kiujkiu/macha/models/zynq_board/20260708-174606.jpg

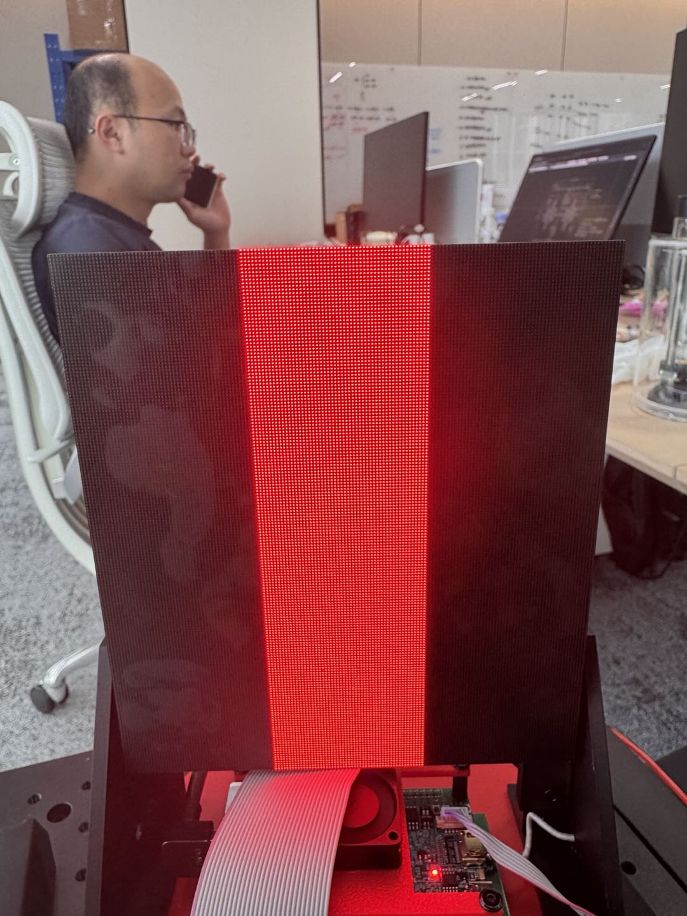
models/zynq_board/20260708-174606.jpg
