kiujkiu/macha/models/xt60_clamp_16p6x9p2x23p9/xt60_clamp_16p6x9p2x23p9_drawing.pdf

XT60 电源接头压块 xt60_clamp_16p6x9p2x23p9 (v4.10 压块 11 + 底板垫片 = 38×26.9×13 长方体, 止口四边, 中央出线 Φ2.5)

锁 XT60H-M (插合本体 15.6×8.2×11.9 在开口端 + 出线护套 16.6×9.2×12 在堵头端) 到 M6 网格板 · 外形 38×26.9×11 · 阶梯槽 15.6×8.7 / 16.6×9.2 · 件2 底板垫片 38×26.9×2 + 凸台 0.5 + 止口四边高 2 (总高 4)

主视图 Front (2.5:1) | 沿 +Y 看 (从开口端) | 尺寸单位: mm

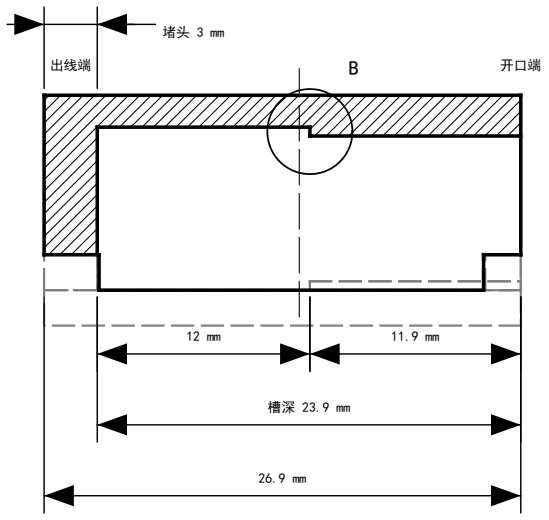
[picture p2: figure]
出线端; 开口端

11 mm

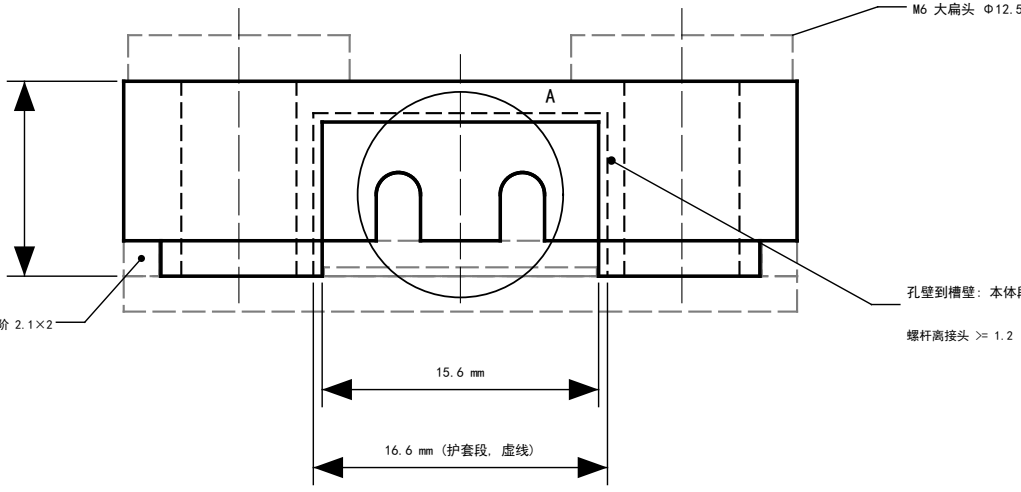
[picture p3: figure]
16.6 mm (护套段, 虚线); 螺杆离接头 >= 1.2

### M6 大扁头 Φ12.5×2.6 坐顶面 (灰线)

止口: 件 2 边框 2×2 (灰), 压块台阶 2.1×2

### 孔壁到槽壁: 本体段 1.45 / 护套段 0.95 (两侧)

# 左视图 (全剖) Section (2.5:1) 沿对称面 X=0 剖, 沿 +X 看

灰线: 件 2 底板垫片 (厚 2, 凸台 0.5, 止口高 2) + 插合本体 (开口侧) + 出线护套 (堵头侧)

槽顶 = 接头顶面 (过盈 0): 护套段 9.2 / 本体段 8.7 = 凸台 0.5 + 8.2, 均从底板顶面算 (见详图 B)

# 俯视图 Top (2.5:1) 沿 -Z 看

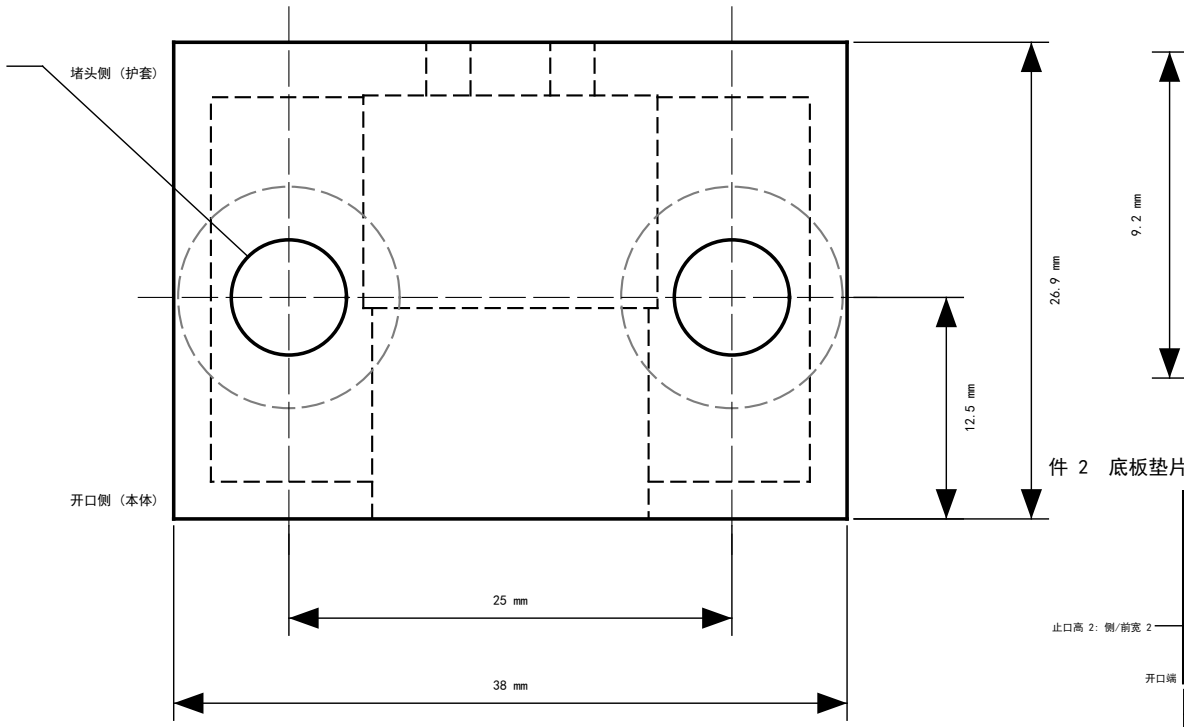
[picture p4: figure]
堵头侧 (护套); 开口侧 (本体); 止口高 2: 侧/前宽 2; 开口端

### 2×Φ6.5 通孔 (配 M6)

# 详图 A (5:1) 堵头 U 型出线口 (沿 +Y 看) 7 mm

5.85 mm

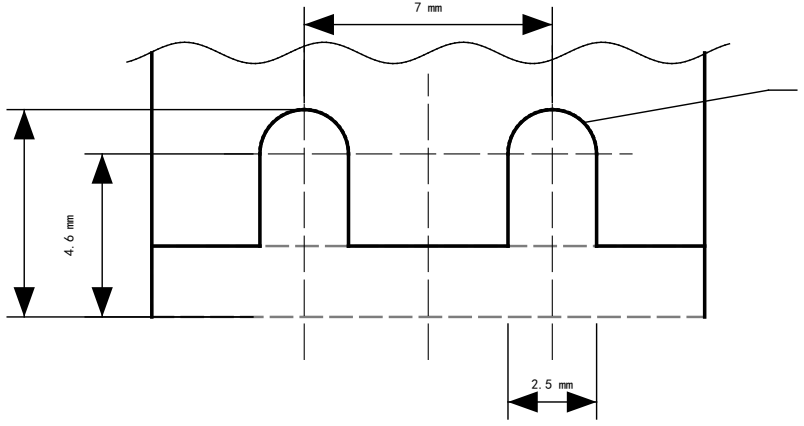
[picture p5: figure]

R1.25 (Φ2.5)

U 口 = 半圆顶 + 直边, 平底 = 件 2 后边框顶 z 2 (灰, 宽 3 高 2); 线底 3.35 高于边框, 不削

线 Φ2.5 零余量, 从护套尾孔沿针轴直出 (圆心 4.6 = 护套高/2)

# 详图 B (5:1) 槽台阶 Z 向堆叠

护套段

8.7 mm

槽顶=接头顶

过盈 0

本体段

凸台 0.5 (件 2)

# 件 2 底板垫片 (1:1) 底板 2 + 凸台 0.5 + 止口四边高 2

上方后边框 宽 3 高 2 (出线边)

38 mm

26.9 mm

凸台 15.4×11.9

2×Φ6.5 同压块孔

# 说明 / Notes

1) 尺寸: 宽 16.6 / 15.6 用户指定 (图纸 16.40), 高/长按 AMASS XT60H-M 图纸 + 卡尺。插合本体 15.6×8.2 长 11.9 在开口端; 出线护套 16.6×9.2 长 12 在堵头端 (本体上下各缩 0.5)。v4 纠正了 v3 前后装反。
2) 阶梯槽紧配不留余量 (用户要求): 本体段 15.6×8.7 / 护套段 16.6×9.2, 宽高都 = 接头 (间隙 0, 过盈 0), 槽台阶与接头台阶对齐。
3) 限位: 插入方向护套上部顶堵头、下部顶件 2 后边框; 拔出方向护套前端面顶窄槽台阶 (零窜动)。件 2 底板垫片 38×26.9×2 + 本体下凸台 0.5 + 止口四边高 2 (左右/开口端宽 2 开口端槽口断开, 后边宽 3; 压块台阶宽多 0.1); 两件嵌套面留 0.1; M6 定位。
4) 装配: 底板垫片放板上 -> 接头 (本体坐凸台, 护套坐底板顶住后边框) -> 压块扣下 (套进止口, 线落进 U 口) -> M6 穿压块+底板。叠层 13: M6×20 旋入 7 距板底 6; M6×25 旋入 12 距板底 1。
5) 孔壁到槽壁: 护套段 0.95 / 本体段 1.45 (两侧), 打印可能破口, 不影响夹紧; 螺杆离接头 >= 1.2。孔心距开口面 12.5。堵头 3 + 2 个 U 口 Φ2.5 @ 7, 圆心高 4.6。
6) 槽顶厚 护套段 1.8 / 本体段 2.3 (件高 11 用户指定)。打印: 压块顶面贴床零支撑; 实心 6.50 cm^3, PLA 约 8.1 g。底板垫片底面贴床零支撑。
7) 组合外形: 压块 + 底板垫片 = 38×26.9×13 长方体, 外表面只有 2×M6 孔、开口端接头口、堵头 2 个出线口 (压块 U 口, 平底 = 后边框顶 z 2); 止口、凸台都在内部, 边框顶贴台阶顶不留缝。
8) 层高 (零间隙对层高敏感): 两件都用 0.1 (全部整层) 或 0.25 (首层也 0.25, 本体段/护套段各松 0.05); 不要用 0.2 —— 本体段槽顶和凸台顶落在层中间, 本体段会过盈 0.2 扣不到底。
结构件 — XT60 电源接头压块 (XT60 Clamp v4.10, 组合 38×26.9×13 长方体, 零间隙, 中央出线, 止口四边) + 件 2 底板垫片 | 投影 1st-angle / 比例 2.5:1 (主, 左剖, 俯), 5:1 (详图 A, B), 1:1 (件 2)
38×26.9×11 / 阶梯槽 15.6×8.7 (开口) + 16.6×9.2 (堵头) / 堵头 3 + 2×U 口 / 2×Φ6.5 @ 25 / 底板垫片 38×26.9×2+凸台 0.5+止口四边 高 2 (后边宽 3) / M6×20 / PLA/PETG / mm | 2026-09-16 / pov3d / models / xt60_clamp_16p6x9p2x23p9 / *.stl (压块 + xt60_shim_38x26p9x2p5)
