kiujkiu/macha/models/photo_sensor/photo_sensor_bracket_drawing.pdf

# POV 3D photo_sensor — sensor_bracket (圆盘上平板, 外伸挂光电开关, PLA)

贴圆盘上表面, 锁(-92.5,±20)圆盘孔(2×M3通孔, 从上往下, 无沉孔) / 外伸段下面挂模块: 2×Φ3.2 直通 (顶沉取消 2026-07-14) + 3让位槽贯通 / 厚6 (5→6)

## 俯视 (3:1) (沿 -Z 看顶面) 尺寸单位: mm

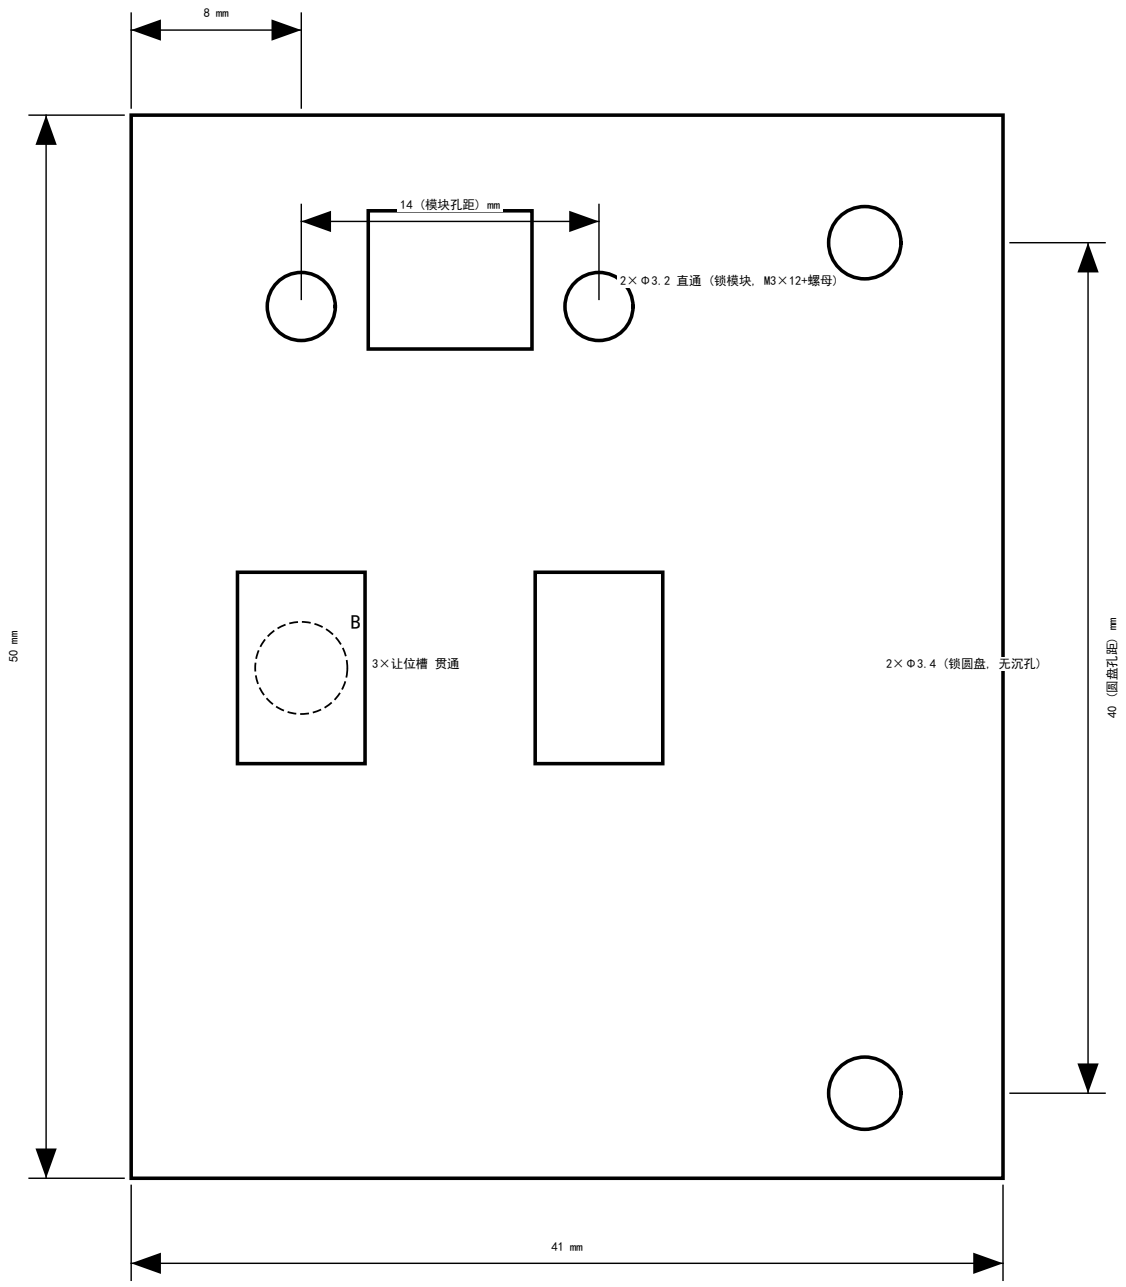
[picture p8: figure]
14 (模块孔距) mm; 40 (圆盘孔距) mm; 2×Φ3.2 直通 (锁模块, M3×12+螺母)

3×让位槽 贯通 | 2×Φ3.4 (锁圆盘, 无沉孔) | 侧视 (3:1) (沿 -Y 看, 厚6)

6 mm

全部孔为普通直通 (无沉孔); 3 让位槽贯通

## 详图 B (6:1) 让位槽 (贯通)

槽宽 mm

6 (贯通) mm

(贯通, 让焊脚)

POV 3D — photo_sensor / sensor_bracket (×1, 转子) | 投影 1st-angle / PLA / 单位 mm
平板 41×50×6 (5→6, 2026-07-14) 贴圆盘顶 / 2×Φ3.4锁圆盘 + 2×Φ3.2锁模块 (全部直通无沉孔) + 3让位槽贯通(详图B) / 外伸悬挑 | 2026-06-15 / POV3D / models / photo_sensor
