kiujkiu/macha/models/photo_sensor/photo_sensor_vane_v2_drawing.pdf

# POV 3D v2 — index_vane_v2 静止挡光片 (θ=180/-X, 洞洞板 中心锚定 25mm 网格)

脚 5厚 X-108..-92×Y±32, 2×Φ6.5 M6 @ 网格(-100,±25) 切向对 / 挡片 径向4 (X-100..-96=R98居中): 槽下宽10 到Z28, 槽内宽8 到Z39 / 梁(-98,0,37.7) / R_SLOT 112→98 (2026-07-07 缩半径) / 基准=旋转轴+洞洞板面 / 全平面孔无详图 (GB 1st-angle, 3:1, mm)

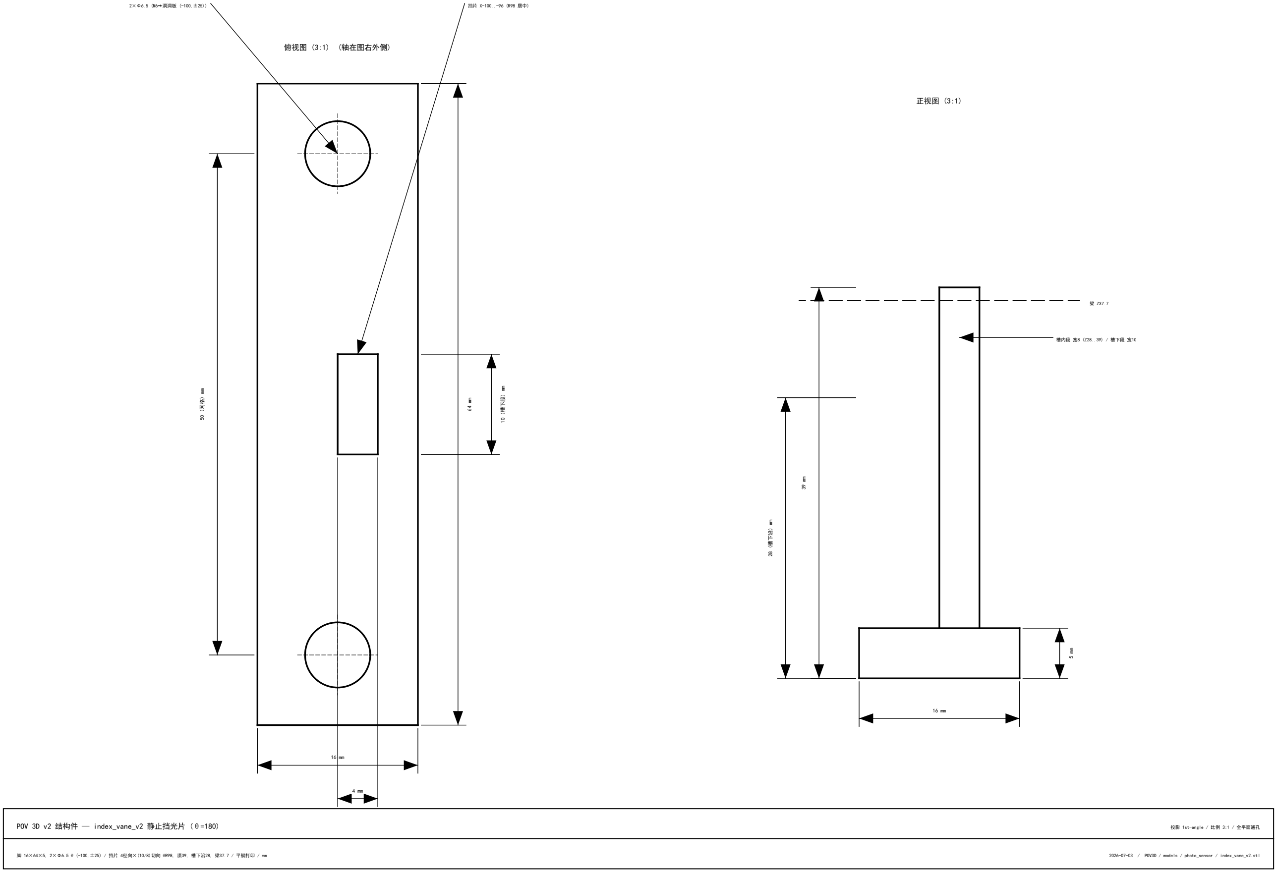
[picture p9: figure]
俯视图 (3:1) (轴在图右外侧); 10 (槽下段) mm; 2×Φ6.5 (M6→洞洞板 (-100,±25)); 正视图 (3:1); 28 (槽下沿) mm; 槽内段 宽8 (Z28..39) / 槽下段 宽10

POV 3D v2 结构件 — index_vane_v2 静止挡光片 (θ=180) | 投影 1st-angle / 比例 3:1 / 全平面通孔
脚 16×64×5, 2×Φ6.5 @ (-100,±25) / 挡片 4径向×(10/8)切向 @R98, 顶39, 槽下沿28, 梁37.7 / 平躺打印 / mm | 2026-07-03 / POV3D / models / photo_sensor / index_vane_v2.stl
