kiujkiu/macha/models/mlkpai_h_bracket/mlkpai_h_bracket_drawing.pdf

# POV 3D — 米联派 MLKPAI-FS03 ZYNQ 板 H 形支架 (左右开槽, t=3)

对位板 85×56: 4×M3 角孔(矩形 79×50) / 中心 Φ24+24方阵 4×M3 居中(0,0) / 两侧凹槽 25×44 缺口开左右 / 板厚 3 (GB 1st-angle, 2:1, mm)

## 俯视图 Top (2:1) (沿 -Z 看)

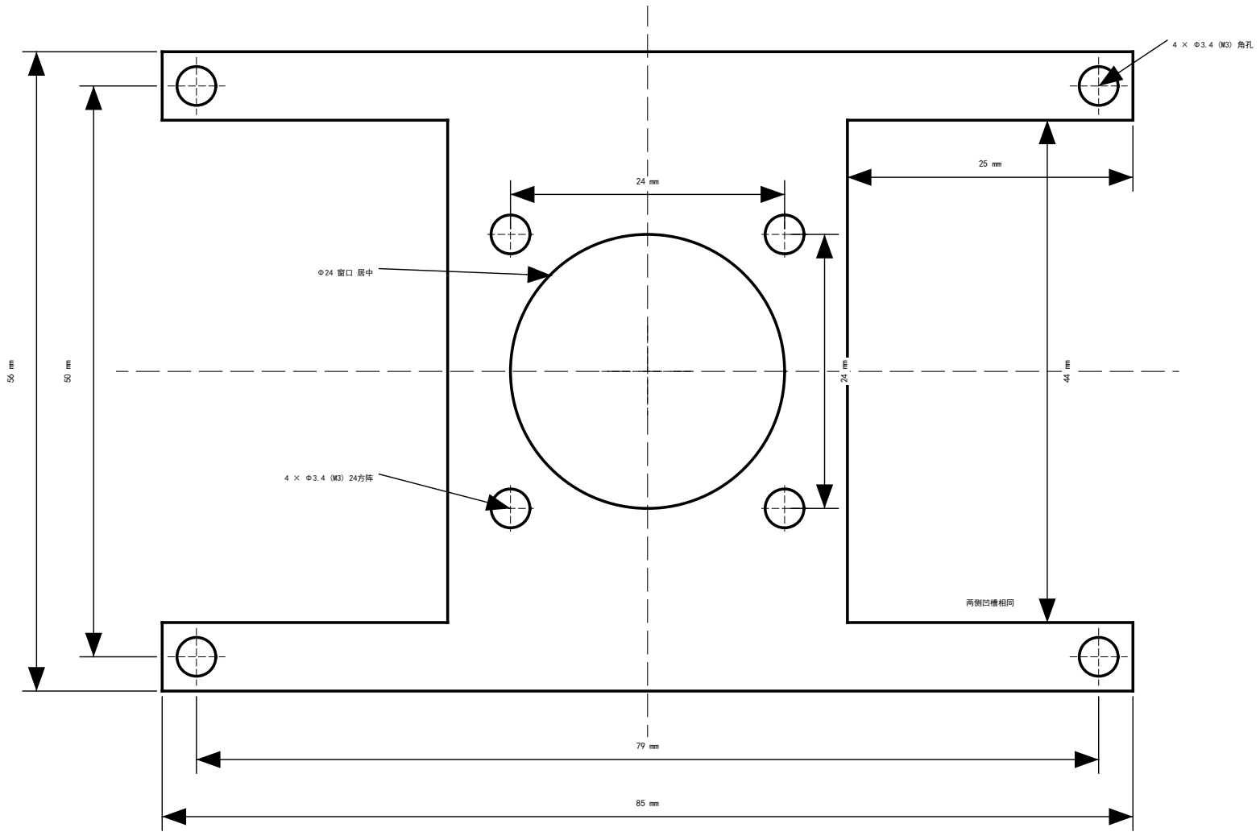
[picture p10: figure]
两侧凹槽相同

缺口开左右 / 上下横梁各 6mm,角孔壁较薄(~1.3mm) / 中心 5 孔居中(芯片实际+3.7)

## 右视图 Side (2:1) (板厚)

3 mm

56 mm

板厚 3 (虚线=各通孔)

POV 3D 结构件 — MLKPAI-FS03 ZYNQ H 形支架 (左右开槽, t3) | 投影 1st-angle / 比例 2:1 (俯, 右)
外形 85×56×3 / 4×M3 角孔(79×50 估算) / Φ24+24方阵 4×M3 居中 / mm | 2026-06-23 / POV3D / models / mlkpai_h_bracket
