kiujkiu/macha/models/saddle_clamp_sq6/saddle_clamp_sq6_drawing.pdf

# POV 3D 马鞍压条 / 抱箍 Saddle Clamp (方形过桥, 夹持 6×6)

内腔 6×6 方 / 料厚 3 / 压条宽 14 / 外形 37×14×9 / 2×Φ6.5 M6 通孔 (孔距 25) / 物体贴板,顶部方形压住,两脚 M6 固定 (GB 1st-angle, 4:1, mm)

主视图 Front (4:1) | (沿 +Y 看, 物体轴线方向)
左视图 Side (4:1) | (沿 +X 看)

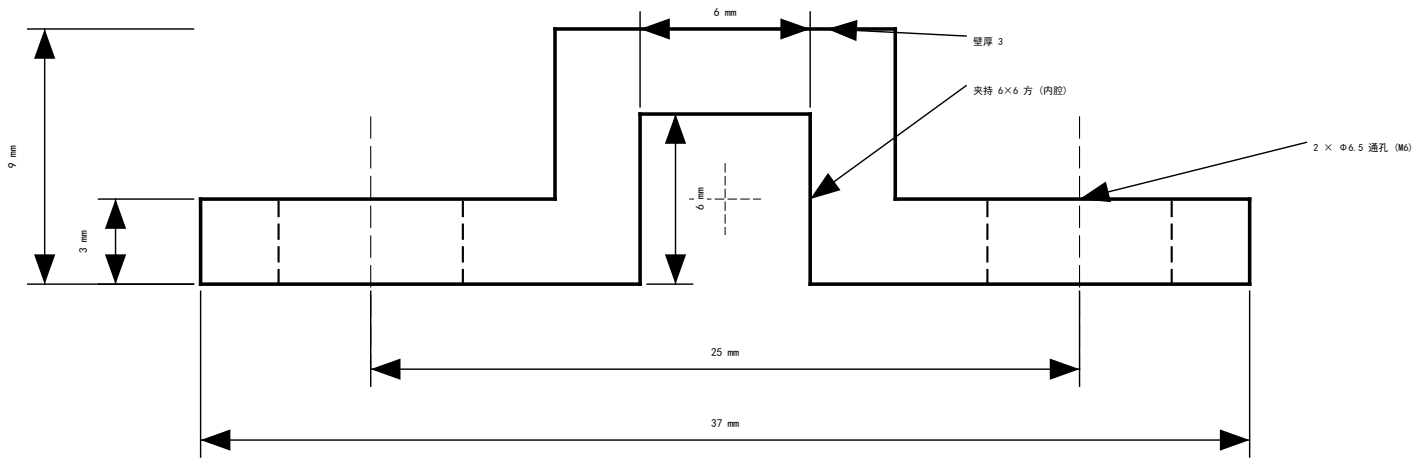
[picture p11: figure]

14 | mm

9 mm

6 mm

物体 6×6 沿 Y 穿过 (虚线)

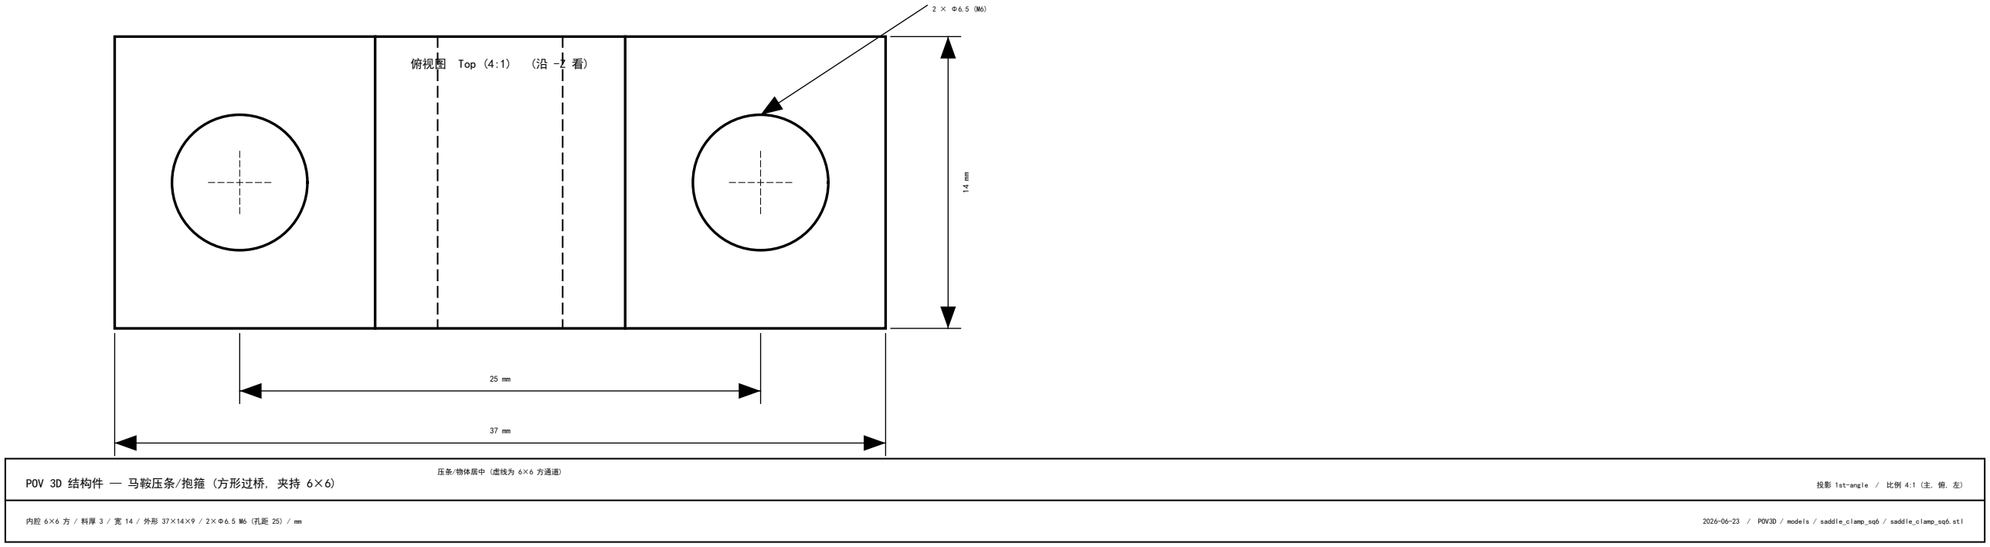
[picture p12: figure]
俯视图 Top (4:1); 压条/物体居中 (虚线为 6×6 方通道)

POV 3D 结构件 — 马鞍压条/抱箍 (方形过桥, 夹持 6×6) | 投影 1st-angle / 比例 4:1 (主, 俯, 左)
内腔 6×6 方 / 料厚 3 / 宽 14 / 外形 37×14×9 / 2×Φ6.5 M6 (孔距 25) / mm | 2026-06-23 / POV3D / models / saddle_clamp_sq6 / saddle_clamp_sq6.stl
