kiujkiu/macha/models/box_22x24x64/box_22x24x64_drawing.pdf

# POV 3D 盒子 Box 22×24×64 (单侧开口 +X, 前面板开窗)

外形 22×24×64 / +X 侧(64×24) 敞开 / 前(-Y)1·后(+Y)2·侧(-X)2·顶底2 / 前面板中央开穿窗口 14(宽X)×35(高Z) / 前后各 2×Φ4.5 M4 (中心距 44) (GB 1st-angle, 2:1, mm)

## 主视图 Front (2:1) (沿 +Y 看 -Y 1mm 前面板)

## 左视图 — 全剖 A—A (2:1) (沿 +X 看, 即开口方向)

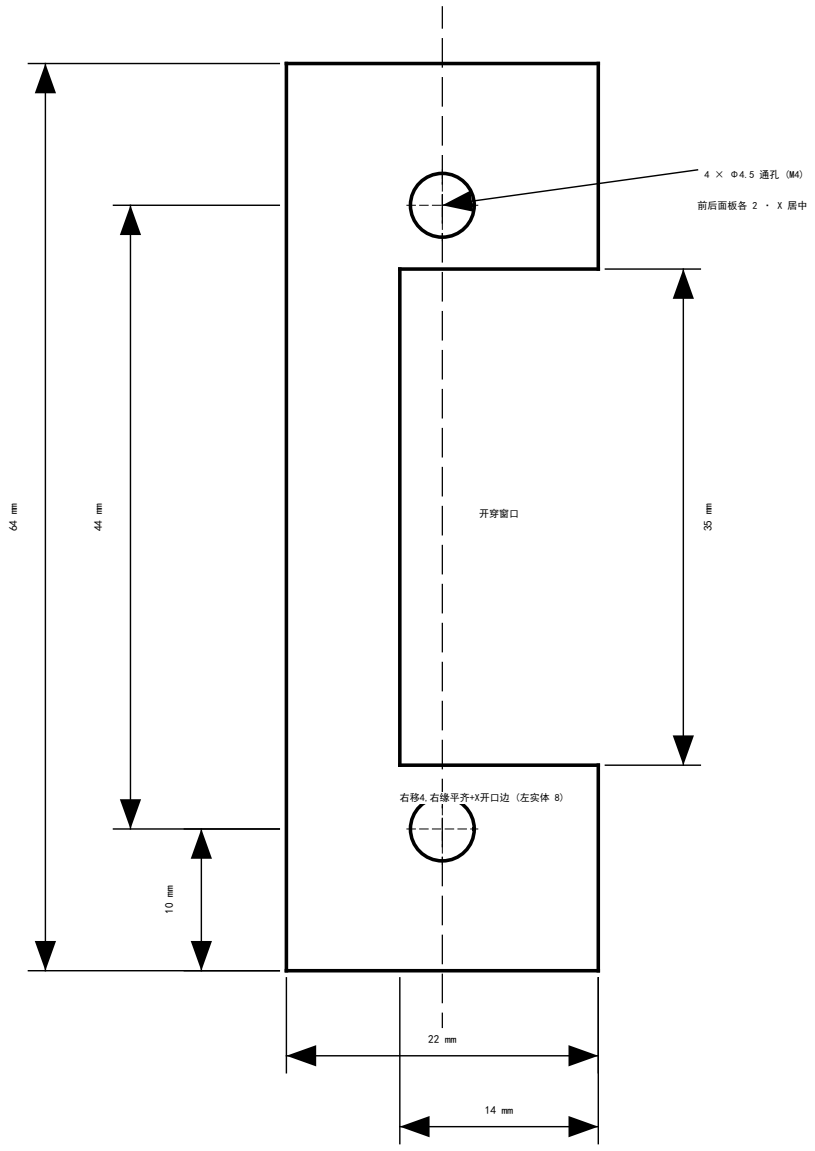
[picture p13: figure]
前后面板各 2 · X 居中; 开穿窗口; 右移4,右缘平齐+X开口边 (左实体 8)
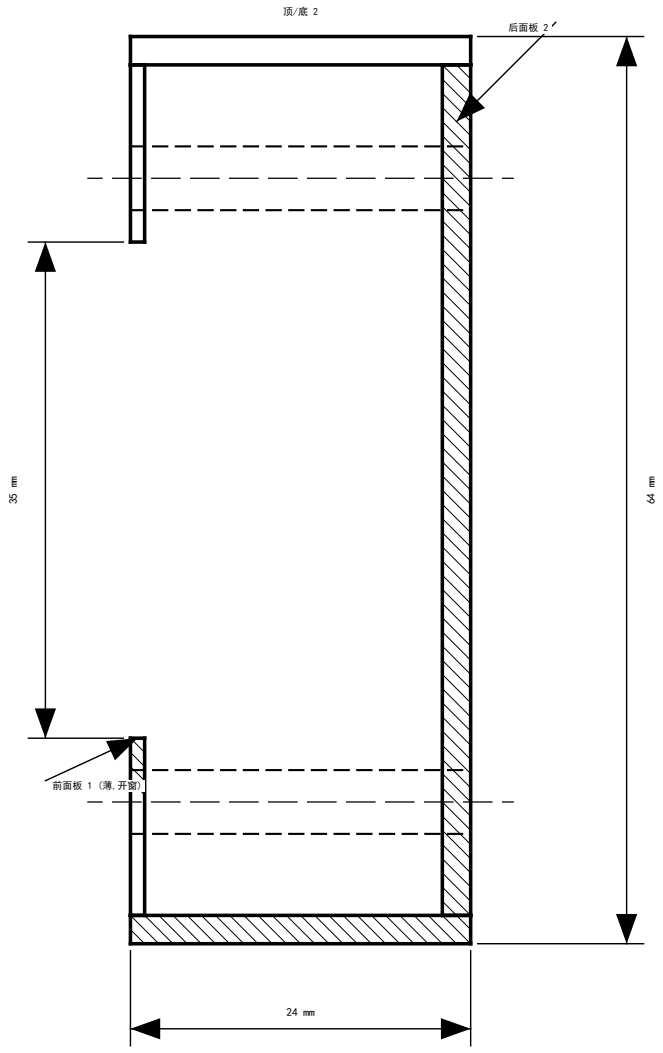
[picture p14: figure]
前面板 1 (薄,开窗); 后面板 2

窗口 35 高 · 2×M4 @ Z=10/54 (孔在窗上下)

## 横剖 B—B (2:1) (沿 -Z 看 @ Z=32)

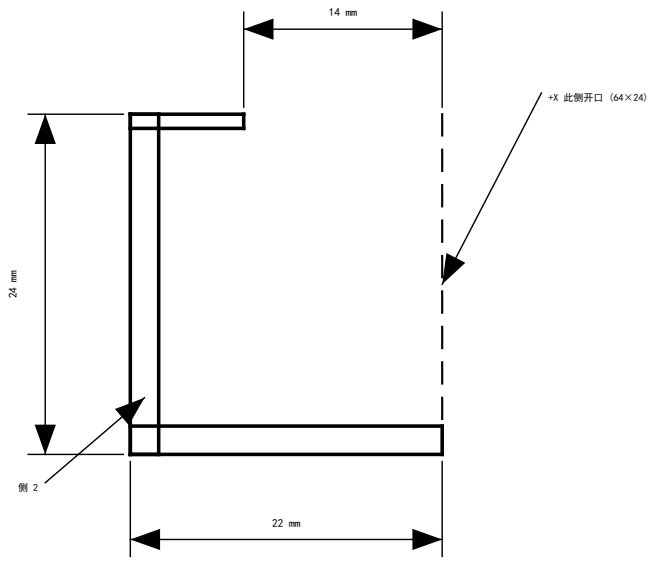
[picture p15: figure]
+X 此侧开口 (64×24)

前(上)1·后(下)2·侧2 / 窗宽 14

POV 3D 结构件 — 单侧开口盒 (Box 22×24×64, 开窗前板) | 投影 1st-angle / 比例 2:1 (主, 左-全剖, 横剖)
外形 22×24×64 / +X侧开 / 前1·后2·侧2·顶底2 / 窗 14×35 / 4×Φ4.5 M4 (中心距44) / mm | 2026-06-22 / POV3D / models / box_22x24x64 / box_22x24x64.stl
