kiujkiu/macha/models/l_bracket_170x60/l_bracket_170x60_drawing.pdf

# POV 3D L 形托架 L-Bracket (200×70, W90, T4)

长边 200 / 短边 70 / 宽 90 / 板厚 4 / 6 × Φ3.2 M3 (下排 X+1 Y+1) / 4 × Φ3.2 M3 立板 (对 rim 内圈R35+外圈R77.5 @ 157.5°/202.5°,距圆心14.3) / 2 × 13×30 开口 (距左边10,中距45) / 3 × 三角加强筋 (两边+中间,各厚5) (GB 第一角投影)

## 俯视图 Top View (1:1) 尺寸单位: mm (沿 -Z 看)

注: M3 下排 X+1, Y+1 偏移

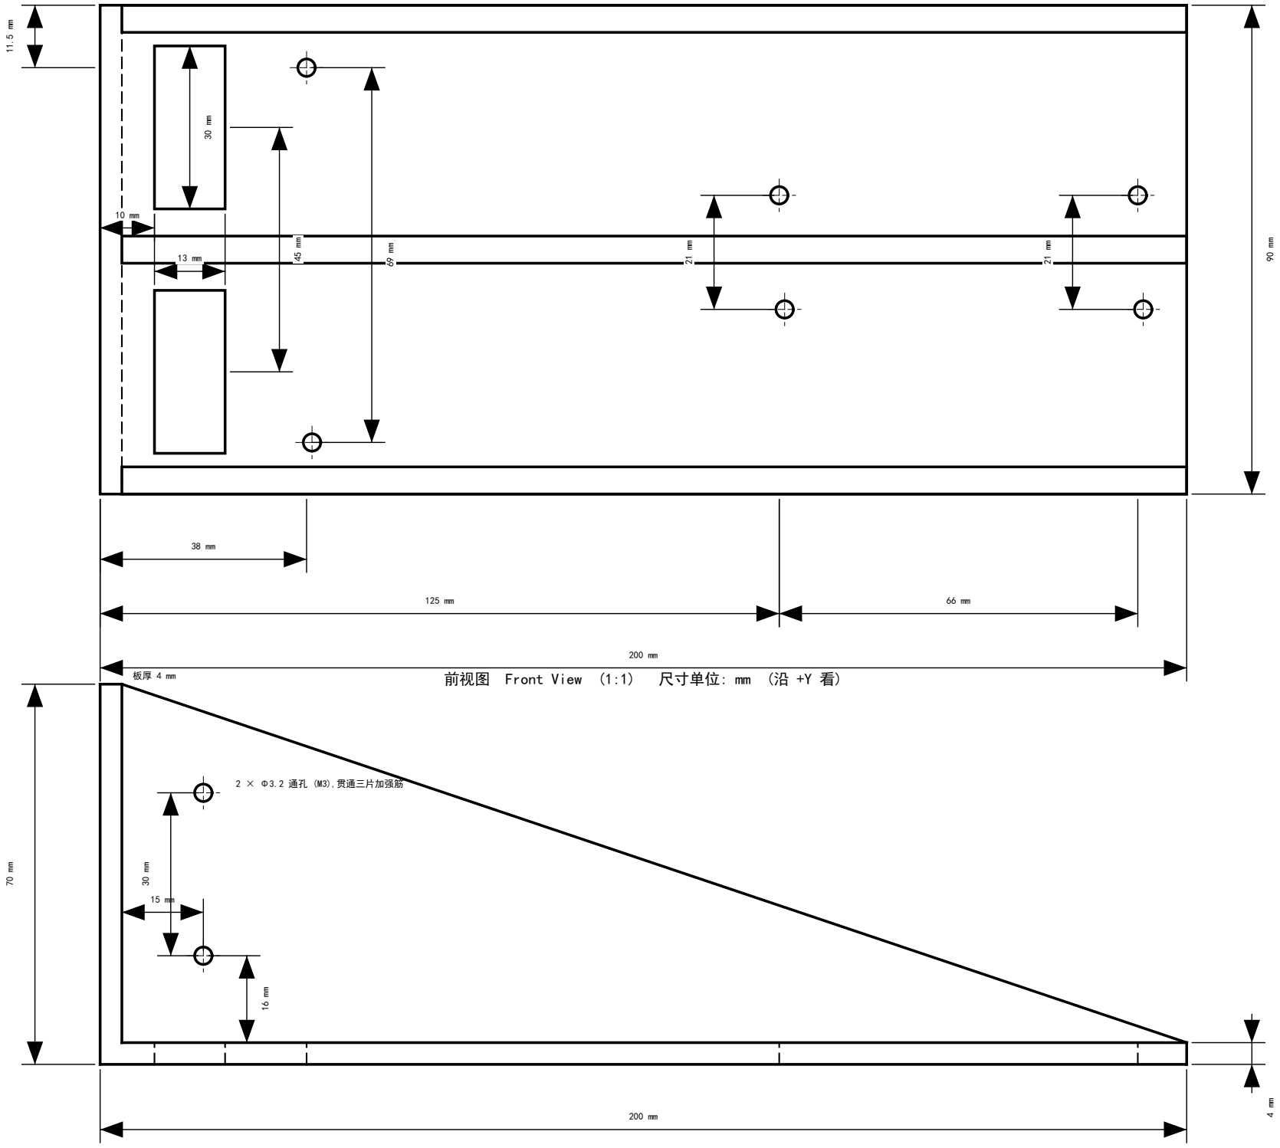
[picture p16: figure]
前视图 Front View (1:1); 尺寸单位: mm (沿 +Y 看); 2 × Φ3.2 通孔 (M3),贯通三片加强筋
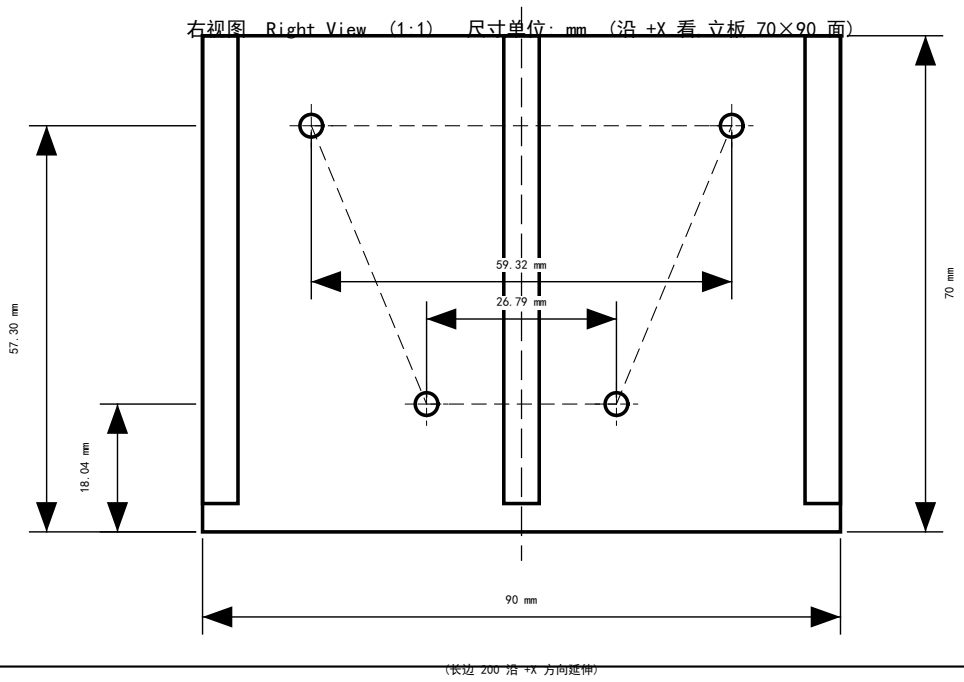
[picture p17: figure]
(长边 200 沿 +X 方向延伸)

## 右视图 Right View (1:1) 尺寸单位: mm (沿 +X 看,立板 70×90 面)

4 × Φ3.2 通孔 (M3),对位 rim 内外圈 ±22.5° (R=35 & 77.5) / Z_v=0 朝圆心,距圆心 14.3 mm

POV 3D 结构件 — L 形托架 (L-Bracket 170×60) | 投影 1st-angle / 比例 1:1 (前, 俯, 右)
长边 200 / 短边 70 / 宽 90 / 板厚 4 / 6 × Φ3.2 M3 通孔 (3 组,中线对称) / 单位 mm | 2026-06-09 / POV3D / models / l_bracket_170x60 / l_bracket_170x60.stl
