kiujkiu/macha/models/top_bearing/top_bearing_frame_drawing.pdf

# POV 3D top_bearing v3 — frame_A / frame_B (顶架, 锁 4 立柱顶, PLA)

臂 18×8 (宽=柱垫Φ18) + 筋 4×6 / 轴毂 Φ44 双层, 各嵌 1 × 688 (腔 Φ15.8×5 压入, 挡肩 Φ13), 4×Φ3.2@R14 / 柱垫 Φ18 @R194.5: 仅 Φ6.5 通孔, A 用 M6×16 / B 柱垫高16 用 M6×30

## frame_A 俯视 (1:1) 尺寸单位: mm

194.5 mm

158 (筋) mm

194.5 mm

双臂 90°, 柱垫对角放置 → 打印床 224×224 (X2D 256 内)

中心: 688 腔 Φ15.8(虚线,压入) + 挡肩 Φ13 / 4 × Φ3.2 @ R14

臂 18 宽 × 8 厚, 筋 4×6 (A 上 / B 下)

## 轴毂叠层剖面 (2:1) — 688 ×2 + Φ8 螺柱

8 mm

8 mm

5 mm

Φ15.8 mm

Φ13 mm

A 腔口朝上(688 #1, 403-408), B 腔口朝上(688 #2, 411-416)

Φ8×50 螺柱穿两轴承内圈 (368.4-418.4); 腔 Φ15.8 偏紧压入

## 柱垫剖面 (2:1, frame_A; B 柱高 16): 仅 Φ6.5 通孔

Φ18 mm

Φ6.5 mm

8 mm

M6 螺丝自上穿入拧进立柱顶 (A: M6×16, B: M6×30) — 锁死轴向

## 臂横截面 (2:1, frame_A; B 筋朝下)

18 mm

4 mm

8 mm

6 mm

POV 3D — top_bearing v3 / frame_A + frame_B (各 ×1) | 投影 1st-angle / PLA / 单位 mm
厚度: 臂/毂 8, 筋 6 (总高 A=14, B=16), 柱垫 A=8/B=16 仅Φ6.5通孔 / BOM: 688×2, M6×16 ×2 + M6×30 ×2, M3×20+螺母 ×4 / A 正打, B 反打 | 2026-06-12 / POV3D / models / top_bearing
