kiujkiu/macha/models/baseplate/baseplate_drawing.pdf

# POV 3D 底盘 Baseplate

100×100×5 / 4×M6 角孔 / 4×M3 中心孔 + Φ7 沉孔 / 中央 Φ12×1 沉孔(顶) / 凸台 Φ65/55 H23 / 槽口 75°–105° H8

## 俯视图 Top View (1:1) 尺寸单位: mm

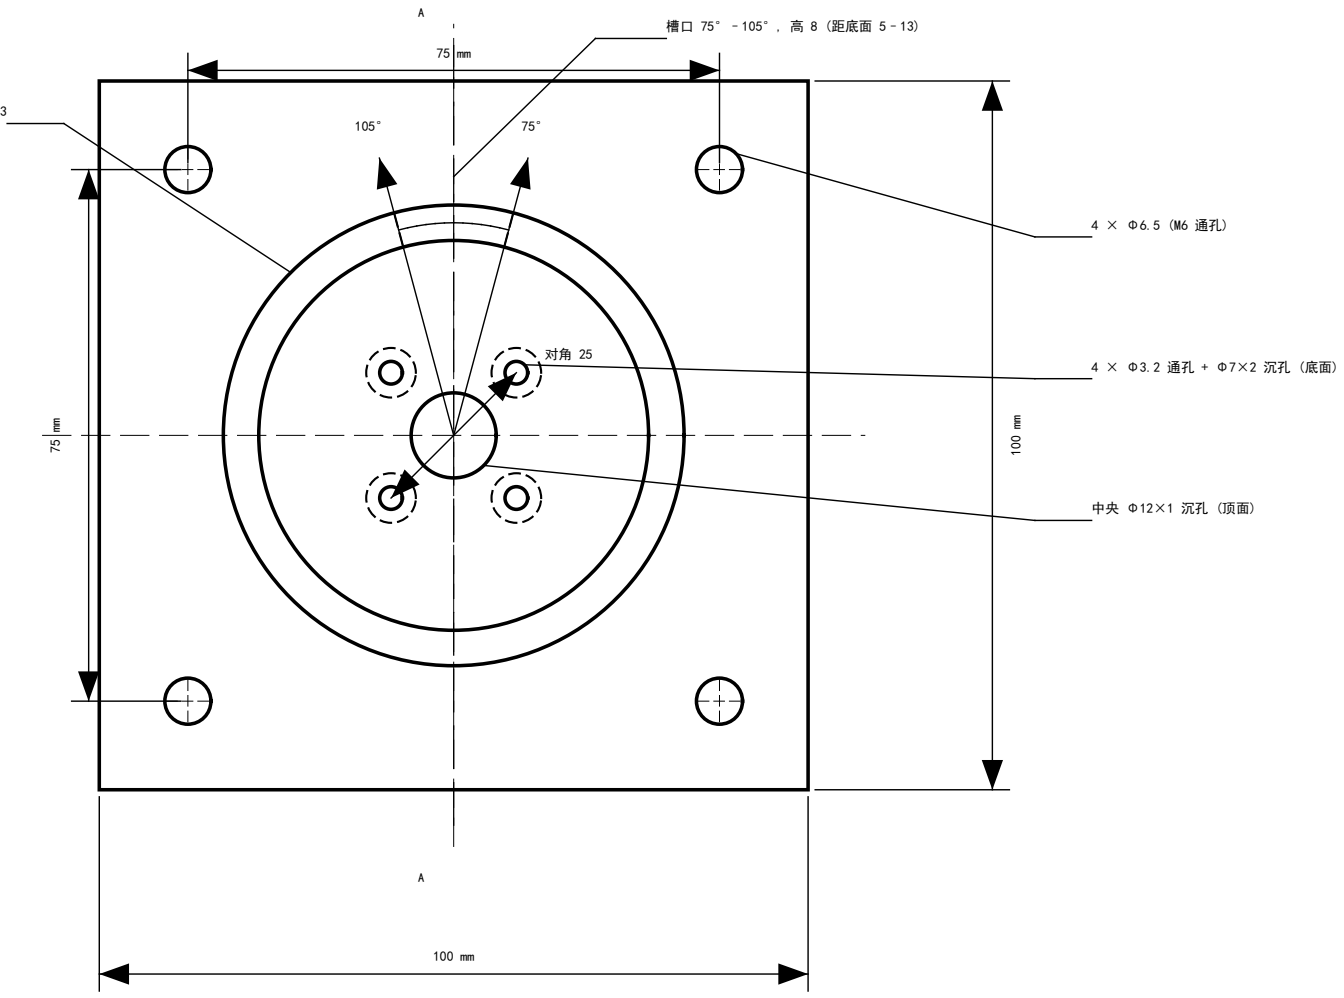
[picture p18: figure]
槽口 75°–105°, 高 8 (距底面 5–13)

凸台 Φ65 / Φ55, 高 23

## 剖视图 Section A-A (1:1) 尺寸单位: mm

(沿 +Y 方向剖切, 过槽口中分线 / cut along +Y axis through notch bisector)

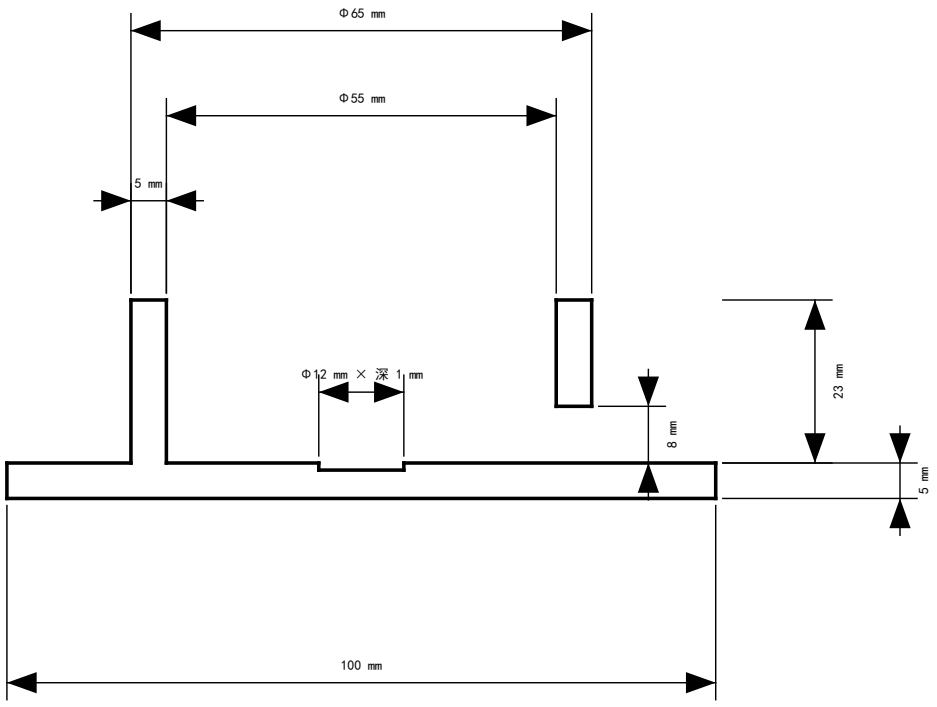
[picture p19: figure]

## 详图 B Detail B (3:1) 尺寸单位: mm

5 mm

2 mm

Φ7 mm

Φ3.2 mm

POV 3D 结构件 — 底盘 (Baseplate) | 投影 1st-angle / 比例 1:1 (俯, 剖)
100×100×5 / 4×M6 / 4×M3+Φ7×2 沉孔 / 中央 Φ12×1 沉孔(顶) / 凸台 Φ65/Φ55 H23 / 槽口 75°–105° H8 / 单位 mm | 2026-06-04 / POV3D / models / baseplate / baseplate.stl
