kiujkiu/macha/models/pcb_tray/pcb_tray_drawing.pdf

# POV 3D PCB 测试治具 PCB Test Jig (T200)

71.5×59.4×5 治具 / 底板 3 + 4 角块墙 18方 × 2高 / 上/下指坑沿 PCB 外形 内偏 2 深 2 (宽 34) / 4 × Φ3.2 M3 固定通孔 / 33 × Φ1 探针通孔 (PCB M0.8 位)

## 俯视图 Top View (1:1) 尺寸单位: mm

底板厚 3 mm / 角块墙高 2 mm / PCB 间隙 +0.3 mm

4 × 角块墙 18 × 18 mm (仅 4 角固定 PCB)

上/下指坑沿 PCB 外形, 向 PCB 内偏 2, 宽 34

挖深 2 (从底板顶面向下), 保留底部 1 mm 底

4 × Φ3.2 M3 固定通孔 (距治具外缘 4 mm)

33 × Φ1 探针通孔 (XY 取自 PCB M0.8 孔位)

打印方向: 底面贴床, 打印高度 5 mm

## 剖视图 Section A-A (1:1) 尺寸单位: mm

(沿 +Y 轴剖切, 过上/下指坑 / cut along +Y axis through top/bottom scallops)

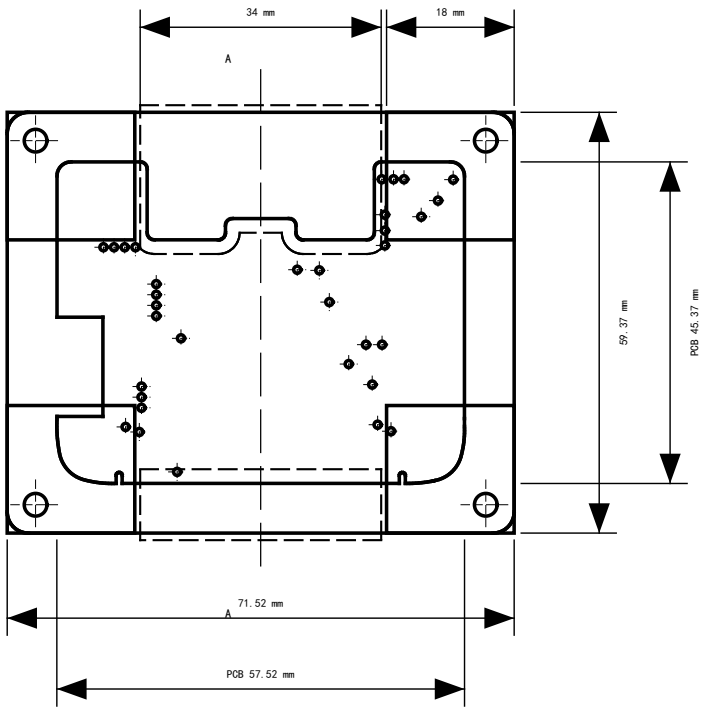
[picture p20: figure]
PCB 57.52 mm; PCB 45.37 mm

PCB (1.6)
5 mm

3 mm

2 mm

下指坑 -2 | 上指坑 | -2

59.37 mm

PCB 45.37 mm

POV 3D 结构件 — PCB 测试治具 (PCB Test Jig) | 投影 1st-angle / 比例 1:1 (俯, 剖)
治具 71.5×59.4×5 / 底板 3 + 4 角块墙 18×2 / 上下指坑 34 宽 × 2 深 / 4 × Φ3.2 M3 固定 / 33 × Φ1 探针孔 / 单位 mm | 2026-06-09 / POV3D / models / pcb_tray / pcb_tray.stl
