kiujkiu/macha/models/ring_collar/ring_collar_drawing.pdf

# POV 3D 环形件 Ring Collar

Φ80 / Φ65 / 高 13 / 槽口 0°–30° H6 (距底面 0–6)

## 俯视图 Top View (1:1) 尺寸单位: mm

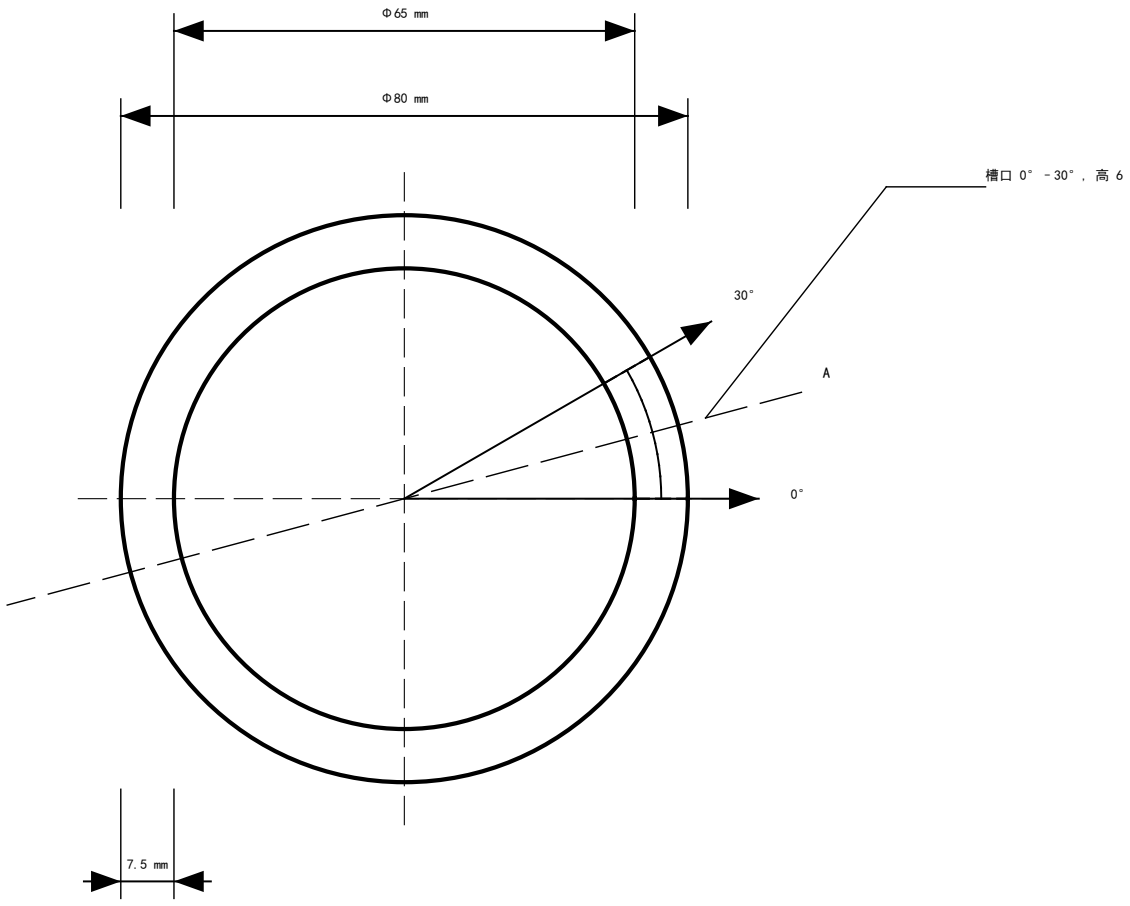
[picture p21: figure]
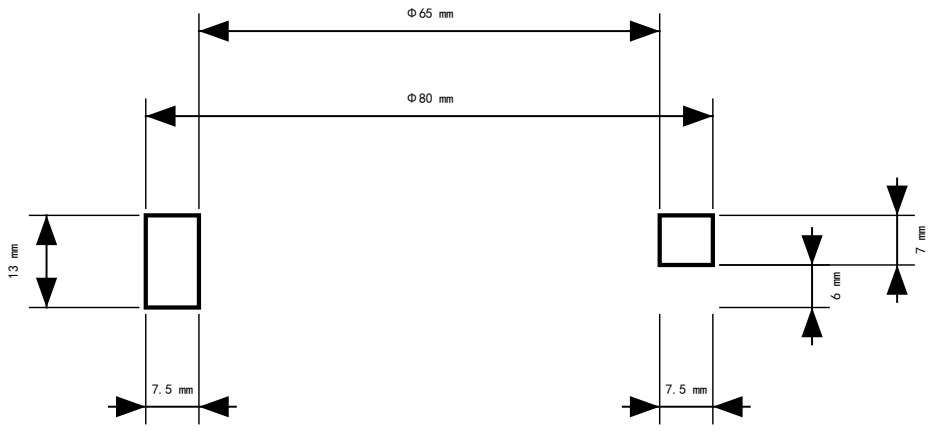
[picture p22: figure]

A

## 剖视图 Section A-A (1:1) 尺寸单位: mm

(沿 15° 方向剖切, 过槽口中分线 / cut along 15° through notch bisector)

POV 3D 结构件 — 环形件 (Ring Collar) | 投影 1st-angle / 比例 1:1 (俯, 剖)
Φ80 (外) / Φ65 (内) / 高 13 / 壁厚 7.5 / 槽口 0°–30° H6 / 单位 mm | 2026-06-05 / POV3D / models / ring_collar / ring_collar.stl
