kiujkiu/macha/models/photo_sensor/photo_sensor_vane_drawing.pdf

# POV 3D photo_sensor — index_vane (固定遮挡片, 锁洞洞板 M6, PLA)

底板锁洞洞板 (2×Φ6.5 @25中心距) / 叶片: 窄径向4 × 长切向(槽内8/底10), 升到高40 横穿光束Z38.7(配合支架抬高)

## 俯视 (4:1) (沿 -Z 看) 尺寸单位: mm

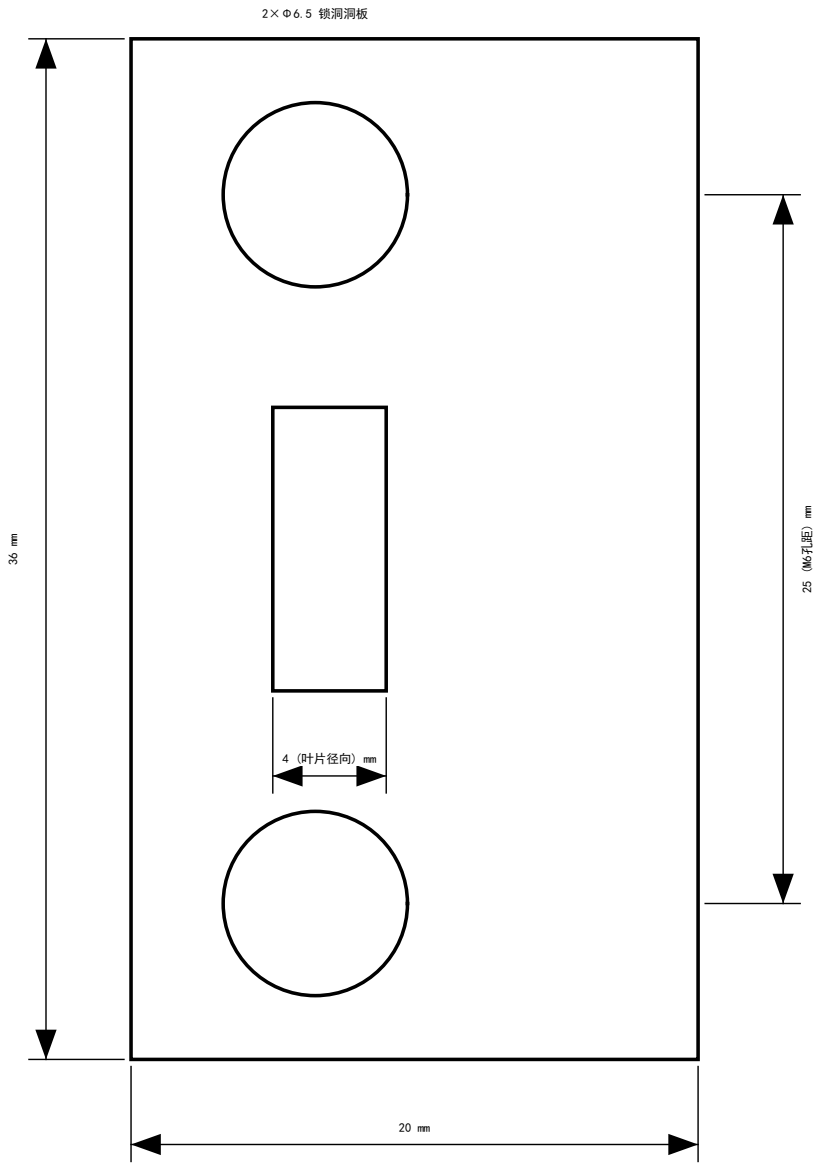
[picture p30: figure]
4 (叶片径向) mm; 2×Φ6.5 锁洞洞板
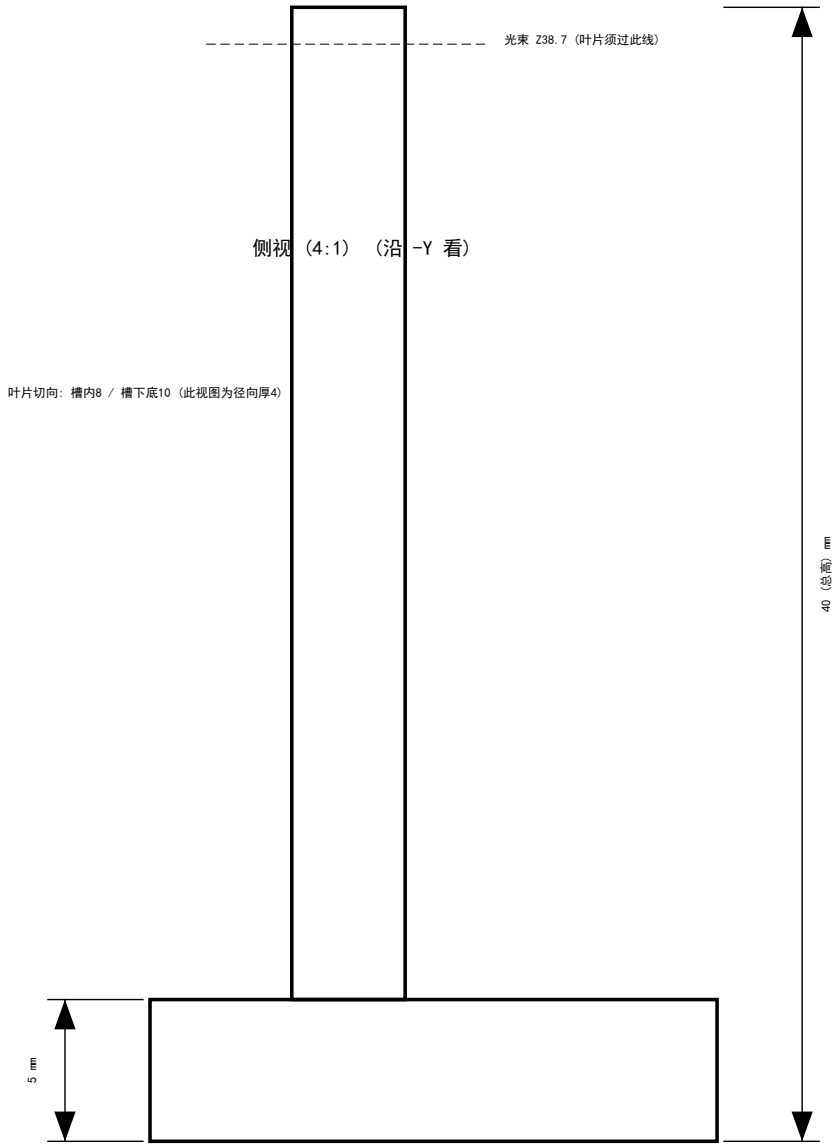
[picture p31: figure]
光束 Z38.7 (叶片须过此线); 叶片切向: 槽内8 / 槽下底10 (此视图为径向厚4)

注: 孔均为 Φ6.5 通孔, 无沉孔/特殊非通孔, 无需放大详图

POV 3D — photo_sensor / index_vane (×1, 固定) | 投影 1st-angle / PLA / 单位 mm
底板 20×36×5 (2×Φ6.5@25锁洞洞板) + 叶片 径向4×切向8~10, 高40 过光束Z38.7 / R112 @θ180 | 2026-06-15 / POV3D / models / photo_sensor
