kiujkiu/macha/models/zynq_board/20260617190246196.pdf

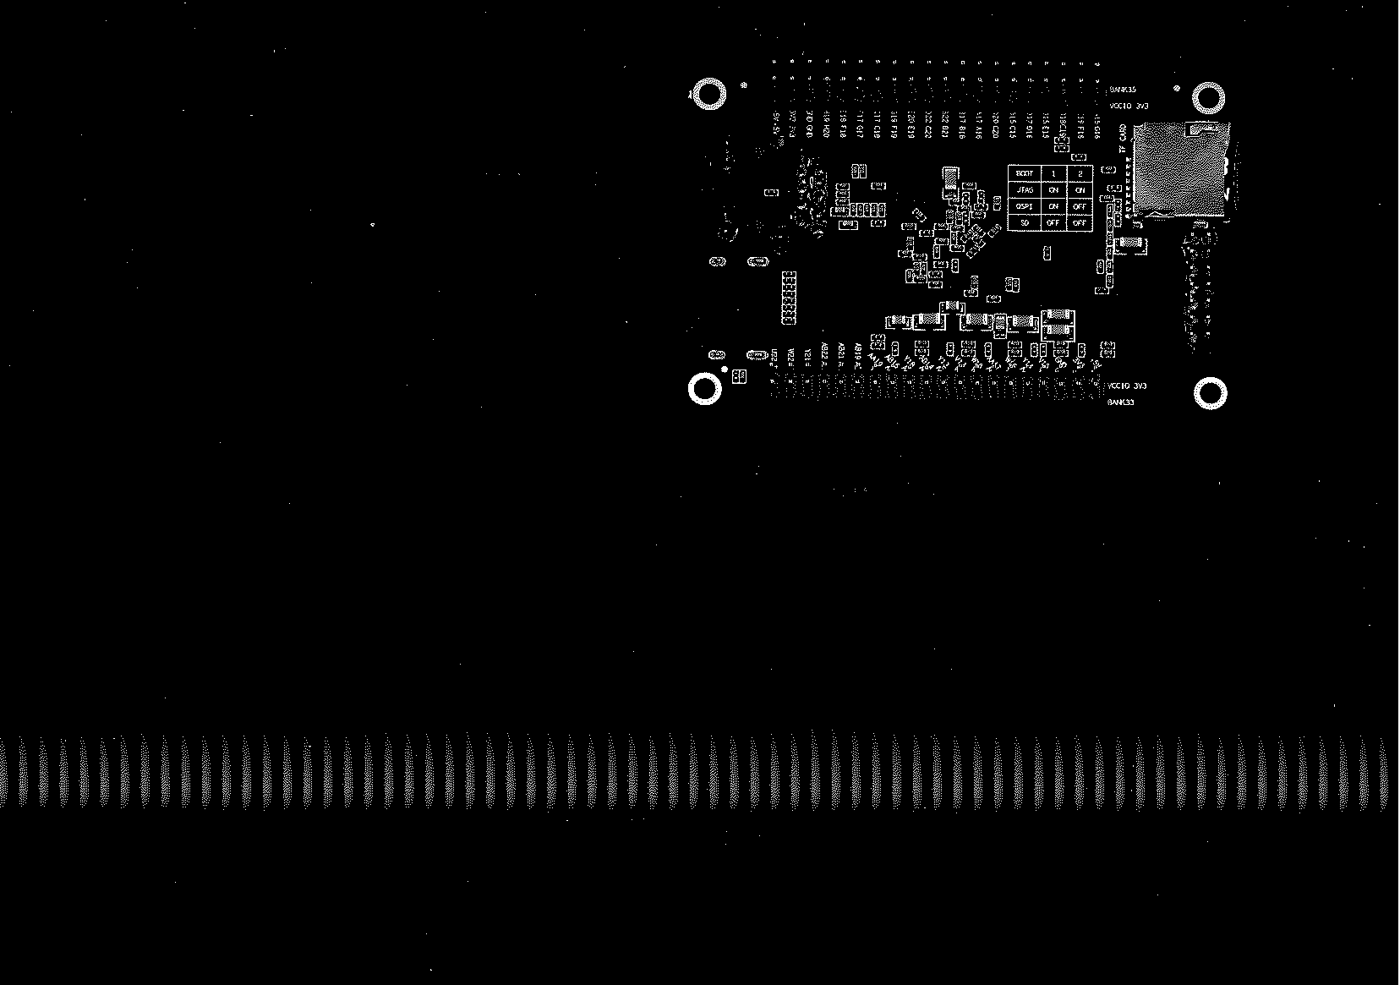
[picture p32: page 1]
