kiujkiu/macha/v0.4/balance/README.md

# V0.4 带屏动平衡 (2026-11-09 ~ 11-10)

偏心屏 (+X 6.7), 地面 + 胶垫 (胶垫拆不掉)。目标 900 rpm 稳定运行。

## 当前配重 (= v04_pc1 / v04_hs_900 状态, 最佳)

**上平面 `top_cap_v4`** (顶盖零件系, 翼在 −X):
| 孔 | 角度 | 配重 |
|---|---|---|
| 翼中孔 (−55, 0) | 180° | M6 叠 9.1 g (原 12.1 g, 拆了一片 3.0 g 垫片) |
| 翼 (−55, −14), 靠光电开关侧 | 194° | M3 + 2×m3_bush_v4 + 螺母, 4.0 g |
| 条端 (−11, +56), 远离光电开关、靠翼一排最外 | 101° | 同上, 4.0 g |

**下平面 `counterweight_fan_v4`** (扇形块被翻装 = 打印面朝上; 翼下贴了双面胶):
| 内圈 r64 孔 (从 A 端 / C 端数) | 角度 | 配重 |
|---|---|---|
| A 端第 1 | 104° | 1.3 g (M3+螺母) |
| A 端第 2/3/4 | 112/120/128° | 三组共 5.2 g |
| C 端第 3 | 240° | 1.3 g |

孔位俯视图: `fan_map_top.py` → `fan_map_top*.png` (屏幕角 = 零件角 + 90°, A 左 B 下 C 右, 同用户切片截图)。

## 结果 (900 rpm)

| 状态 | 底部 IMU ax/ay/az (mg) | 顶部手机 ax/ay (m/s²) |
|---|---|---|
| 扇形块 + 12.1 g, 未细配 | 11.5 / 11.1 / 8.1 | — |
| 只按底部配好 (n9L2) | 1.5 / 0.8 / 3.5 | 1.73 / 1.68 (手机上去后测) |
| **现状** (手机在顶) | 8.6 / 7.8 / 1.6 | **0.49 / 0.38** |

升速 (现状, 手机在顶, v04_hs_*): 1100 rpm 底 19.5/18.6/3.8 mg, 顶 0.97/1.00 m/s², 增长近 ω², 无尖峰。
顶部敲击模态 ~20~21 Hz (≈1200 rpm), 1200 未测。

## 工具

- `sweep_v04.py` — 调 mtr `hss_bal.py` 跑一档/扫速, 运行时替换限速 (不改原文件); 门限; `--step 600` 两段起转 (避开 ~714 rpm 偶发 HFI 发散)。
- `phone_v04.py` — phyphox 远程访问 (http://10.10.21.228) 顶部加速度; `run` / `tap` / `amp`。手机锁屏或退后台就连不上, 测前 curl 检查。
- `phone_sweep.py` — 底 + 顶同时升速扫, 顶 3 m/s² / 底 30 mg / 顶跳 2.5× 门限。
- `tap_v04.py` — 电机不转, 底部 IMU 录敲击。`soak_win.py` — 长跑按 30 s 窗算 1×。
- 解算借 `v1.0/balance/solve_four_run.py` 的 `fit` (只用振幅的四次法)。
- 数据: `mtr/APL+LDR_V1.1/tools/_cap/hss/bal/v04_*` (手机 `*_phone.csv`)。

## 未完 / 注意

- 下平面第三轮 (同时看底+顶) 只做了 ① 144° → 底 15.0/12.8, 顶 .56/.47, 已拆回。
- 5 min 长跑 ax/ay 有 ~+0.6 mg 热漂, 3 min 后趋平 (贴胶前后都有)。
- 固件 98f95bf (CRC 0x7063, 本次用 J-Link 烧): 升速一口气到 900 时在 ~714 rpm 偶发 HFI 发散 (故障 0x20 / 码 3), 3/14 次; 两段起转后未再出现。待电机窗口查。
- 手机还绑在顶上; 最终结果要拆手机后再测一次底部。
