kiujkiu/macha/models/baseplate/_dup_arrow_zoom.png

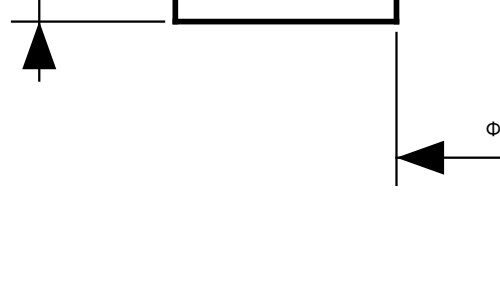
models/baseplate/_dup_arrow_zoom.png
