kiujkiu/macha/models/baseplate/baseplate_drawing_preview.png

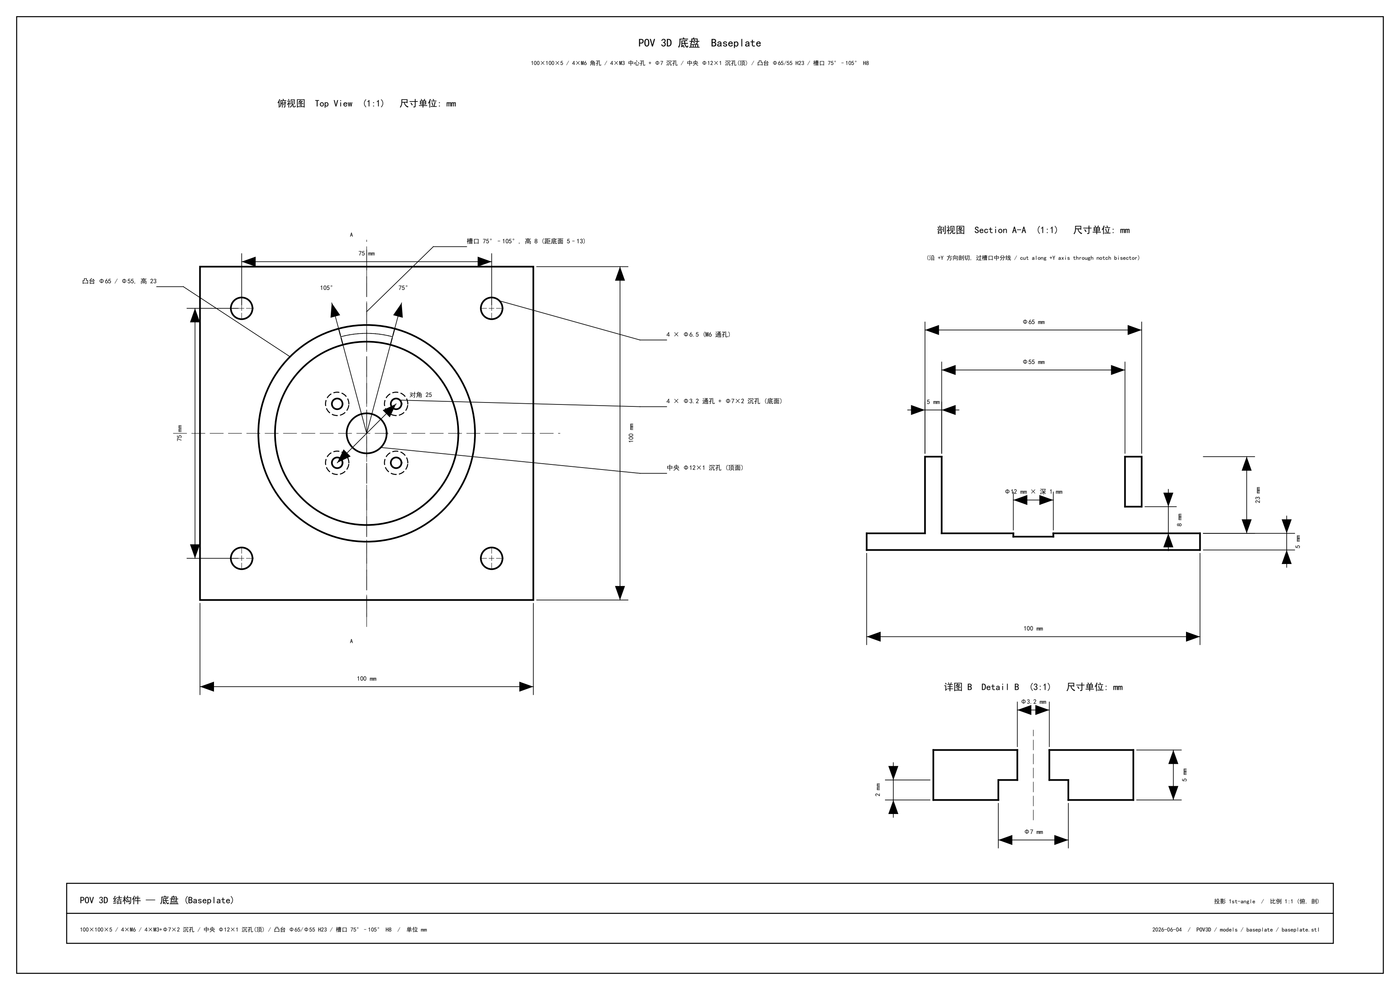
models/baseplate/baseplate_drawing_preview.png
