kiujkiu/macha/models/baseplate_collar_d100/baseplate_collar_d100_drawing_preview.png

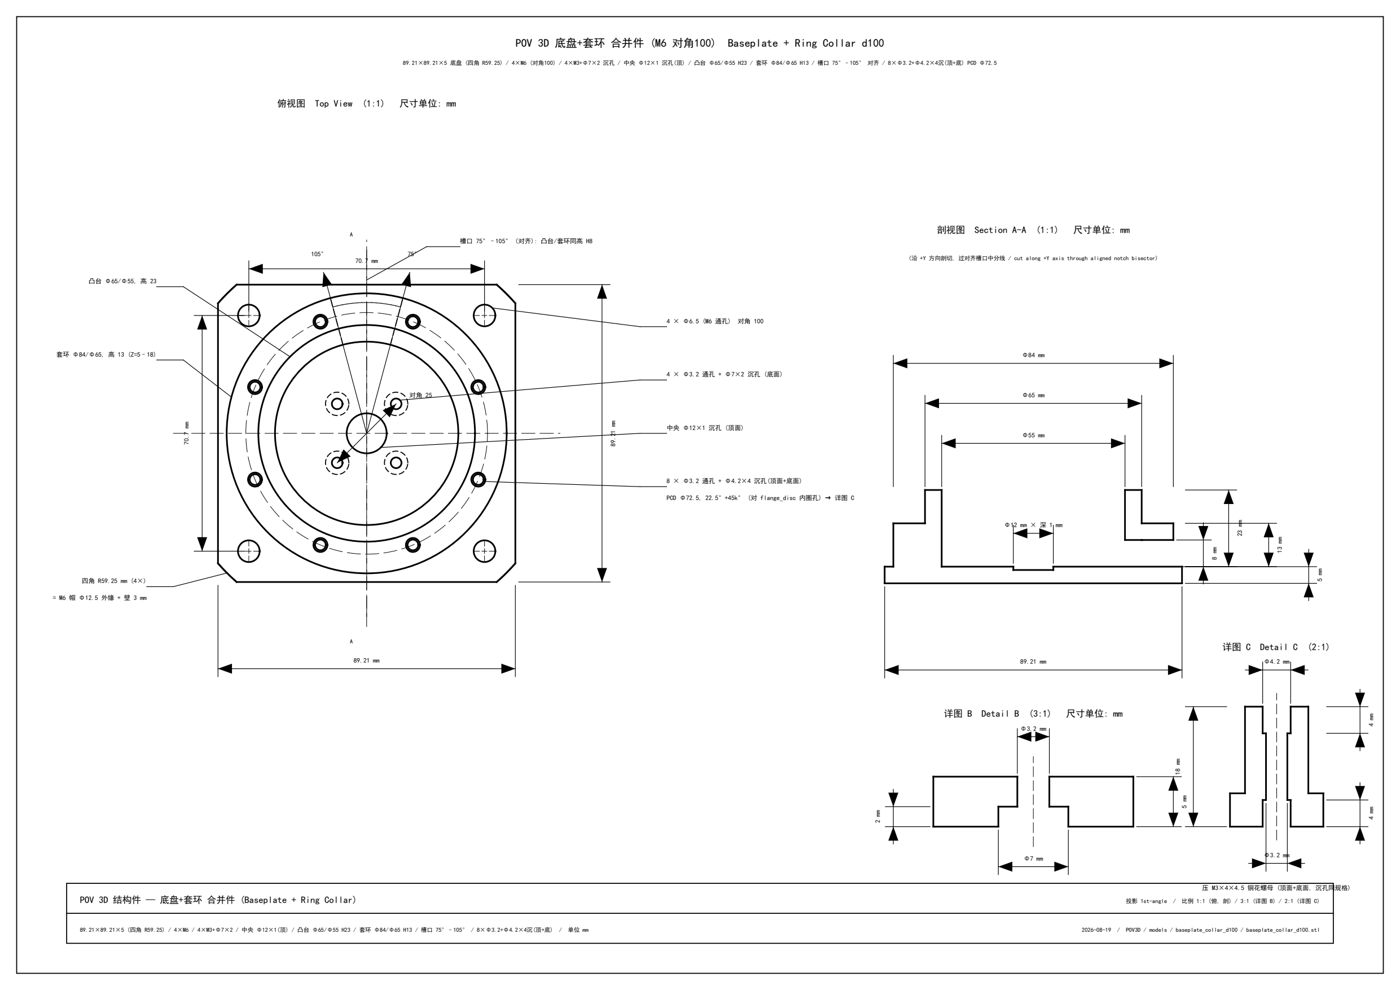
models/baseplate_collar_d100/baseplate_collar_d100_drawing_preview.png
