kiujkiu/macha/models/box_22x24x64/box_22x24x64_drawing_preview.png

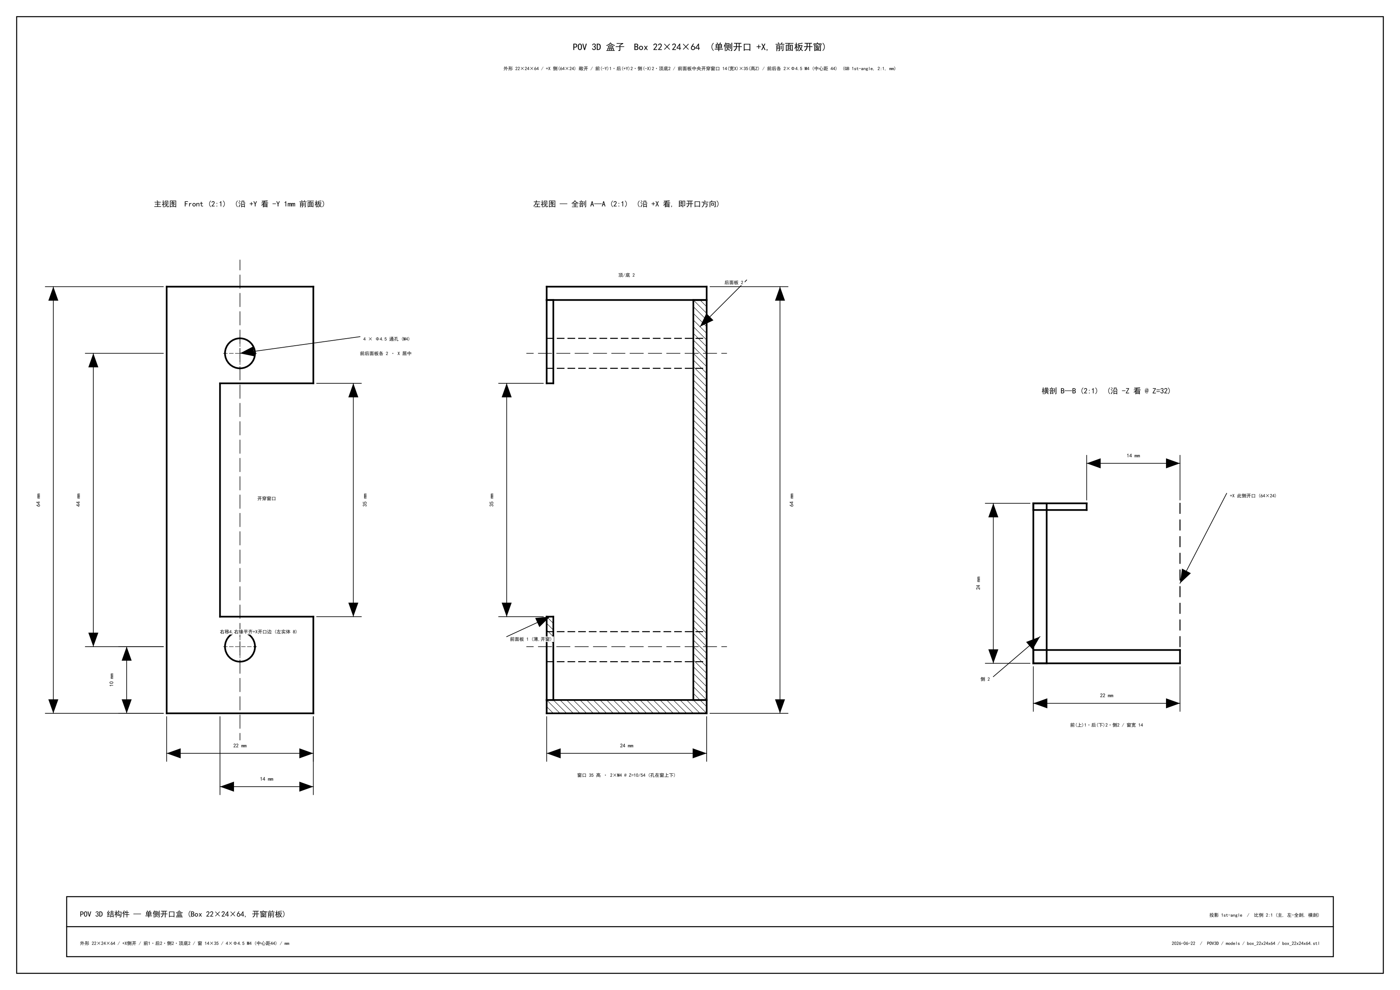
models/box_22x24x64/box_22x24x64_drawing_preview.png
