kiujkiu/macha/models/counterweight_arm/counterweight_arm_drawing_preview.png

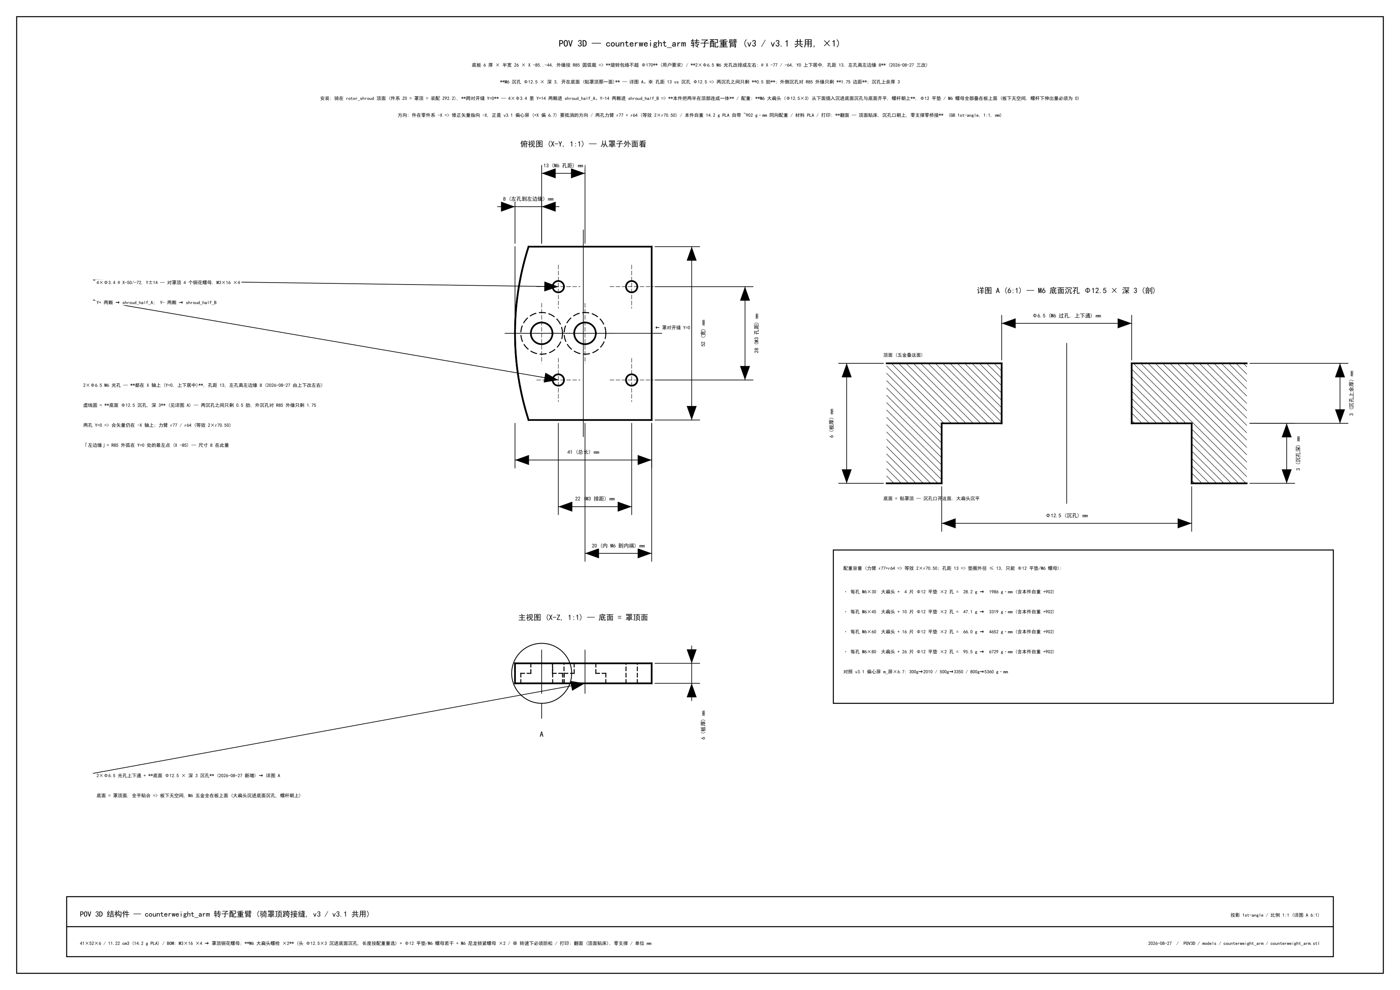
models/counterweight_arm/counterweight_arm_drawing_preview.png
