kiujkiu/macha/models/flange_disc/flange_disc_drawing_preview.png

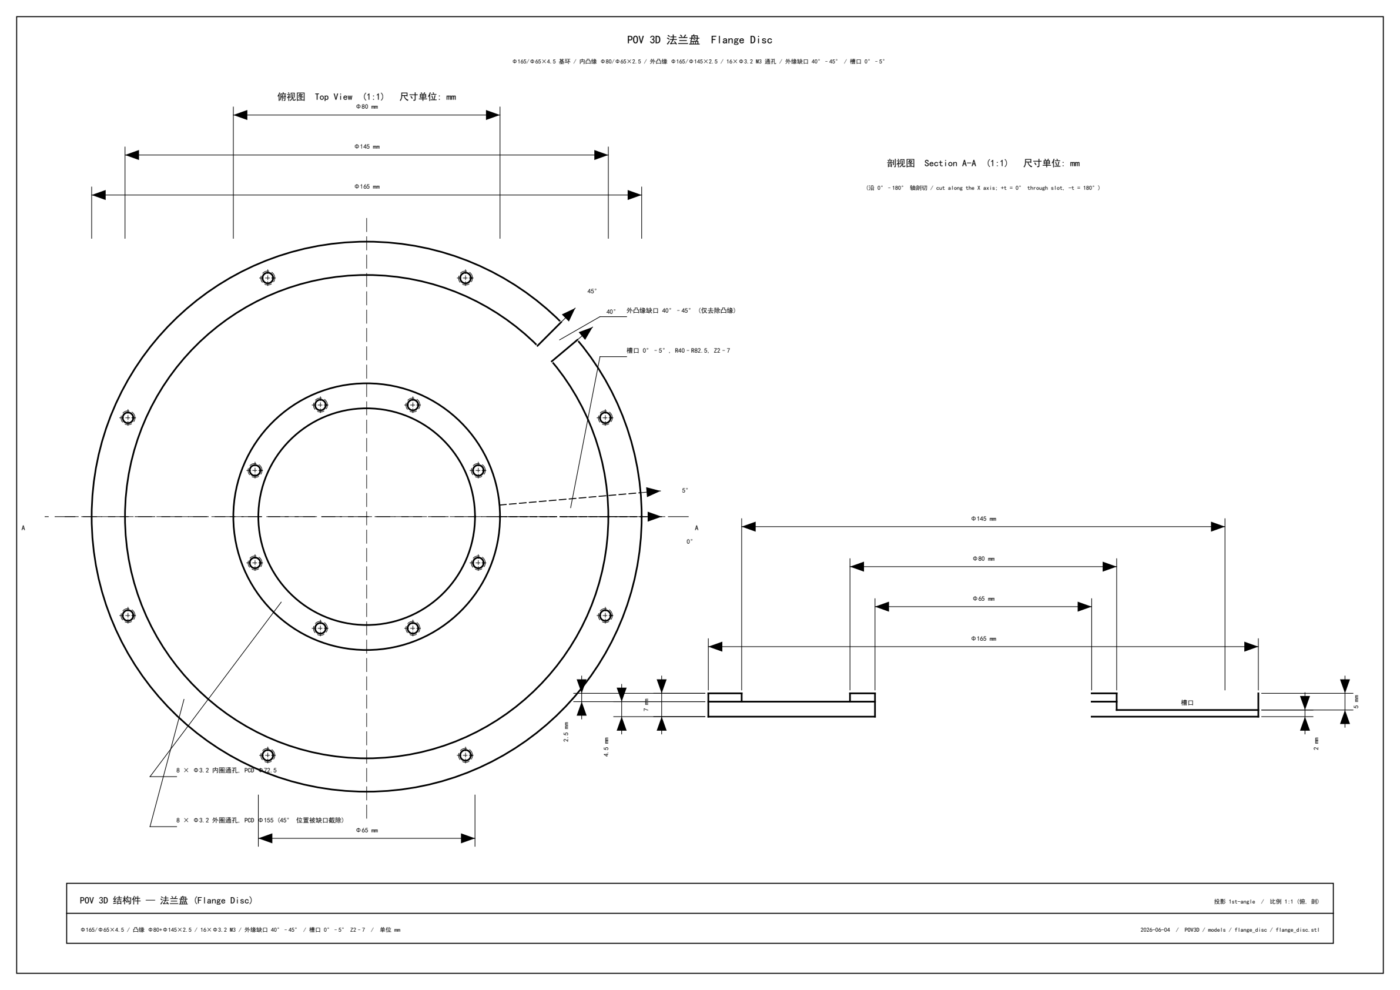
models/flange_disc/flange_disc_drawing_preview.png
