kiujkiu/macha/models/hub_disc/_topview_zoom.png

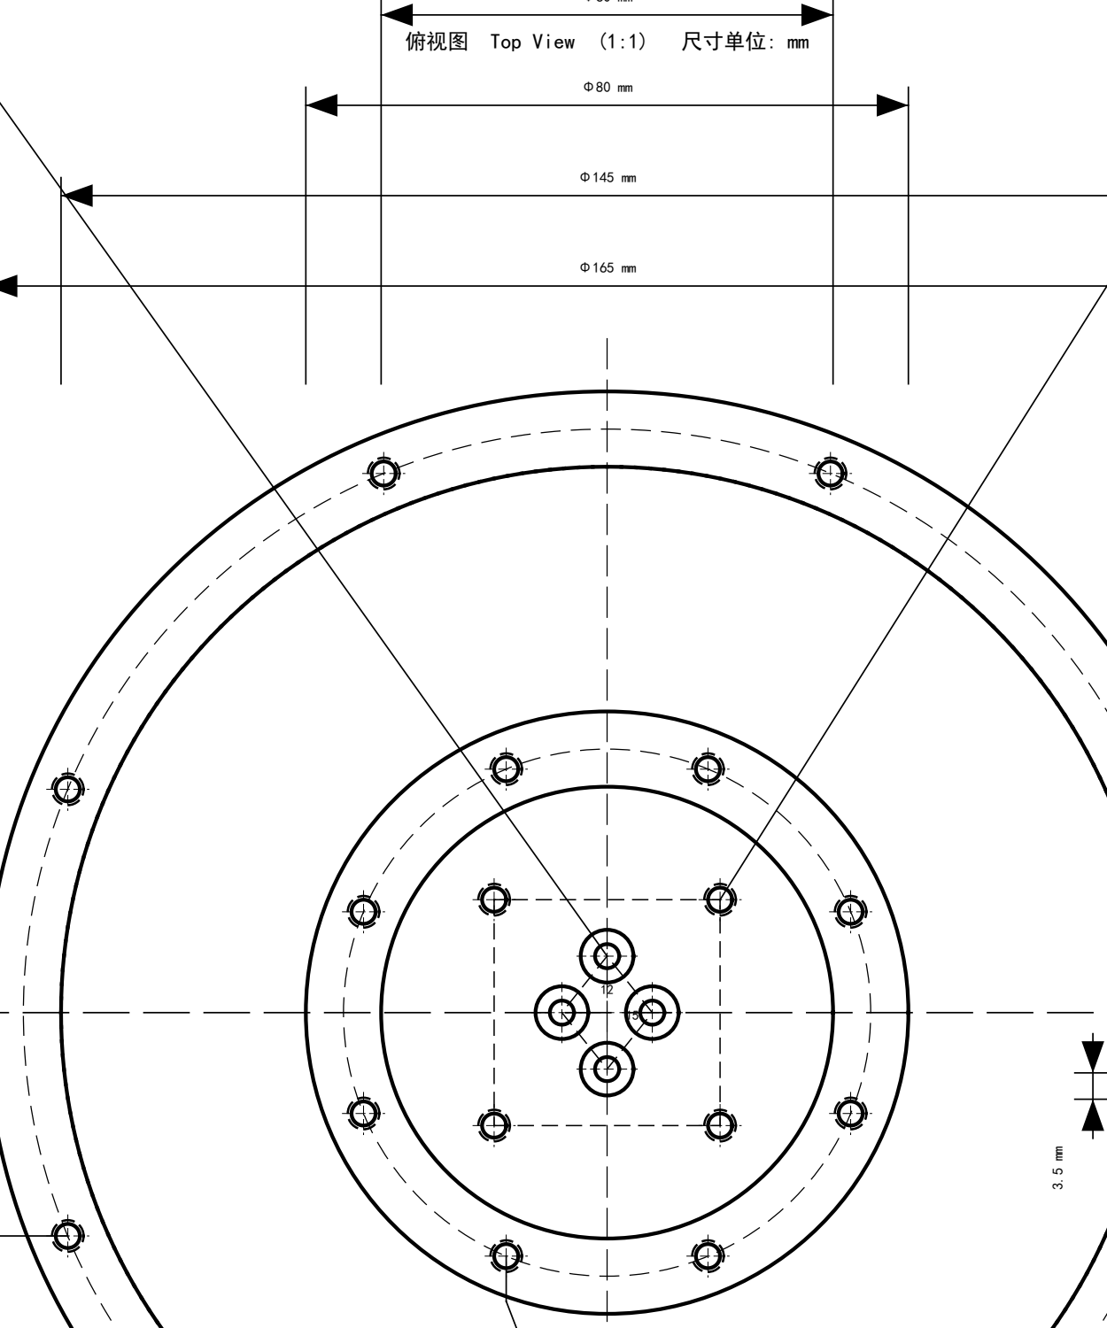
models/hub_disc/_topview_zoom.png
