kiujkiu/macha/models/hub_disc/_zoom_section.png

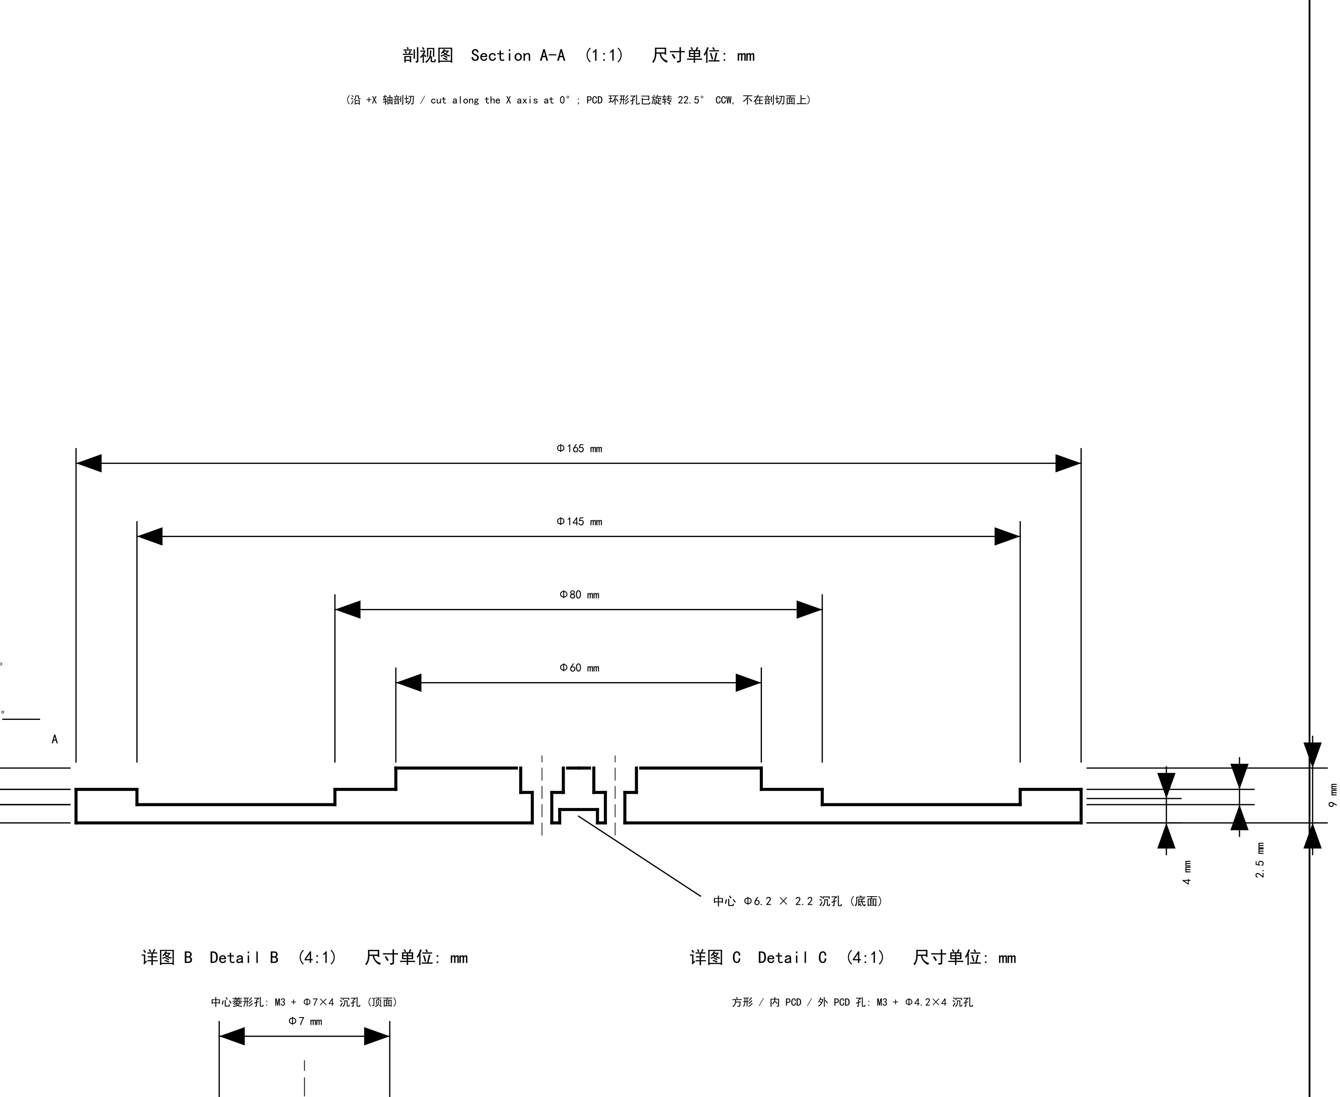
models/hub_disc/_zoom_section.png
