kiujkiu/macha/models/hub_disc/_zoom_topcenter.png

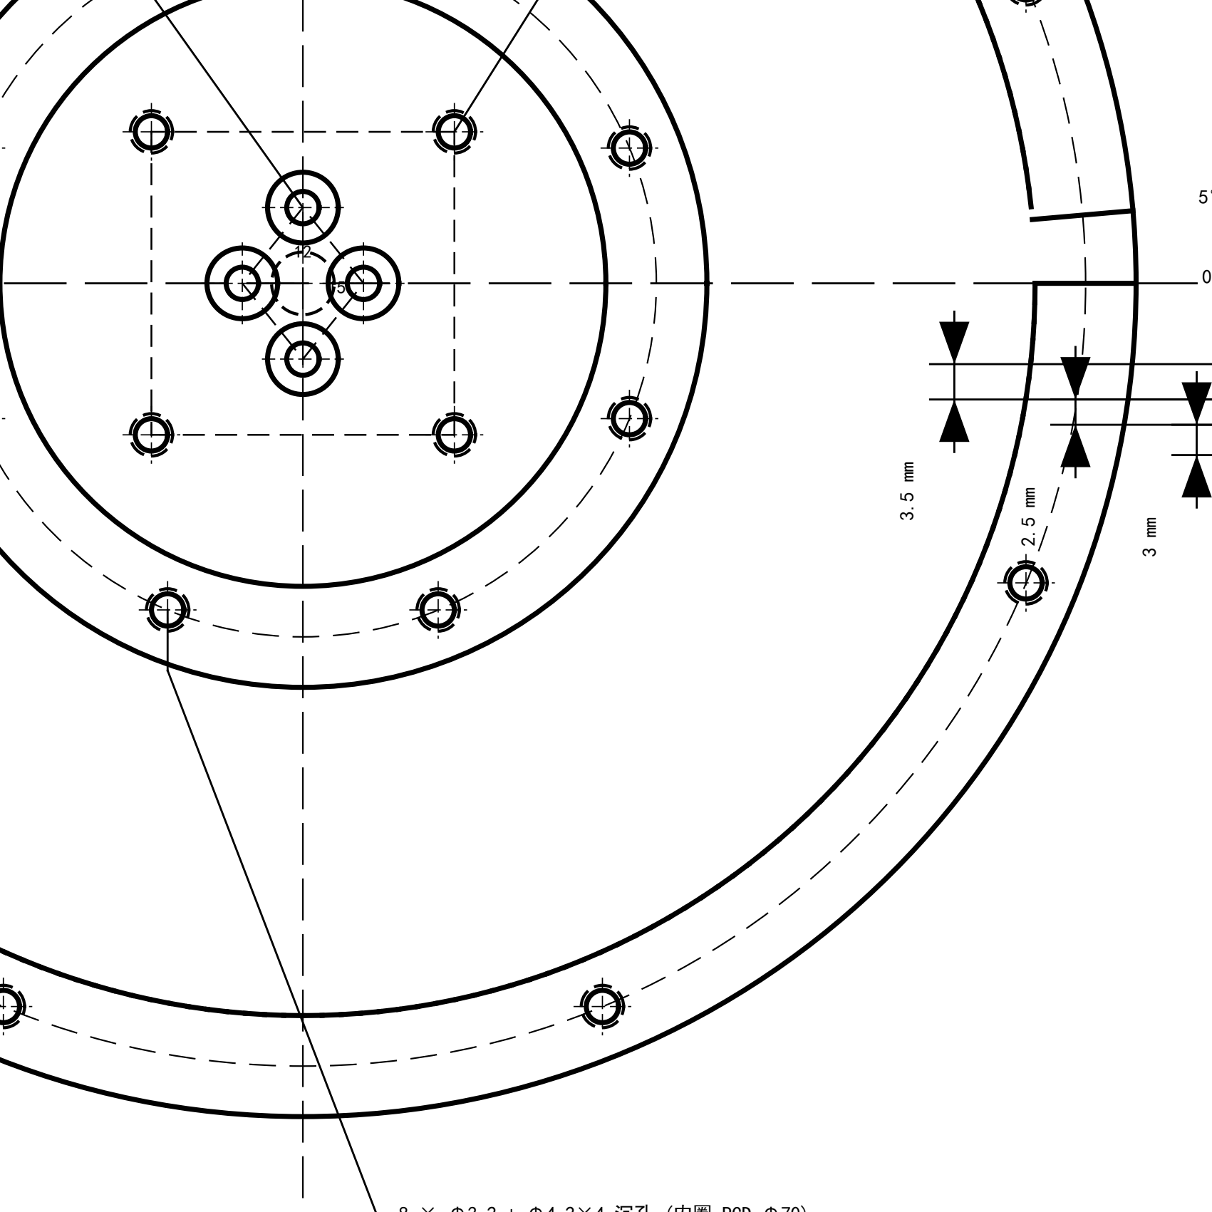
models/hub_disc/_zoom_topcenter.png
