kiujkiu/macha/models/hub_disc/hub_disc_drawing_preview.png

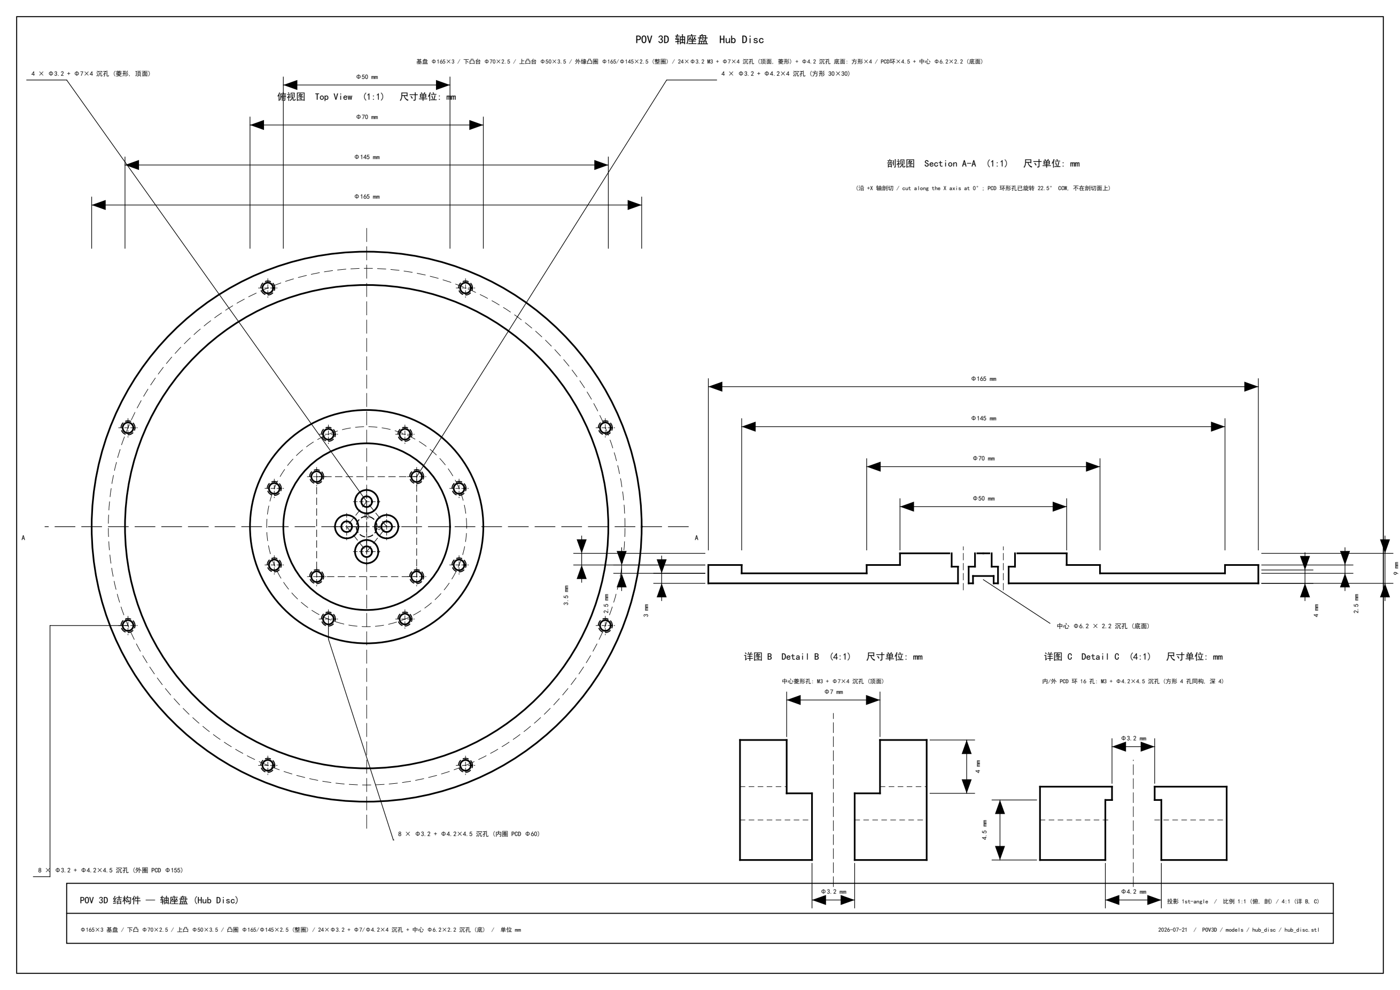
models/hub_disc/hub_disc_drawing_preview.png
