kiujkiu/macha/models/l_bracket_170x60/l_bracket_170x60_drawing_preview.png

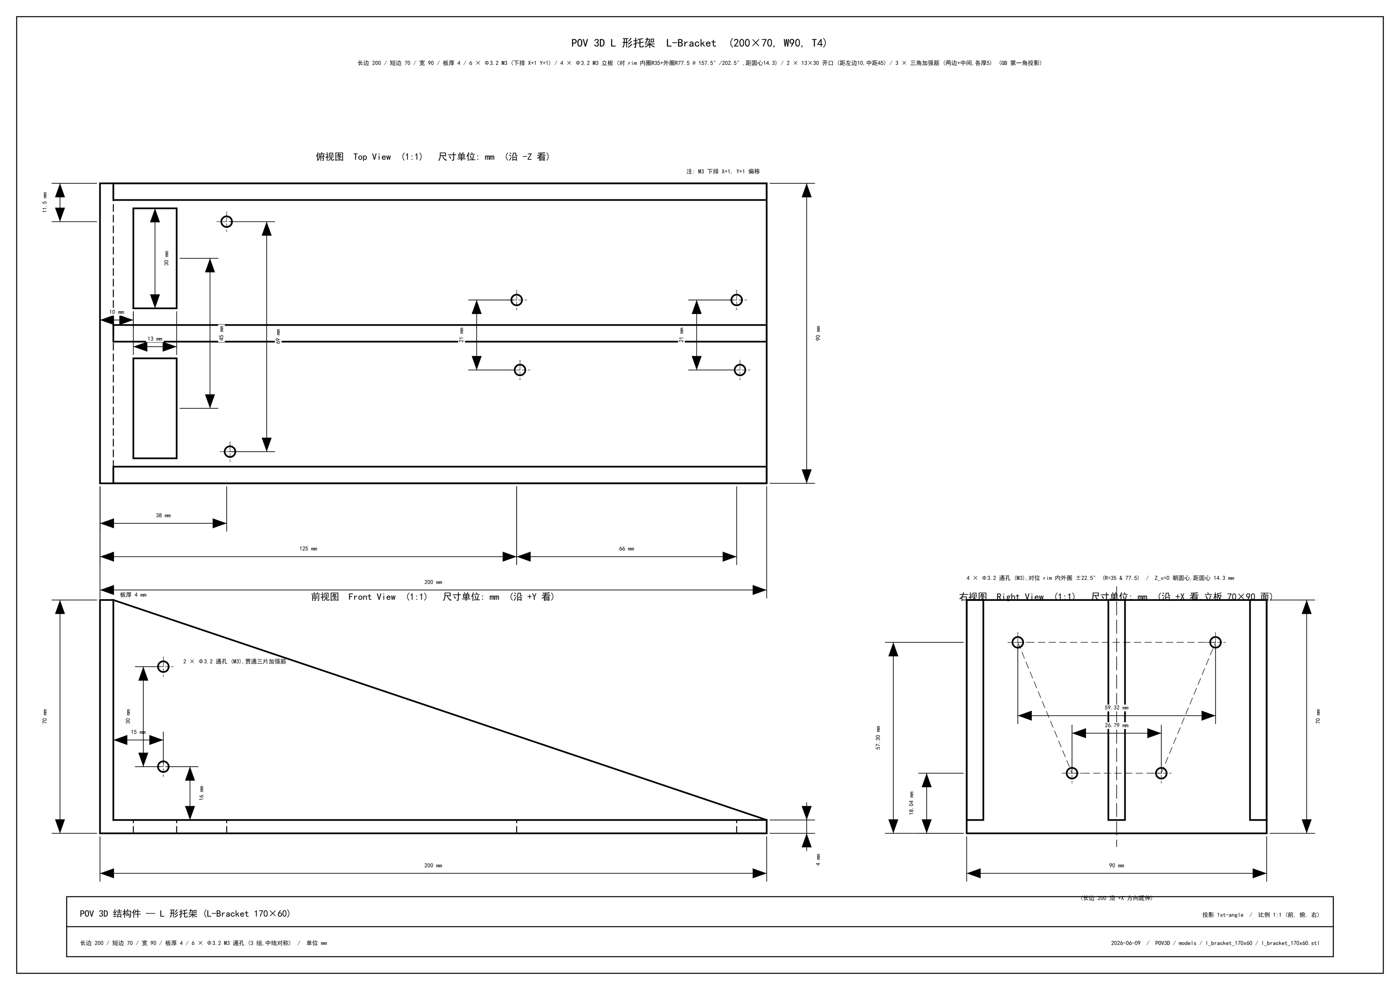
models/l_bracket_170x60/l_bracket_170x60_drawing_preview.png
