kiujkiu/macha/models/l_bracket_v2/gantry_base_A_preview.png

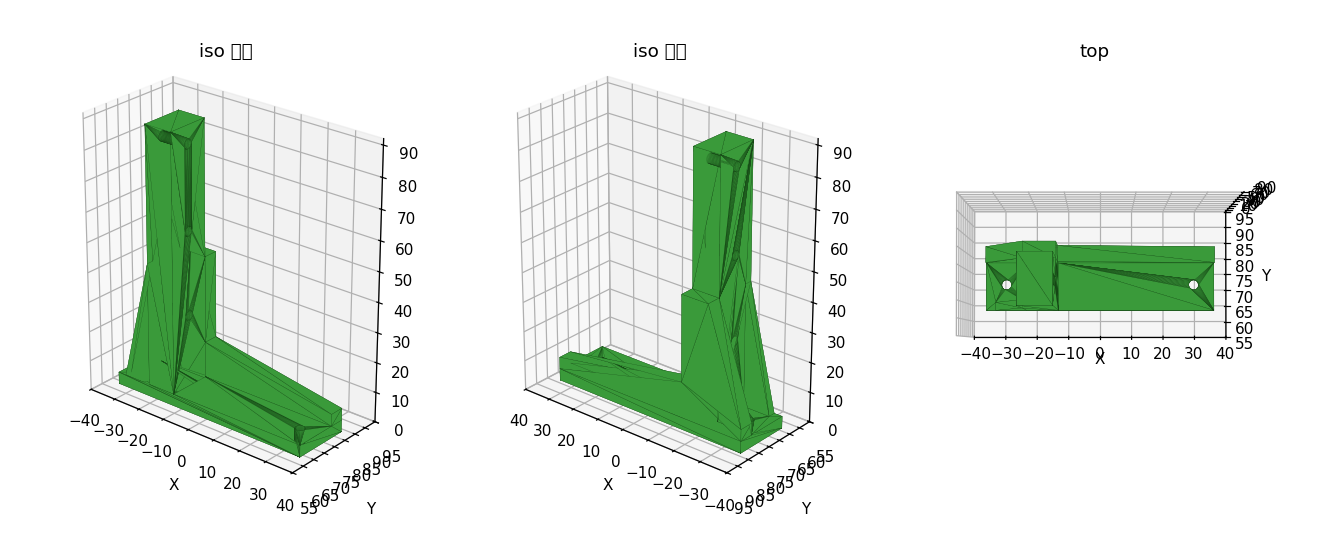
models/l_bracket_v2/gantry_base_A_preview.png
