kiujkiu/macha/models/l_bracket_v2/screen_plate_drawing_preview.png

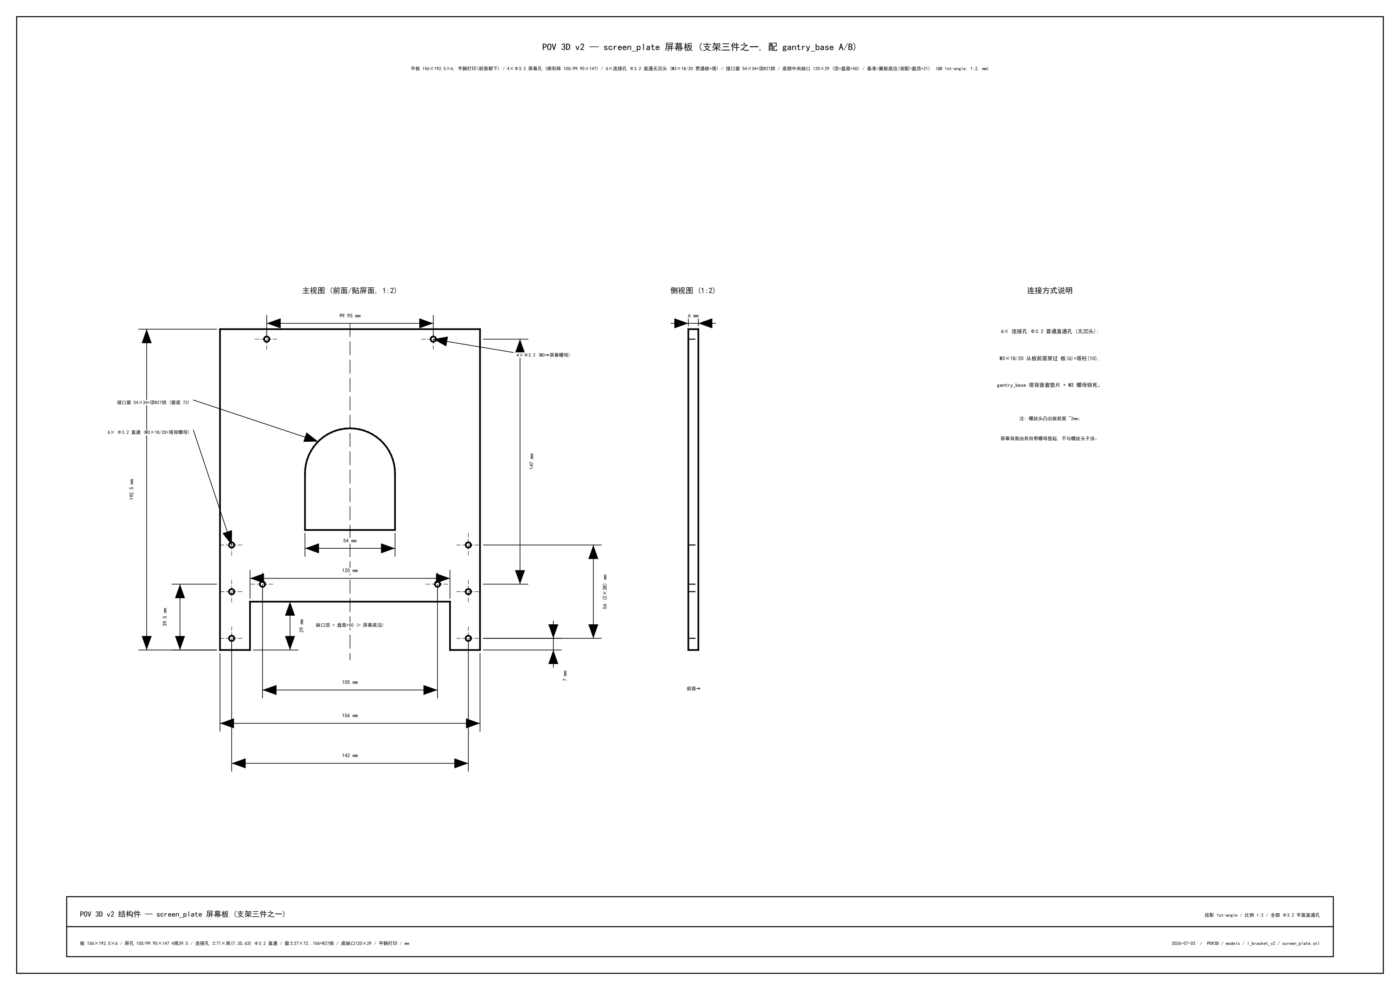
models/l_bracket_v2/screen_plate_drawing_preview.png
