kiujkiu/macha/models/l_bracket_v2/zoom_da.png

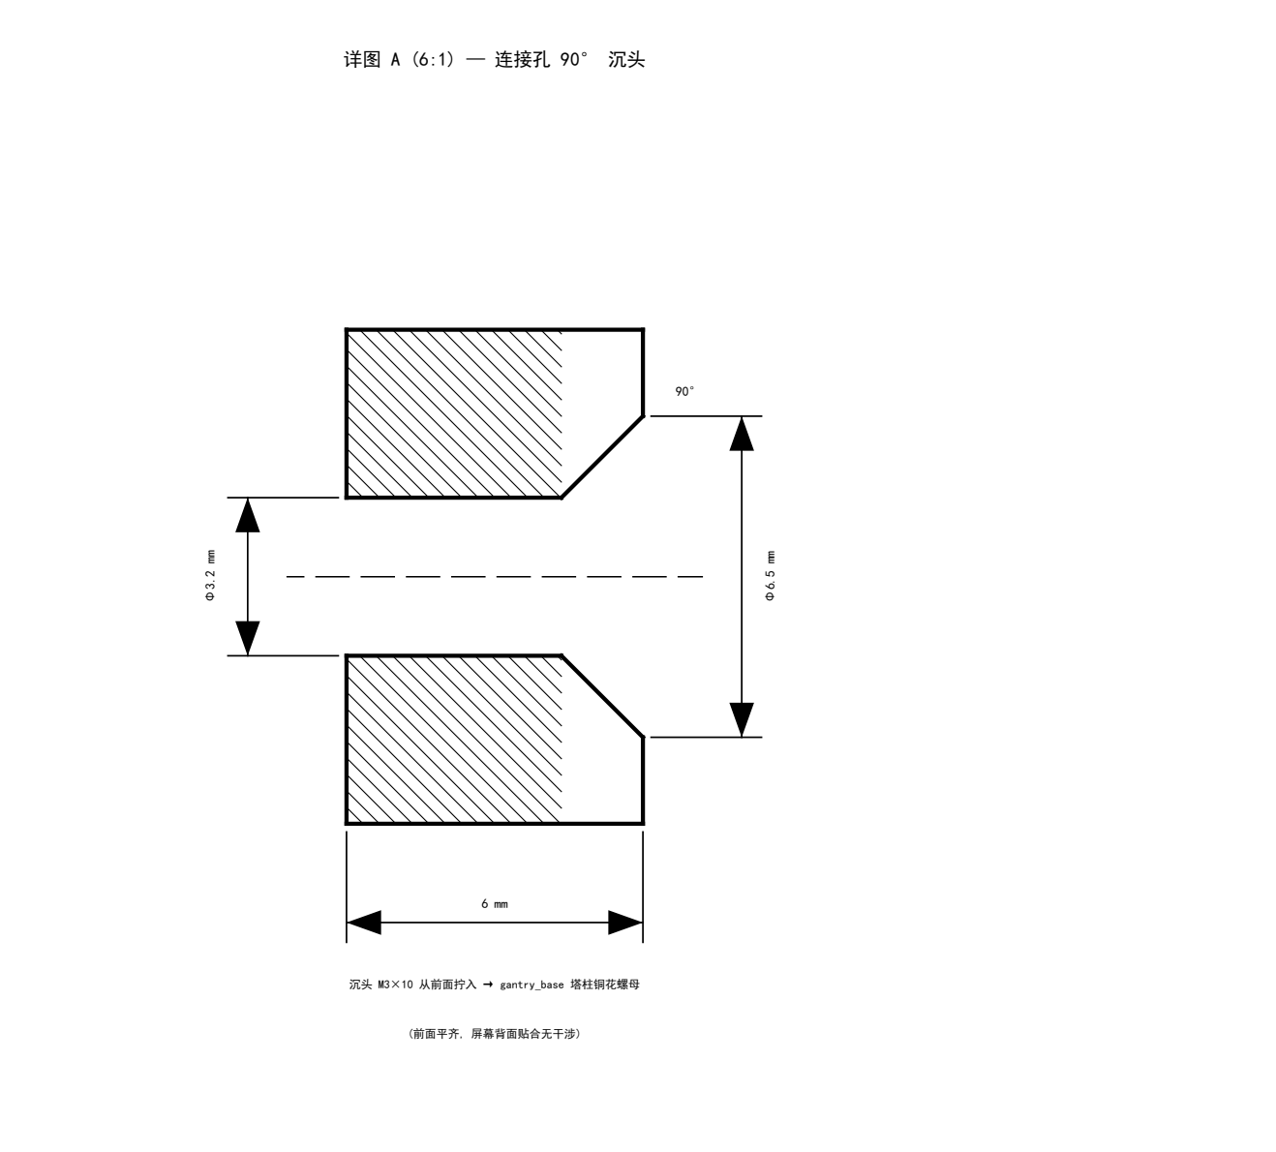
models/l_bracket_v2/zoom_da.png
