kiujkiu/macha/models/l_bracket_v2/zoom_da_base.png

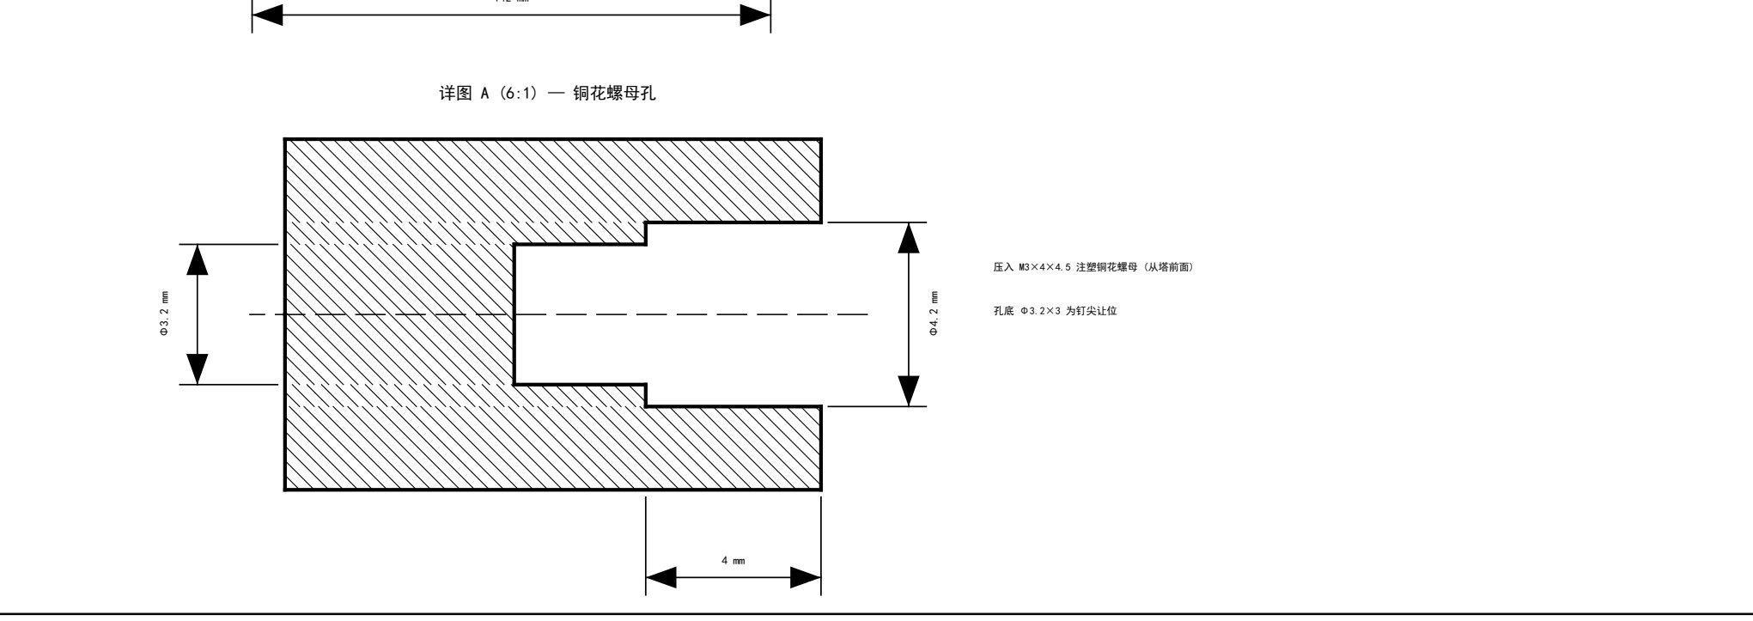
models/l_bracket_v2/zoom_da_base.png
