kiujkiu/macha/models/l_bracket_v2/zoom_plate_fv.png

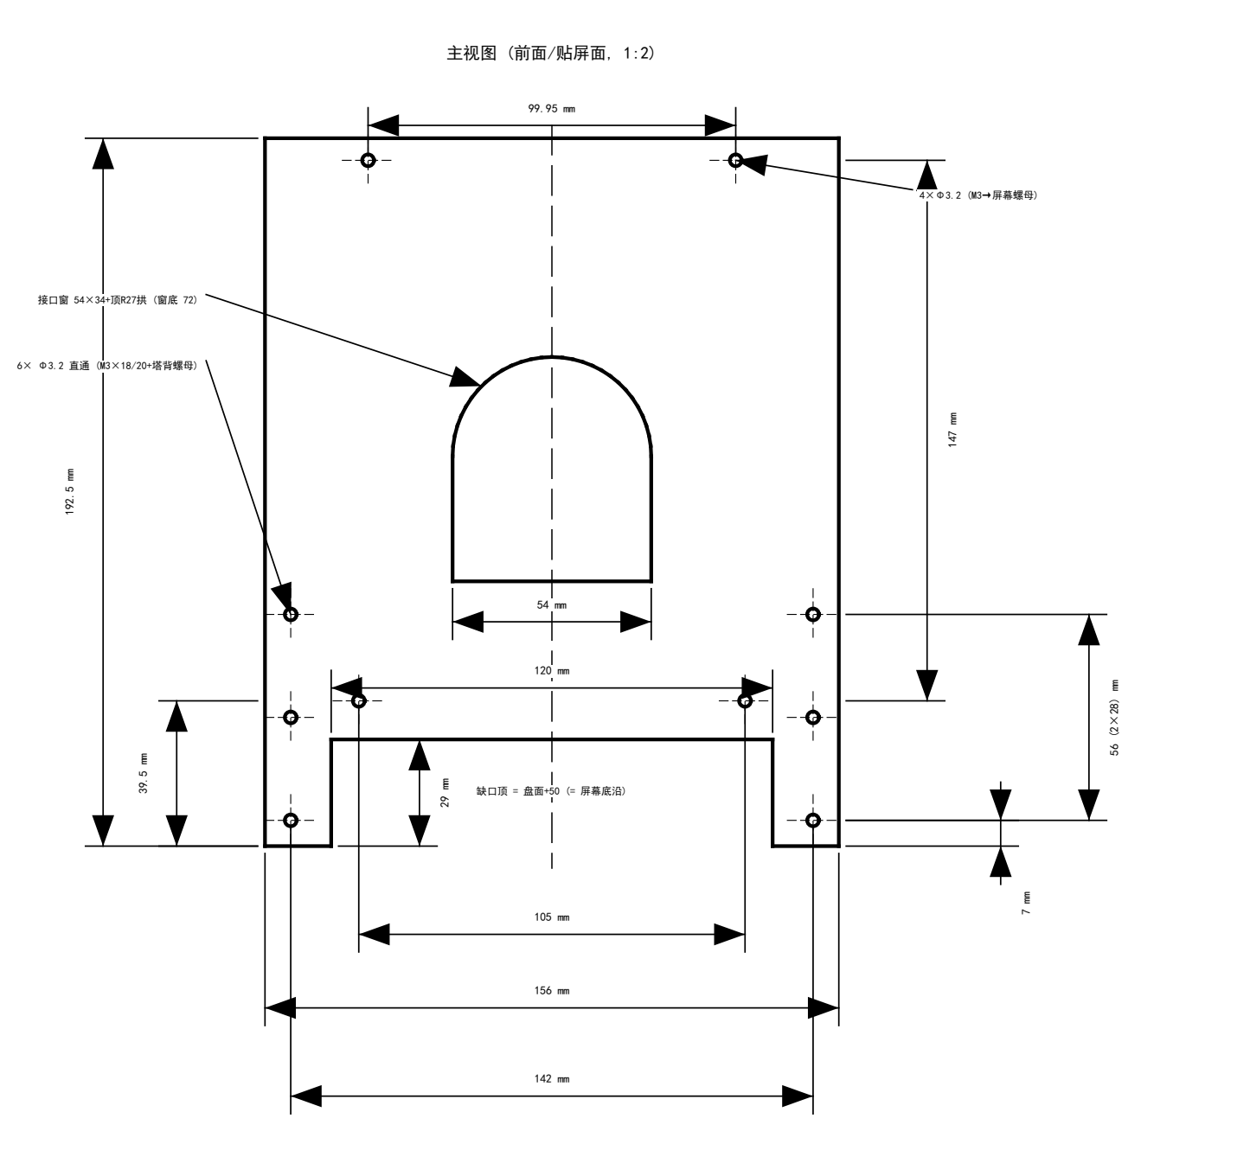
models/l_bracket_v2/zoom_plate_fv.png
