kiujkiu/macha/models/l_bracket_v2/zoom_sv2.png

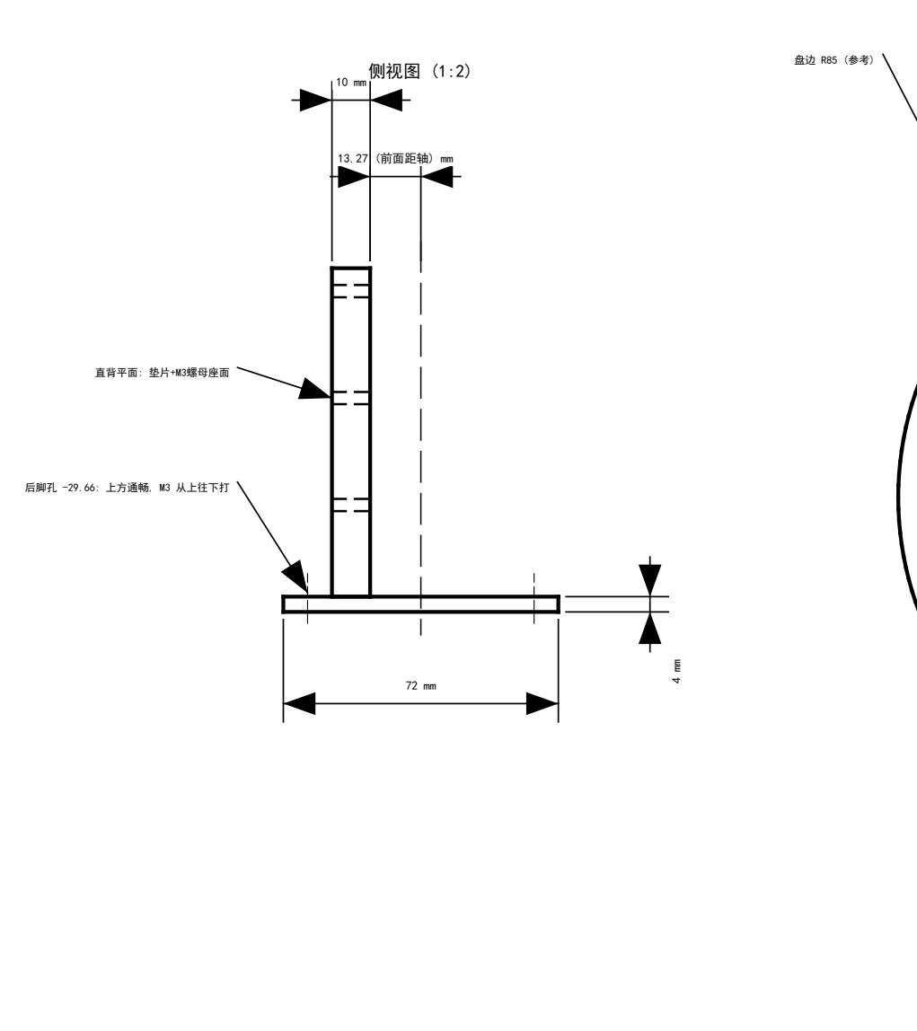
models/l_bracket_v2/zoom_sv2.png
