kiujkiu/macha/models/l_bracket_v2/zoom_sv3.png

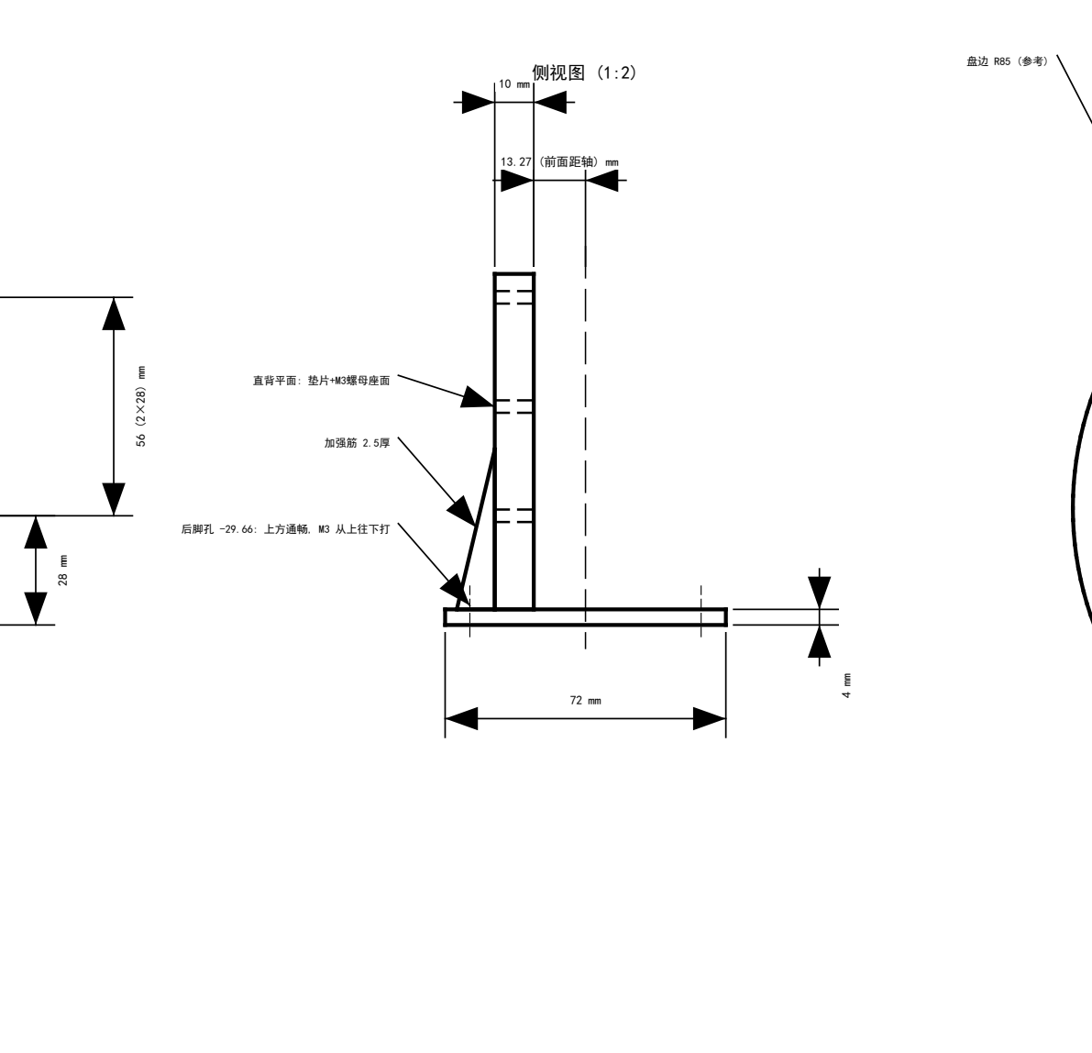
models/l_bracket_v2/zoom_sv3.png
