kiujkiu/macha/models/mlkpai_board/mlkpai_board_drawing_preview.png

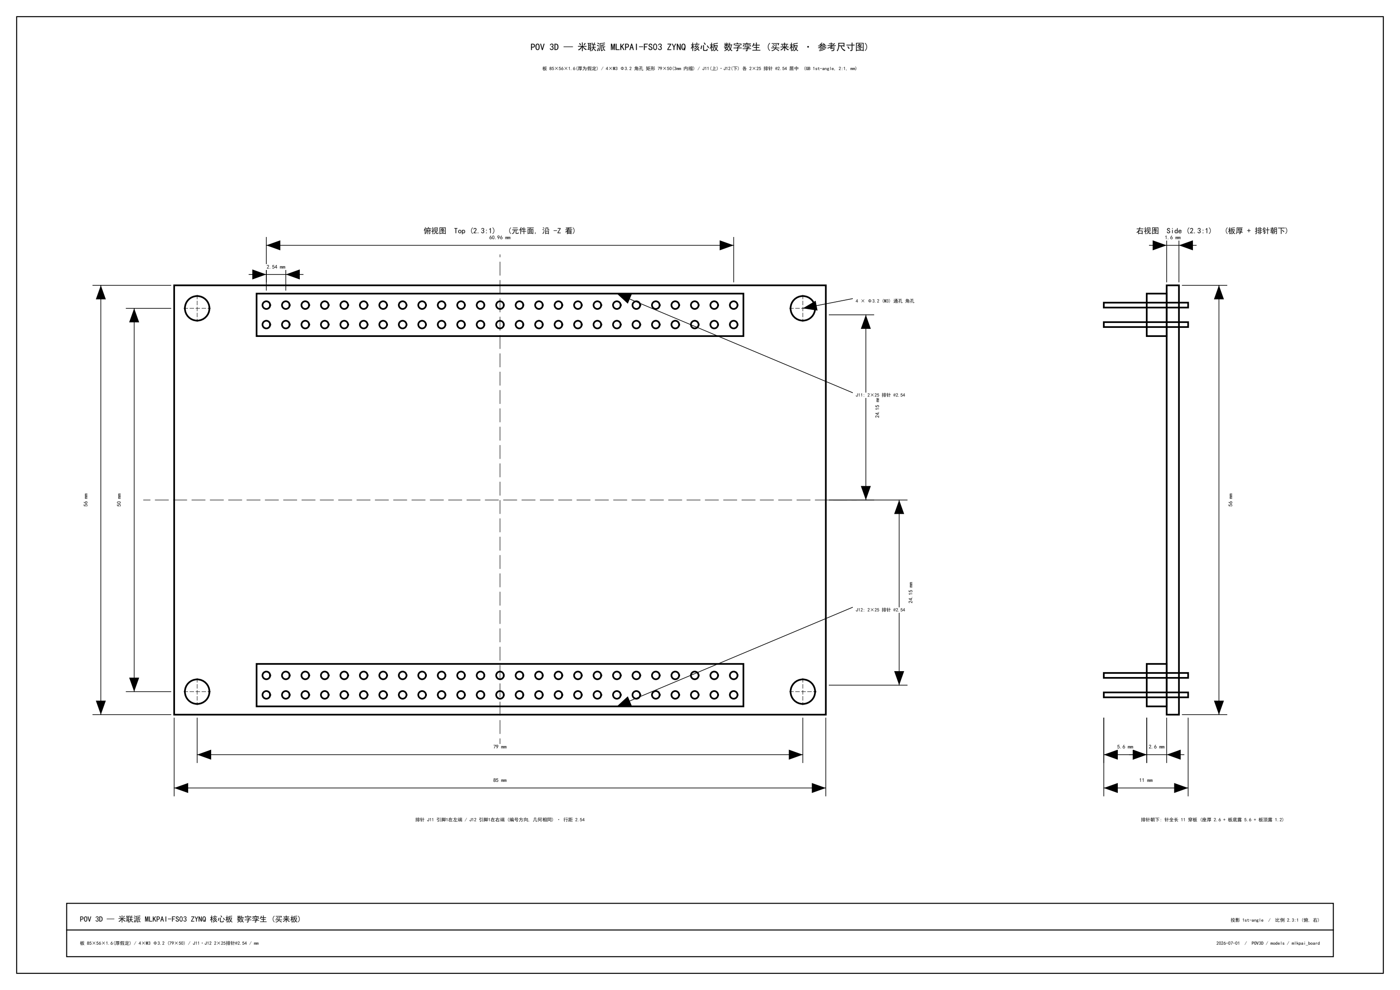
models/mlkpai_board/mlkpai_board_drawing_preview.png
