kiujkiu/macha/models/mlkpai_carrier_disc/mlkpai_carrier_disc_drawing_preview.png

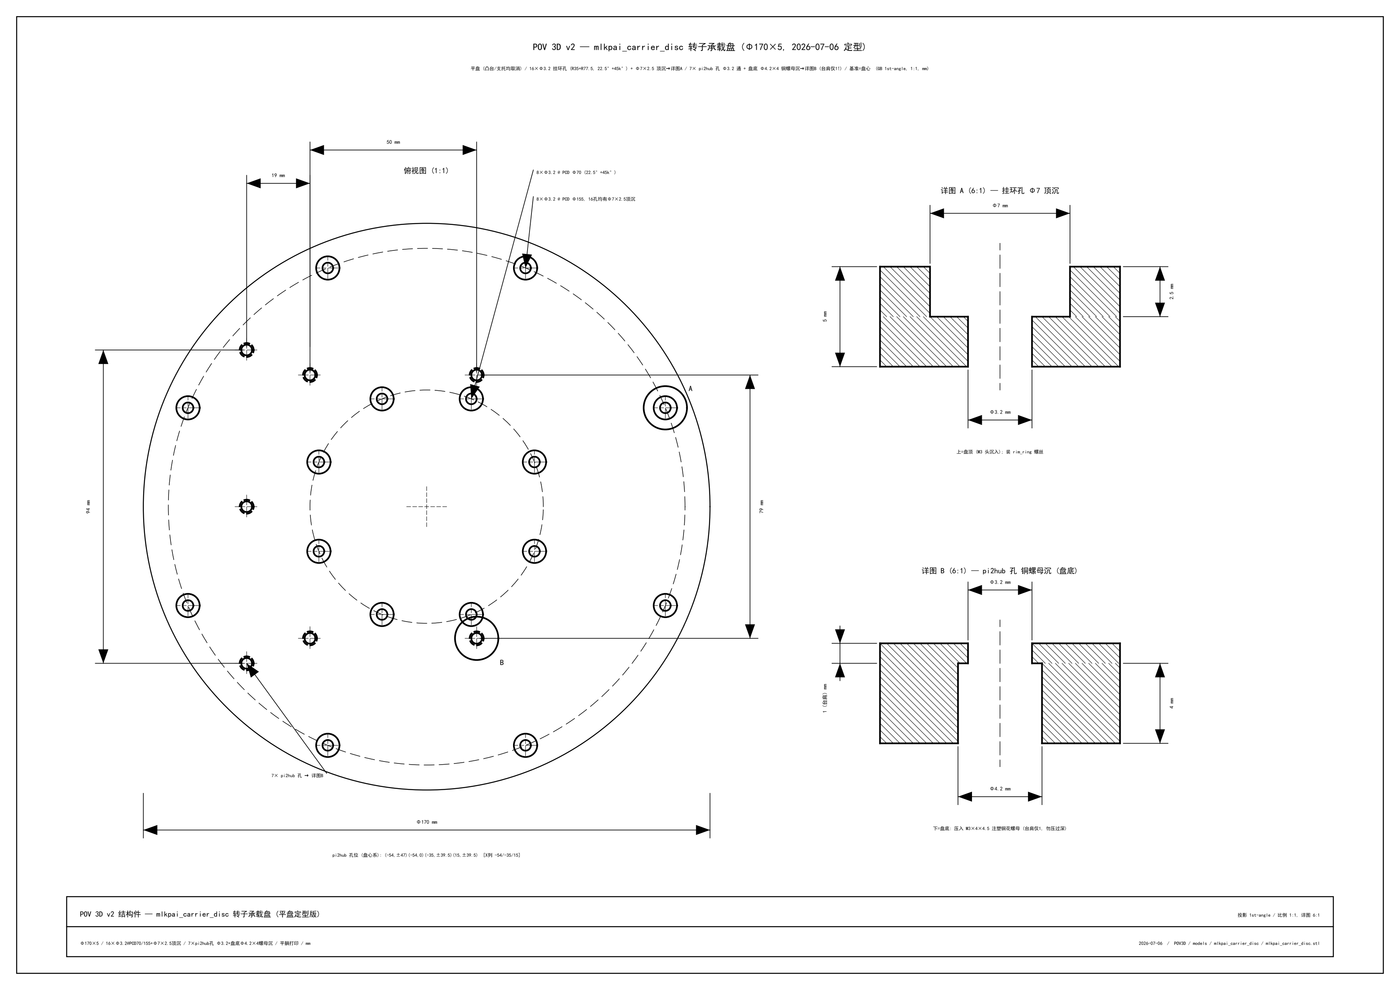
models/mlkpai_carrier_disc/mlkpai_carrier_disc_drawing_preview.png
