kiujkiu/macha/models/mlkpai_carrier_disc/refs/盘_6凸台3托_对比pcb.png

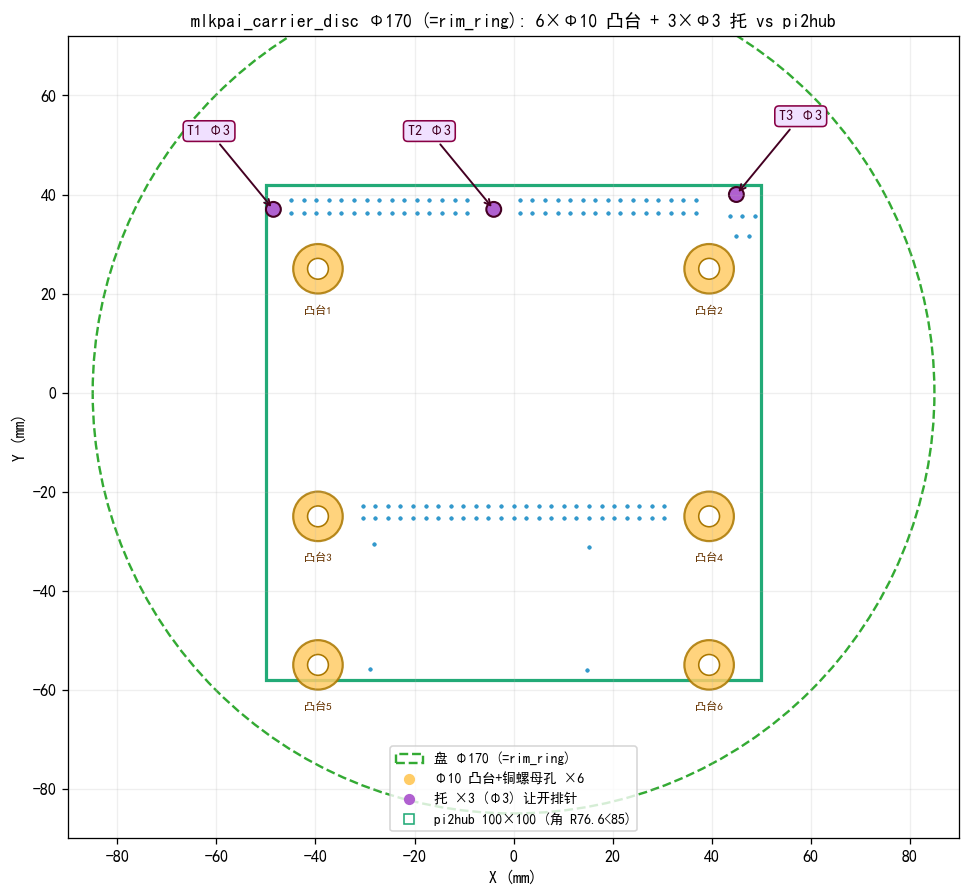
models/mlkpai_carrier_disc/refs/盘_6凸台3托_对比pcb.png
