kiujkiu/macha/models/mlkpai_h_bracket/mlkpai_h_bracket_drawing_preview.png

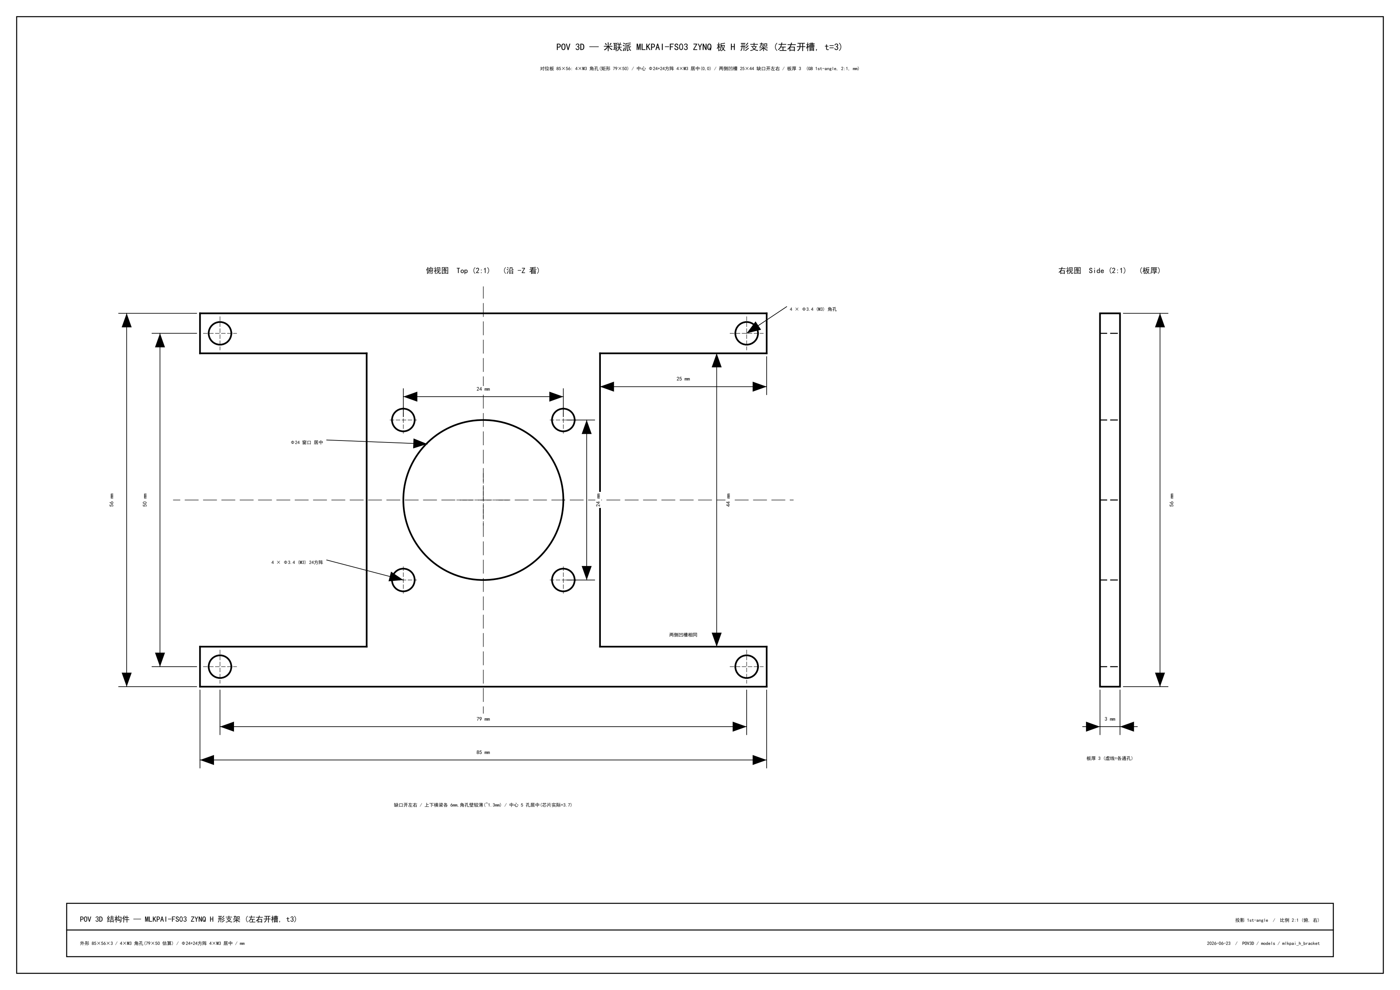
models/mlkpai_h_bracket/mlkpai_h_bracket_drawing_preview.png
