kiujkiu/macha/models/mounting_flange/mounting_flange_drawing_preview.png

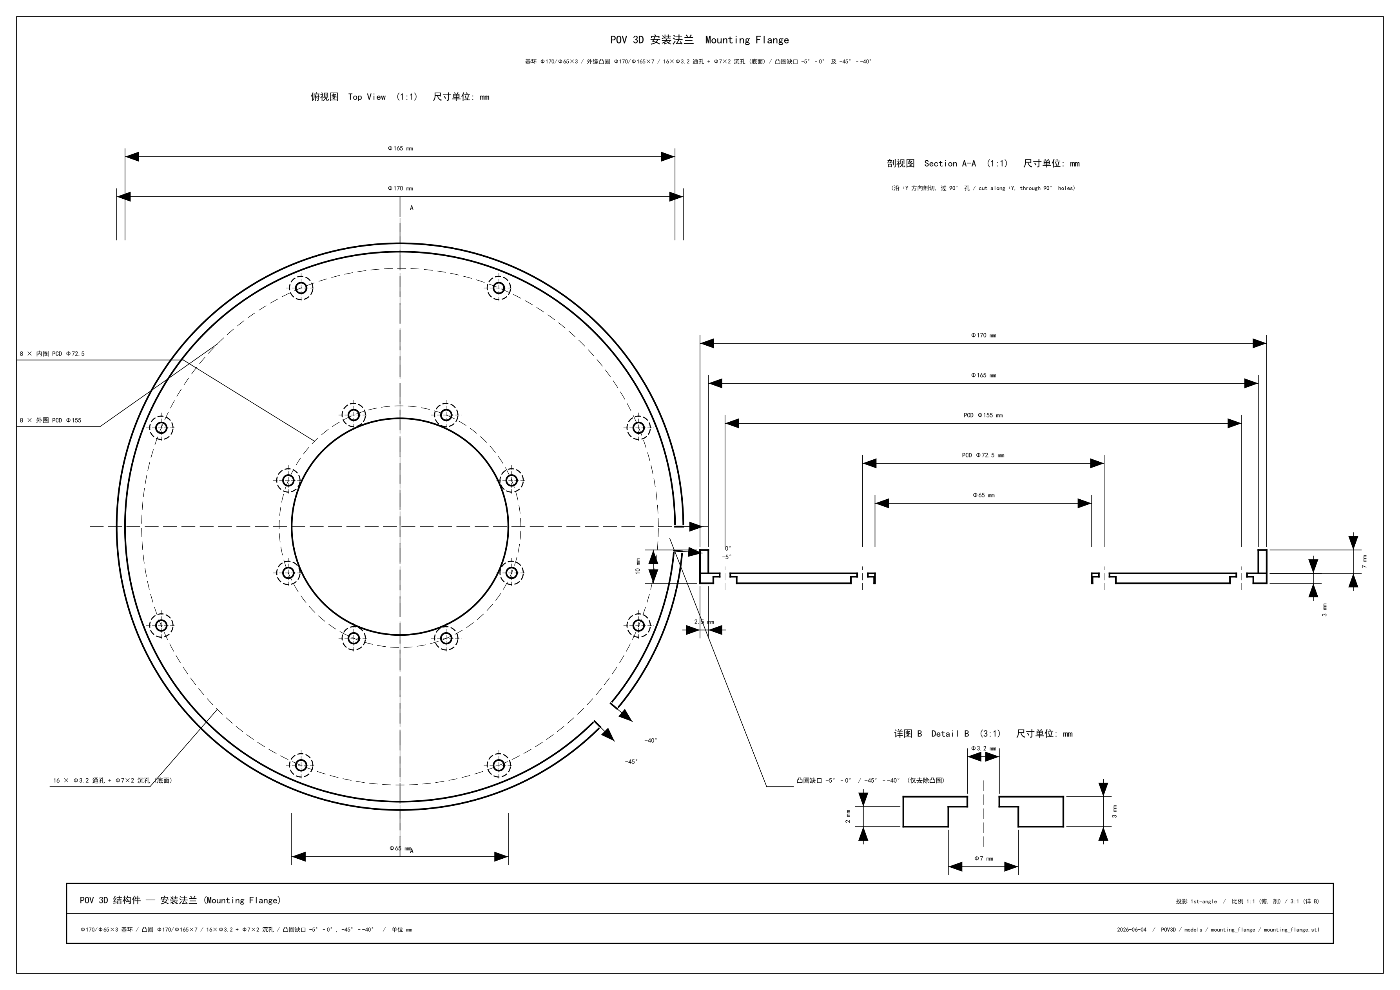
models/mounting_flange/mounting_flange_drawing_preview.png
