kiujkiu/macha/models/mr30_clamp_12p3x5p3x15p4/mr30_clamp_12p3x5p3x15p4_drawing_preview.png

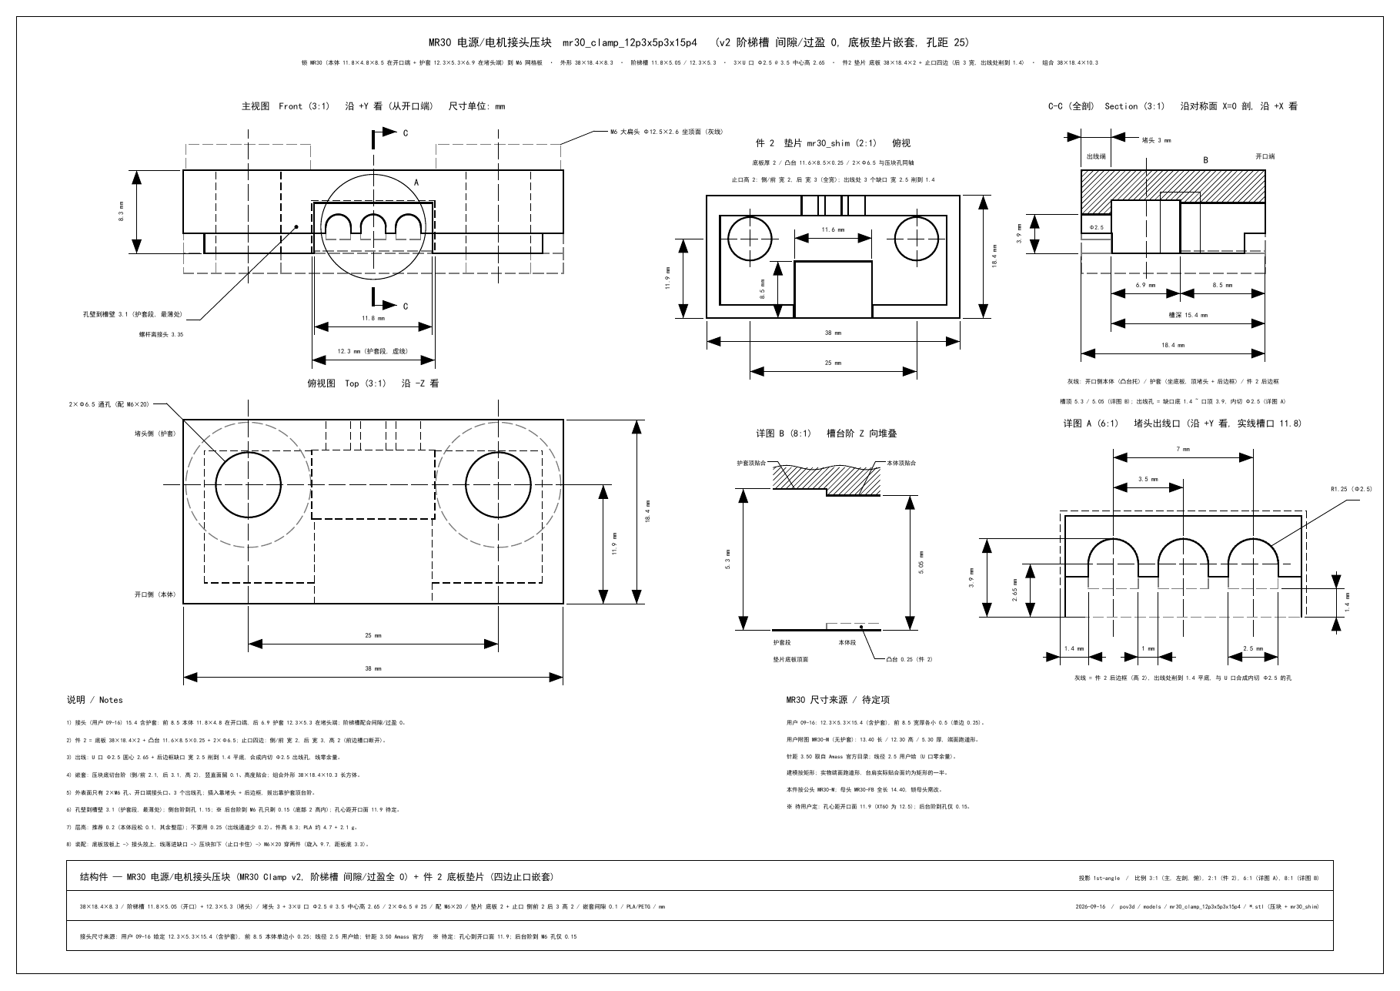
models/mr30_clamp_12p3x5p3x15p4/mr30_clamp_12p3x5p3x15p4_drawing_preview.png
