kiujkiu/macha/models/pcb_tray/pcb_tray_drawing_preview.png

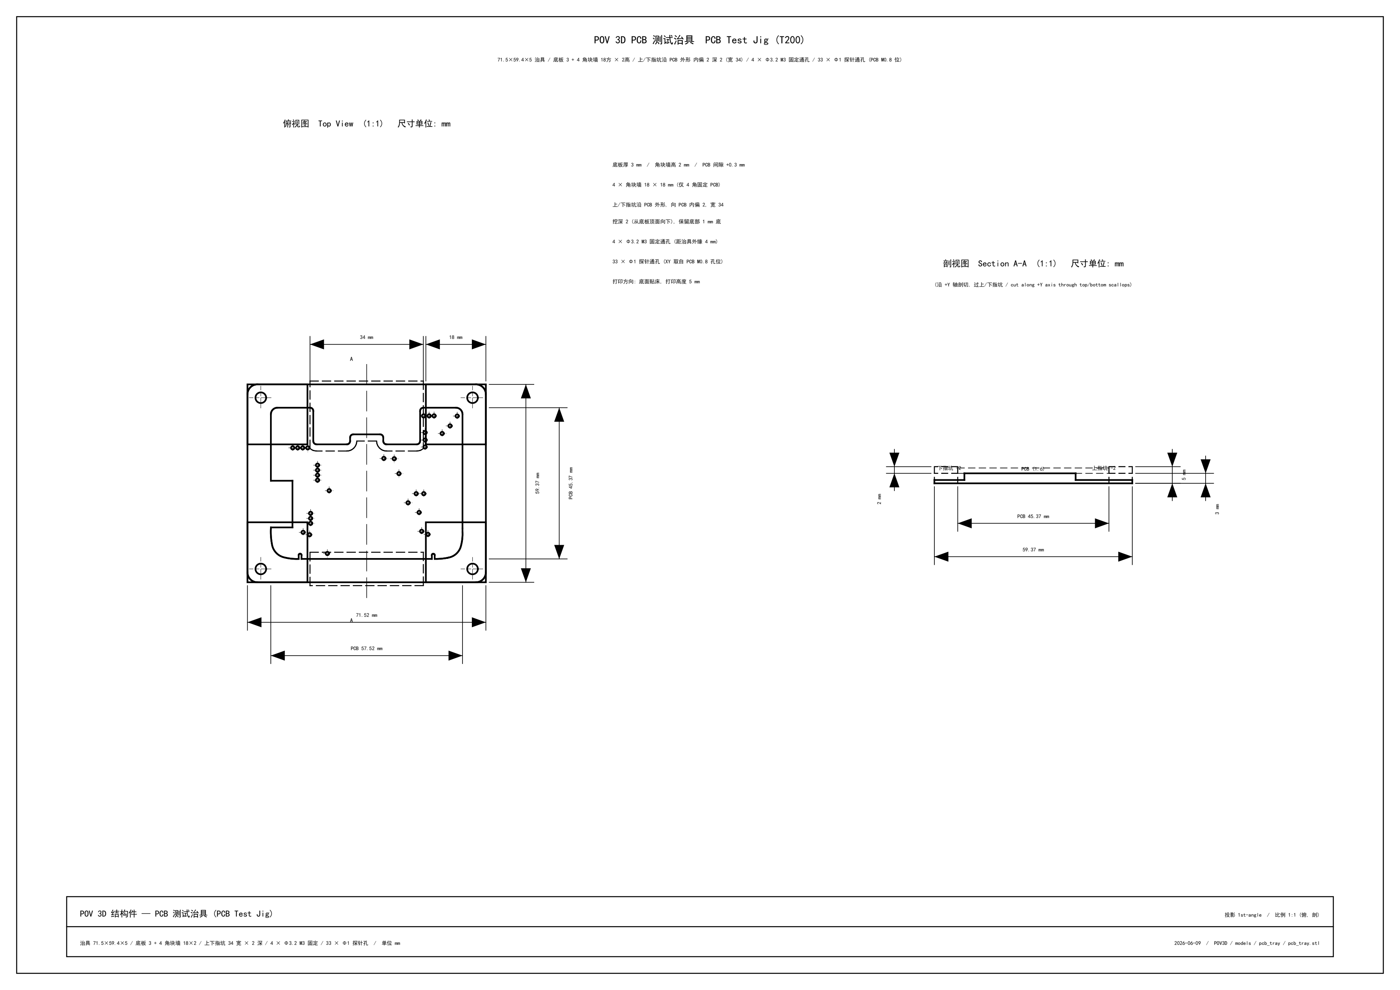
models/pcb_tray/pcb_tray_drawing_preview.png
