kiujkiu/macha/models/pcb_tray/pcb_tray_preview.png

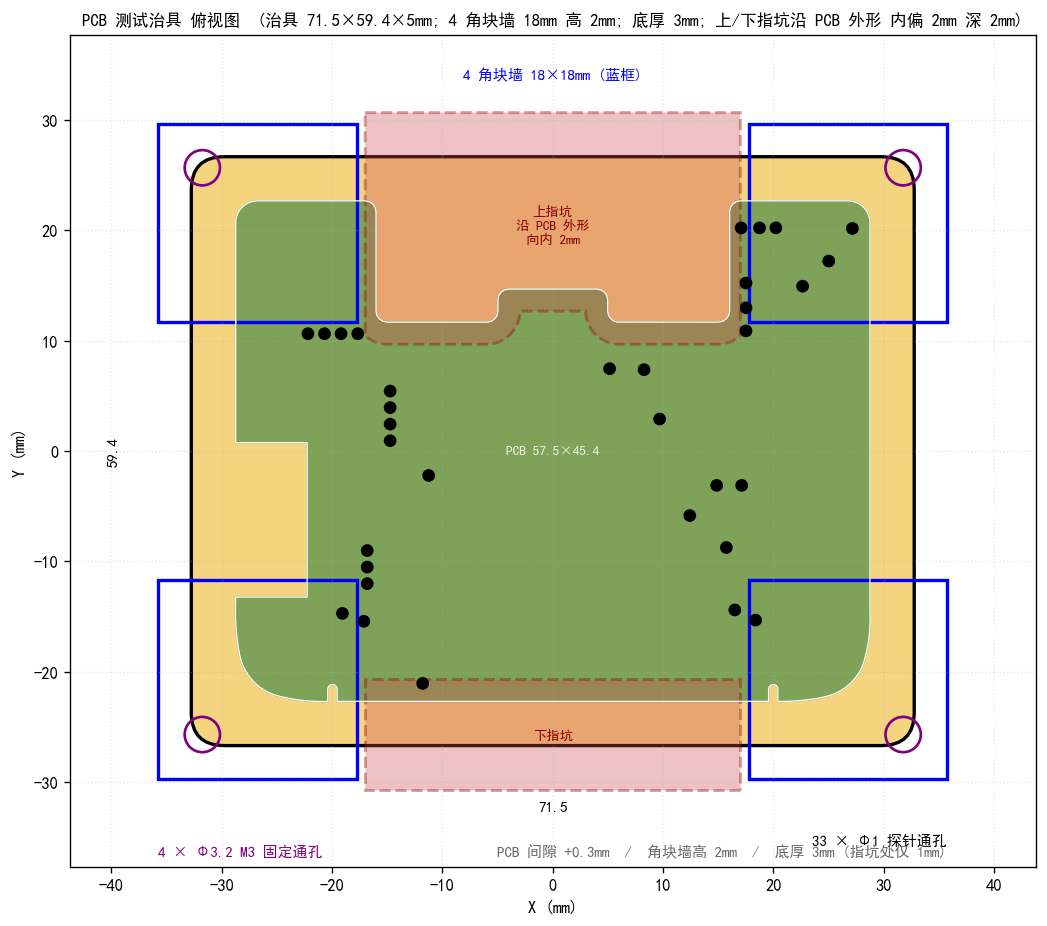
models/pcb_tray/pcb_tray_preview.png
