kiujkiu/macha/models/photo_sensor/both_sheets.png

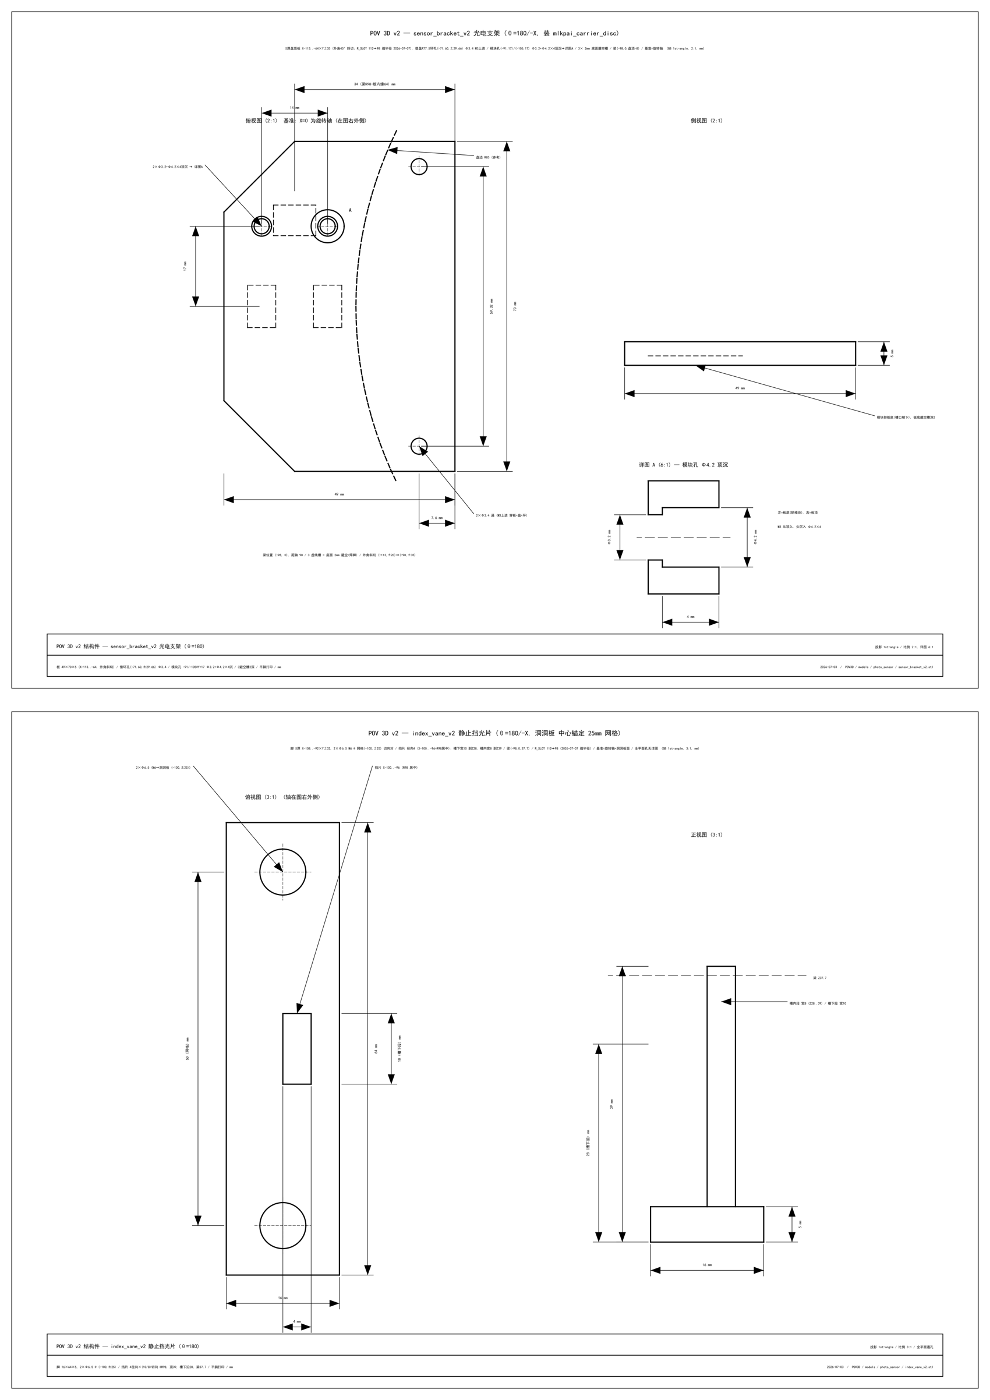
models/photo_sensor/both_sheets.png
