kiujkiu/macha/models/photo_sensor/engage_check2.png

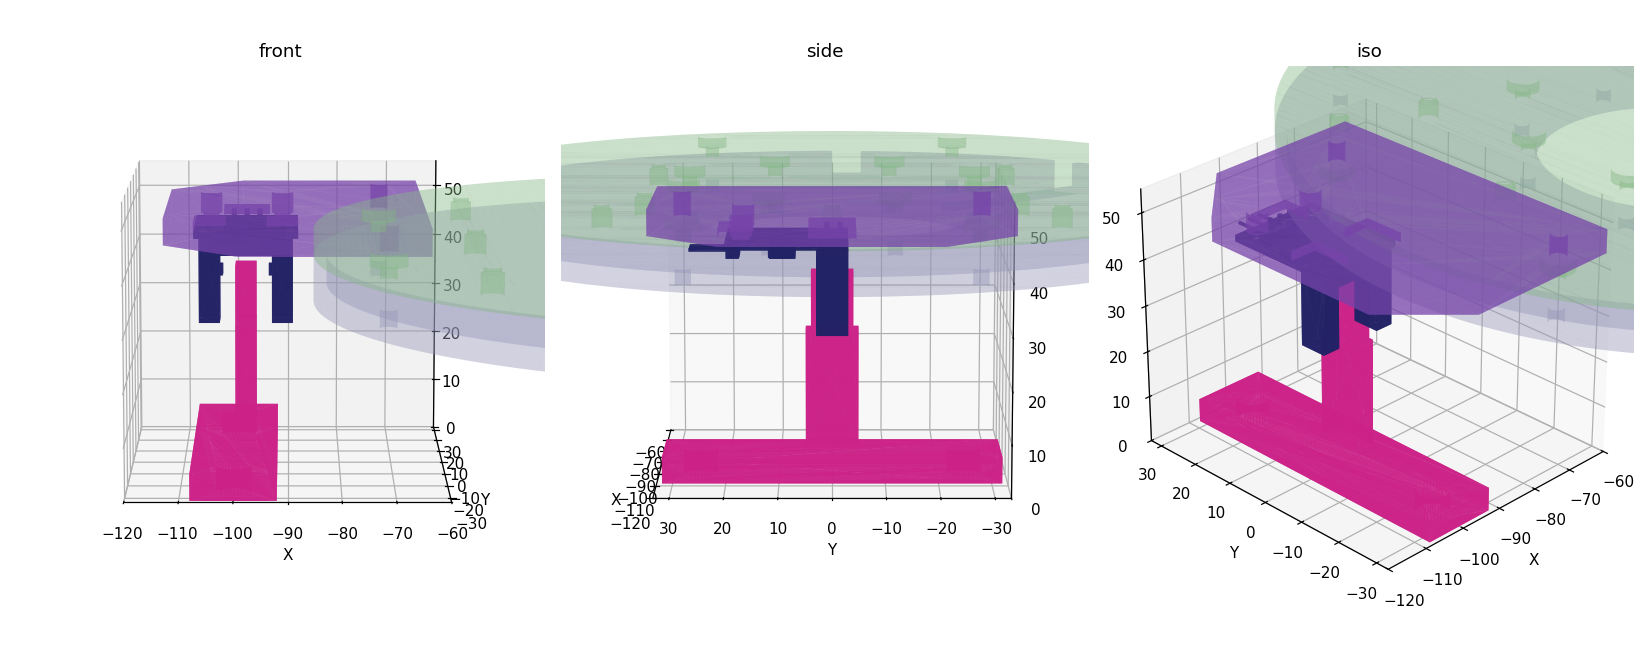
models/photo_sensor/engage_check2.png
