kiujkiu/macha/models/photo_sensor/engage_check.png

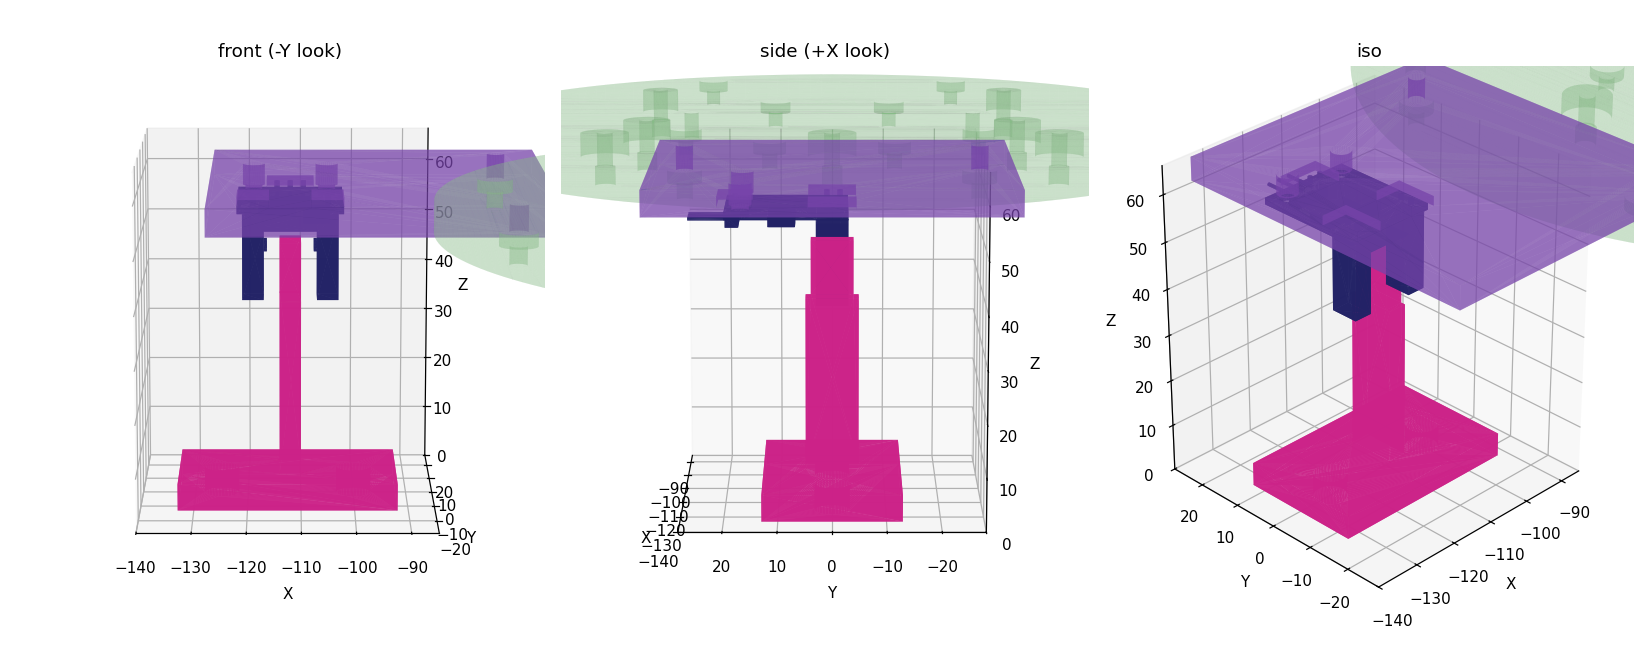
models/photo_sensor/engage_check.png
