kiujkiu/macha/models/photo_sensor/photo_sensor_bracket_v2_drawing_preview.png

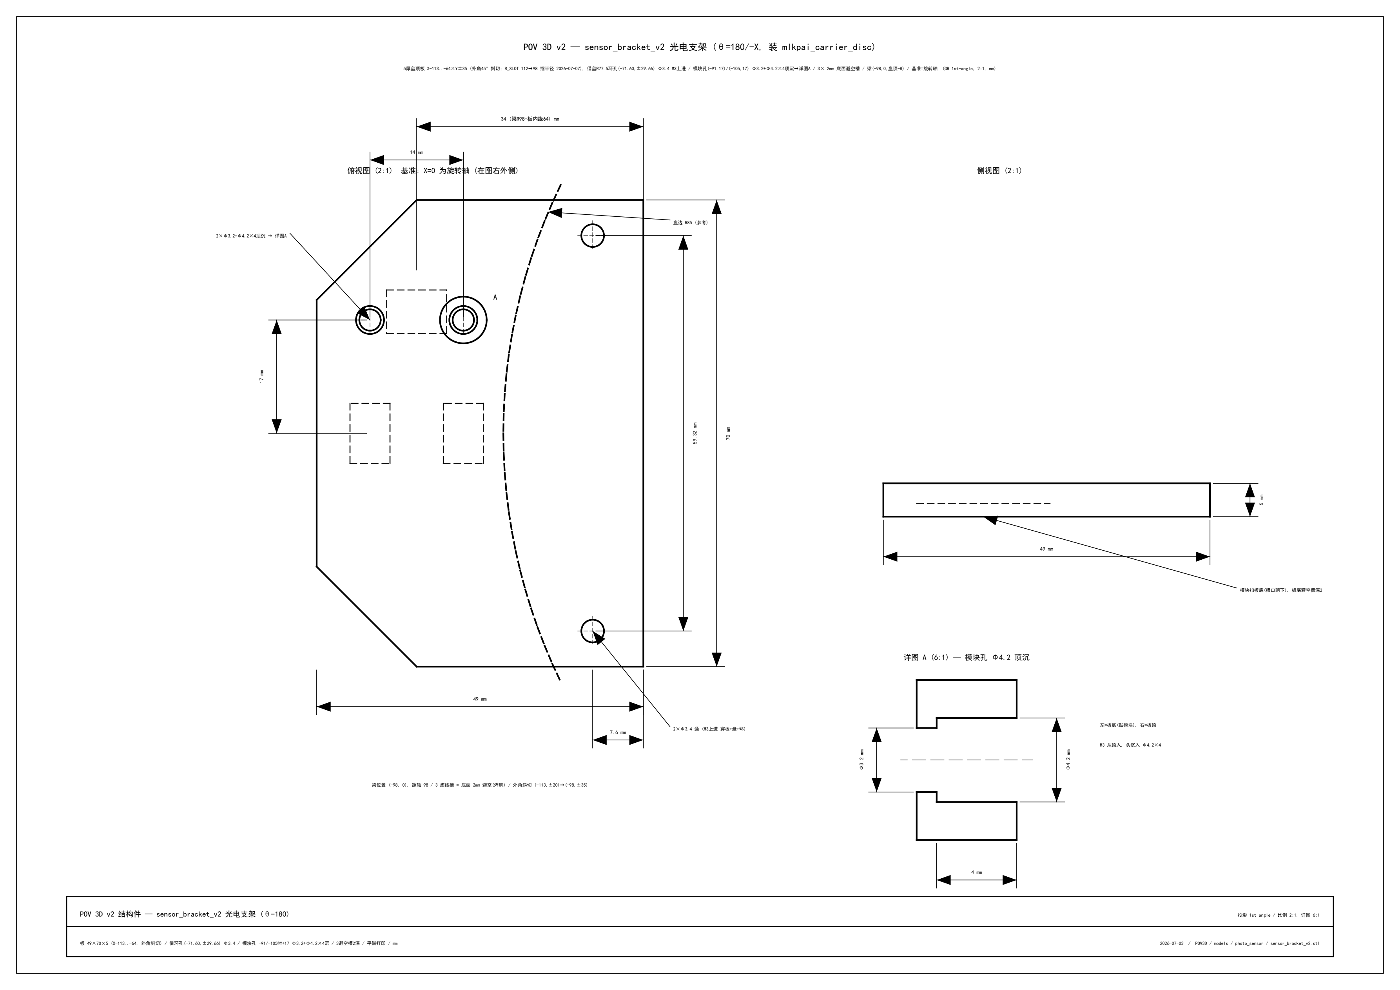
models/photo_sensor/photo_sensor_bracket_v2_drawing_preview.png
