kiujkiu/macha/models/rim_ring/rim_ring_drawing_preview.png

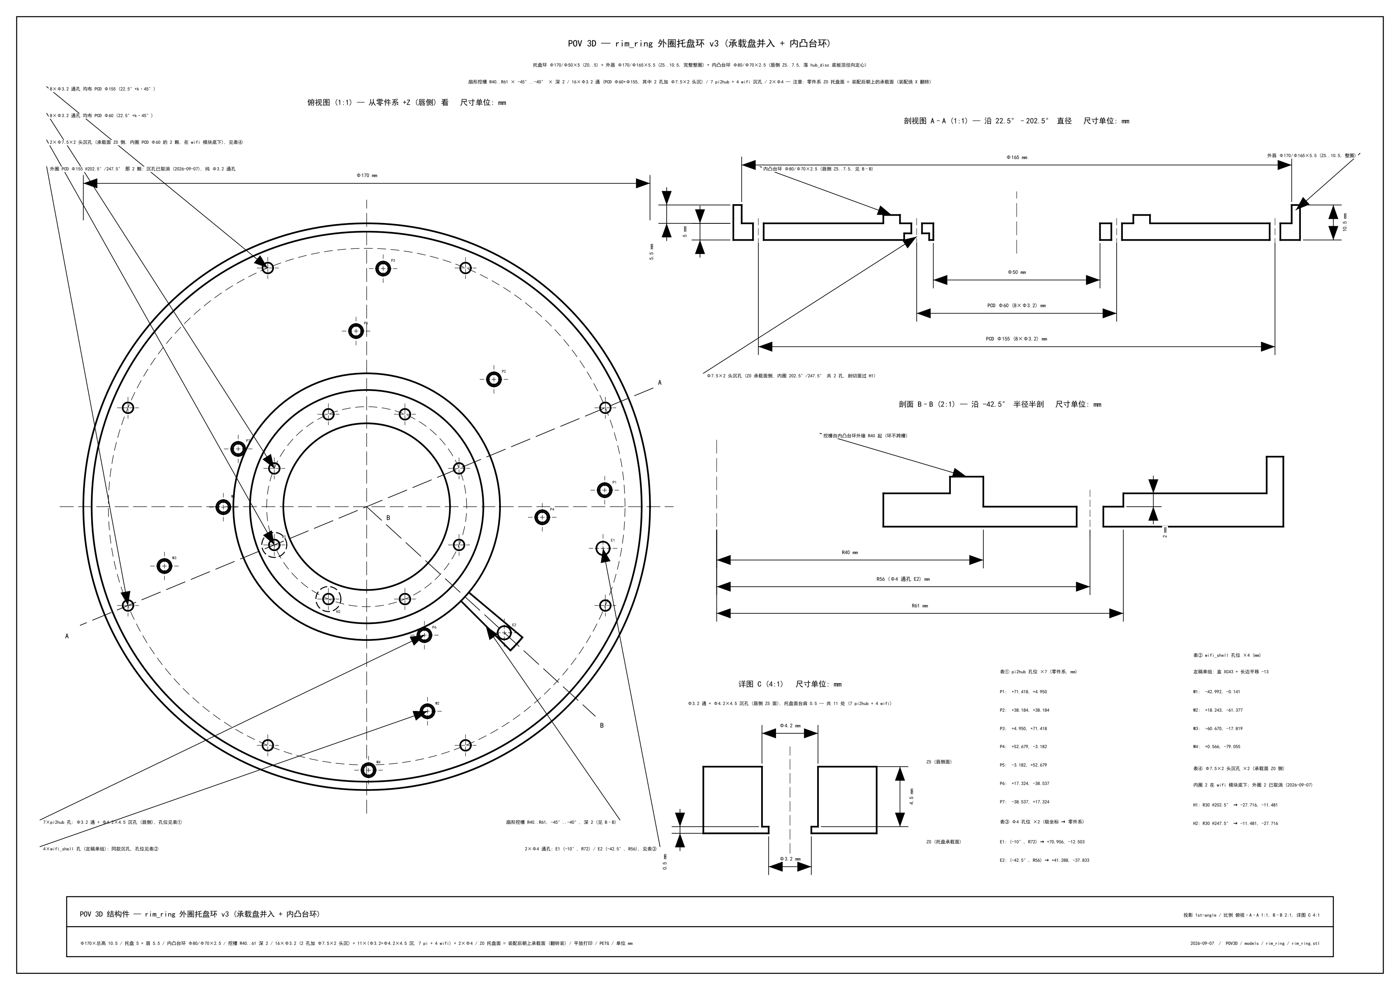
models/rim_ring/rim_ring_drawing_preview.png
