kiujkiu/macha/models/rim_top_disc/boss_change_compare.png

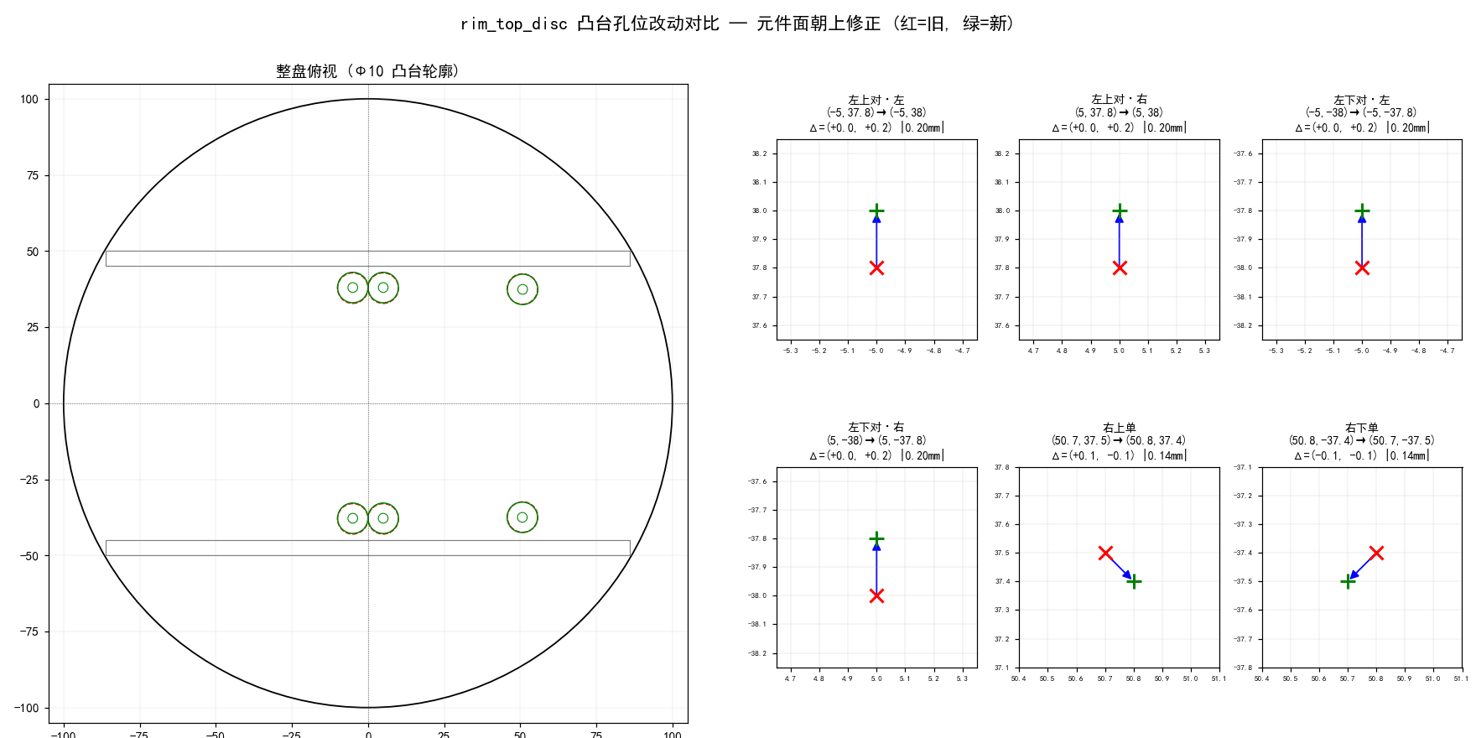
models/rim_top_disc/boss_change_compare.png
