kiujkiu/macha/models/rim_top_disc/rim_top_disc_drawing_preview.png

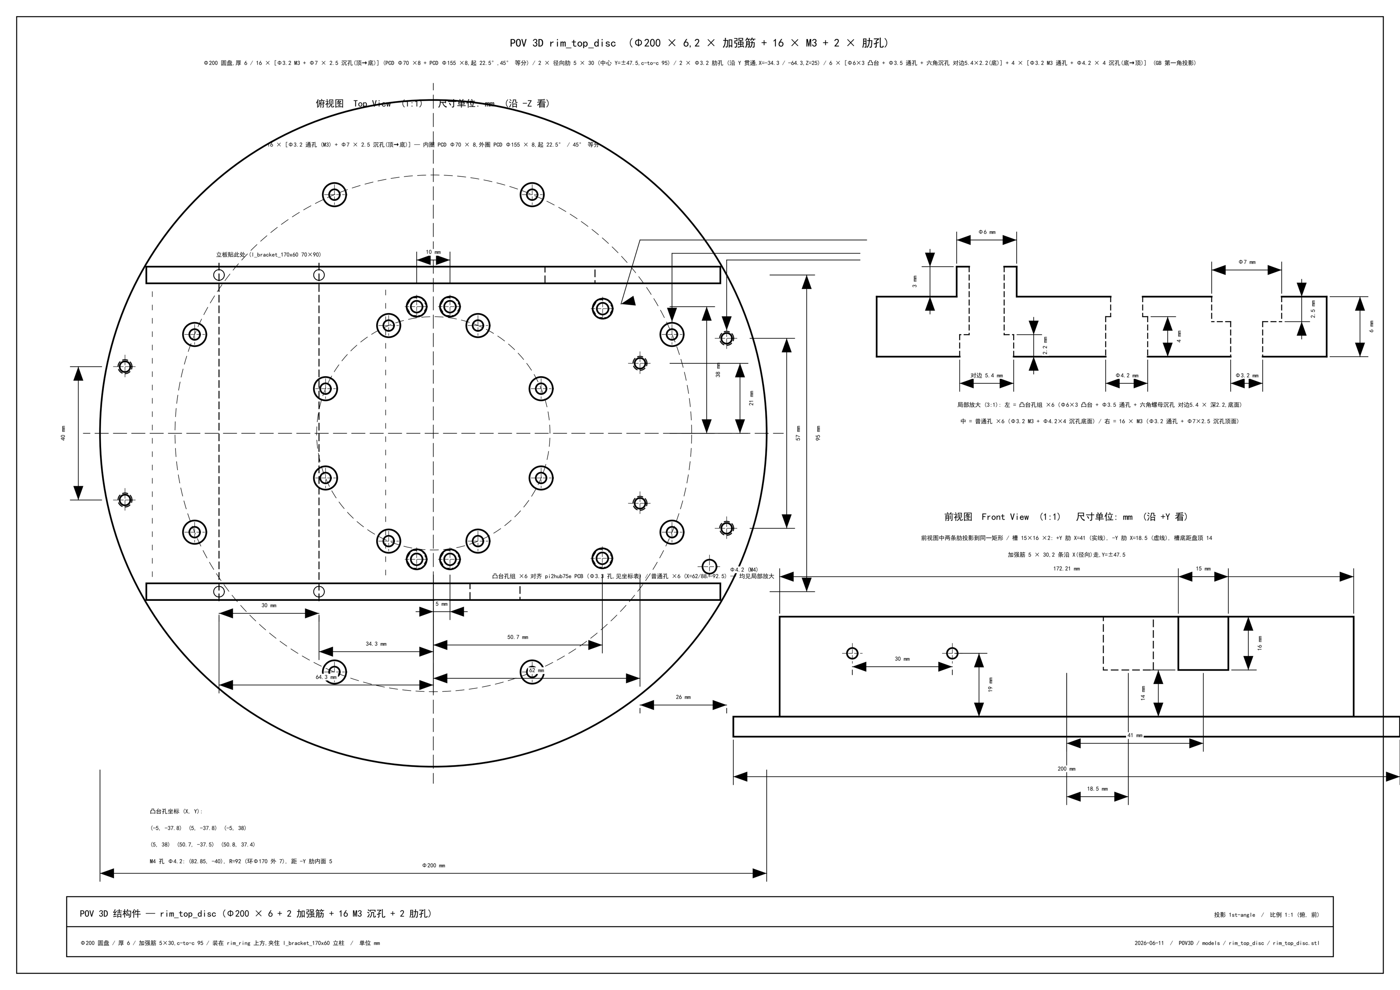
models/rim_top_disc/rim_top_disc_drawing_preview.png
