kiujkiu/macha/models/ring_collar/_v2_preview.png

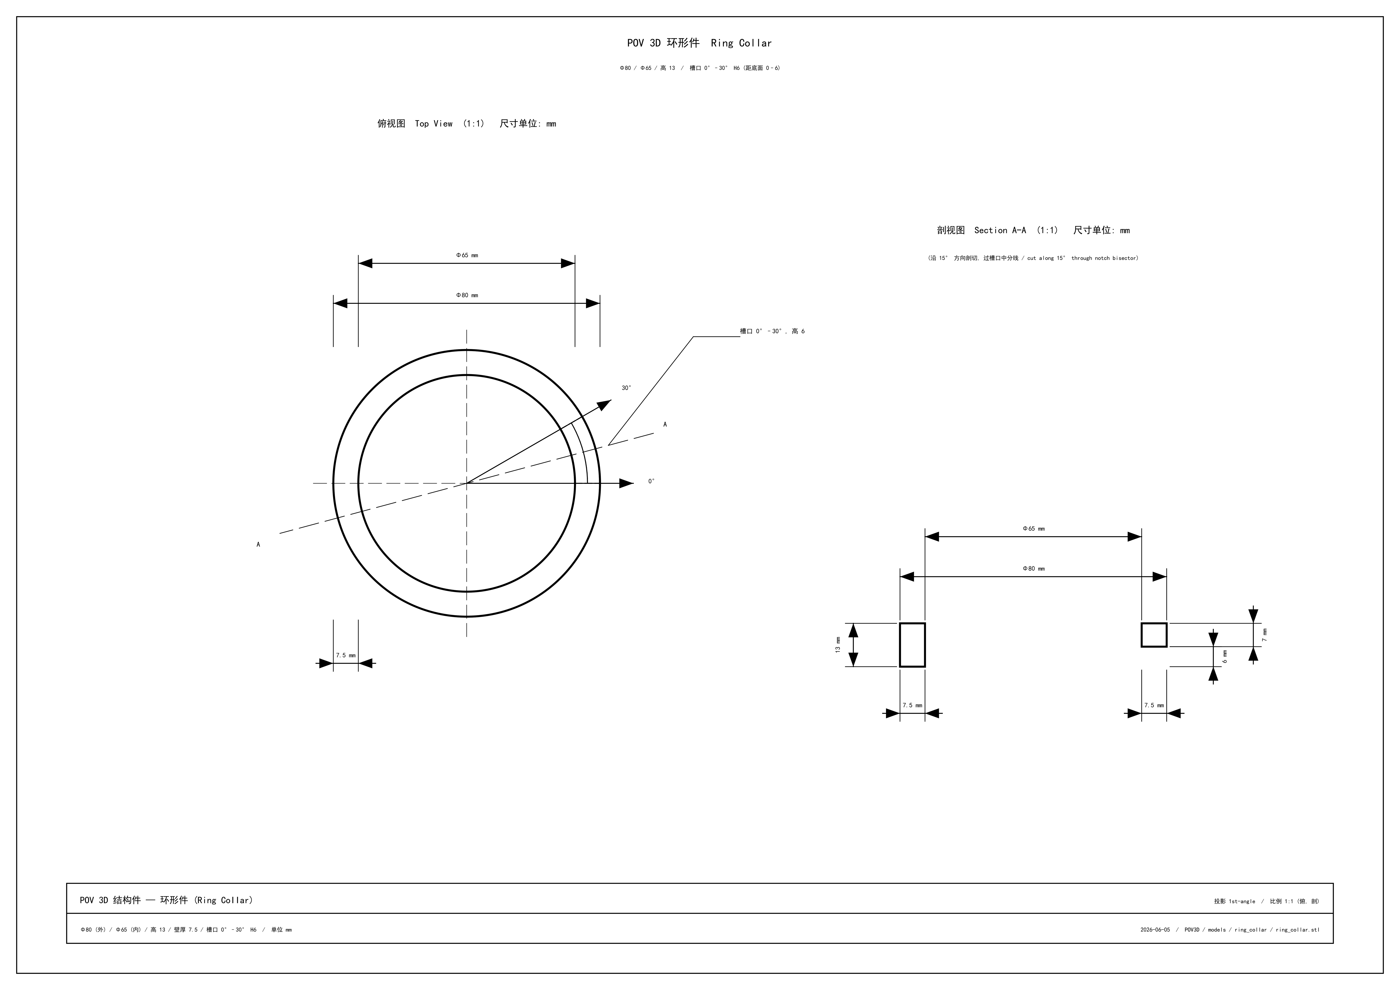
models/ring_collar/_v2_preview.png
