kiujkiu/macha/models/ring_collar/_v2_zoom.png

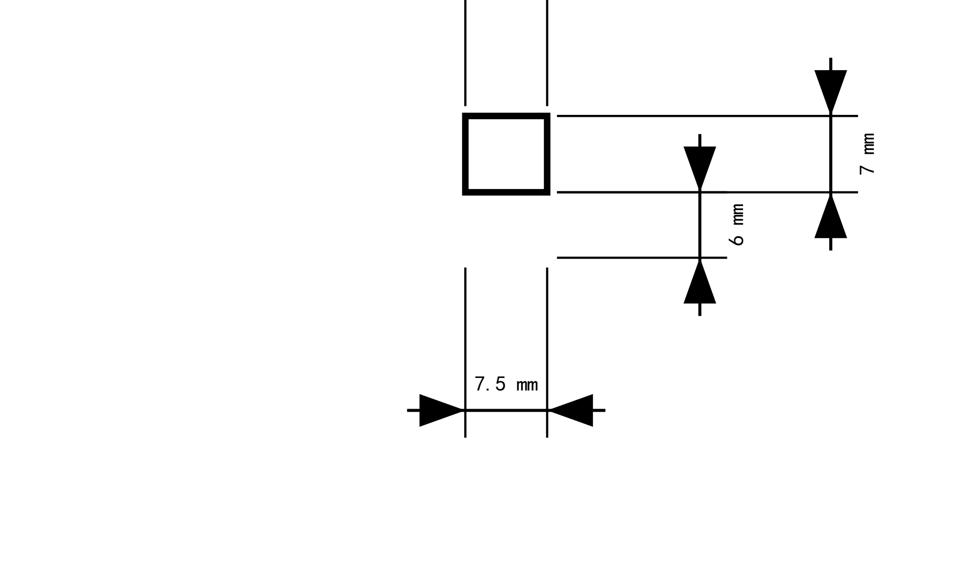
models/ring_collar/_v2_zoom.png
