kiujkiu/macha/models/ring_collar/_zoom_final.png

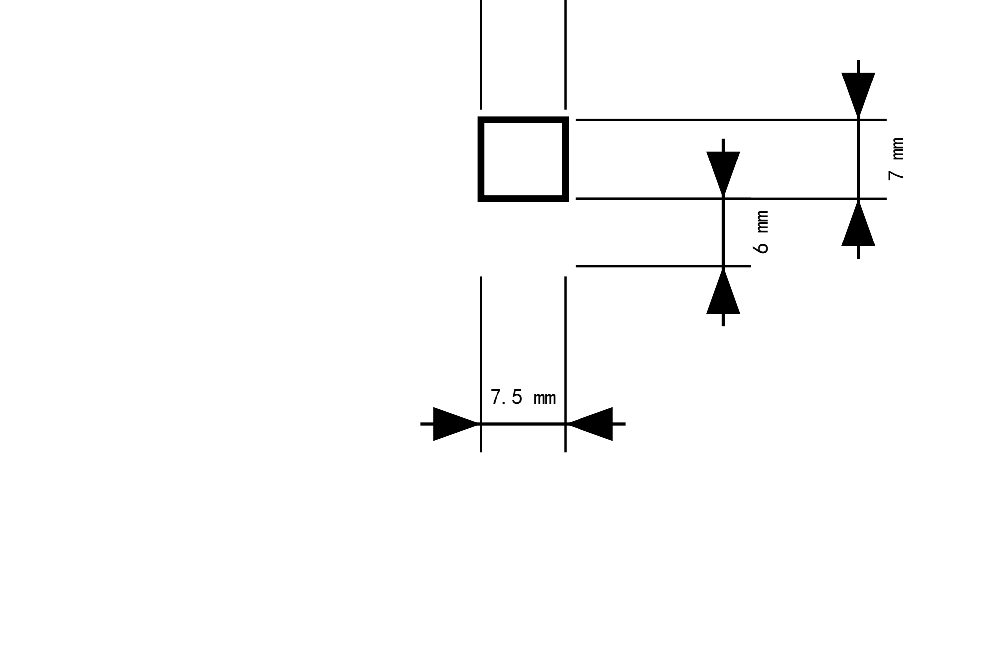
models/ring_collar/_zoom_final.png
