kiujkiu/macha/models/ring_collar/right_dims_zoom.png

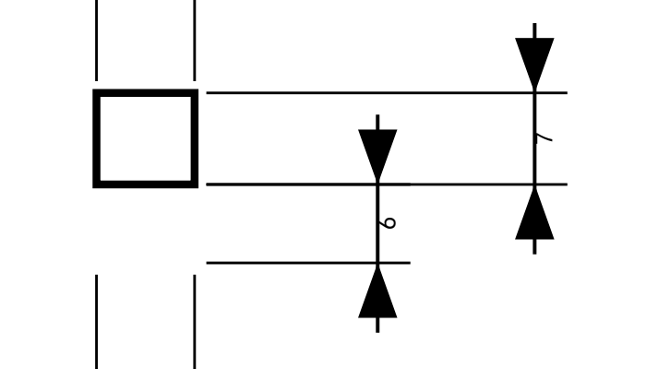
models/ring_collar/right_dims_zoom.png
