kiujkiu/macha/models/ring_collar/wall_75_zoom.png

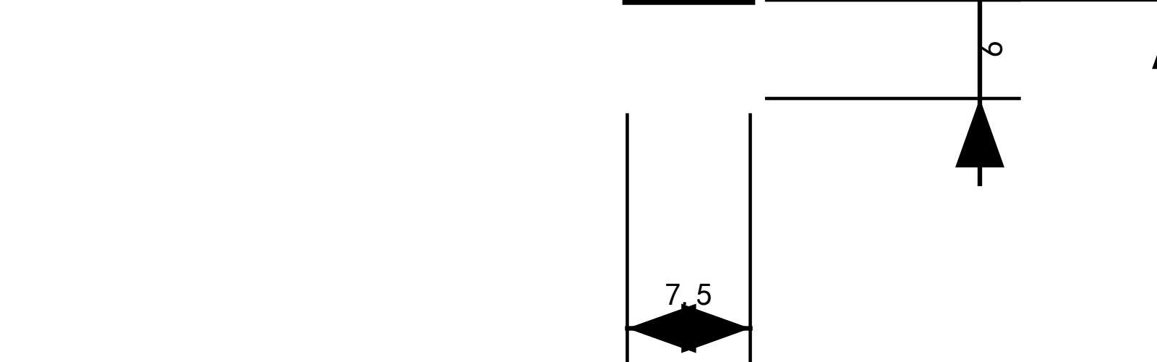
models/ring_collar/wall_75_zoom.png
