kiujkiu/macha/models/saddle_clamp_sq6/saddle_clamp_sq6_drawing_preview.png

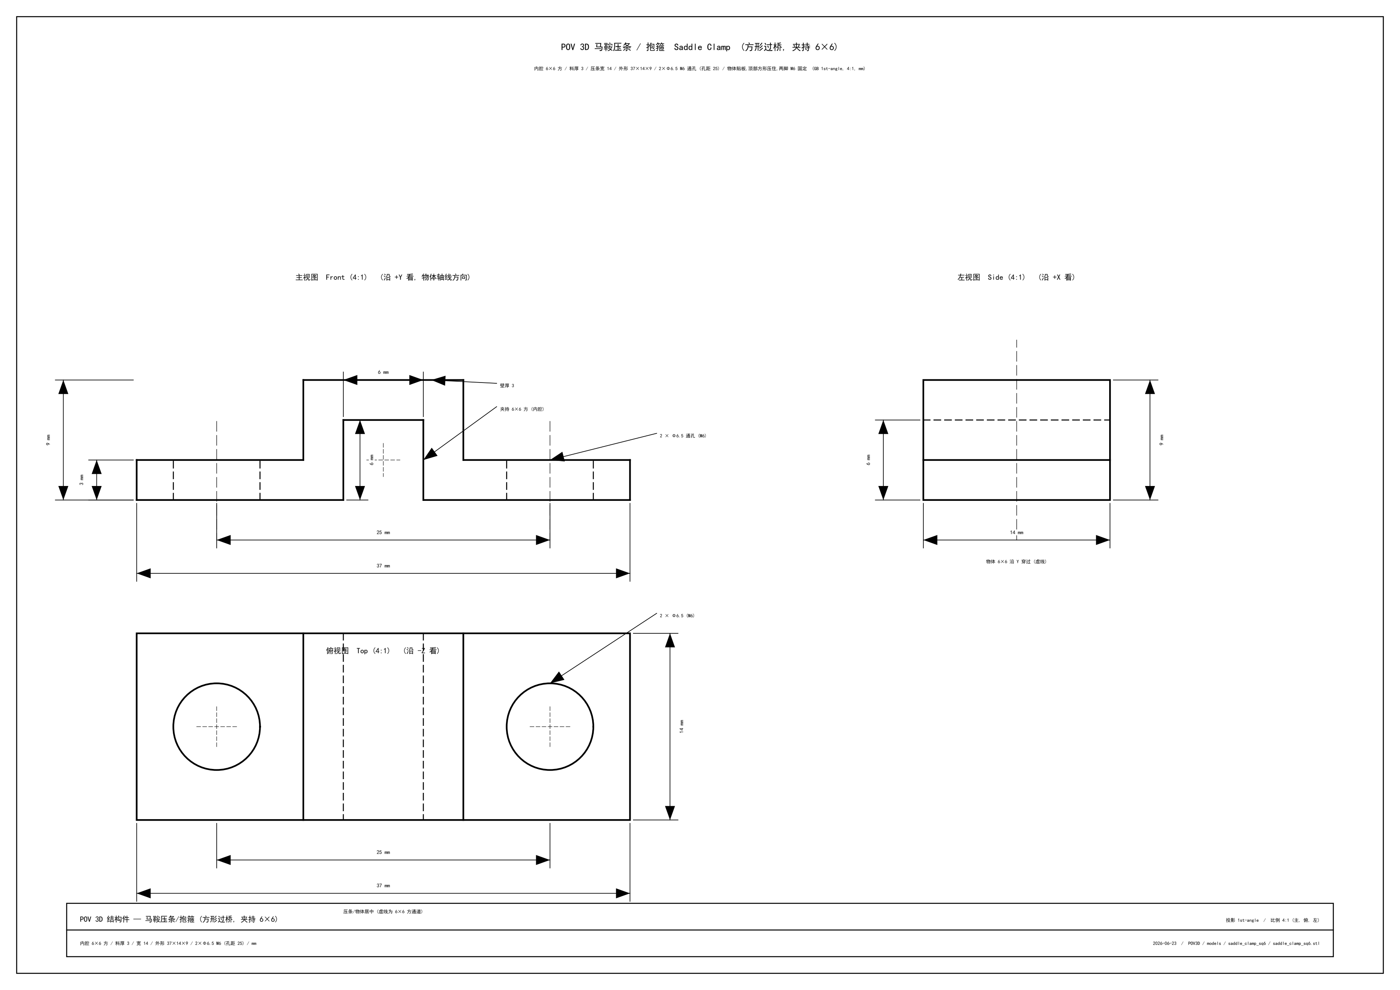
models/saddle_clamp_sq6/saddle_clamp_sq6_drawing_preview.png
