kiujkiu/macha/models/threaded_post_d50x70/threaded_post_d50x70_drawing_preview.png

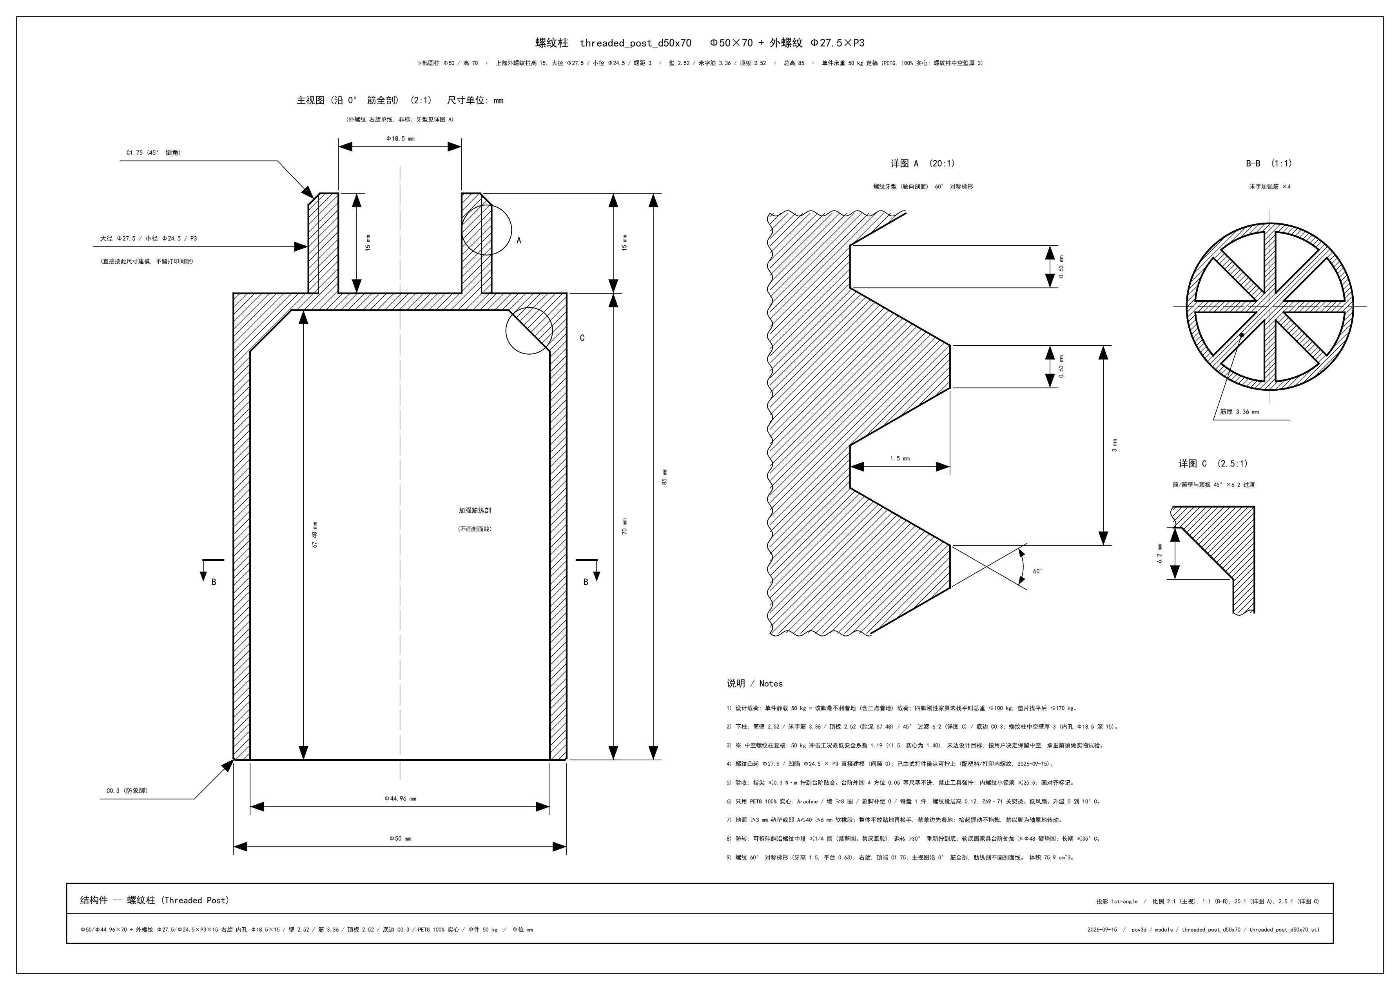
models/threaded_post_d50x70/threaded_post_d50x70_drawing_preview.png
