kiujkiu/macha/models/top_bearing/top_bearing_frame_drawing_preview.png

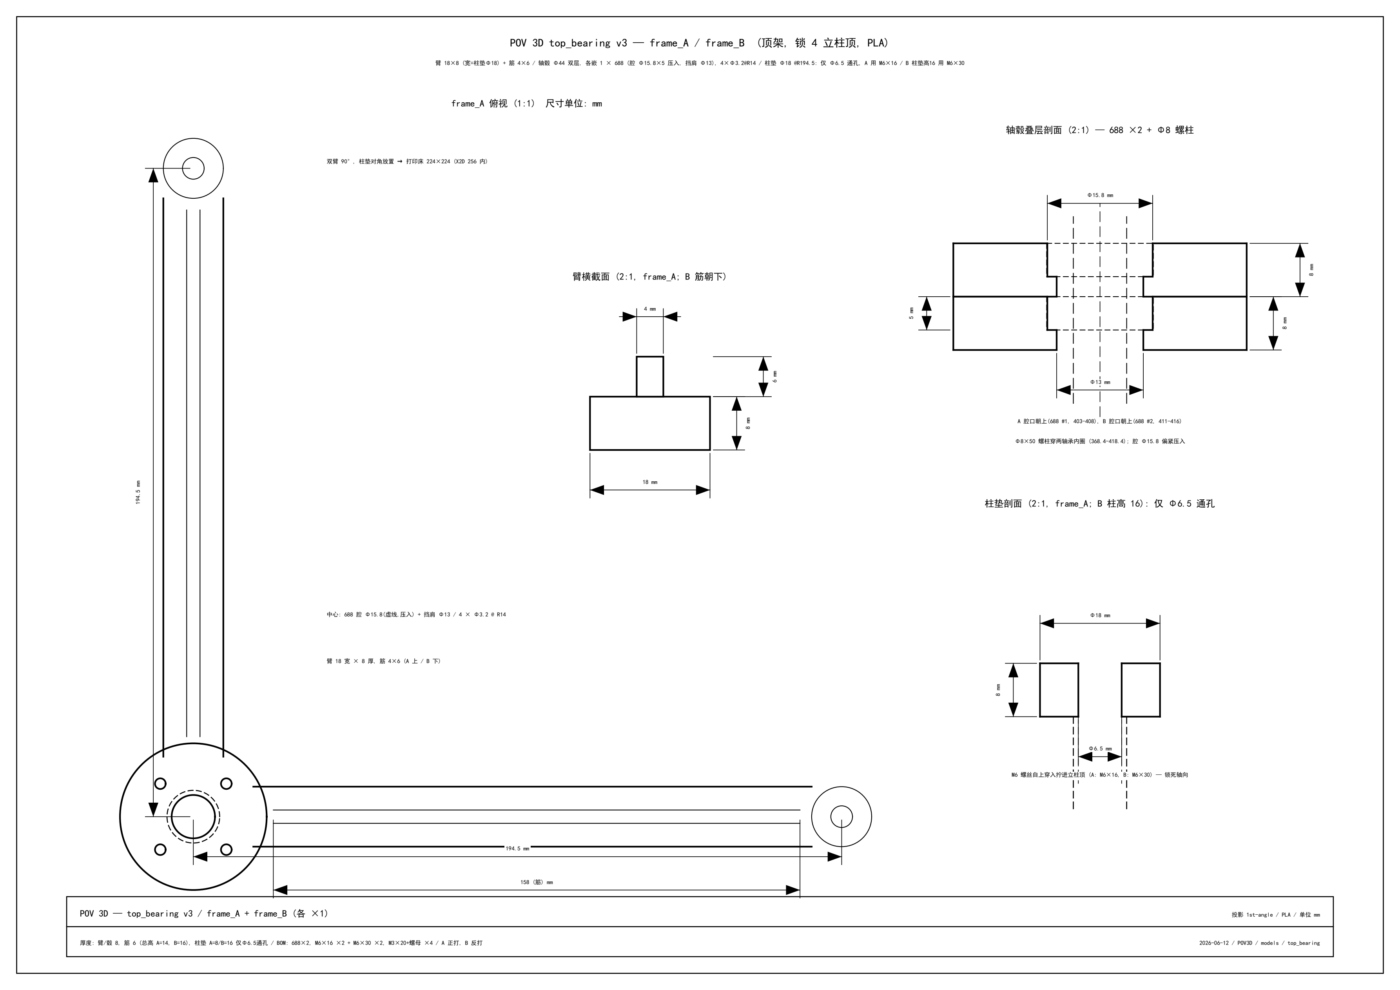
models/top_bearing/top_bearing_frame_drawing_preview.png
