kiujkiu/macha/models/usb_wifi/wifi_box_preview.png

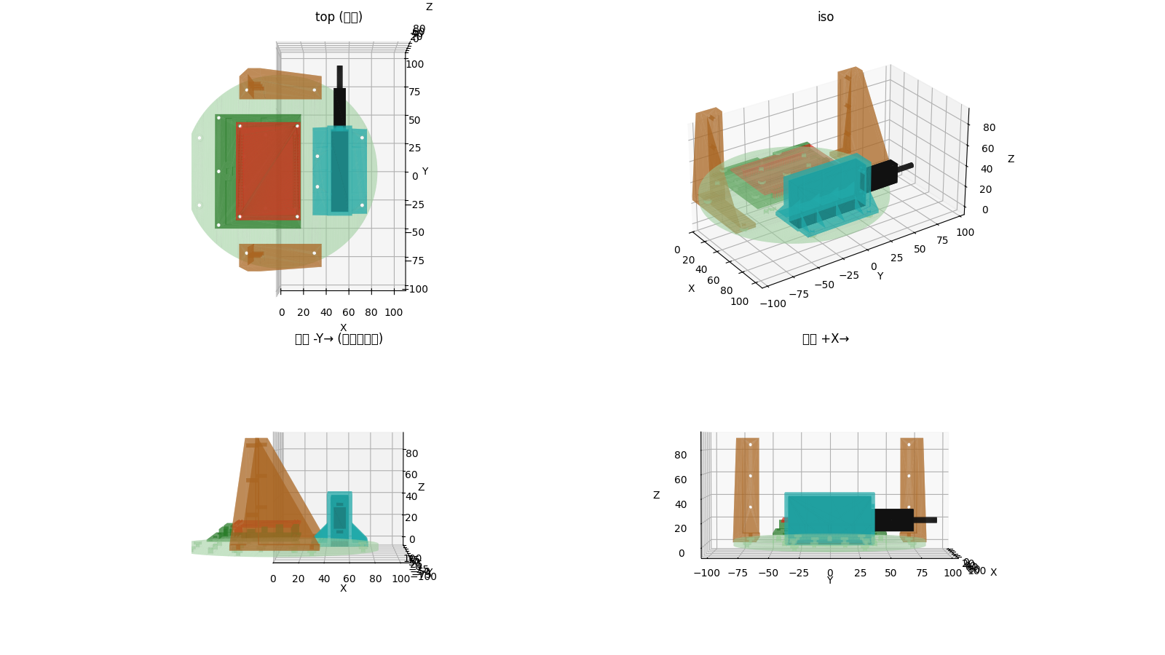
models/usb_wifi/wifi_box_preview.png
