kiujkiu/macha/models/usb_wifi/wifi_shell_drawing_preview.png

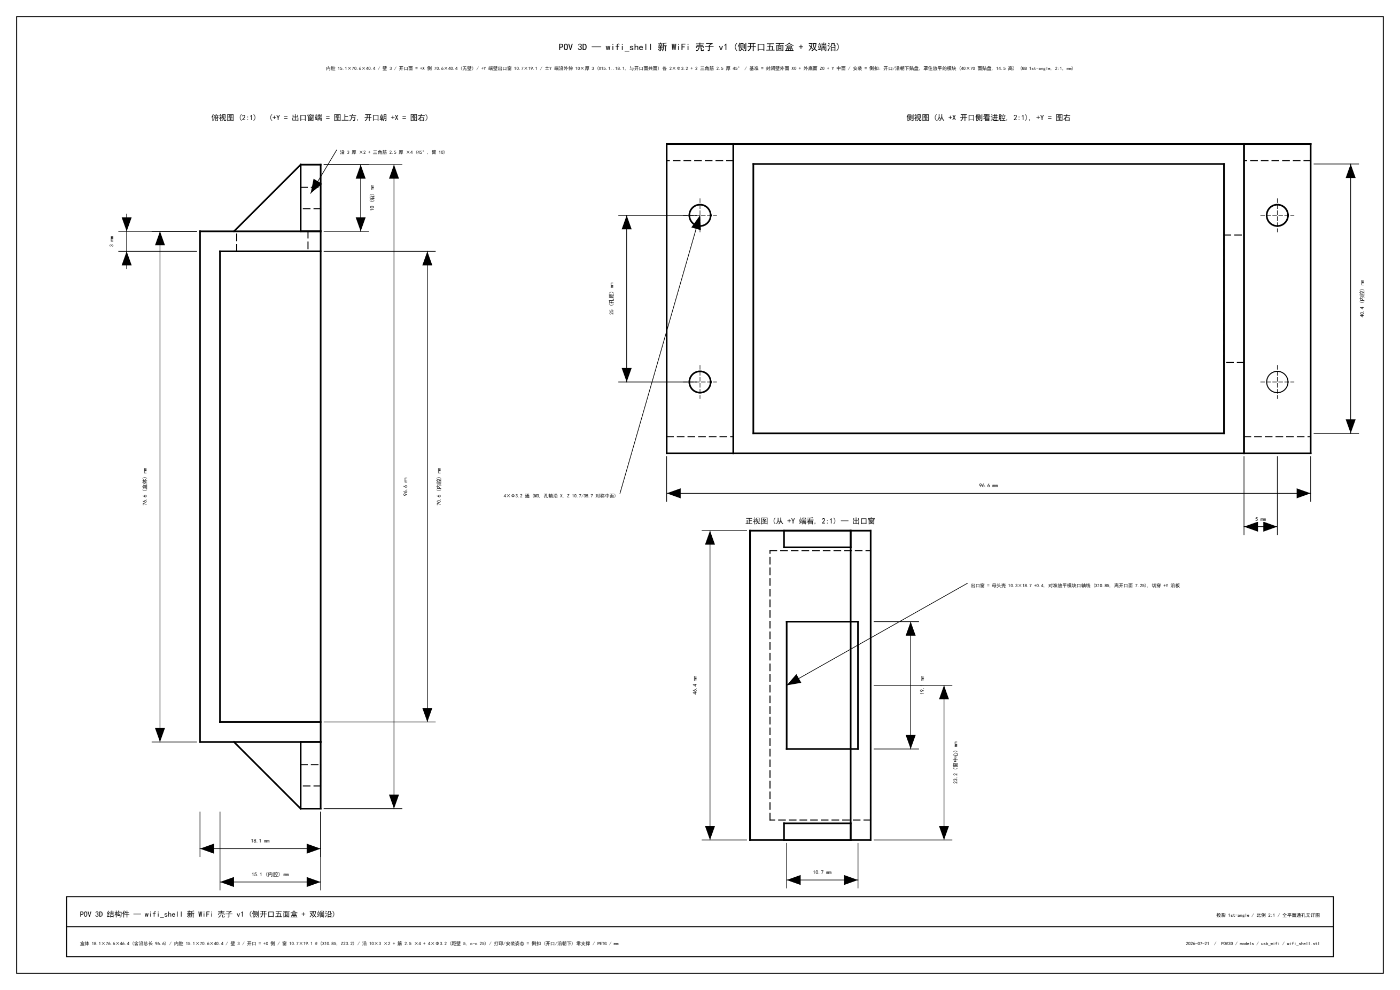
models/usb_wifi/wifi_shell_drawing_preview.png
