kiujkiu/macha/models/usb_wifi/wifi_shell_preview.png

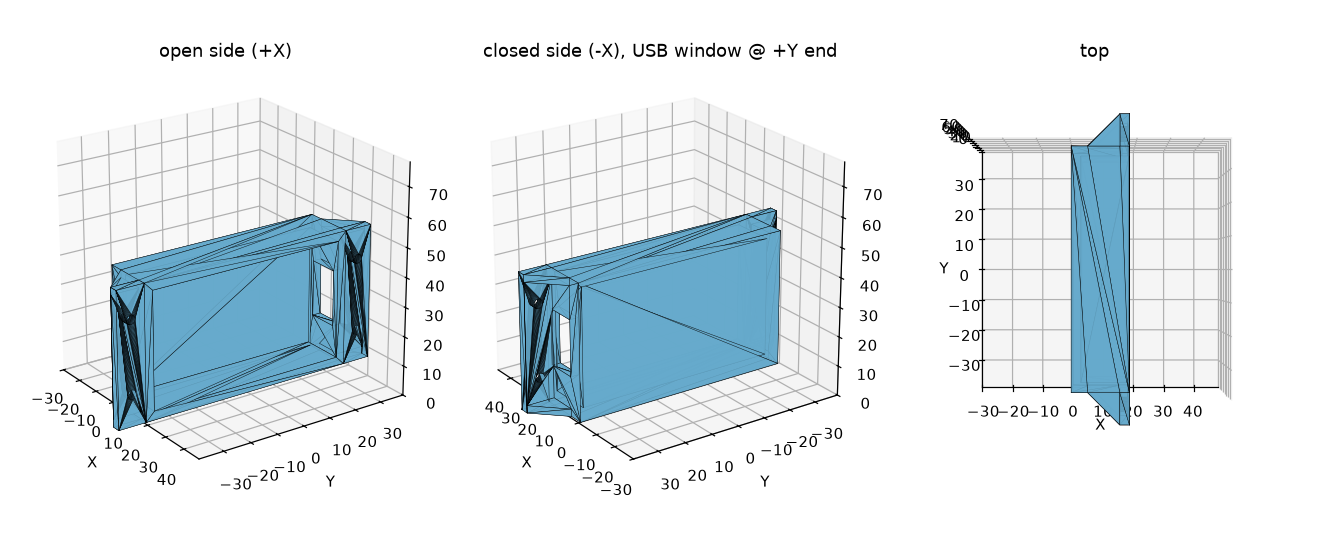
models/usb_wifi/wifi_shell_preview.png
