kiujkiu/macha/models/washer_m3_6p8x1p5/washer_m3_6p8x1p5_drawing_preview.png

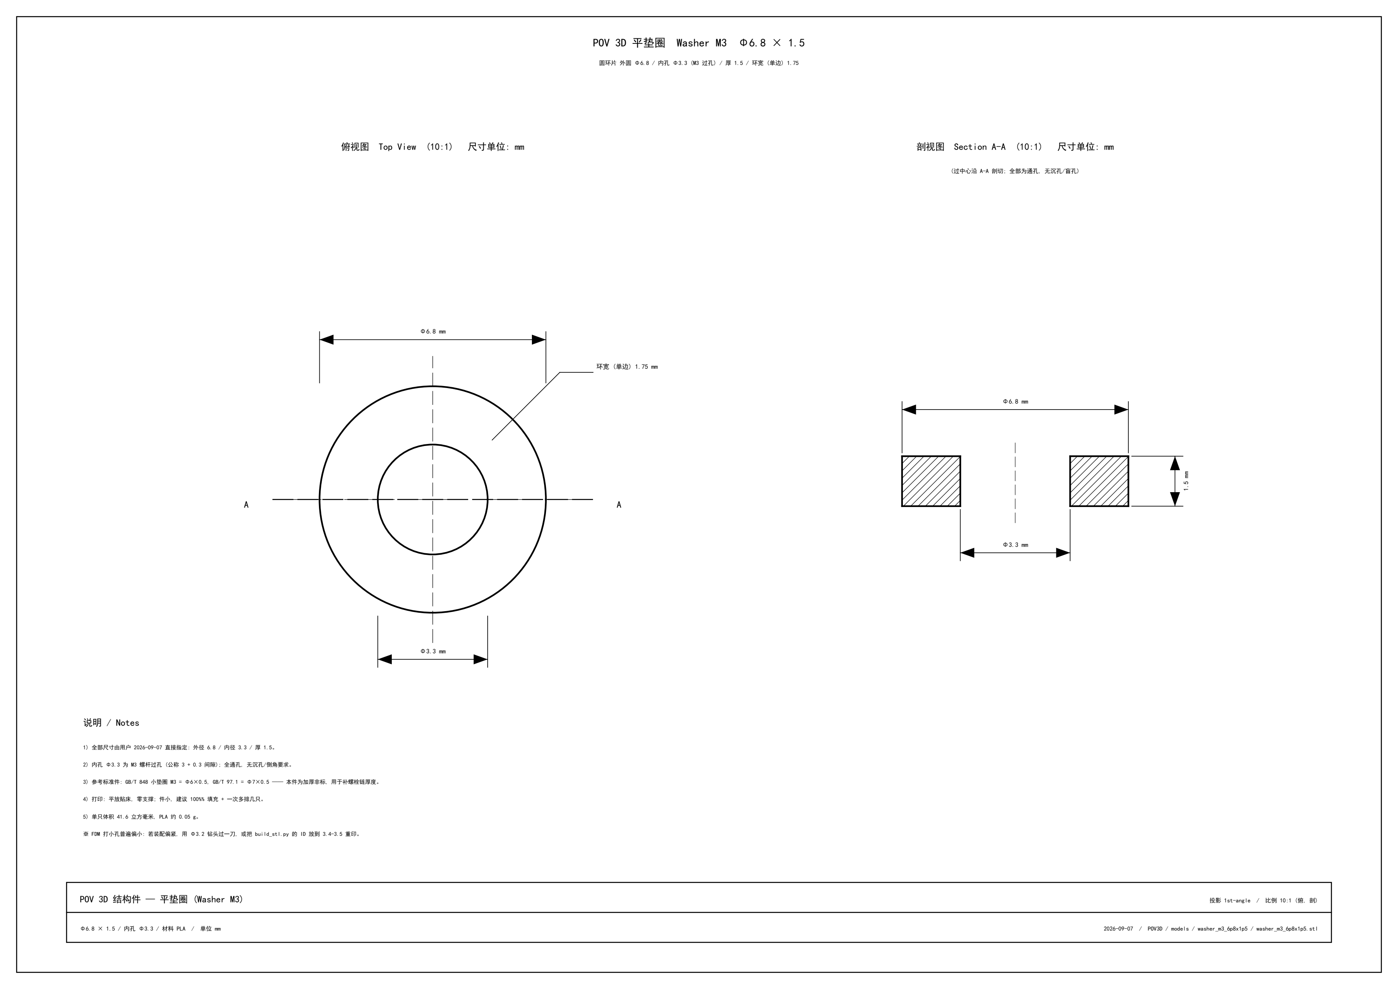
models/washer_m3_6p8x1p5/washer_m3_6p8x1p5_drawing_preview.png
