kiujkiu/macha/models/xt60_clamp_16p6x9p2x23p9/xt60_clamp_16p6x9p2x23p9_drawing_preview.png

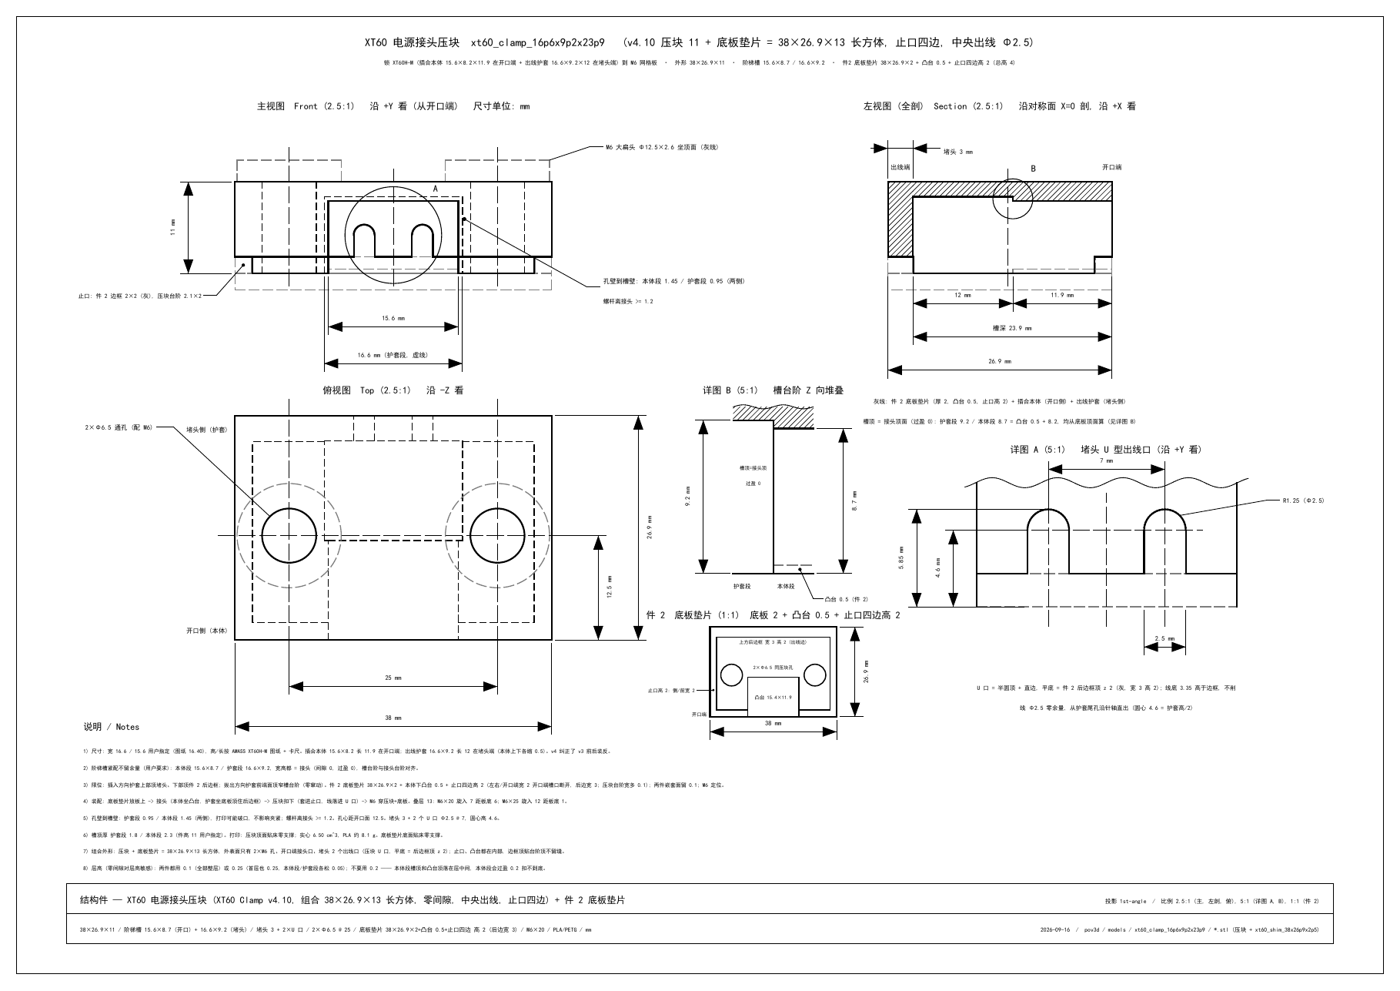
models/xt60_clamp_16p6x9p2x23p9/xt60_clamp_16p6x9p2x23p9_drawing_preview.png
