kiujkiu/macha/models/zynq_board/zynq_board_preview.png

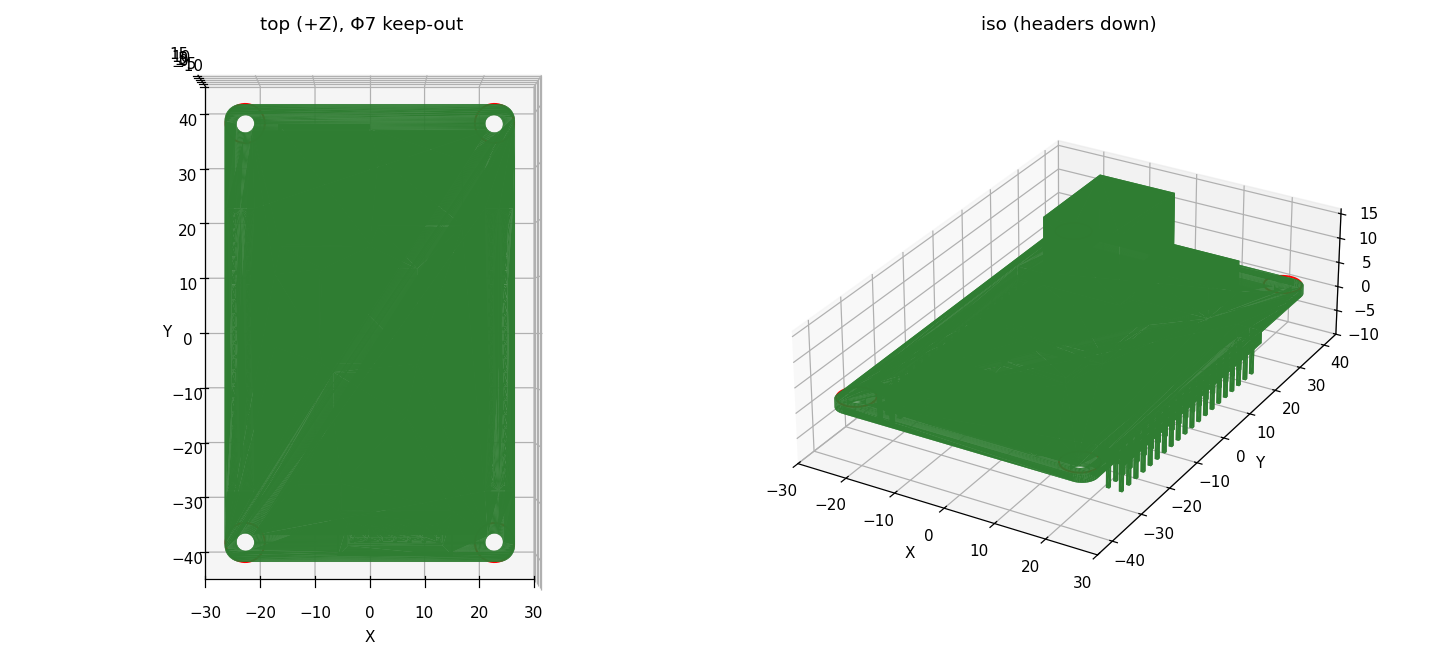
models/zynq_board/zynq_board_preview.png
