kiujkiu/macha/v4/models/motor_shim_v4/motor_shim_v4_drawing_preview.png

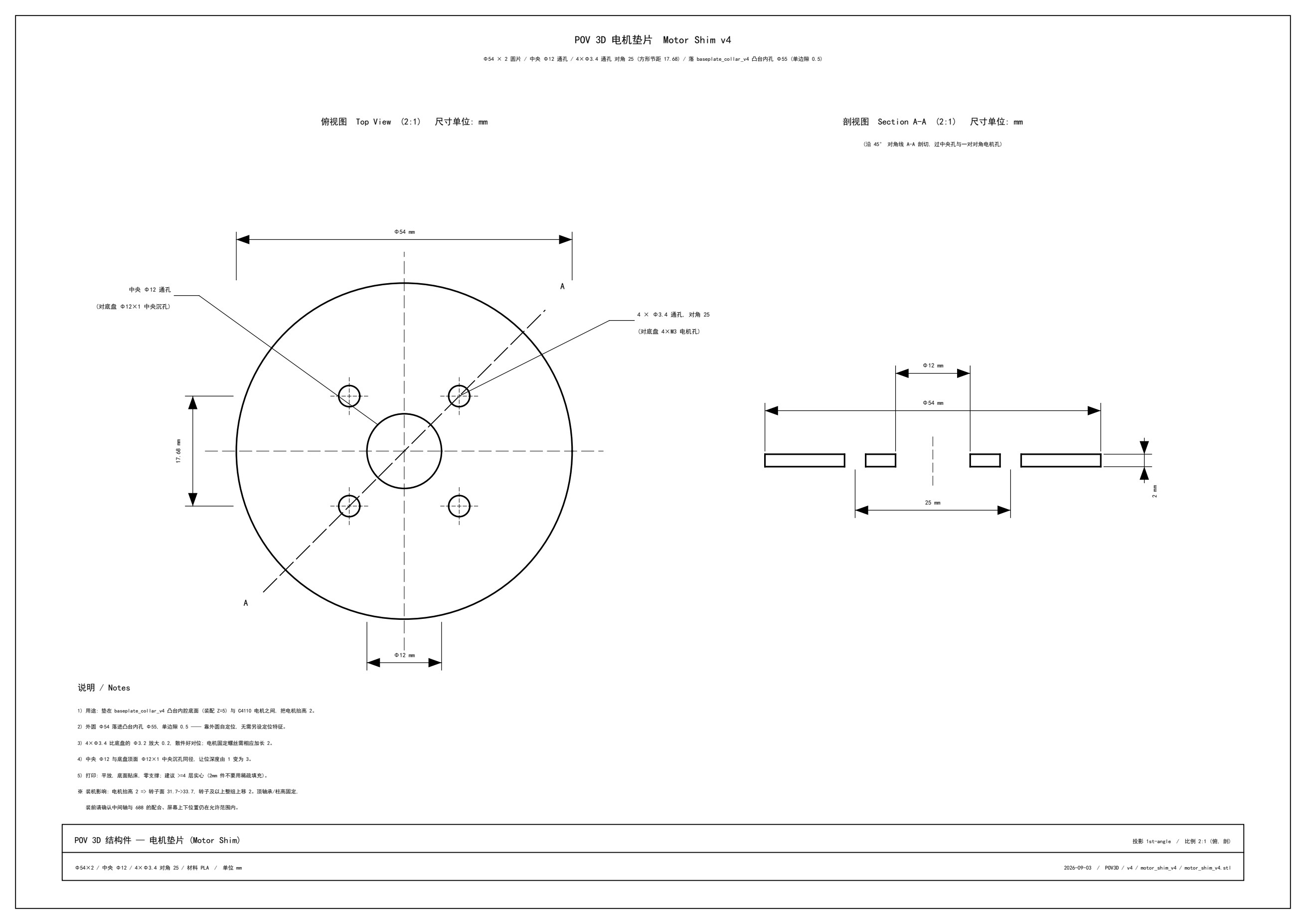
v4/models/motor_shim_v4/motor_shim_v4_drawing_preview.png
