kiujkiu/macha/v4/models/top_bearing_v4/frame_B_v4_drawing_preview.png

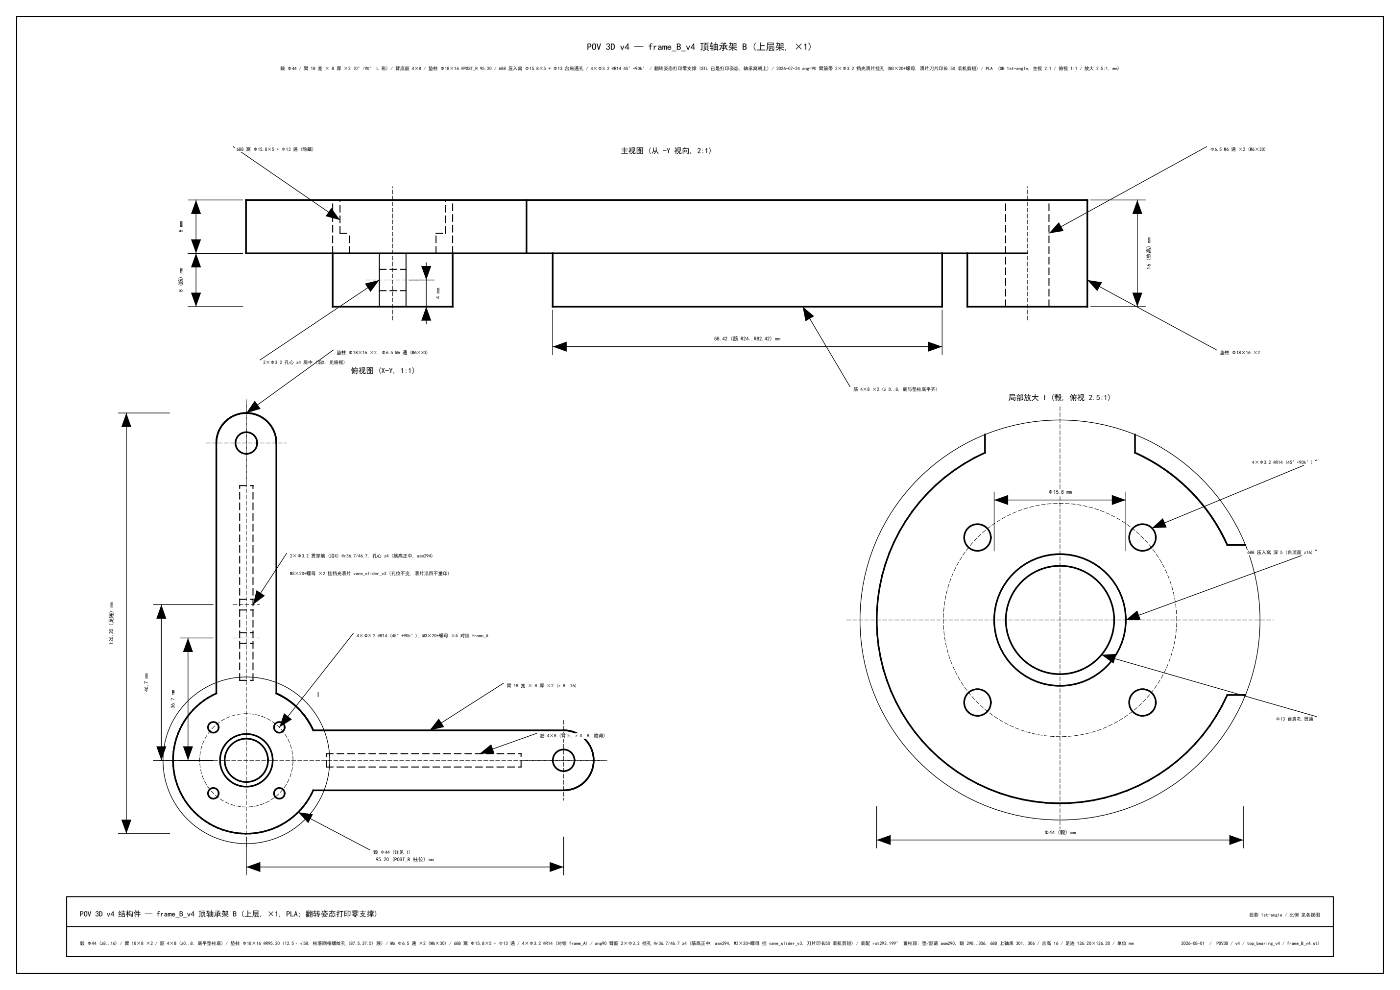
v4/models/top_bearing_v4/frame_B_v4_drawing_preview.png
