kiujkiu/macha/v1.2/BOM_紧固件_v1_2.md

# V1.2 紧固件采购清单 (2026-11-12 晚; 11-12 夜: 铜螺母统一 M3×4 / 孔 Φ4.2×4.2, 外圈 M3×5→M3×6, 定子盘底 Z9.5→8.5; 11-13 (二) 按键 L 形支架: 脚改 M3×12 + 法兰螺母; 11-13 (三) 支架前面平板: 按键板螺丝仍 M3×8, 沉孔加深); 11-14 玻璃下拆上下段: +8 M3×20 + 8 铜螺母

按用户 11-12 给的实物参数定: M3 螺丝全部为超薄头/家具头内六角 (头 Φ7×1.5, 2mm 六角); M3 螺母全部为法兰螺母 (法兰 Φ7.6, 对边 5.9, 厚 3.7, 不开窝直接压面)。
长度依据 `scripts/fasteners_v1_2.py` (按 build_v1_2 的变量放件, 出 `assembly_v1_2_整机+螺丝.3mf` 与干涉/啮合表)。Z = 装配高度, 底盘 Z-6..0。
建议采购量 = 每台 ×1.2 后取整到 10 (单台验证用)。同内容 Excel 版: `BOM_紧固件_v1_2.csv` (UTF-8 BOM)。

| 序号 | 名称规格 | 用在哪 | 每台数量 | 建议采购量 | 备注 |
|---|---|---|---|---|---|
| 2 | M3×6 超薄头内六角 (头 Φ7×1.5, 2mm 六角) | **外圈 8 孔 r79** (11-12 夜, 原 M3×5): 安装法兰顶 Φ7×1.5 沉孔往下 → 法兰盘底铜螺母 (上下盖互锁) | 8 | 10 | (11-13 控制板改 M3×10 从下往上, 见 3b) 外圈: 支承 Z14.5, 尾端 Z8.5 = 法兰盘底面齐平 (不露); 进 M3×4 铜螺母 4.0 吃满 (M3×8 会露出底面 2) |
| 3 | M3×8 超薄头内六角 (头 Φ7×1.5, 2mm 六角) | 电机 4 孔 (r23): 底盘底 Φ7×2 沉孔往上 → 电机底面螺孔 + **按键板 2 (11-13)**: 头埋进支架前面平板 Φ7.4×2.4 沉孔 (11-13 (三)), 往里 (沿 −Y) 穿平板 2.7 + 板 1.6 → 板背面法兰螺母 (按键支架脚 11-13 (二) 改 M3×12, 见 4) | 6 | 10 | 支承 Z-4, 尾端 Z4 = 进电机 4.0。**待按电机规格书确认螺孔深度**: 深 <4.5 改 M3×6 (进 2), 深 ≥6.5 可用 M3×10 (进 6); 按键板 (11-13 (三) 前面平板 5.1 厚, 仍 M3×8): 头 Φ7×1.5 埋平板沉孔 (支承 y103.3, 头顶 y104.8 低于平板前面 0.9), 尾端 y95.3, 法兰螺母 y99..95.3 吃满 3.7 (尖齐螺母端面; M3×10 尖 y93.3 露 2 也可) |
| 3b | **M3×10 超薄头内六角 (头 Φ7×1.5, 2mm 六角) — 新增采购** | **电机控制板 4 孔** (11-13): 底盘底 Φ7×2 沉孔往上 → 穿底盘+板 → 板顶 M3 法兰螺母 (Z1.6..5.3, 吃满 3.7, 尖 Z6 露 0.7); 线圈驱动板 **MOS 压块 mos_clamp_v1_2 2 孔** (11-12 夜 (二) 改铜螺母): 底盘底 Φ7×2 沉孔往上 → 穿底盘+压块 Φ3.4 → 压块顶面压入的 M3×4 铜螺母 | 6 | 10 | 支承 Z-4, 尾端 Z6 = 压块顶 6.0 (不冒头); 铜螺母 Z2..6 进 4.0 吃满。M3×8 尖 Z4 进 2 不够, M3×12 尖 Z8 会冒出压块顶 2 ⇒ 选 M3×10。也可作电机备用 (见 3) |
| 4 | M3×12 超薄头内六角 (头 Φ7×1.5, 2mm 六角) | 线圈环四角 4 孔 (±29.5): 底盘底 Φ7×2 沉孔往上 → 穿底盘+四角 (4.5 厚, 11-12 夜) → 法兰螺母; **电容卡件 cap_clamp_v1_2 2 孔** (11-12 夜 (二) 改铜螺母): 底盘底 Φ7×2 沉孔往上 → 穿底盘+卡件 Φ3.4 → 卡件顶面压入的 M3×4 铜螺母; **按键 L 形支架脚 2 (11-13 (二))**: 底盘底 Φ7×2 沉孔往上 → 穿底盘 + 脚 (4 厚) → 脚顶法兰螺母 | 8 | 10 | 线圈环角: 支承 Z-4, 尾端 Z8; 螺母 Z4.5..8.2 (11-12 夜角厚 5→4.5) 吃进 3.5 (尾端低于螺母顶 0.2); 尾端离法兰盘底 Z8.5 还有 0.5, 螺母顶离 0.3。M3×14 尾端 Z10 会顶法兰盘, 不能用。电容卡件: 支承 Z-4, 尾端 Z8; 铜螺母 Z4.35..8.35 (顶齐卡件顶 8.35) 进 3.65, 尾端低于卡件顶 0.35; 尖离定子盘底 (法兰盘加厚后 Z8.5) 0.5 (以生成器 screw_len / insert_z0 为准)。按键支架脚: 支承 Z-4, 尾端 Z8; 法兰螺母 Z4..7.7 (坐脚顶) 吃满 3.7, 露 0.3 (M3×10 尖 Z6 只进 2) |
| 5 | M3×14 超薄头内六角 (头 Φ7×1.5, 2mm 六角) | 下罩三角块 4 孔 (r86.8): 底盘底 Φ7×2 沉孔往上 → 穿底盘+三角块 (5 厚) → 法兰螺母 | 4 | 10 | 支承 Z-4, 尾端 Z10 (穿出螺母顶 1.3, 螺母全长 3.7 吃满); 上方最近件为转子盘 Z21.5 (11.5); 外裙 r82.5–85 与杆 r85.3–88.3 不重叠 |
| 6 | M3×20 超薄头内六角 (头 Φ7×1.5, 2mm 六角) | 中央 8 孔 r35.2: 安装法兰顶 Φ7×1.5 沉孔往下 → 穿安装法兰/法兰盘/线圈环/底盘 → 底盘 G 铜螺母; **XT60 压块 2 孔** (11-12 晚, 原 M6×20): 底盘底 Φ13×3 沉孔 (11-12 已打印底盘原样, V1.2-g) + M3 大垫片 Φ9×0.8 往上 → 穿底盘+底垫+压块 (叠高 13) → 法兰螺母 | 10 | 20 | 中央: 支承 Z14.5, 尾端 Z-5.5 (缩进底面 0.5); 进铜螺母 3.5。M3×20 是上限 (20.5)。XT60 (V1.2-g): 垫片 Z−3.8..−3, 支承 Z−3.8, 尾端 Z16.2; 螺母 Z13..16.7 (11-12 晚 (二) 压块顶螺母座取消, 直接坐压块顶) 啮合 3.2 (尾端低于螺母顶 0.5); 离下罩 Φ8.2 井顶 Z17.5 还有 1.3。玻璃下: 支承 Z48.3, 尾端 Z28.3, 铜螺母 Z28..32 进 3.7 (尾端离孔底 0.5); 头顶 Z49.8, 被玻璃端面 + 外卡环盖住 |
| 6c | **M3×50 超薄头内六角 (头 Φ7×1.5, 2mm 六角) — 新增采购** | **玻璃下 上段↔下段 8 孔 r98.5 (11-14 二, 穿通夹持)**: 上段顶面 (玻璃座) Φ7 沉孔深 2 往下 → 穿上段+下段 → 下段底面 Φ8.2×4 沉孔里 M3 法兰螺母 | 8 | 10 | 支承 Z51.08, 尾 Z1.08, 法兰螺母 Z0.3..4.0 (底面缩进 0.3) 啮合 2.92, 下段底面平; 头顶 Z52.58 (玻璃底下 0.5) 被玻璃端面 + 外卡环盖住。超薄头 50 长不好买可换普通 Φ7 平头/大扁头 (头高 ≤3) |
| 7 | M3 法兰螺母 (法兰 Φ7.6, 对边 5.9, 厚 3.7) | 线圈环四角 4 + 下罩三角块 4 + XT60 压块顶 2 + 电机控制板板顶 4 (11-13) + 按键板背面 2 (11-13) + **按键支架脚顶 2 (11-13 (二))** + **玻璃下下段底面 8 (11-14 二, 法兰朝上顶 Φ8.2 孔顶)** | 26 | 40 | 法兰朝下直接压面, 不开窝 (XT60 压块顶螺母座 11-12 晚已取消)。MOS 压块 / 电容卡件 11-12 夜 (二) 改铜螺母 (见 8), 不再用法兰螺母。线圈环四角 4 颗原会顶到 Φ77 圆台, 已按方案 a 在圆台四角切 Φ8.2 让位 (11-12); 按键板: 法兰贴板背面 (板上孔周 Φ8 背面禁布) |
| 8 | M3 铜花螺母 (压入/热熔) 外径 ≈4.2 长 4 (**全机统一, 11-12 夜**) | 底盘底面 G 8 (中央) (H 4 控制板 11-13 取消, 改螺丝从下往上 + 法兰螺母); 法兰盘底面 B 8 (外圈 r79, 原 M3×3); **MOS 压块 2 + 电容卡件 2** (11-12 夜 (二)); 孔全部 Φ4.2×4.2; (按键支架脚 2 11-13 (二) 改 L 形 + 法兰螺母, 取消) | 20 | 30 | 底盘: 从底面压, 与底面齐平 (Z-6..-2), 顶上留 0.2。法兰盘: 从底面压, 齐平 (Z8.5..12.5), 顶留 0.2, 外墙孔顶剩 0.8。MOS 压块 / 电容卡件: 从件顶面压, 顶齐件顶, 孔底留 0.2 (MOS Z2..6, 电容 Z4.35..8.35) |
| 6b | M3 大垫片 Φ3.2×Φ9×0.8 (DIN 9021 / GB/T 96) | **仅 11-12 已打印旧底盘**: XT60 压块 2 孔, 垫在 Φ13×3 沉孔顶, M3×20 头下 | 0 (旧盘 2) | 10 | 旧盘 XT60 孔是 M6 Φ6.4, 超薄头 Φ7 会从孔里过, 必须垫; 新底盘 (11-13 晚起) 改标准 M3 Φ3.2 + Φ7×2 沉孔, 不用 |
| 10 | 【待确认】立柱固定: M6×10 大扁头内六角 (头 Φ12.5×2.5) 或 M6 螺母+垫片 | 4 根 Φ8×360 金属立柱 (POSTS, 底盘 A 组 M6 孔 Φ6.4 + 底面 Φ13×3 沉孔) | 4 | 10 | V1.0 清单写的是"坐网格 M6 螺纹孔, M6 双头螺柱"; V1.2 底盘是打印件无螺纹。立柱底端若是 M6 内螺纹 → M6×10 从底往上 (支承 Z-3, 进立柱 7); 若是 M6 外螺纹/双头螺柱 → 底面沉孔里上 M6 螺母+垫片。待用户看实物 |

**转子侧** (hub_disc / rim_ring / 屏幕底座 / 顶盖 / WiFi / 顶轴承架 / 光电 / 顶部转轴) 的螺丝沿用 V1.0, 不在本清单范围, 见 `../v1.0/print/README.md` 的"五金"表。

## 每处支承面 / 尾端 / 啮合 (fasteners_v1_2.py 实测)

| 处 | 数量 | 方向 | 支承面 Z | 尾端 Z | 啮合 | 尾端前方最近件 | 头外侧最近件 |
|---|---|---|---|---|---|---|---|
| 电机 M3×8 | 4 | ↑ | -4 (沉孔 Φ7×2 底) | 4 | 进电机螺孔 4.0 (预期重叠 28.3 mm³/颗) | 电机螺孔底 (深度未知) | 无 (头底 Z-5.5, 缩进底面 0.5) |
| 线圈环角 M3×12 | 4 | ↑ | -4 | 8 | 法兰螺母 Z4.5..8.2, 3.5 / 3.7 | 法兰盘底 Z8.5, 距 0.5 | 无 |
| 下罩 M3×14 | 4 | ↑ | -4 | 10 | 法兰螺母 3.7 (吃满, 穿出 1.3) | 转子承载盘/毂盘, 距 11.5 | 无 |
| 中央 M3×20 | 8 | ↓ | 14.5 (安装法兰沉孔底) | -5.5 | 铜螺母 3.5 | 无 (缩进底盘底面 0.5) | 转子毂盘底 Z21.5, 距 5.5 |
| 上下盖 M3×6 | 8 | ↓ | 14.5 | 8.5 | 铜螺母 M3×4 Z8.5..12.5, 4.0 (吃满) | 控制板 2.65 (#1) / 6.91 (#2) / 底盘 8.5 (其余) | 转子毂盘, 距 5.5 |
| 控制板 M3×10 (11-13) | 4 | ↑ | -4 (沉孔 Φ7×2 底) | 6 | 法兰螺母 Z1.6..5.3 (坐板顶), 3.7 吃满 | 法兰盘底 Z8.5 | 无 |
| XT60 M3×20 | 2 | ↑ | -4 (新底盘 Φ7×2 沉孔; 旧打印盘 −3.8 加垫片) | 16 | 法兰螺母 3.0 (坐压块顶 Z13; 尾端低于螺母顶 0.7) | 下罩 Φ8.2 井顶 Z17.5, 距 1.5 | 无 |
| MOS 压块 M3×10 | 2 | ↑ | -4 (沉孔 Φ7×2 底) | 6 | 铜螺母 Z2..6 (顶齐压块顶), 4.0 吃满 | 定子盘底 Z8.5 (法兰盘加厚后), 距 2.5 (尖齐压块顶) | 无 |
| 电容卡件 M3×12 | 2 | ↑ | -4 (沉孔 Φ7×2 底) | 8 | 铜螺母 Z4.35..8.35 (顶齐卡件顶), 3.65 | 定子盘底 Z8.5 (法兰盘加厚后), 距 0.5 (低于卡件顶 0.35) | 无 |
| 按键支架脚 M3×12 (11-13 (二) L 形) | 2 | ↑ | -4 (沉孔 Φ7×2 底) | 8 | 法兰螺母 Z4..7.7 (坐脚顶), 3.7 吃满 (露 0.3) | 下罩让位腔顶 Z8.3 (空腔) | 无 |
| 按键板 M3×8 (11-13 (三) 前面平板) | 2 | −Y (由外往里) | y103.3 (平板前面 Φ7.4×2.4 沉孔底) | y95.3 | 法兰螺母 y99..95.3 (板背面), 3.7 吃满 (尖齐螺母端面) | 下罩让位腔背面 y92.7 | 下罩前皮 (腔前面 y106.0, 距头顶 1.2) |
| 玻璃下上下段 M3×50 (11-14 四, 穿通) | 8 | ↓ | 51.08 (上段 Φ7 沉孔深 2 底) | 1.08 | 法兰螺母 Z0.3..4.0 (下段底面 Φ8.2×4 孔, 法兰朝上), 2.92 | 底盘顶 Z0, 距 1.08 | 玻璃端面 Z53.08, 头顶距 3.3 |

## 干涉 (紧固件 ↔ 零件 共用体积 >0.01 mm³)

- 杆穿 Φ3.2 孔、头落沉孔、螺母压面、铜螺母进 Φ4.2 孔: 全部 0 (MOS 压块 / 电容卡件铜螺母按名义 Φ4.2 进 Φ4.2 孔)。
- 预期: 电机 M3×8 ↔ 电机占位件 28.274 mm³/颗 = Φ3 × 4 进螺纹 (啮合, 不是干涉)。
- **异常: 线圈环四角法兰螺母 ↔ 线圈环 1.547 mm³/颗 (×4)**。角孔心 r41.72, 法兰 Φ7.6 内缘到 r37.92, 六角外接内侧到 r38.31, 而 Φ77 圆台 (r38.5 以内高到 Z9.5) ⇒ 法兰径向吃进圆台 **0.58**, 六角角吃进 ≤0.19 (Z5..8.7 段)。**已处理 (11-12 方案 a)**: 圆台四角切 Φ8.2 让位后重跑, 共用体积 0。
- 头 Φ7 落 Φ7 沉孔 (底盘底面 12 个 Φ7×2、安装法兰顶 16 个 Φ7×1.5) 径向间隙为 0: 按用户要求照做; 打印孔通常偏小 0.1–0.2, 头可能进不去, 实测不行再扩到 Φ7.3。
- 下罩法兰螺母外缘 r90.6, 离墙内面 r90.8 只有 **0.2**; 内缘 r83.0 在安装法兰外裙 r82.5–85 正下方, 螺母顶 Z8.7 离外裙底 Z9.5 竖向 0.8。

## 需要的工具

- 2 mm 内六角扳手 (全部 M3 超薄头); 4 mm 内六角扳手 (立柱若用 M6 大扁头, 按实物); M3 法兰螺母对边 5.9 → **6 mm 扳手/套筒** (XT60 压块顶 2 颗在下罩装上前拧)
- 烙铁 + 热熔头 (若用热熔铜螺母), 或台钳压入 (压入款)

## 待确认

1. ~~**线圈环四角法兰螺母撞 Φ77 圆台 (0.58)**~~ — **已定方案 a (用户 11-12), 已改模型: 圆台四角切 Φ8.2 让位 (Z5→9.5), 重跑共用体积 0**。原可选: (a) 圆台在四角各切一个 Φ8.2 让位缺口 (Z5 起到 Z9.5, 只削 r37.6–38.5 一条月牙, 不影响托法兰盘) — 改动最小, 推荐; (b) 角孔外移到 RING_M3_XY ≥29.9 (r42.3, 零间隙) / 30.1 (留 0.3) — 但底盘该孔 Φ7 沉孔离 (±37.5,±37.5) 的 M6 沉孔壁厚会从 1.31 降到 0.75/0.47, 不过 build 里 ≥1.0 的 assert, 要同时取消这 4 个网格 M6 孔; (c) 这 4 颗改普通 M3 六角螺母 (对边 5.5, 外接 6.35 → 内缘 r38.54, 刚好贴边) 加平垫。
2. **电机底面螺孔深度** (按规格书): 定 M3×6 / ×8 / ×10。
3. **立柱怎么锁** (序号 10): 立柱底端是内螺纹还是外螺纹/双头螺柱; 立柱长度 360 → ≈349.8 或顶轴承架下移 10.2 也还没定 (README 待定项)。
4. 铜螺母外径: 按孔 Φ4.2 选外径 ≈4.2 的压入款; 若买热熔款 (常见外径 4.5–5.0) 孔要按商家建议改。
5. M6 大扁头的六角规格 (只剩立柱可能用到; 4 mm 为常见, 以实物为准)。XT60 已于 11-12 晚改 M3, 不再用 M6。
