kiujkiu/macha/assembly_stack.stl

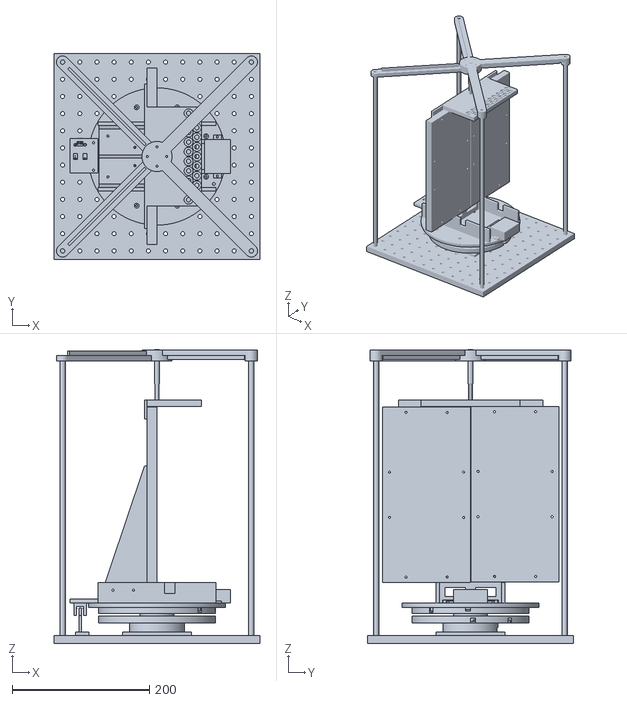
[picture p88: CAD file, 2026-07-15]
assembly_stack.stl
300.0 x 300.0 x 428.4
