kiujkiu/macha/models/baseplate/baseplate.stl

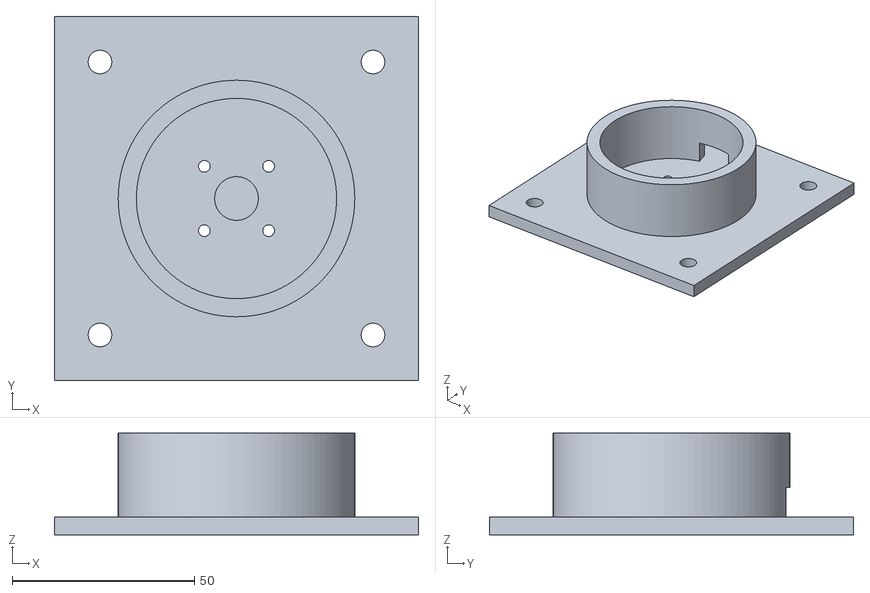
[picture p89: CAD file, 2026-06-10]
models/baseplate/baseplate.stl
100.0 x 100.0 x 28.0
