kiujkiu/macha/models/baseplate_collar/baseplate_collar.stl

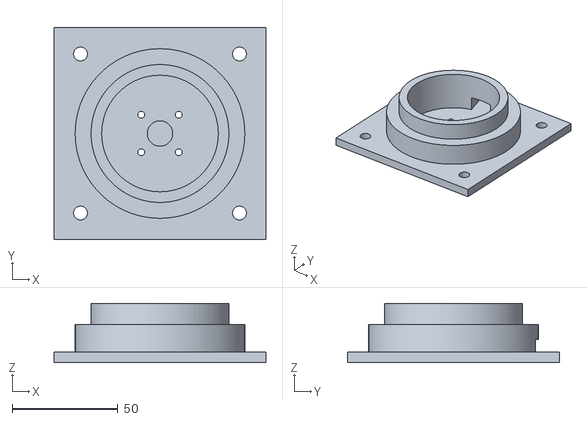
[picture p90: CAD file, 2026-06-10]
models/baseplate_collar/baseplate_collar.stl
100.0 x 100.0 x 28.0
