kiujkiu/macha/models/baseplate_collar_d100/baseplate_collar_d100.stl

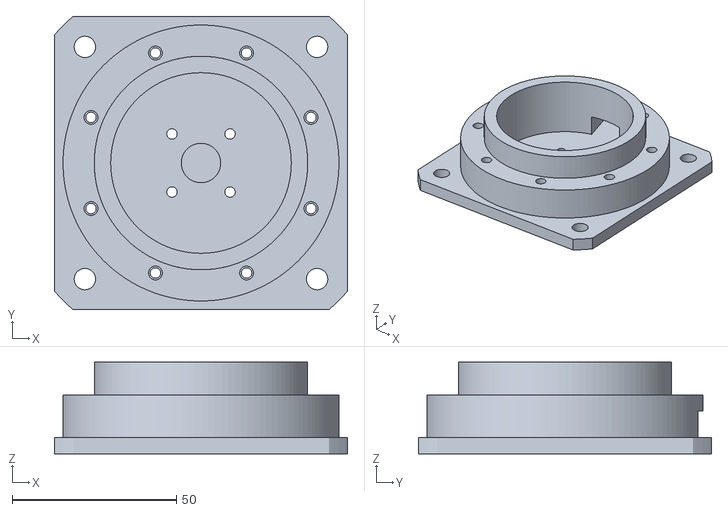
[picture p91: CAD file, 2026-08-19]
models/baseplate_collar_d100/baseplate_collar_d100.stl
89.2 x 89.2 x 28.0
