kiujkiu/macha/models/box_22x24x64/box_22x24x64.stl

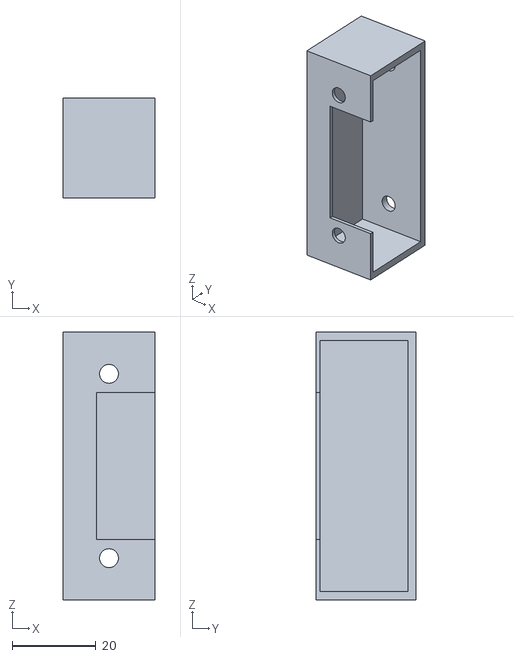
[picture p92: CAD file, 2026-06-23]
models/box_22x24x64/box_22x24x64.stl
22.0 x 24.0 x 64.0
