kiujkiu/macha/models/counterweight_arm/counterweight_arm.stl

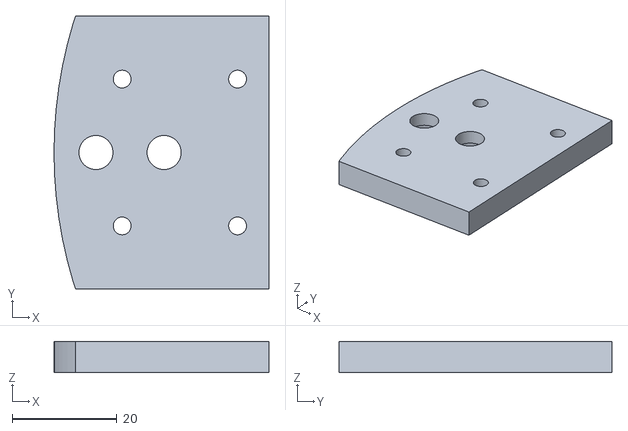
[picture p93: CAD file, 2026-08-28]
models/counterweight_arm/counterweight_arm.stl
41.0 x 52.0 x 6.00
