kiujkiu/macha/models/l_bracket_170x60/l_bracket_170x60.stl

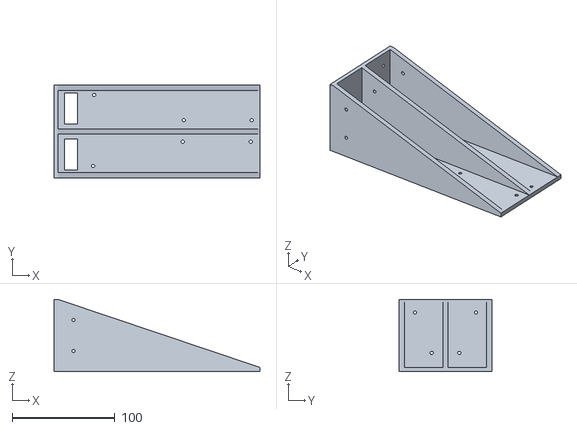
[picture p94: CAD file, 2026-06-23]
models/l_bracket_170x60/l_bracket_170x60.stl
200.0 x 90.0 x 70.0
