kiujkiu/macha/models/mlkpai_board/mlkpai_board.stl

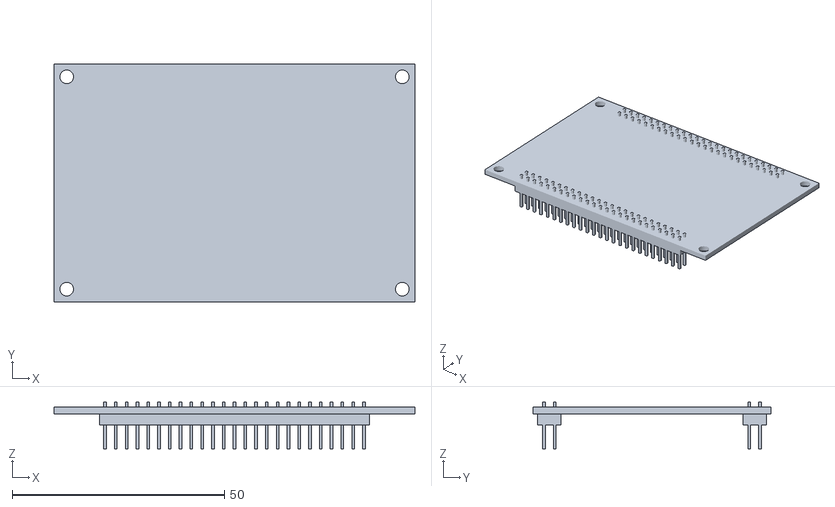
[picture p95: CAD file, 2026-07-02]
models/mlkpai_board/mlkpai_board.stl
85.0 x 56.0 x 11.0
