kiujkiu/macha/models/mlkpai_h_bracket/mlkpai_h_bracket.stl

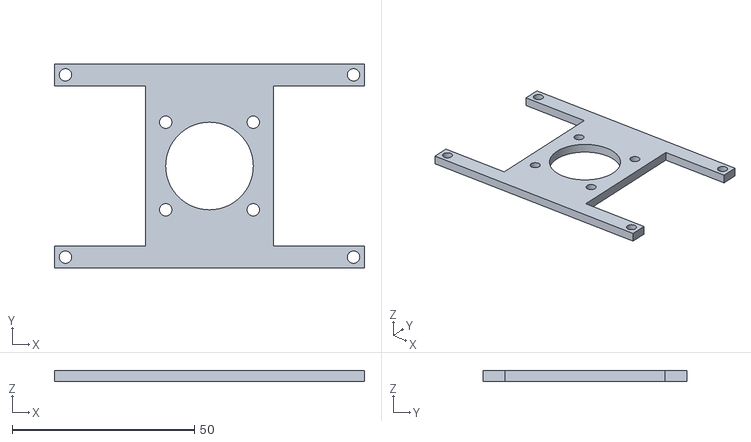
[picture p96: CAD file, 2026-07-02]
models/mlkpai_h_bracket/mlkpai_h_bracket.stl
85.0 x 56.0 x 3.00
