kiujkiu/macha/models/mr30_clamp_12p3x5p3x15p4/mr30_shim_38x18p4x2p25.stl

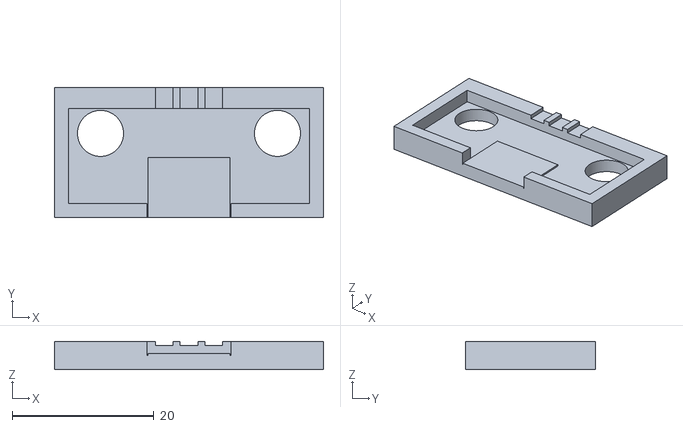
[picture p97: CAD file, 2026-09-18]
models/mr30_clamp_12p3x5p3x15p4/mr30_shim_38x18p4x2p25.stl
38.0 x 18.4 x 4.00
