kiujkiu/macha/models/pcb_tray/pcb_tray.stl

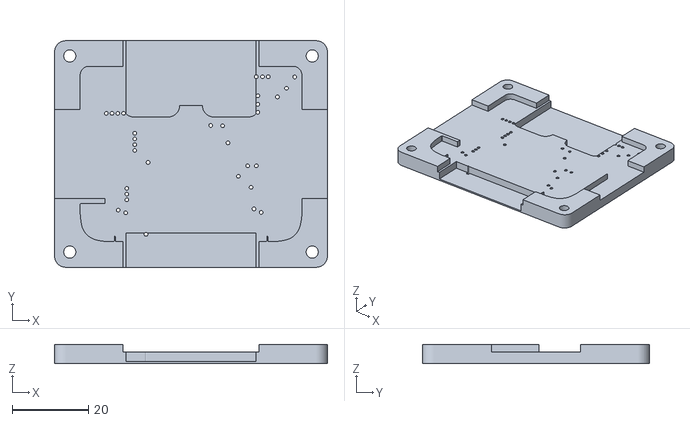
[picture p98: CAD file, 2026-06-10]
models/pcb_tray/pcb_tray.stl
71.5 x 59.4 x 5.00
