kiujkiu/macha/models/photo_sensor/sensor_bracket.stl

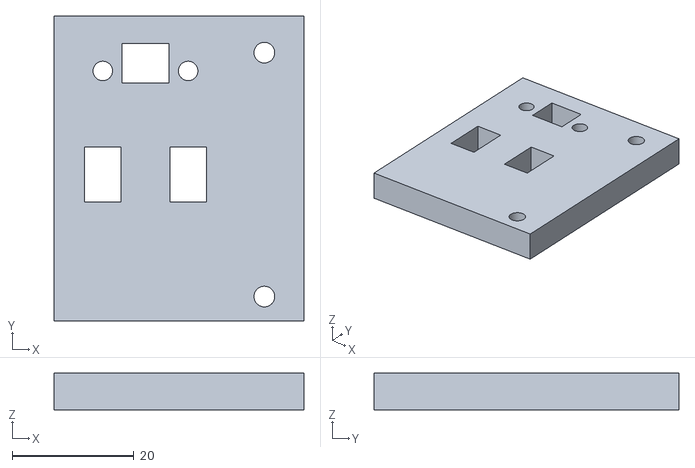
[picture p99: CAD file, 2026-07-15]
models/photo_sensor/sensor_bracket.stl
41.0 x 50.0 x 6.00
