kiujkiu/macha/models/pi2hub75e/pi2hub75e.stl

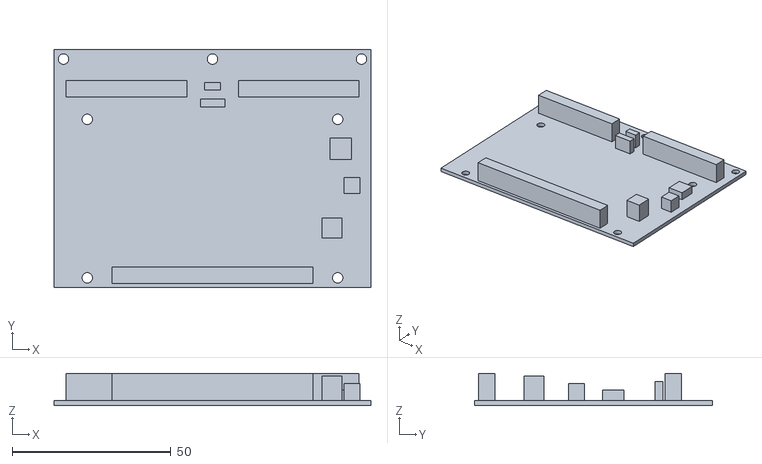
[picture p100: CAD file, 2026-07-09]
models/pi2hub75e/pi2hub75e.stl
100.0 x 75.0 x 10.1
