kiujkiu/macha/models/rim_top_disc/rim_top_disc.stl

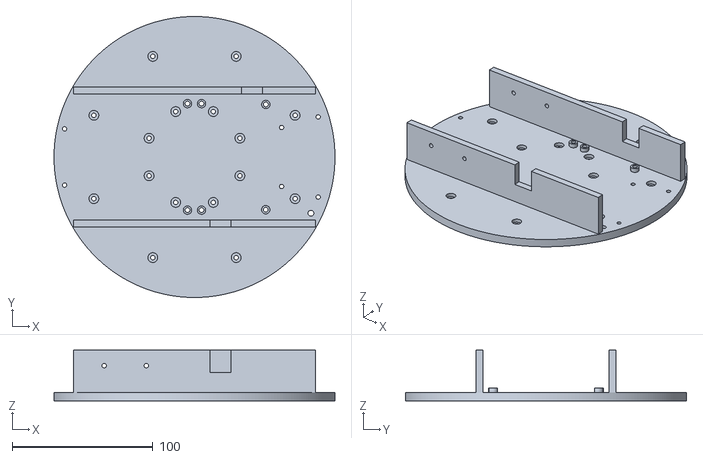
[picture p101: CAD file, 2026-06-23]
models/rim_top_disc/rim_top_disc.stl
200.0 x 200.0 x 36.0
