kiujkiu/macha/models/ring_collar/ring_collar.stl

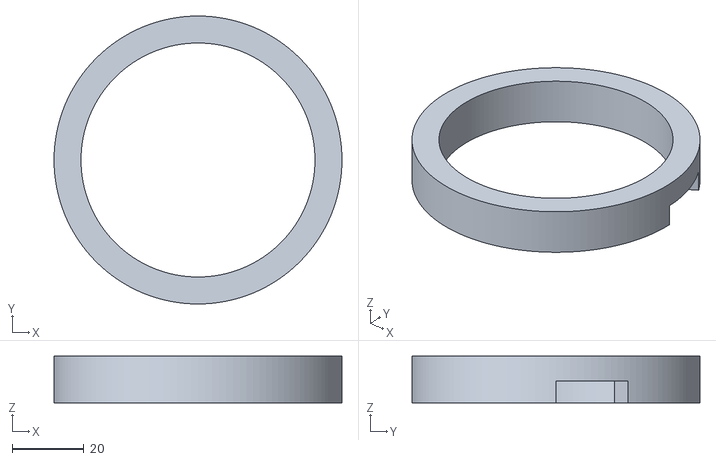
[picture p102: CAD file, 2026-06-08]
models/ring_collar/ring_collar.stl
80.0 x 80.0 x 13.0
