kiujkiu/macha/models/saddle_clamp_sq6/saddle_clamp_sq6.stl

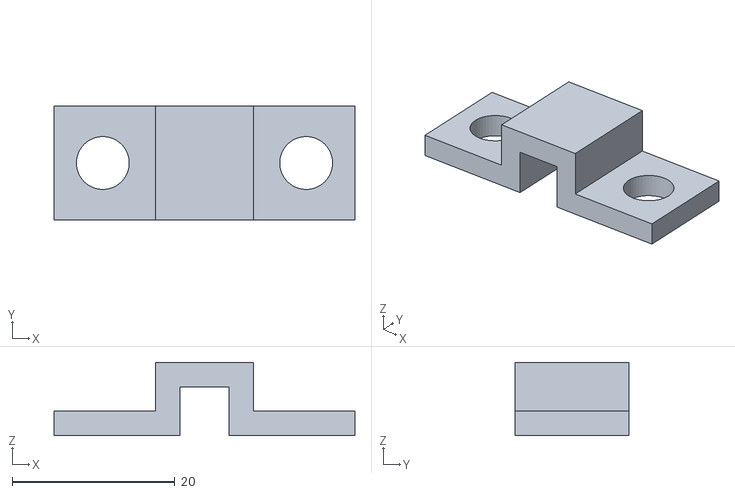
[picture p103: CAD file, 2026-07-02]
models/saddle_clamp_sq6/saddle_clamp_sq6.stl
37.0 x 14.0 x 9.00
