kiujkiu/macha/models/screen_150x169/screen_150x169.stl

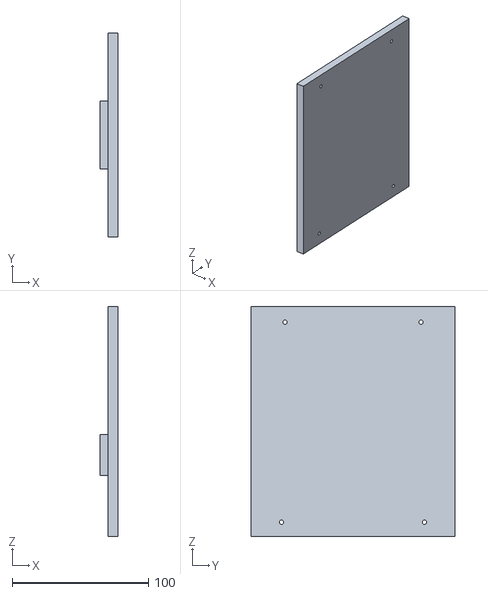
[picture p104: CAD file, 2026-07-09]
models/screen_150x169/screen_150x169.stl
13.3 x 150.0 x 169.0
