kiujkiu/macha/models/screen_150x169_t13/screen_150x169_t13.stl

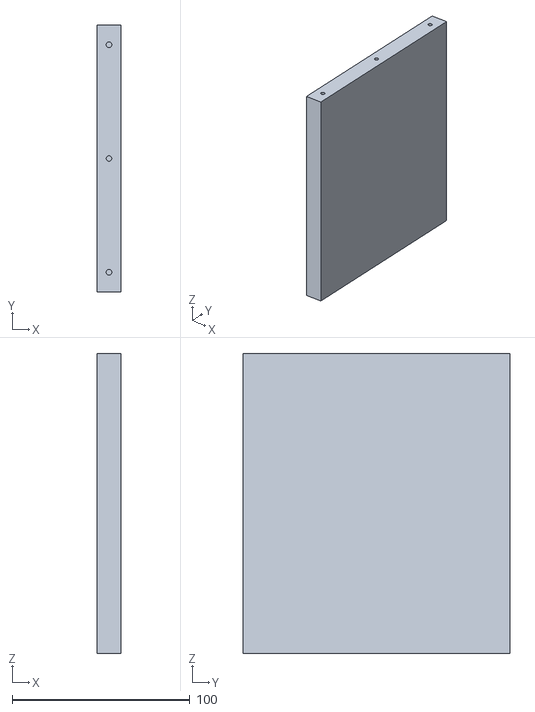
[picture p105: CAD file, 2026-07-24]
models/screen_150x169_t13/screen_150x169_t13.stl
13.4 x 150.0 x 168.8
