kiujkiu/macha/models/screen_solder_jig/screen_solder_jig.stl

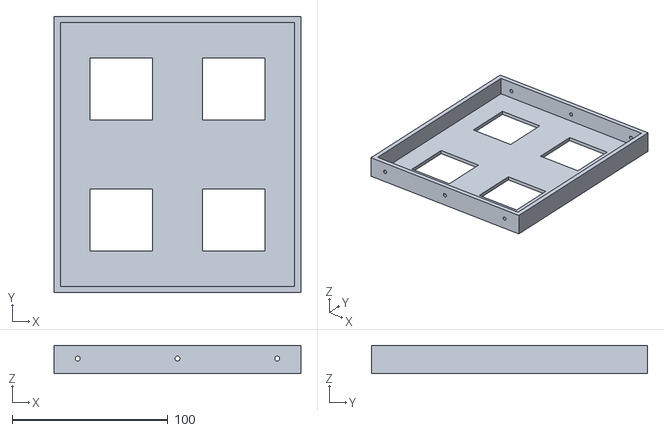
[picture p106: CAD file, 2026-07-24]
models/screen_solder_jig/screen_solder_jig.stl
158.3 x 177.1 x 18.0
