kiujkiu/macha/models/screen_solder_jig_bar/screen_solder_jig_bar.stl

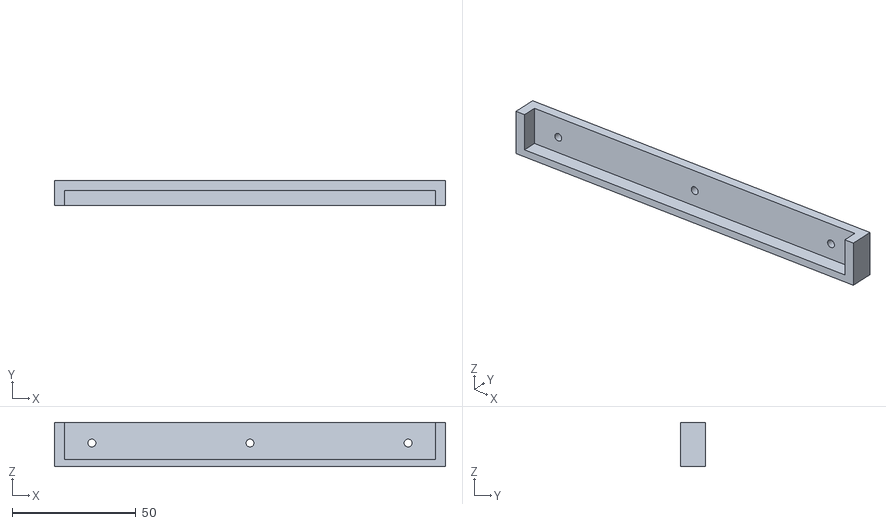
[picture p107: CAD file, 2026-07-24]
models/screen_solder_jig_bar/screen_solder_jig_bar.stl
158.3 x 10.0 x 18.0
