kiujkiu/macha/models/threaded_post_d35x70_x2mm/threaded_post_d35x70_x2mm_thread_test.stl

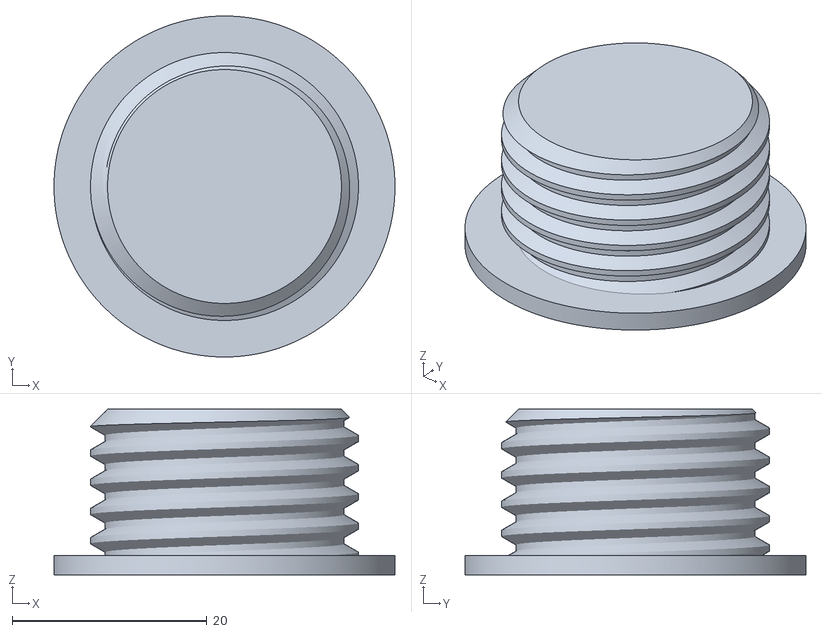
[picture p108: CAD file, 2026-09-15]
models/threaded_post_d35x70_x2mm/threaded_post_d35x70_x2mm_thread_test.stl
35.0 x 35.0 x 17.0
