kiujkiu/macha/models/threaded_post_d50x70/threaded_post_d50x70.stl

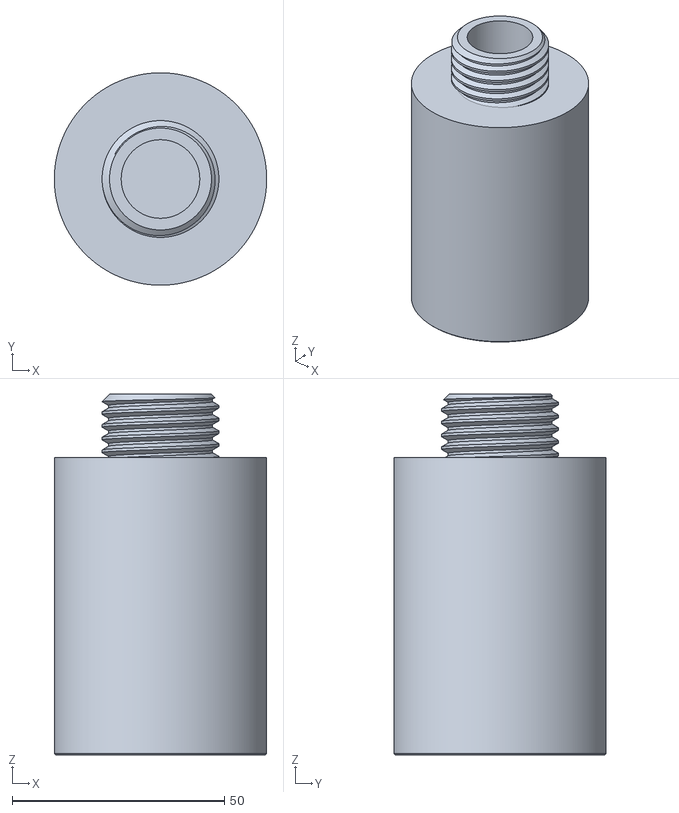
[picture p109: CAD file, 2026-09-15]
models/threaded_post_d50x70/threaded_post_d50x70.stl
50.0 x 50.0 x 85.0
