kiujkiu/macha/models/threaded_post_d50x70_thread_test/threaded_post_d50x70_thread_test.stl

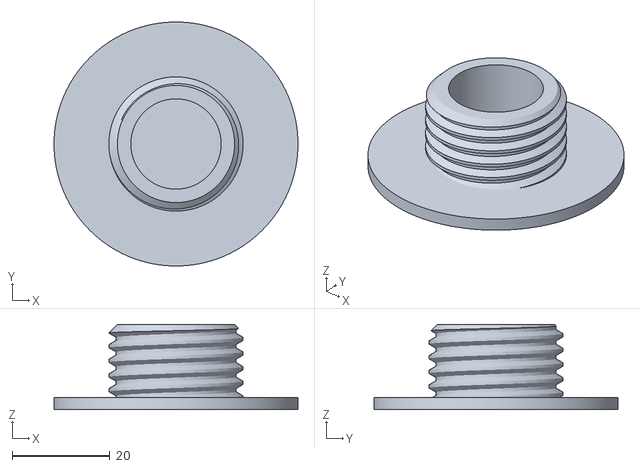
[picture p110: CAD file, 2026-09-15]
models/threaded_post_d50x70_thread_test/threaded_post_d50x70_thread_test.stl
50.0 x 50.0 x 17.5
