kiujkiu/macha/models/top_bearing/frame_B.stl

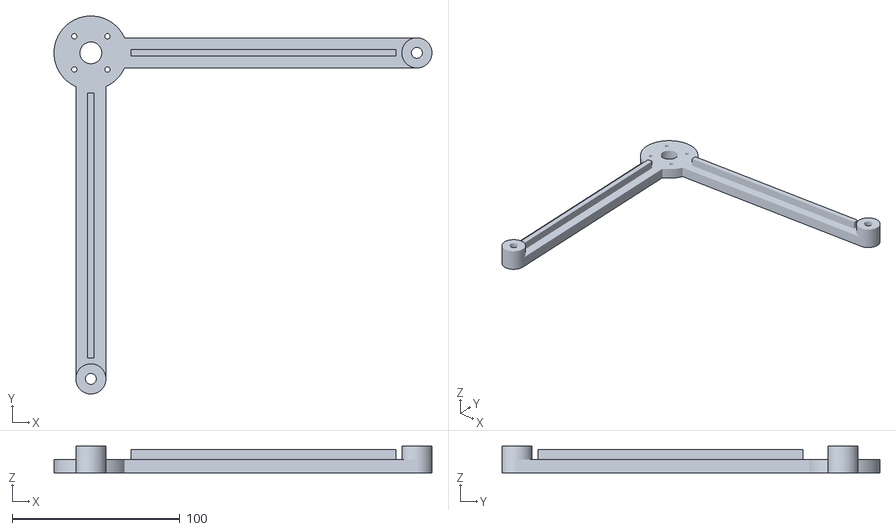
[picture p111: CAD file, 2026-06-23]
models/top_bearing/frame_B.stl
225.5 x 225.5 x 16.0
