kiujkiu/macha/models/usb_wifi/usb_wifi_module_flat.stl

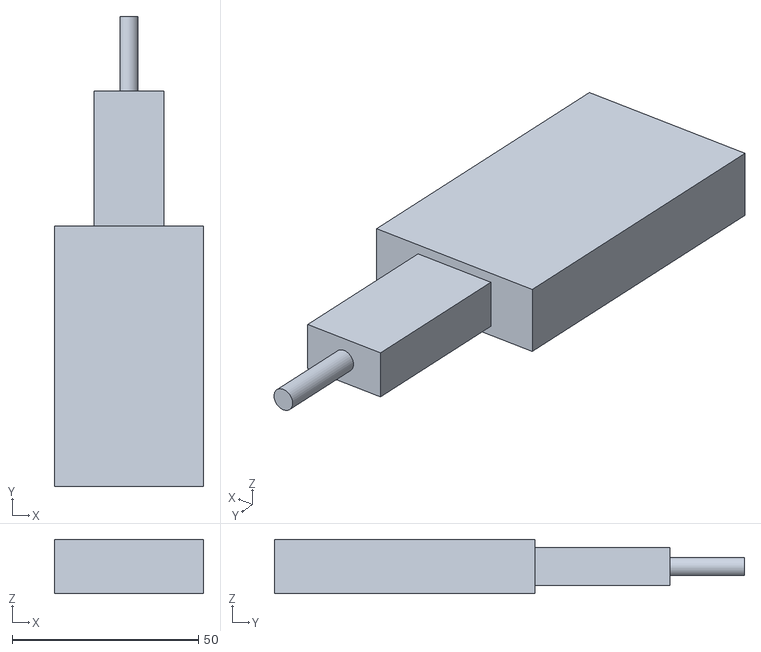
[picture p112: CAD file, 2026-07-24]
models/usb_wifi/usb_wifi_module_flat.stl
40.0 x 126.3 x 14.5
