kiujkiu/macha/models/zynq_board/zynq_board.stl

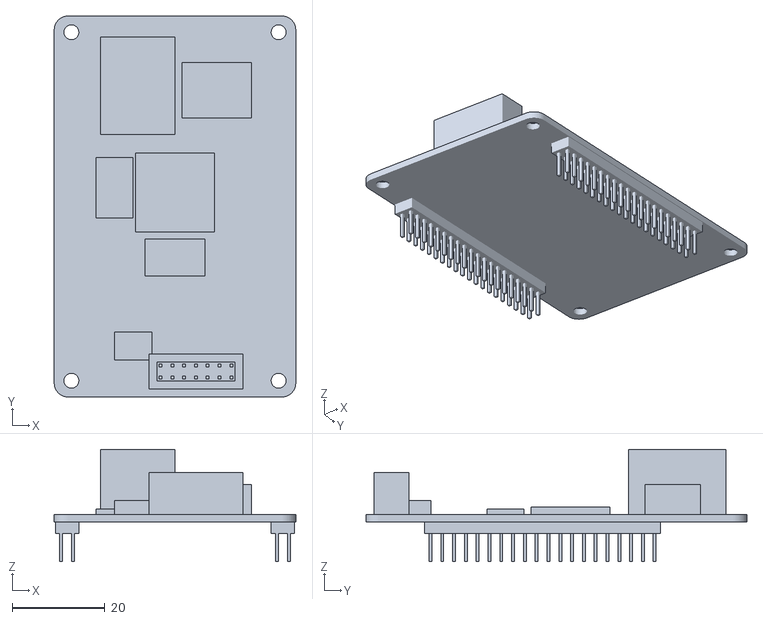
[picture p114: CAD file, 2026-06-23]
models/zynq_board/zynq_board.stl
52.0 x 82.0 x 24.1
