kiujkiu/macha/v4/models/baseplate_collar_v4_h28/baseplate_collar_v4_h28.stl

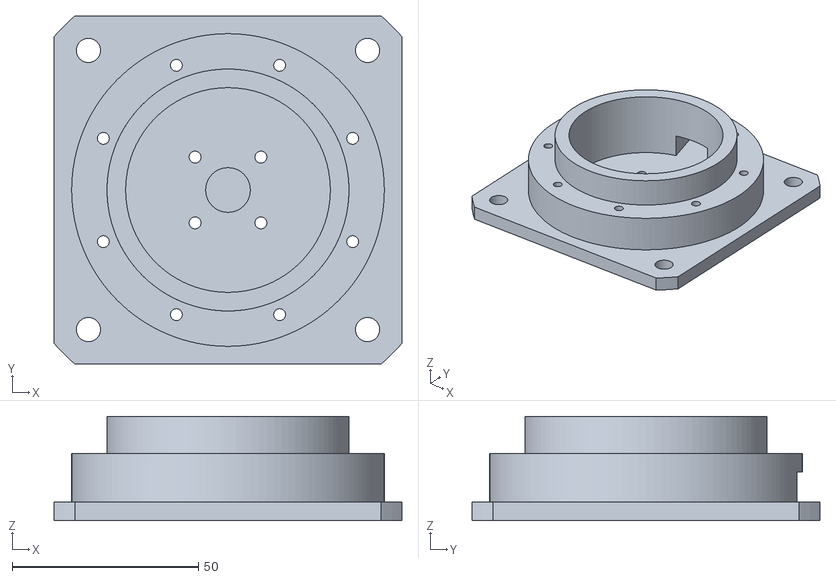
[picture p115: CAD file, 2026-09-04]
v4/models/baseplate_collar_v4_h28/baseplate_collar_v4_h28.stl
93.5 x 93.5 x 28.0
