kiujkiu/macha/v4/models/hub_shim_v4/hub_shim_v4.stl

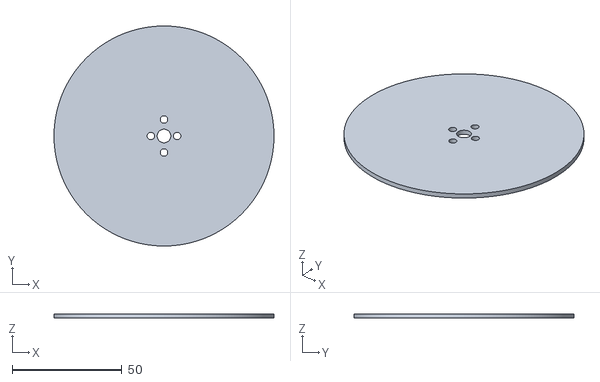
[picture p116: CAD file, 2026-09-04]
v4/models/hub_shim_v4/hub_shim_v4.stl
100.0 x 100.0 x 2.00
