kiujkiu/macha/v4/models/mounting_flange_v4/mounting_flange_v4.stl

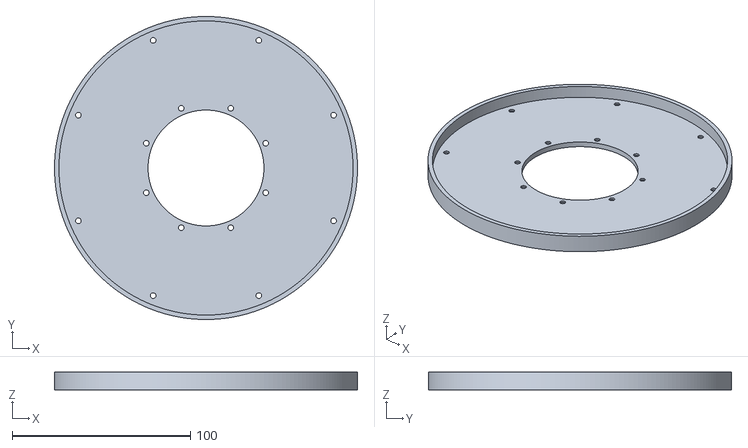
[picture p117: CAD file, 2026-09-09]
v4/models/mounting_flange_v4/mounting_flange_v4.stl
170.0 x 170.0 x 10.0
