kiujkiu/macha/v4/models/top_bearing_v4/frame_B_v4.stl

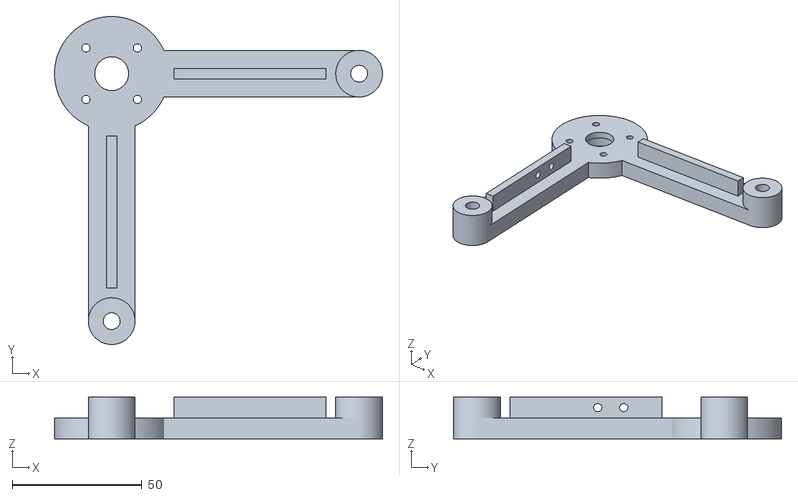
[picture p118: CAD file, 2026-08-28]
v4/models/top_bearing_v4/frame_B_v4.stl
126.2 x 126.2 x 16.0
