kiujkiu/macha/v4/print/portal_tee_v3_1/portal_tee_v3_1.stl

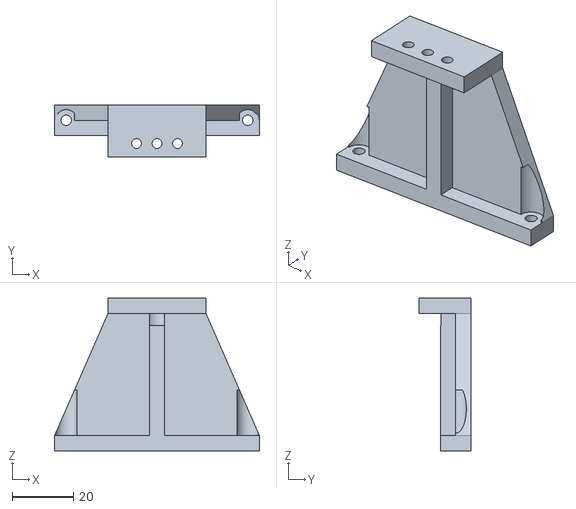
[picture p119: CAD file, 2026-07-31]
v4/print/portal_tee_v3_1/portal_tee_v3_1.stl
67.0 x 17.0 x 50.0
