kiujkiu/macha/v4/print/rotor_shroud_v3_1/shroud_half_B_v3_1.stl

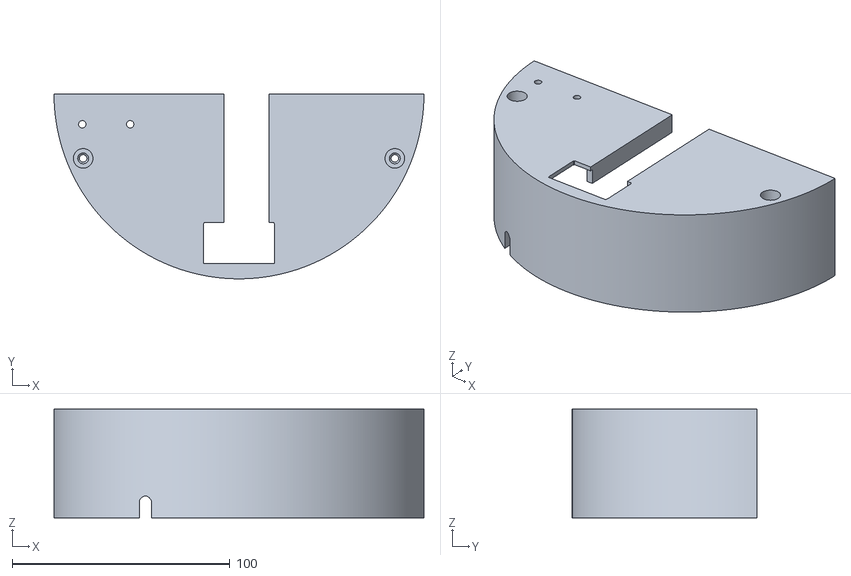
[picture p120: CAD file, 2026-08-03]
v4/print/rotor_shroud_v3_1/shroud_half_B_v3_1.stl
170.0 x 84.8 x 50.0
