kiujkiu/macha/v4/print/top_cap_v3_1_1/top_cap_v3_1_1.stl

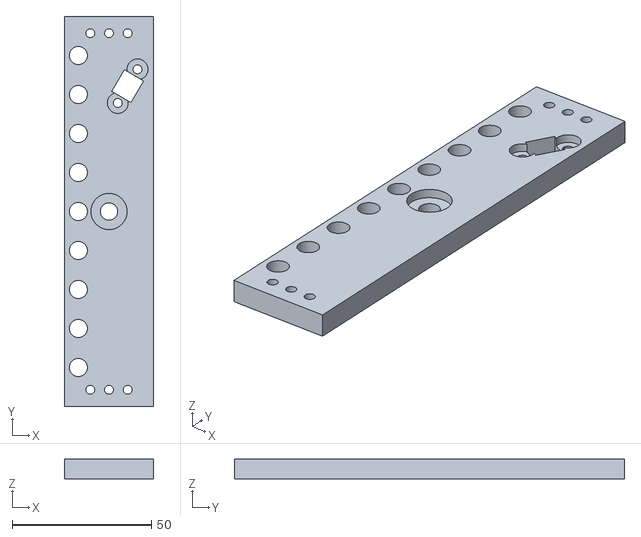
[picture p121: CAD file, 2026-07-31]
v4/print/top_cap_v3_1_1/top_cap_v3_1_1.stl
32.0 x 140.0 x 7.00
