kiujkiu/macha/v4/print/wifi_shell/wifi_shell.stl

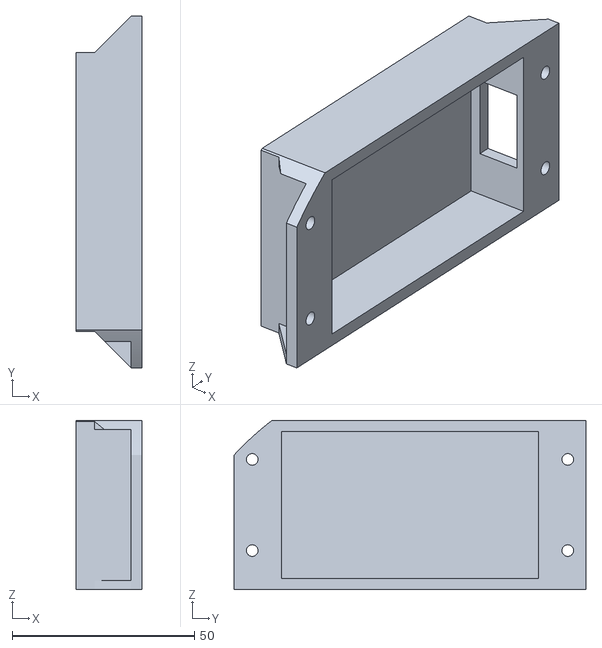
[picture p122: CAD file, 2026-07-28]
v4/print/wifi_shell/wifi_shell.stl
18.1 x 96.6 x 46.4
