kiujkiu/macha/models/mr30_clamp_12p3x5p3x15p4/mr30_clamp_12p3x5p3x15p4.stl

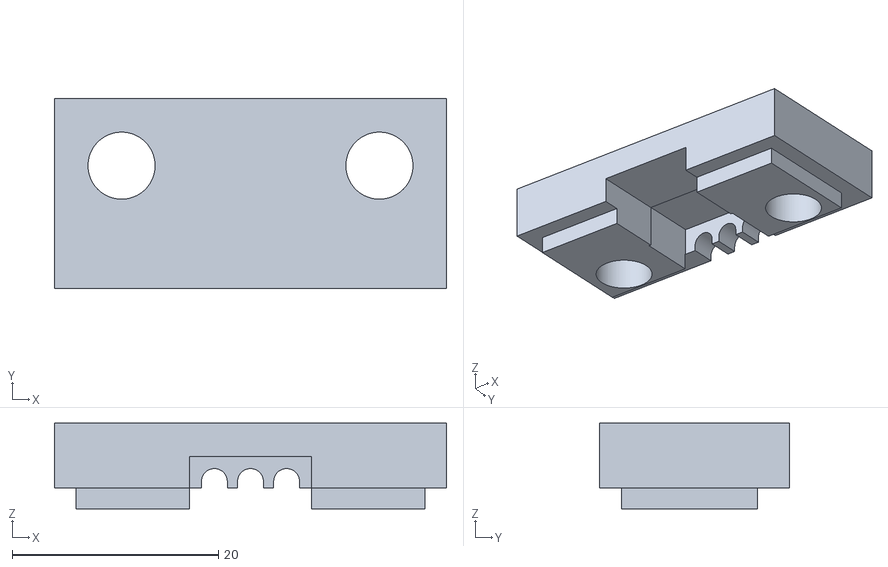
[picture p123: CAD file, 2026-09-18]
models/mr30_clamp_12p3x5p3x15p4/mr30_clamp_12p3x5p3x15p4.stl
38.0 x 18.4 x 8.30
