kiujkiu/macha/models/threaded_post_d35x70_x2mm/threaded_post_d35x70_x2mm.stl

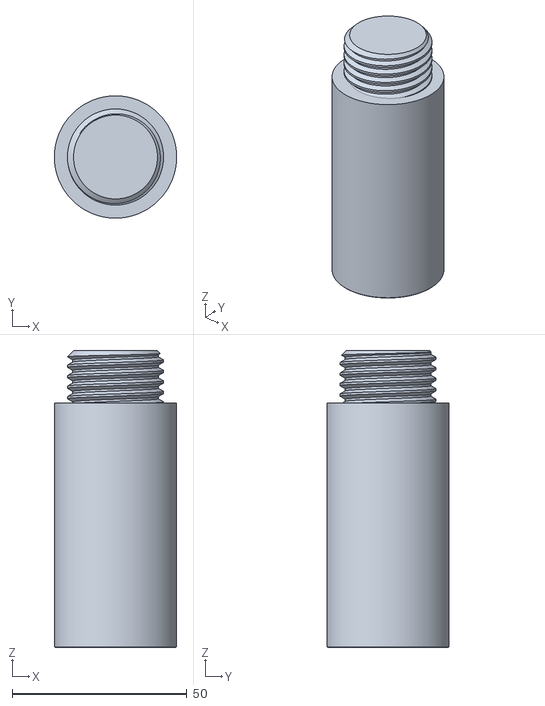
[picture p124: CAD file, 2026-09-15]
models/threaded_post_d35x70_x2mm/threaded_post_d35x70_x2mm.stl
35.0 x 35.0 x 85.0
