kiujkiu/macha/models/top_bearing/top_cap.stl

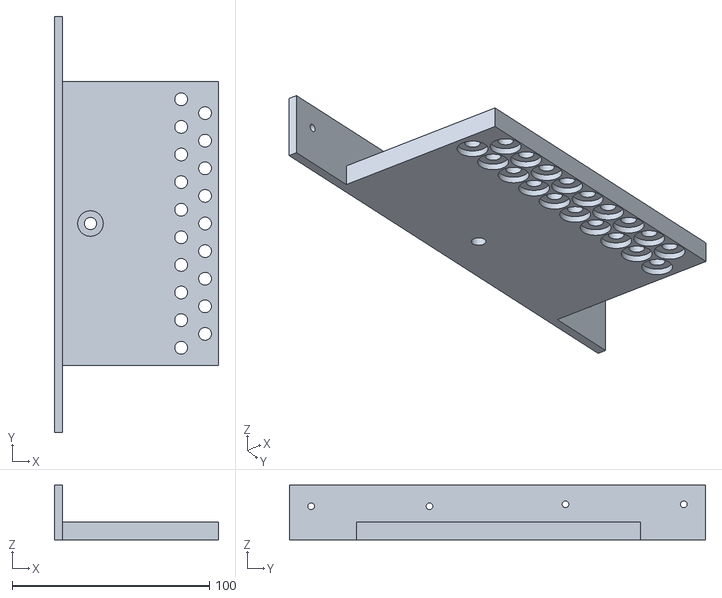
[picture p125: CAD file, 2026-06-23]
models/top_bearing/top_cap.stl
83.3 x 211.0 x 27.7
