kiujkiu/macha/models/xt60_clamp_16p6x9p2x23p9/xt60_clamp_16p6x9p2x23p9.stl

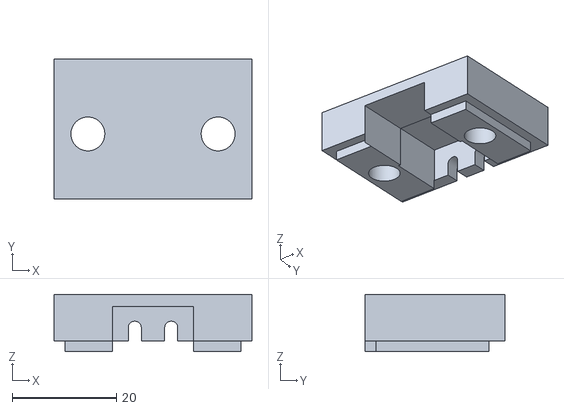
[picture p126: CAD file, 2026-09-18]
models/xt60_clamp_16p6x9p2x23p9/xt60_clamp_16p6x9p2x23p9.stl
38.0 x 26.9 x 11.0
