kiujkiu/macha/models/photo_sensor/sensor_module.stl

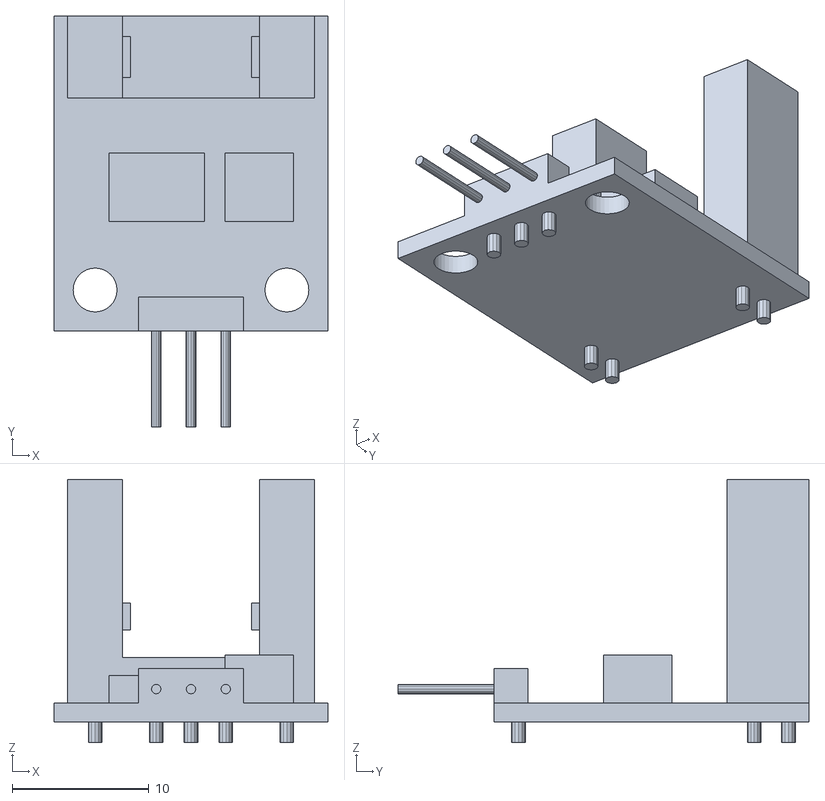
[picture p128: CAD file, 2026-06-23]
models/photo_sensor/sensor_module.stl
20.0 x 30.0 x 19.2
