kiujkiu/macha/models/top_bearing/frame_A.stl

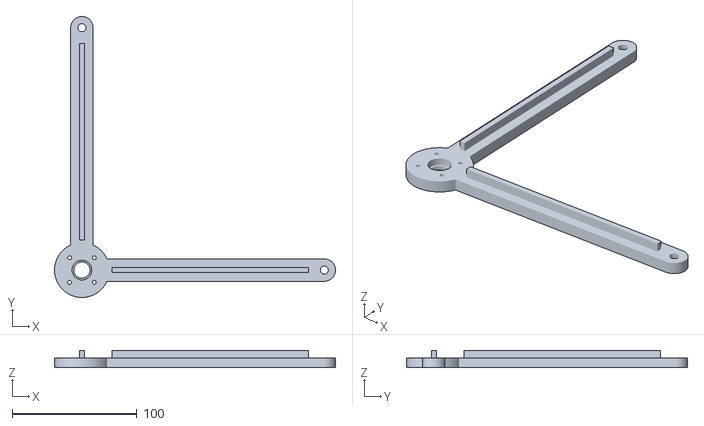
[picture p129: CAD file, 2026-06-23]
models/top_bearing/frame_A.stl
225.5 x 225.5 x 14.0
