kiujkiu/macha/models/photo_sensor/index_vane.stl

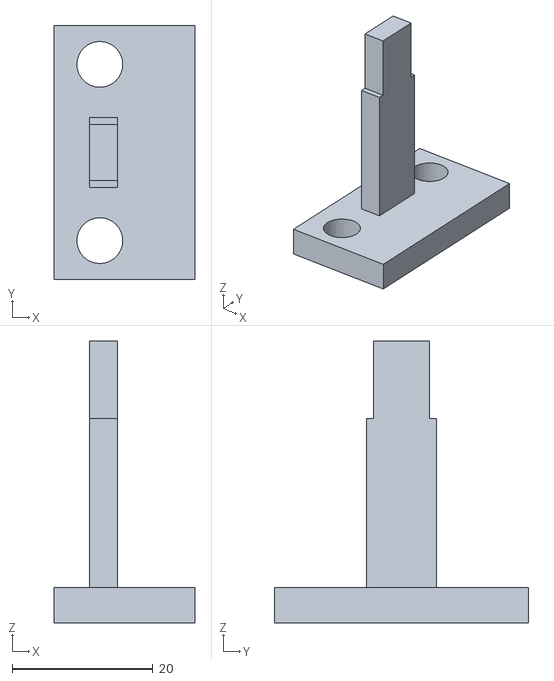
[picture p130: CAD file, 2026-06-23]
models/photo_sensor/index_vane.stl
20.0 x 36.0 x 40.0
