kiujkiu/macha/(list of files, cad)

Other CAD files:
models/usb_wifi/usb_wifi_module.stl
models/baseplate_collar_d100/baseplate_collar_d100.scad
models/threaded_post_d50x70/threaded_post_d50x70.scad
v4/models/baseplate_collar_v4_h28/baseplate_collar_v4_h28.scad
v4/models/flange_disc_v4/flange_disc_v4.scad
models/l_bracket/l_bracket.scad
models/l_bracket/l_bracket.stl
models/photo_sensor/sensor_bracket_v2.stl
models/washer_m3_6p8x1p5/washer_m3_6p8x1p5.stl
v0.2.1/print/top_bearing_frame_v2_1/frame_A_v2_1.stl
v0.2/print/assembly/assembly_v2.stl
v0.2/print/gantry_base/gantry_base_B.stl
v0.2/print/hub_disc/hub_disc.stl
v0.2/print/mounting_flange/mounting_flange.stl
v0.3.1/assembly_v3_1.stl
v0.3.1/models/bottom_portal_v3_1/portal_tee_v3_1.scad
v0.3.1/models/photo_sensor_v3_1/vane_slider_v3_1.stl
v0.3.1/models/top_cap_v3_1_1/top_cap_v3_1_1.scad
v0.3.1/print/top_bearing_frame_v4/frame_A_v4.stl
v0.3/models/bottom_portal_v3/portal_tee_v3.scad
v0.3/models/l_bracket_v3/gantry_v3.scad
v0.3/models/top_cap_v3/top_cap_v3.scad
v0.3/models/top_cap_v3_1/top_cap_v3_1.stl
v0.3/print/_obsolete_20260723/top_cap_v3/top_cap_v3.stl
v0.3/print/portal_tee_v3/portal_tee_v3.stl
v0.3/print/vane_slider_v3/vane_slider_v3.stl
v0.4/assembly_v4.stl
v0.4/assembly_v4_ecc.stl
v0.4/models/counterweight_fan_v4/counterweight_fan_v4.stl
v0.4/models/counterweight_fan_v4/counterweight_fan_v4_asm.stl
v0.4/models/hub_shim_v4/hub_shim_v4.scad
v0.4/models/m3_bush_v4/m3_bush_v4.stl
v0.4/models/motor_shim_v4/motor_shim_v4.stl
v0.4/models/mounting_flange_v4/mounting_flange_v4.scad
v0.4/models/photo_sensor_v4/vane_slider_v4_asm.stl
v0.4/print/assembly/assembly_v4.stl
v0.4/print/baseplate_collar_v4/baseplate_collar_v4.stl
v0.4/print/flange_disc_v4/flange_disc_v4.stl
v0.4/print/rim_ring/rim_ring.stl
v0.4/print/top_balance_bar_v4/top_balance_bar_v4.stl
v0.4/print/top_cap_v4/top_cap_v4.stl
v1.0/boards/base_dr1m90_2026-10-16_board.stl
v1.0/boards/base_dr1m90_2026-10-16_lite.stl
v1.0/boards/bridge_gw5a_2026-10-15_board.stl
v1.0/boards/bridge_gw5a_2026-10-15_lite.stl
v1.0/boards/led_icn2260_v01_260921_board.stl
v1.0/boards/led_icn2260_v01_260921_lite.stl
v1.0/boards/motor_ctrl_2026-10-23_board.stl
v1.0/boards/motor_ctrl_2026-10-23_lite.stl
v1.0/concept/screen_screw_concept.3mf
v1.0/models/balance_block_v1_0/balance_block_v1_0.stl
v1.0/models/balance_block_v1_0/balance_block_v1_0_asm.stl
v1.0/models/motor_tray_v1_0/motor_tray_v1_0.stl
v1.0/models/screen_foot_v1_0/screen_foot_v1_0_negY.stl
v1.0/models/screen_foot_v1_0/screen_foot_v1_0_negY_asm.stl
v1.0/models/screen_foot_v1_0/screen_foot_v1_0_posY.stl
v1.0/models/screen_foot_v1_0/screen_foot_v1_0_posY_asm.stl
v1.0/models/top_bearing_v1_0/frame_A_v1_0.stl
v1.0/models/top_cap_v1_0/top_cap_v1_0.stl
v1.0/models/top_cap_v1_0/top_cap_v1_0_asm.stl
v1.0/print/assembly/assembly_v1_0.3mf
v1.0/print/hub_disc_v1_0/hub_disc_v1_0.stl
v1.0/print/rim_ring_v1_0/rim_ring_v1_0.stl
v1.0/print/top_bearing_frame_v1_0/frame_B_v1_0.stl
v1.0/print/vane_slider_v4/vane_slider_v4.stl
v1.0/print/wifi_plate_v1_0/wifi_plate_v1_0.stl
v1.1/assembly_v1_1.3mf
v1.1/models/glass_seat_v1_1/glass_seat_v1_1.stl
v1.2/assembly_v1_2_不装玻璃_整机+V2板.3mf
v1.2/assembly_v1_2_含法兰+转子盘+玻璃罩定位环.3mf
v1.2/assembly_v1_2_含法兰+转子盘.3mf
v1.2/assembly_v1_2_底盘+玻璃罩下罩_选M6孔.3mf
v1.2/assembly_v1_2_底盘+线圈环+电机+控制板.3mf
v1.2/assembly_v1_2_整机+螺丝.3mf
v1.2/assembly_v1_2_玻璃罩版整机_分体外卡环.3mf
v1.2/assembly_v1_2_玻璃罩版整机_合并.3mf
v1.2/boards/led_v0.2.0_2026-11-13.step
v1.2/models/base_disc_v1_2/base_disc_v1_2.step
v1.2/models/base_disc_v1_2/base_disc_v1_2.stl
v1.2/models/cap_clamp_v1_2/cap_clamp_v1_2.step
v1.2/models/cap_clamp_v1_2/cap_clamp_v1_2.stl
v1.2/models/coil_ring_v1_2/coil_ring_v1_2.step
v1.2/models/coil_ring_v1_2/coil_ring_v1_2.stl
v1.2/models/flange_disc_v1_2/flange_disc_v1_2.step
v1.2/models/flange_disc_v1_2/flange_disc_v1_2.stl
v1.2/models/glass_clamp_ring_v1_2/glass_clamp_ring_v1_2.step
v1.2/models/glass_clamp_ring_v1_2/glass_clamp_ring_v1_2.stl
v1.2/models/glass_shroud_lower_v1_2/glass_shroud_lower_v1_2.step
v1.2/models/glass_shroud_lower_v1_2/glass_shroud_lower_v1_2.stl
v1.2/models/glass_shroud_split_v1_2/glass_shroud_split_v1_2.step
v1.2/models/glass_shroud_split_v1_2/glass_shroud_split_v1_2.stl
v1.2/models/glass_shroud_upper_v1_2/glass_shroud_upper_v1_2.step
v1.2/models/glass_shroud_upper_v1_2/glass_shroud_upper_v1_2.stl
v1.2/models/glass_shroud_v1_2/glass_shroud_v1_2.step
v1.2/models/glass_shroud_v1_2/glass_shroud_v1_2.stl
v1.2/models/glass_top_disc_v1_2/glass_top_disc_v1_2.dxf
v1.2/models/glass_top_hub_v1_2/glass_top_hub_v1_2.step
v1.2/models/glass_top_hub_v1_2/glass_top_hub_v1_2.stl
v1.2/models/glass_top_v1_2/glass_top_v1_2.step
v1.2/models/glass_top_v1_2/glass_top_v1_2.stl
v1.2/models/key_board_v1_2/key_board_outline_v1_2.dxf
v1.2/models/key_bracket_v1_2/key_board_bracket_装配位.step
v1.2/models/key_bracket_v1_2/key_bracket_v1_2.step
v1.2/models/key_bracket_v1_2/key_bracket_v1_2.stl
v1.2/models/key_cap_v1_2/key_cap_v1_2.step
v1.2/models/key_cap_v1_2/key_cap_v1_2.stl
v1.2/models/key_flap_test_v1_2/key_flap_test_v1_2_A_tie.stl
v1.2/models/key_flap_test_v1_2/key_flap_test_v1_2_B_support.stl
v1.2/models/light_pipe_v1_2/light_pipe_v1_2.step
v1.2/models/light_pipe_v1_2/light_pipe_v1_2.stl
v1.2/models/light_pipe_v1_2/light_pipe_装配位.step
v1.2/models/mos_clamp_v1_2/coil_drv_asm_v1_2.step
v1.2/models/mos_clamp_v1_2/coil_drv_pcb_v1_2.step
v1.2/models/mos_clamp_v1_2/mos_clamp_v1_2.step
v1.2/models/mos_clamp_v1_2/mos_clamp_v1_2.stl
v1.2/models/mounting_flange_v1_2/mounting_flange_v1_2.step
v1.2/models/mounting_flange_v1_2/mounting_flange_v1_2.stl
v1.2/models/xt60_clamp_v1_2/xt60_clamp_v1_2.step
v1.2/models/xt60_clamp_v1_2/xt60_clamp_v1_2.stl
v1.2/models/xt60_clamp_v1_2/xt60_shim_v1_2.step
v1.2/models/xt60_clamp_v1_2/xt60_shim_v1_2.stl
v1.2/src/flange_disc_v4.step
v1.2/src/frame_A_v4_raw.step
v1.2/src/frame_B_v4_raw.step
v1.2/src/glass_tube_OD200x5x450.step
v1.2/src/hub_disc_v1_0.step
v1.2/src/mounting_flange_v4.step
v1.2/src/rim_ring_v1_0.step
v1.2/src/vane_slider_v4_trimmed.step
v2.1/assembly_v2_1.stl
v2.1/models/top_bearing_v2_1/frame_B_v2_1.stl
v2.1/models/top_cap_v2_1/top_cap_v2_1.stl
v2.1/print/assembly/assembly_v2_1.stl
v2.1/print/top_bearing_frame_v2_1/frame_B_v2_1.stl
v2.1/print/top_cap_v2_1/top_cap_v2_1.stl
v2/print/_obsolete_20260722/index_vane_v2/index_vane_v2.stl
v2/print/_obsolete_20260722/mlkpai_carrier_disc/mlkpai_carrier_disc.stl
v2/print/_obsolete_20260722/sensor_bracket_v2/sensor_bracket_v2.stl
v2/print/_obsolete_20260722/wifi_box/wifi_box.stl
v2/print/gantry_base/gantry_base_A.stl
v2/print/index_vane_v2/index_vane_v2.stl
v2/print/mlkpai_carrier_disc/mlkpai_carrier_disc.stl
v2/print/screen_plate/screen_plate.stl
v2/print/sensor_bracket_v2/sensor_bracket_v2.stl
v2/print/top_bearing_frame_v2/frame_A_v2.stl
v2/print/top_bearing_frame_v2/frame_B_v2.stl
v2/print/top_cap_v2/top_cap_v2.stl
v2/print/wifi_box/wifi_box.stl
v3.1/assembly_v3_1.stl
v3.1/models/photo_sensor_v3_1/vane_slider_v3_1_asm.stl
v3.1/models/rotor_shroud_v3_1/rotor_shroud_v3_1.scad
v3.1/print/assembly/assembly_v3_1.stl
v3/assembly_v3.stl
v3/models/l_bracket_v3/gantry_v3.stl
v3/models/l_bracket_v3/screen_plate_v3.scad
v3/models/l_bracket_v3/screen_plate_v3.stl
v3/models/photo_sensor_v3/vane_slider_v3_asm.stl
v3/models/rotor_shroud_v3/rotor_shroud_v3.scad
v3/models/rotor_shroud_v3/shroud_half_A_v3.stl
v3/models/rotor_shroud_v3/shroud_half_B_v3.stl
v3/models/top_cap_v3/top_cap_v3.stl
v3/models/top_cap_v3_1/top_cap_v3_1.scad
v3/print/_obsolete_20260723/gantry_v3/gantry_v3.stl
v3/print/_obsolete_20260723/index_vane_v2/index_vane_v2.stl
v3/print/_obsolete_20260723/mlkpai_carrier_disc/mlkpai_carrier_disc.stl
v3/print/_obsolete_20260723/screen_plate_v3/screen_plate_v3.stl
v3/print/_obsolete_20260723/sensor_bracket_v2/sensor_bracket_v2.stl
v3/print/_obsolete_20260723/top_bearing_frame_v2/frame_A_v2.stl
v3/print/_obsolete_20260723/top_bearing_frame_v2/frame_B_v2.stl
v3/print/_obsolete_20260723/top_bearing_frame_v2_1/frame_B_v2_1.stl
v3/print/_obsolete_20260723/vane_clip_v3/vane_clip_v3.stl
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
