kiujkiu/macha/models/screen_solder_jig_bar/screen_solder_jig_bar_drawing.pdf

# POV 3D 焊接托盘可卸底条 Screen Solder Jig — Bottom Bar (L 形)

从 screen_solder_jig 切下外缘 10mm (Y=78.525) / 全宽 158.3 × 深 10 × 高 18 / 端壁 4×18 (3×Φ3.2 M3 间距64 距底6.6) + 底唇 6×3 (GB 1st-angle, 1:1, mm)

## 主视图 Front (1:1) (沿 +Y 看端壁, 3×M3)

## 侧视 L 截面 (1:1) (沿 +X 看)

10 mm

4 mm

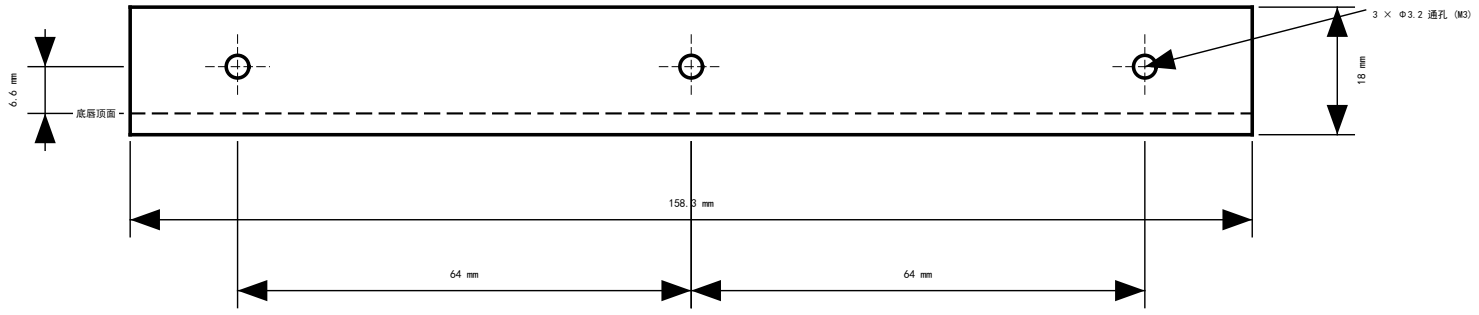
[picture p132: figure]
底唇顶面

18 mm

9.6 mm

3 mm

底唇 6 宽×3 厚

## 俯视图 Top (1:1) (沿 -Z, 足印 158.3×26.525)

158.3 mm

10 mm

4 mm

底唇 (Z0..3)

端壁 | (Z0..18)
POV 3D 结构件 — 焊接托盘可卸底条 (Screen Solder Jig Bottom Bar) | 投影 1st-angle / 比例 1:1 (主 / 侧 L / 俯)
全宽 158.3×深 10×高 18 / 端壁 4 (3×Φ3.2 M3 间距64 距底6.6) + 底唇 6×3 / 切自 Y=78.525 / mm | 2026-07-21 / POV3D / models / screen_solder_jig_bar / screen_solder_jig_bar.stl
