kiujkiu/macha/v4/print/wifi_shell/wifi_shell_drawing.pdf

# POV 3D — wifi_shell 新 WiFi 壳子 v1 (侧开口五面盒 + 双端沿)

内腔 15.1×70.6×40.4 / 壁 3 / 开口面 = +X 侧 70.6×40.4 (无壁) / +Y 端壁出口窗 10.7×19.1 / ±Y 端沿外伸 10×厚 3 (X15.1..18.1, 与开口面共面) 各 2×Φ3.2 + 2 三角筋 2.5 厚 45° / 2026-07-27 盘缘裁切: -Y 端角按 R83.5 圆弧切齐 (弧心在零件系 y=13, z=-19.8 = 转子轴), 见侧视图 / 基准 = 封闭壁外面 X0 + 外底面 Z0 + Y 中面 / 安装 = 倒扣: 开口/沿朝下贴盘, 罩住放平的模块 (40×70 面贴盘, 14.5 高) (GB 1st-angle, 2:1, mm)

## 俯视图 (2:1) (+Y = 出口窗端 = 图上方, 开口朝 +X = 图右)

18.1 mm

15.1 (内腔) mm

76.6 (盒体) mm

3 mm

10 (沿) mm

96.6 mm

70.6 (内腔) mm

沿 3 厚 ×2 + 三角筋 2.5 厚 ×4 (45°, 臂 10)

## 侧视图 (从 +X 开口侧看进腔, 2:1), +Y = 图右

盘缘裁切 R83.5 (弧心 = 转子轴, 零件系 y13/z-19.8) — 切掉原 -Y 沿外角 (装配系 r90.22 -> 83.50, 收进 Φ170 盘缘内)

96.6 mm

5 mm

25 (孔距) mm

40.4 (内腔) mm

4×Φ3.2 通 (M3, 孔轴沿 X, Z 10.7/35.7 对称中面)

## 正视图 (从 +Y 端看, 2:1) — 出口窗

46.4 mm
19.1 mm

23.2 (窗中心) mm

10.7 mm

出口窗 = 母头壳 10.3×18.7 +0.4, 对准放平模块口轴线 (X10.85, 离开口面 7.25), 切穿 +Y 沿板

POV 3D 结构件 — wifi_shell 新 WiFi 壳子 v1 (侧开口五面盒 + 双端沿) | 投影 1st-angle / 比例 2:1 / 全平面通孔无详图
盒体 18.1×76.6×46.4 (含沿总长 96.6) / 内腔 15.1×70.6×40.4 / 壁 3 / 开口 = +X 侧 / 窗 10.7×19.1 @ (X10.85, Z23.2) / 沿 10×3 ×2 + 筋 2.5 ×4 + 4×Φ3.2 (距壁 5, c-c 25) / 盘缘裁切 R83.5 / 打印/安装姿态 = 倒扣 (开口/沿朝下) 零支撑 / PETG / mm | 2026-07-27 / POV3D / models / usb_wifi / wifi_shell.stl
