kiujkiu/macha/v1.0/print/README.md

# POV3D V1.0 打印清单 (验证板结构, 2026-10-20)

**V1.0 = 配合验证板硬件**: ICN2260 灯板 ×2 背靠背 (缝 4.6, 夹 M3 六角铜螺母) + GW5A 桥板 ×2 + DR1M90 底板 + FS03 + WiFi。
定子 (底座三件) 和 V0.4 一样; 转子盘扩到 Φ180, 屏幕支撑、顶盖、顶轴承架、WiFi 托板都是新件。

- 全部 PLA, 单位 mm
- **STL 都是打印姿态**: 屏幕底座 (内侧面朝下)、顶盖 (顶面朝下) 已经摆好, 切片软件直接放床上就行
- 每个文件夹: STL + A3 图纸 PDF (三视图 + 孔表 + 打印姿态)
- 总册: `v1_0_print_sheet.pdf` (第 1 页总览 + 全部图纸); 打包: `pov3d_v1_0_print.zip` (不进 git, 跑 `python build_print_v1_0.py` 重生成)
- 整机装配: `assembly/assembly_v1_0.3mf` (42 个零件分开着色) —— 只用来看, 不打印

## 要打的件 (7 个文件夹 / 9 个 STL / 共 9 件)

| # | 文件夹 | STL | 数量 | 打印姿态 | 说明 |
|---|---|---|---|---|---|
| 1 | `hub_disc_v1_0` | hub_disc_v1_0.stl | 1 | 底面贴床 | 转子下盘 Φ175。外圈 D 组 8 孔 R82.5 (原 77.5), 底面压铜螺母 |
| 2 | `rim_ring_v1_0` | rim_ring_v1_0.stl | 1 | 托盘面贴床 | 转子承载盘 Φ180, 外唇 175/180。E 组 4 孔 = DR1M90 底板 (Φ3.2 通 + 唇侧 Φ4.2×4.5 铜螺母孔) |
| 3 | `screen_foot_v1_0` | screen_foot_v1_0_posY.stl + _negY.stl | 各 1 | 内侧面贴床, 零支撑 | 屏幕底座 (portal_tee 结构), 两件互为镜像, **别打成两个一样的** |
| 4 | `top_cap_v1_0` | top_cap_v1_0.stl | 1 | 顶面贴床 (头窝朝上) | 屏幕顶盖, 带光电模块 2 孔 + 排针槽 |
| 5 | `wifi_plate_v1_0` | wifi_plate_v1_0.stl | 1 | 平放 | WiFi 托板 H 形 70×128×3 |
| 6 | `top_bearing_frame_v1_0` | frame_A_v1_0.stl + frame_B_v1_0.stl | 各 1 | STL 即姿态 | 顶轴承架, 柱位 R95.20 → **R107.53** (立柱沿网格外挪一格), 必须重打 |
| 7 | `vane_slider_v4` | vane_slider_v4.stl | 1 | 平躺 | 挡光滑片, V0.4 原件。**V1.0 要剪到筋底下 14.7** (V0.4 剪到 10), 已经剪过的旧件不够长, 重打一个 |

## 沿用, 不用打

| 件 | 说明 |
|---|---|
| baseplate_collar_v4 / flange_disc_v4 / mounting_flange_v4 | 定子三件, V0.4 原件 |
| wifi_shell | V0.4 原件直接用 (`v0.4/print/wifi_shell`)。罩沿 4 孔对托板 B 组; 有一角是 V0.4 时 R83.5 裁的小缺口, 不影响 |

## 五金

| 用途 | 规格 × 数量 | 备注 |
|---|---|---|
| 屏幕锁紧螺母 | M3 通孔六角铜螺母 对边 4.6 × 长 4.0 **×12** | 焊灯板背面, 每板 6 颗: 每侧 3 组, 每组上颗焊 A 板 / 下颗焊 B 板 (灯板系 x=±77.0) |
| 屏幕上螺丝 | M3×16 ×2 | 从顶盖往下, 锁上组 |
| 屏幕下螺丝 | M3×120 ×2 | 从底座顶托往上, 穿下组锁进中组。**非标**, 可用 M3 牙条 + 螺母 |
| 底座 → 转子 | M3×14 ×4 | 借 rim_ring 外圈环孔, 拧进 hub_disc 底面铜螺母 (D 组 67.5/112.5/247.5/292.5°) |
| DR1M90 底板 | M3×5 尼龙垫柱 ×4 | 拧进 rim_ring E 组铜螺母 |
| WiFi 托板 | M3×25 尼龙螺柱 (公母) ×4 + M3 螺丝 ×4 | 公头拧 DR1M90 顶面贴片铜柱 |
| WiFi 罩 | M3×10 ×4 + 螺母 ×4 | 从托板**底面往上**穿, 螺母在罩沿顶 |
| WiFi 线 | 扁平 USB 延长线 AF 母 ↔ AMRI 弯头公 | 从托板 +Y 的 H 口穿下去插 FS03 J6; 弯头插头高度要 ≤ 6.9 |
| 顶部转轴 | M6×20 平头 ×1, Φ8×45 螺柱 ×1, 688 轴承 ×2 | M6 头藏顶盖底面 Φ13×2.7 窝 |
| 立柱 | Φ8 × **360** ×4 (V0.4 是 290) | 坐网格 M6 螺纹孔 (87.5,62.5) 族, M6 双头螺柱 |
| 轴承架 | M6×16 ×2 (A) + M6×30 ×2 (B) + M3×20 + 螺母 ×4 | 同 V0.4 |
| 光电 | M3×10 + 螺母 ×2 (模块) / M3×20 + 螺母 ×2 (挡光滑片) | 模块螺丝从顶盖底面往上, 头沉 Φ7.5×2.5 窝 |
| 铜螺母 | M3 热熔/压入式 (Φ4.2 孔) | hub_disc / rim_ring 按图纸孔表压; V1.0 至少要 hub D 组 4 + rim E 组 4 |

全部 M3 螺丝头按 Φ7 × 1.5 厚考虑。

## 装配顺序要点

1. 灯板背面焊铜螺母 (A 板焊上颗, B 板焊下颗), 两板背靠背对齐
2. 顶盖: **先**从底面装光电模块的 2 颗 M3 和中心 M6, **再**把顶盖压到灯板上沿 —— 压上以后头窝就拧不到了
3. 屏幕底座 ×2 用 M3×14 锁到转子盘 (穿 rim_ring 外圈孔进 hub_disc 铜螺母), 再托住灯板下角
4. WiFi: 托板 + 罩 + 模块先用 4 颗 M3 锁成一组, 再整组拧到 4 根尼龙柱上
5. 挡光滑片锁 frame_B 臂筋, 刀片剪到筋底下 14.7

## 还没定的

- **下螺丝装法**: 底座底条上的轴线孔按要求改成了 Φ3, M3×120 从底下穿不过去 —— 要么改回让位孔, 要么下螺丝从上往下装 (待定)
- M3×120 非标
- AMRI 弯头插头实际尺寸 (留给它的高度 6.92)
- 罩住 LED 以下的圆罩子: 内半径要 ≥ 87 (底座外形已经裁到 R87)
