kiujkiu/macha/v0.3.1/print/README.md

# POV3D v3.1 打印清单 — 偏心屏实验 (2026-07-30)

**v3.1 = 把双面屏整体偏移 6.7mm, 让其中一面正好落在旋转轴平面上。**

双面屏两个 LED 面在 X = ±6.7, 面上任一点到轴的最近距离就是 6.7 → 成像中心有个
**Φ13.4 盲柱**(半径 6.7 内在整个旋转周期里被屏体自己占着)。偏移后:
**贴轴那面盲区归零, 另一面变 Φ26.8**。

底座沿用 **v4 的 200×200 网格板**配置。改动全在转子/顶部, 3 个新件在 v3 底座上同样能用。

## 只打这 7 件 (6 个新件)

| # | STL | 数量 | 切片姿态 | 说明 |
|---|-----|-----|---|---|
| 1 | **portal_tee_v3_1** | **2 (同件)** | 平躺, 外侧平整面贴床, 零支撑 | 顶托由梯形(内13.4/外20)改**等宽 ±16**; 屏孔改 X 方向**3 个离散孔 (−6.7/0/+6.7)** |
| 2 | **top_cap_v3_1_1** | 1 | 平躺 (顶面贴床), 零支撑 | 压条 18→**32 宽 (±16)**; 屏孔 3×2; **+9×Φ6.5 配重孔** @X−11; **+2×Φ3 对射管焊脚避空** |
| 3 | **shroud_half_A_v3_1** / **B** | 各 1 (**非同件**) | 绕 X 翻 180°, 顶板贴床, 零支撑 | 屏缝改非对称 **X −7.0..+13.7** + T顶托区 ±16.3 |
| 4 | **vane_slider_v3_1** | 1 | 平躺 (侧面贴床), 零支撑 | 光电挡光滑片, **刀片径向外移 δ=2.0** (半径带 40.20–43.20 → **42.20–45.18**); 安装孔 X36.7/46.7 原位不动 → **顶架不用为它重印**; 刀片长度不变 (仍印长 42 装机剪短, 刀尖距压条顶 12mm) |
⚠ **2026-08-24 挡光滑片改对称**: `vane_slider_v3_1` → **`vane_slider_v4`** (在
`v4/models/photo_sensor_v4/`)。v3.1 与 v4 共用 `frame_B_v4`, 而 frame_B 的挂孔已外移到
**r38.7/48.7**, 所以这条线必须一起换; **frame_B_v4 要重印, frame_A_v4 不用**。
对称之后翻 180° 装反也一样 —— 原来装反刀片会落到 r38.6..41.3, 不碰东西但挡不到光轴。

| 5 | **counterweight_arm** | 1 | 底面贴床, 零支撑 | **共享新件** (`models/counterweight_arm/`): 转子配重臂, 骑罩顶跨接缝, M3×16 ×4 (2 颗进半A / 2 颗进半B) 顺带把两半连成一体; M6 六角头朝下卡窝, 杆上叠垫圈当配重。**外缘按 R85 裁, 不超 Φ170**。**偏心屏必装** —— 见下面动平衡章节 |

其余全部沿用: v4/print 的定子**三件** (baseplate_collar_v4 / flange_disc_v4 / mounting_flange_v4)
+ **顶轴承架 frame_A_v4 / frame_B_v4** + v3/print 的 hub_disc / rim_ring / wifi_shell。

⚠ **2026-08-19 baseplate_collar_v4 外形裁切**: 底盘 100×100 方 → **93.5 方 + 四角 R62.28 圆弧**
(直边/角弧都按 M6 大扁头 Φ12.5 外缘 + 壁 3 定), 89.14 cm³ (−6.9%)。孔位/凸台/套环全没动,
装配关系不变 —— 但 **v4/print 里那份要重新拿**, 旧 STL 作废。

⚠ **2026-08-04 已把 v3.1 的柱位同步到 v4**: 之前 v3.1 还停在 (±75,±75) + frame_v3,
和 v4 装不到同一块板上。现在统一为 **网格 M6 螺纹孔 (87.5,37.5) 族, POST_R 95.197
@23.199°+90k, 顶架 frame_A/B_v4** —— 柱脚用 M6 双头螺柱拧进螺纹孔。
挡光滑片在装配里的角向随之从 asm 45° 变 23.199°, **功能不受影响** (光电模块随转子扫全圈,
角向无约束; 只有半径/Z 有约束, 两项都没动) —— 件本身**不用改**。

## ★ 为什么孔要做 3 个 (关键设计点)

两个 T 件是**同一个件转 180°**放的。若把锁屏孔挪到 (+6.7,+64), 转 180° 后第二件的孔
落在 (−6.7,−64) → **两件会把屏往相反方向拉, 装不上**。

解法 = 顶托对称加宽 + X 方向 3 个离散孔。转 180° 后孔位仍是 (±6.7,−64)+(0,−64),
**两件都有 +6.7 那个孔可用**; 而且同一个件还支持居中装法 —— **拧不同的孔就能在
「居中 / 偏心」之间来回切换做对照实验, 不用重印**。压条与罩子的缝也都按"同时覆盖
两种落位"做的。用离散孔而非长槽是为了实验位置可重复。

## ⚠ 动平衡 (做实验前必读) — 2026-08-03 配重方案 (二改)

屏偏心 6.7 → 不平衡量 = **m_屏 × 6.7**。

**方案: 罩子上留 4 个 M3 安装点, 配重做成独立件 `counterweight_arm` 骑在罩顶跨接缝。**
(一改是"罩内埋 M6 螺母 + 顶板下挂凸台", 用户: "做的有点麻烦" → 废弃。)

之所以放罩子而不是转子盘: 盘已被罩子盖住够不着, 且 R77.5 那圈 8 个孔全占满
(4 T脚 + 4 罩沉井) —— **罩顶板是唯一还能拿到大力臂的地方**。

| | |
|---|---|
| 罩侧 | 每半 2 个: (X−50/−72, **半A Y+14 / 半B Y−14**) —— 顶板下挂 Φ9 凸台 Z43..50 + Φ4.2×4 铜花螺母窝 + Φ3.4 过孔 |
| | ⚠ **两半的孔关于 Y=0 镜像, 不是 180° 旋转** (A/B 本来就不是同件) |
| | ⚠ **M3×4×4.5 铜花螺母 ×4 要在扣半罩之前从罩内压进去** |
| 配重件 | `counterweight_arm` (共享件): **41×52×6 等厚平板**, 外缘按 R85 裁 ⇒ **不超 Φ170**; **2×Φ6.5 M6 光孔 @ (−77.7, ±6.5), 孔距 13**, 同半径 **r77.97** (2026-08-04 三改: 去掉凸台/六角窝) |
| 紧固 | **M3×16 ×4** 从罩外往下拧 — 2 颗进半 A、2 颗进半 B ⇒ **本件把两半在顶部连成一体** |
| 配重 | 2 颗 M6 螺栓 + Φ12 平垫/M6 螺母, **全部叠在板上面** — ⚠ 板下无空间, 螺杆往下伸出量必须为 0 |
| | ⚠ **孔距 13 ⇒ 垫圈外径 ≤ 13**: Φ12 平垫 (1.07 g/片) 或 M6 螺母 (2.29 g/个); Φ18 大垫圈用不了 |

**为什么在 −X**: 偏心屏往 +X 偏 6.7 → 不平衡矢量在 +X, 修正必须在 −X; 而罩子对开缝
正好是 Y=0 平面 (含 X 轴) ⇒ 骑在 −X 上天然跨缝, 两半各 2 孔, 完美吻合。

**容量** (叠高无上限 —— 罩顶往上到顶轴承架 290 全是空的; 力臂 r77.97 ×2 孔):

| 配置 (每孔, ×2 孔) | 两孔合计质量 | 力矩 (含件自重 +947) |
|---|---|---|
| M6×30 + 4 片 Φ12 平垫 | 28.2 g | 3143 g·mm |
| M6×45 + 10 片 | 47.1 g | 4617 g·mm |
| M6×60 + 16 片 | 66.0 g | 6091 g·mm |
| M6×80 + 26 片 | 95.5 g | 8389 g·mm |

**对照需求**: 屏 300 g → 2010 g·mm; 500 g → 3350; 800 g → 5360 g·mm
⇒ **整个量程都覆盖得住, 不用再动 rim_ring / 重印承载盘。**

- ⚠ **转速下必须防松**: 顶上用尼龙锁紧螺母或螺纹胶, 垫圈叠不许松动 —— 甩出去是安全事故
- ⚠ 叠高 >40mm 不建议 (弯矩和摆动都变差), 真需要更大配重就换更密的材料而不是继续加高
- 配重件自重 14.9 g PLA, 质心 r63.4 ⇒ 装上就自带 **947 g·mm** 同向配重 (上表已计入);
  v4 居中屏若不需要配重, **本件可以不装**
- 压条上那排 9×Φ6.5 力臂只有 11, 仍然**只够细调** (9 颗 M6×16 ≈ 36 g × 11 = 396 g·mm)
- **实验先低速跑 (≤850 RPM)**: 机器已有涡动问题 (f₁≈20–27 Hz, 临界 1200–1600 RPM),
  偏心会放大共振响应

## 光电重定位 (2026-07-31)

用户: 「光电开关的两个螺丝连线中点要在平移后屏幕的两个 M3 螺丝连线上」。
偏心后屏顶两颗 M3 在 (+6.7, ±64) → 连线是 X=+6.7, 故孔线中点 M: (0,−45) → **(6.7,−45)**。

⚠ **只平移会破坏「光轴过圆心」**(实测偏离 6.20)。用户选方案二: 平移 + **重解转角**
θ = asin(17/|OM|) = **21.9414°** (原 22.1961°) → 光轴仍过圆心 (垂距校验 = 17.000000)。
两孔 (±2.644, −51.481/−38.519) → **(+10.243, −51.037) / (+3.157, −38.963)**;
排针尾槽中心随 M, 长轴角 −67.804° → **−59.590°**。参数已通用化 + assert 卡死不变量。

⚠ 连带: 对射管焊脚随模块挪到 X≈18.9/21.2, 又跑出条外 (±16) → 上一轮加的避空孔作废已关。

## 校核状态

- 全对干涉 **153 对 ALL CLEAR** (含定子三件) (仅剩 2 处已知现象: rim_ring∩hub 面片咬合 2.15;
  pi2hub∩mlkpai 排针插合 955)
- 偏心屏扫掠 r_max **76.19** (原居中 75.30), 对柱内缘 102.07 余 25.9
- 压条 r_max 71.81, 对柱内缘余 30.3
- ★ **加宽压条引入过一处干涉并已修**: 对射管两个焊脚原本落在 X≈+12/+14 悬在
  条外(±9), 加宽到 ±16 后压到条上 (各扎入 1.5 深) → 已开 2×Φ3 避空孔, 复测 0

- **全周扫掠 1°×360 ALL CLEAR** (滑片 vs 光电/压条/屏, 共 1080 次布尔全 0)
  ★ 挡光片这件事上, **径向带比较法**(报 −0.15 干涉) 与 **(r,z) 占位法**(报完全不碰)
  **都给出了错误结论**, 只有布尔全周扫掠可信 —— 偏心弦布局必须扫掠验证

## 交付状态

- **A3 工程图 4 张全部 verifier PASS** (portal_tee_v3_1 / top_cap_v3_1_1 /
  rotor_shroud_v3_1 / vane_slider_v3_1), 各自随 STL 放在同一文件夹
- SCAD: portal_tee_v3_1 / rotor_shroud_v3_1 / top_cap_v3_1_1 已出 (主体几何可读副本;
  让位与布尔特征无法复刻, 以 STL 为准)。vane_slider **v3 本来就没 SCAD**, v3.1 同样跳过
- 仍未做: 装配指引 (assembly guide)

## 未做

装配指引。另: 动平衡方案与电机走线待定 (见上文)。
