kiujkiu/macha/v0.4/print/README.md

# POV3D v4 打印清单 (200×200 网格底板配置, 2026-07-29; 柱位改网格螺纹孔 2026-08-01)

**v4 = v3 换底板。** 洞洞板 300×300×12 → **方形网格板 200×200×13**
(卖家规格: M6 螺纹孔 距边 12.5 / 节距 25; 4 个安装孔 Φ6.5 通 + Φ11×6 沉, 距边 25)。

**2026-08-01 变更 — 四根柱改坐网格 M6 螺纹孔** (用户圈图指定):
柱位从板自带的 4 个安装孔 (±75,±75) 移到 **(87.5,37.5) 族网格螺纹孔**
`(87.5,37.5) / (-37.5,87.5) / (-87.5,-37.5) / (37.5,-87.5)`
→ **POST_R 106.066 → 95.197 (=12.5·√58), 柱角向 45+90k° → 23.199+90k°**。
螺纹孔不用螺母, M6 双头螺柱一头拧板一头拧柱底内丝, **板底完全不凸**。

⇒ **顶轴承架要重印** (`frame_A_v4` / `frame_B_v4`, 只有臂长和角向变了, 反而更短更硬,
打印足迹 137²→126.2²)。转子 / 屏幕支撑 / 电路罩 / 挡光滑片 **仍沿用 v3 原件**。

**要重印五件**: `baseplate_collar_v4` + `flange_disc_v4` + `mounting_flange_v4`
+ `frame_A_v4` + `frame_B_v4`。

**2026-07-29: 走线开口的补实已全部撤回** —— 用户先要求「补成整圈」, 随后确认描述有误,
三个开关 (`SLOT_ENABLE` / `OUTER_CUTOUT_ENABLE` / `NOTCH_ENABLE`) 已全部设回 `True`,
定子两件恢复原样。当前:
| 件 | 开口 |
|---|---|
| baseplate_collar_v4 | 凸台+套环 **75°–105° 走线缺口 H8** (电机线出口) |
| flange_disc_v4 | **0°–5° 走线槽 R40–50** (挖至 Z2, 深 2.5; 原 R40–82.5 已收窄); 外圈凸台 40°–45° 缺口**已去掉** → 凸缘整圈, **外圈恢复 8 孔** |

⚠ `flange_disc_v4` 与共享件 `models/flange_disc` **几何已不同**, 必须打 v4 这个。

11 个文件夹 / 13 个 STL, 共打 **14 件** (portal_tee_v3 打 2 个)。
整机堆叠在 `assembly/` (assembly_v4.stl + 预览) —— 仅装配核对, 不打印。

---

## ⚠ 装机前必读: 柱脚 & 板的正反面

**柱脚 (2026-08-01 改)** —— 柱坐 **网格 M6 螺纹孔** `(87.5,37.5)` 族, 不再用 4 个安装孔:

| 项 | 值 |
|---|---|
| 柱位 | (87.5,37.5) / (-37.5,87.5) / (-87.5,-37.5) / (37.5,-87.5), R95.197 @23.199°+90k |
| 紧固 | **M6 双头螺柱 (全牙螺柱) ×4** — 一头拧进板的 M6 螺纹孔, 一头拧进柱底轴向 M6 内丝 |
| 长度 | 板攻通 13 ⇒ **M6×25** (板内 13 齐平板底 + 柱内 12); 若柱内丝深 < 14, 降到 **M6×20** (10+10) |
| 要点 | **先量柱端内丝深度**; 螺柱拧板那头上中强度螺纹胶, 免得拆柱时把螺柱一起带出来 |

**板的正反面 —— 现在不强制翻面了。** 沉孔不再参与柱子固定, 哪面朝上都行。
推荐 **Φ11×6 沉孔朝上**: 空出来的那 4 个安装孔正好用来把整板锁死到桌面/机架,
螺丝头沉进 Φ11×6 里, 板面保持平整。(v3 的"翻面"要求作废。)

⚠ **柱内缘 R91.197 对转动件**: 罩/托盘 R85 余 **6.20mm**; 但 **wifi 那根插合的线缆母头
扫掠到 R90.51, 只余 0.72mm** —— 用户确认「线的问题可以处理」。**装机时这根线必须往内收**
(缩短 / 改角度 / 贴着罩壁走), 不能让母头甩到 R>91, 否则会打到柱子。

---

## 屏幕两种装法 (2026-08-24: v4 改成居中/偏心两用)

双面屏两个 LED 面在 X=±6.7, 面上任一点到轴的最近距离就是 6.7 ⇒ 成像中心有个 **Φ13.4 盲柱**
(占屏宽 8.9%, 成像面积 0.80%)。把屏整体偏 6.7 可以让**贴轴那面盲区归零**(另一面变 Φ26.8)。

**这两种装法用同一套打印件** —— 屏支撑三件的几何都做成「同时覆盖两种落位」+ X 向 3 个离散孔,
**拧不同的孔就能切换, 不用重印**:

| | 居中 (SCR_ECC = 0) | 偏心 (SCR_ECC = 6.7) |
|---|---|---|
| 屏占位 | X −6.7..+6.7 | X 0..+13.4 |
| 中心盲区 | Φ13.4 (两面对称) | 贴轴面 **0** / 另一面 Φ26.8 |
| 用哪个孔 | `portal_tee` / `top_cap` 的 **X=0** 孔 | 两件的 **X=+6.7** 孔 |
| 罩子屏缝余量 | −X 侧 0.30 / +X 侧敞 7.00 | −X 侧敞 7.00 / +X 侧 0.30 |
| 配重臂 | **可不装** (对称) | **必装** (不平衡量 = m_屏 × 6.7) |

```
python assembly_v4.py          # 居中
python assembly_v4.py --ecc    # 偏心
```

**★ 为什么是 3 个离散孔而不是长槽**: 两个 T 件是**同件转 180°** 放的。若把锁屏孔直接挪到
(+6.7,+64), 转 180° 后第二件的孔落在 (−6.7,−64) ⇒ **两件把屏往相反方向拉, 装不上**。
顶托对称加宽 + 3 个离散孔 (−6.7/0/+6.7) 之后, 转 180° 后孔位仍是 (±6.7,−64)+(0,−64),
两件都有 +6.7 可用。用离散孔而非长槽是为了实验位置可重复。

⚠ **光电位置不跟着屏走**。模块拧在压条上, 孔位打印时就烧死在 M=(6.7,−45) 那一解上,
所以**两种装法共用同一个光电位、同一片挡光滑片**。通用解保证光轴恒过圆心 ⇒ 索引脉冲两种
装法都准; 居中装时只是「孔线中点不再落在屏顶两颗 M3 的连线上」(那是 v3.1 的外观要求,
不影响功能)。

⚠ 居中装时罩子屏缝 +X 侧会敞开约 7 mm (只是漏灰, 不影响结构)。

**换了 4 个件, 其余 10 件原样**:

| 换 | 原件 → 新件 | 为什么 |
|---|---|---|
| ✅ | `portal_tee_v3` → **`portal_tee_v3_1`** ×2 | 顶托等宽 ±16 + 3 离散孔 |
| ✅ | `top_cap_v3_1` → **`top_cap_v3_1_1`** | 条宽 18→32, 屏孔 3×2, 光电重解 |
| ✅ | `rotor_shroud_v3` A/B → **`rotor_shroud_v3_1`** A/B | 屏缝改非对称 −7.0..+13.7 |
| ✅ | `vane_slider_v3` → **`vane_slider_v4`** | 刀片外移配新光电位, 并做成左右对称 |
| ❌ | `frame_A_v4` | **不用动** —— 顶轴承架只跟柱位和轴承有关, 碰不到屏 |
| ⚠ | `frame_B_v4` | 屏改动本身不影响它; 但 2026-08-24 为了让滑片对称, 挂孔外移 2.0 ⇒ **要重印这一件** |
| ❌ | 底盘 / 两个法兰 / hub / rim_ring / wifi 壳 / 配重臂 | 全在屏以下或与屏无关 |

**代价**: 每台净增 **+16.9 g** (压条 +14.2 / T 件 ×2 +5.8 / 罩子两半 −3.0)。

校核: 两种装法各跑全对干涉 **ALL CLEAR**; 罩缝余量按坐标核对 (⚠ 快照布尔在这里会失灵 ——
屏底与罩顶板相切时 `罩∩屏=0`, 冲突只在罩子往下套过屏时出现, 必须按屏实际落位定缝宽)。

---

## 挡光滑片改对称 (2026-08-24)

用户: 「vane_slider_v3_1 这个能做成对称的吗, 我理解 frame_A_v4 和 frame_B_v4 调整就行」。

**原来为什么不对称**: v3.1 把光电挪到 M(6.7,−45) 后刀片必须外移 δ=2.0 才不蹭, 当时为了
**不重印 frame_B** 只挪刀片、孔留原位 ⇒ 孔心 41.700 / 刀片中心 43.465, 差 **1.765**。
后果不只是难看 —— 绕竖轴翻 180° 装反时刀片落到 r38.6..41.3, **不碰任何东西但挡不到光轴**,
是个不报错的静默失效 (装上转起来就是没索引脉冲)。

**现在**: frame_B 两个挂孔外移 2.0 (36.7/46.7 → **38.7/48.7**), 刀片中心与板中心一起落到
**43.7** ⇒ 整件镜像对称, **装不反**。新件 `vane_slider_v4` (`v4/models/photo_sensor_v4/`),
件内 `SYM_C` 一个参数派生板/孔/刀片三者, 带对称性 assert。

**只重印 frame_B 一件** —— 只有 B 有这两个挂孔 (`VANE_BOLT_RS` 只作用在 `frame_b` 上),
`frame_A_v4` 重新生成后与改动前**逐字节一致**(脚本里有 cmp 校核)。滑片本身 1.1 g, 重量不变。

**校核 (全靠布尔全周扫掠, 不用径向带估)**:
- 居中 / 偏心两种装法各扫 **0.5° × 720 步 = 2160 次布尔**, 最大相交 **0.0000 mm³**
- 把刀片沿径向推着找边界 ⇒ 真实余量 **内侧 2.2 / 外侧 4.0 mm** (−2.25 与 +4.25 才开始蹭)
- ⚠ 这个实测结果和「按净通道 36.78..46.66 估」得到的 5.65/1.25 **几乎是反的** —— 又一次
  印证那条教训: 侧挂件的间隙只能扫掠, 不能拿半径带算。
- 相比原位置刀片外移了 0.235, 反而把偏紧的**内侧**余量从 1.97 加到 2.2。

---

## 打印件

| # | STL | 数量 | 切片姿态 | 说明 |
|---|-----|-----|---|---|
| 1 | **baseplate_collar_v4** | 1 | 原姿态 (底面贴床) | **v4 新件**: 底盘+套环合并件, 4×M6 角孔改 **方形节距 75 (对角 106.07)** → 脚落网格位 (±37.5,±37.5)。**2026-08-19 外形裁切: 100×100 方 → 93.5 方 + 四角 R62.28 圆弧** (直边/角弧都 = M6 大扁头 Φ12.5 外缘 + 壁 3), 89.14 cm³ (原 95.73, −6.9% ≈ −8 g)。走线缺口 75°–105° 保留; 其余(套环 OD84 / 8 个法兰孔双面铜螺母窝 / 4×M3+Φ7 沉)与 d100 相同 |
| 2 | **flange_disc_v4** | 1 | 原姿态 | **v4 新件** (几何已与 v3 的 flange_disc 不同, 必须重打): 0°–5° 走线槽 R40–50 (深 2.5); 外圈凸缘整圈无缺口, 外圈 8 孔 |
| 3 | **mounting_flange_v4** | 1 | 原姿态 | **v4 新件**: 安装法兰 (翻转扣顶); 外圈凸台两个 5° 缺口 (−5..0° / −45..−40°) **已去掉 → 整圈** |
| 4 | hub_disc | 1 | 原姿态 | 转子毂盘 (正放贴电机; 凸台 Φ70/Φ50, 内圈孔 PCD Φ60) |
| 5 | rim_ring | 1 | 原姿态 (承载面朝下) | Φ170 托盘环 (11 铜花螺母 + 4 头沉孔) |
| 6 | **portal_tee_v3_1** | **2 (同件)** | 平躺: 外侧平整面贴床, 零支撑 | 屏底支撑 T 型件, 180° 对放。**两用版**: 顶托由梯形(内13.4/外20)改**等宽 ±16**, 屏孔 **3 个离散位 (−6.7/0/+6.7)** → 拧不同孔切换居中/偏心。16.4 cm³ (原 12.6) |
| 7 | **top_cap_v3_1_1** | 1 | 平躺 (顶面贴床), 零支撑 | 顶部薄压条 **32**×140×7 (原 18 宽, ±9 盖不住偏心后的屏)。屏孔 3×2 离散位; 光电孔 M=(6.7,−45) 重解转角保光轴过圆心; −X 悬空区 9×Φ6.5 配重孔。27.6 cm³ |
| 8 | wifi_shell | 1 | 倒扣 (开口/沿朝下), 零支撑 | WiFi 壳 (已砍脚: 盘缘裁切 R83.5) |
| 9 | **frame_A_v4 / frame_B_v4** | 各 1 | A 正立 / B 已翻转姿态 | **v4 新件, 必须重印**: 顶轴承架, POST_R 95.197 @23.199°+90k (v3 是 106.07 @45°), 臂条 77.20 (v3 88.07), 打印足迹 126.20²。**2026-08-24: frame_B 的挡光滑片挂孔外移 2.0 → r38.7/48.7** (配对称版滑片); **frame_A 逐字节没变** |
| 10 | **rotor_shroud_v3_1**: shroud_half_A_v3_1 / shroud_half_B_v3_1 | 各 1 (**非同件**) | **绕 X 翻 180°, 顶板贴床**, 零支撑 | 转子电路罩 Φ170/Φ164 壁3 × 高50 + 2 厚封顶带屏缝。**两用版**: 屏缝改非对称 **X −7.0..+13.7**, 同时覆盖居中(±6.7)与偏心(0..13.4); 每半 2× 沉井立柱。**A 含 wifi 壳让位窝, B 含线缆出口槽**; **各带 2 个 M3 配重安装点** (Φ9 凸台 + 铜花螺母窝; 配 counterweight_arm) |
| 11 | **vane_slider_v4** | 1 | 平躺 (侧面贴床), 零支撑 | 光电挡光滑片, **左右对称版** (2026-08-24): 板/孔/刀片三者同心于 X=43.7 ⇒ **装不反**。孔 X38.7/48.7, 刀片半径带 42.43..45.41。**装机按架高剪短刀片**, 刀尖距压条顶 12mm。⚠ 配套 **frame_B_v4 挂孔外移 2.0, 必须重印 frame_B** (frame_A 不用) |
| 12 | **counterweight_arm** | 1 (可选) | 底面贴床, 零支撑 | **新件 (v3/v3.1 共用)**: 转子配重臂, 骑罩顶跨接缝, M3×16 ×4 (2 颗进半A / 2 颗进半B) 把两半连成一体; **2×Φ6.5 M6 光孔, 孔距 13** (等厚平板, 无凸台无沉孔)。**外缘按 R85 裁, 不超 Φ170**。居中屏若不需配重可不装 |

> ✓ `frame_A_v4` 的 A3 图纸已于 2026-08-04 补出 (v3 起欠了很久)。A/B 由同一 `frame_piece()` 生成, 只差 Z 分层: **A 筋在臂上 (z8..16), 688 窝朝上 (z3..8), 垫柱高 8 → M6×16, 正立打印**; **B 筋在臂下, 窝在 z11..16, 垫柱高 16 → M6×30, 翻转打印, 且多 2×Φ3.2 挡光滑片挂孔**。

---

## 多台生产 (2026-08-24 汇总)

**一台 = 14 个 STL / 15 个打印件** (portal_tee_v3 ×2, 其余各 1; counterweight_arm 居中屏可不装)。

用料 (实心体积 × 1.24, **是上限**, 实际带填充会更少):

| | 每台 | ×2 | ×3 | ×5 |
|---|---|---|---|---|
| 必打 13 件 | 933 g | 1.87 kg | 2.80 kg | 4.66 kg |
| 含配重件 (偏心装法必装) | 947 g | 1.89 kg | 2.84 kg | 4.74 kg |
| 1 kg 料盘 (留 15% 余量) | 2 | 3 | 4 | 6 |

最重的五件: rim_ring 139 / flange_disc_v4 119 / hub_disc 112 / baseplate_collar_v4 111 / shroud 半 85 g。

**排版 (256×256 床, 每台 7 床)**:
- 床 1–4: `rim_ring` / `mounting_flange_v4` / `flange_disc_v4` / `hub_disc` —— 四个 Φ165–170 大盘**只能一床一件**, 这是床次下限 (N 台 = 4N 床)
- 床 5: 罩子 `shroud_half_A_v3_1` + `shroud_half_B_v3_1` 并排 (170×84.8 ×2 = 170×170) 正好一床一台份
- 床 6: `frame_A_v4`(正立) + `frame_B_v4`(翻转) —— 126.2² ×4 = 252.4² 还塞得下, **两台可并一床**
- 床 7: 小件全家桶 (`baseplate_collar_v4` / `portal_tee_v3_1`×2 / `top_cap_v3_1_1` / `wifi_shell` / `vane_slider_v4` / `counterweight_arm`) —— 按面积能塞两台份
- ⇒ N 台约 **5N + 2·⌈N/2⌉** 床 (3 台 ≈ 19 床)
- ⚠ 拼盘一次废好几件; rim_ring 和两个罩子半最贵 (86–139 g), 稳妥起见单独打

**铜花螺母 M3×4×4.5 是最容易备少的**: rim_ring 11 + baseplate_collar_v4 8(底面) + hub_disc 底外圈 8 (4 T脚 + 4 罩子) = **31/台**, 含配重 35/台。
⚠ 本文件下面「外购件」那节原来只列了 rim_ring 11 + 底盘 8 = 19, **漏了 hub 底那 8 个和罩子那 4 个**。会烫歪会拔出, 建议按 **45/台** 备料。

> 可交互版 (选台数自动换算全部数量/耗料/采购数): 见 artifact「POV3D V4 打印单」。

---

## 底板 (外购, 不打印)

**方形网格板 200×200×13**, **翻面使用**:

| 特征 | 规格 | 用途 |
|---|---|---|
| M6 螺纹孔 8×8 | 距边 12.5, 节距 25 → **±12.5/±37.5/±62.5/±87.5** | 底座 4 脚 **(±37.5,±37.5)**; **4 根柱 (87.5,37.5) 族**; 其余可从下方锁桌面/机架 |
| 4 安装孔 | Φ6.5 通 + Φ11×6 沉, 距边 25 → **(±75,±75)** | **已空出** → 把整板锁死到桌面/机架 (沉孔朝上藏螺丝头) |

⚠ **底座质量 8.5kg → 4.1kg (钢)**。底座质量是吸收转子不平衡的主要手段, 对已知涡动问题
(f₁≈20–27 Hz, 临界 1200–1600 RPM) 是负面的 —— **强烈建议用 M6 螺纹孔从下方把板锁死在
桌面或机架上**, 锁上之后比原来自由放置的重板更好。

---

## 外购件 / 五金要点

- **双面屏一体模组 13.4×150×168.75 ×1** (LED 双外侧面; 底/顶面各 3×M3 通孔 居中 @64)
- **柱 Φ8×290 ×4 @ 网格螺纹孔 (87.5,37.5) 族** (2026-08-01 用户圈图指定) —— 坐板面,
  **M6 双头螺柱 ×4** 一头拧板 M6 螺纹孔、一头拧柱底轴向 M6 内丝。M6×25 (板内 13 + 柱内 12),
  柱内丝浅则 M6×20。板底不凸, 不用螺母。
  - ⚠ 柱必须是**轴向 M6 内丝**的 Φ8 螺柱 (与顶轴承那根同款), 装前量内丝深度
  - 板自带的 4 个 Φ6.5+Φ11×6 安装孔**现在空着**, 留给「把整板锁死到桌面/机架」
- **底座 4×M6 → 网格螺纹孔**: 螺丝穿底盘 5 厚拧入板 (13 厚攻丝) ⇒ **M6×16** (旋入约 11)。
  用 **M6 大扁头** (头 Φ12.5 × 厚 2.6, 内六角对边 4), 头直接坐底盘顶面 Z5..7.6, **不做沉孔**
  (上方 Z5..18 除凸台/套环 r≤42 外全空, 不干涉)。**底盘外形就是按这个头径裁的 (壁 3)**,
  换更大头径的螺丝 (如 M6 圆柱头带垫圈) 会顶出件外 —— 要换先回头改 `EDGE_WALL`/`M6_HEAD_D` 重生成。
  ⚠ 手上若是 **M6×10** 的大扁头, 穿完 5 厚底盘只剩 5 mm 旋入, 预紧偏弱, 建议按 BOM 用 M6×16。
  ⚠ 与 v3 不同: 旧洞洞板是光孔+螺母, 新板是螺纹孔, **不需要螺母**
- **中间轴: M6×20 平头 + Φ8×40 单头内丝螺柱 + 688 轴承 ×2** (轴承 293..298 / 301..306;
  ⚠ M6 必须在压屏前装入压条底头窝)
- **光电**: 对射模块平贴压条顶 (M3×12×2 自下经底面头窝, 螺母锁 PCB 上) + 挡光滑片 vane_slider_v3
  锁 frame_B 45° 臂筋侧 (M3×20+螺母 ×2)
- 屏幕固定: 底 M3×12 ×2 (T 件托底向上) + 顶 M3×12 ×2 (压条顶向下); 屏底/顶中央孔空置
- T 件脚: **M3×20 ×4** (T 底条 5 + 环 5 + hub ~5.5 入 hub 底铜花螺母)
- **转子电路罩: M3×12 (头 Φ7.5) ×4** — 坐 Φ9 沉井底 3 厚台肩, **长螺丝刀顺井 (深 47) 下去拧**;
  借 rim_ring 4 个空闲外圈环孔 (装配 112.5/157.5/292.5/337.5°)。⚠ M3×14 会探出 hub 底顶到电机
- **配重 (2026-08-04 三改, 用户: "窄了, 做宽一点, 能放下 2 个 M6 螺丝, 只保留 M6 通孔
  就可以了, 不需要凸台, M6 螺丝间距要有 13mm")** —— 罩子上 4 个 M3 安装点不变
  (半 A 2 个 @ (X−50/−72, Y+14), 半 B 2 个 @ (X−50/−72, Y−14), **两半关于 Y=0 镜像**),
  配重件 **`counterweight_arm`** 骑在罩顶跨接缝:
  - 罩侧: 顶板下挂 Φ9 凸台 Z43..50 + Φ4.2×4 **铜花螺母窝** + Φ3.4 过孔。
    ⚠ **M3×4×4.5 铜花螺母 ×4 要在扣半罩之前从罩内压进去**
  - 配重件: **41×52×6 等厚平板** (外缘按 R85 裁, **不超 Φ170**), **无凸台无沉孔**;
    **2×Φ6.5 M6 光孔 @ (−77.7, ±6.5), 孔距 13.0** —— 同半径 r77.97, 合矢量在 −X 轴上
  - **M3×16 ×4** 从罩外往下拧 —— 2 颗进半 A、2 颗进半 B ⇒ **本件把两半在顶部连成一体**
  - ⚠ **本件底面整个贴在罩顶面上, 板下没有任何空间** —— M6 的头/螺母/垫圈只能全放在
    **板上面**, 螺杆往下伸出量必须为 **0** (否则会顶在罩顶板上把件撑起来)。
    真要让螺杆往下伸, 把 build_shroud.py 的 `CWM_M6_CLR_ENABLE` 打开 (罩顶开 2×Φ7.5 让位孔)
  - ⚠ **孔距 13 ⇒ 垫圈外径 ≤ 13**: 只能用 M6 标准平垫 Φ12×1.6 (1.07 g/片) 或 M6 螺母
    (对角 11.55, 2.29 g/个); **Φ18 大垫圈两片会打架, 用不了**
  - 容量 (2 孔合计): 每孔 M6×45+10 片 Φ12 平垫 → 3670 g·mm; 每孔 M6×80+26 片 → 7442
    (件自重 14.9 g PLA 另带 947 g·mm 同向)
  - ⚠ **转速下必须防松** (尼龙锁紧螺母或螺纹胶); v4 居中屏若不需要配重, **本件可不装**
- 定子锁紧: **M3×30 + 垫圈叠 4.5mm ×8** (法兰顶穿 flange_disc + 套环 入底盘底面铜花螺母)
  ⚠ 2026-08-28 降幅定为 2.5 (曾短暂按降 5 改过 M3×25, 作废): 套环 13→10.5 后夹持
  3+7+10.5+5 = **25.5** (原 28)。**螺丝仍用 M3×30, 把垫圈从 2mm 叠到 4.5mm** 补掉这 2.5
  ⇒ 30−4.5 = 25.5, 尖端正好齐底盘底面, 铜花螺母吃满 4。单垫圈方案要 M3×27.5 非标长度, 不推荐。
  ⚠ 垫圈没叠够 = 螺杆从底盘底面伸出去, 把整个定子顶离网格底板。
- 铜花螺母 M3×4×4.5: rim_ring 11 (7 pi2hub + 4 wifi) + baseplate_collar_v4 8 (**底面**; 顶面那 8 个沉孔 2026-08-28 已取消, 件上不再有); wifi 壳 M3×8 ×4
- 电机 C4110 320KV/6S Φ50×26.7; 电源 (PSU) 仍未画未定位

---

## 装配顺序要点

1. **底板翻面**放好 (平面朝上, 沉孔朝下)
2. baseplate_collar_v4 居中 (**不再转 45°**), 4×M6×16 拧入 (±37.5,±37.5) 网格孔
3. flange_disc_v4 + mounting_flange_v4 + 8× M3×30+4.5mm 垫圈叠 锁紧定子
4. 电机 → hub_disc → rim_ring → pi2hub/米联派/wifi 甲板
5. 4 根柱: **M6 双头螺柱先拧进 (87.5,37.5) 族网格螺纹孔** (上螺纹胶), 再把柱旋上去坐实板面
   (柱位对比图: `../assembly/post_grid_options.png`)
6. portal_tee ×2 → 屏模组 → 压条 (M6 先装!) → 顶轴承架 + 688
7. **转子电路罩**: 在离位 ≥60mm 高度横向滑入 (屏从屏缝进) → 竖直落下 → 4× M3×12 顺沉井拧紧
   (**扣罩前先把 4 颗 M3×4×4.5 铜花螺母压进两半的配重凸台窝里**)
8. **counterweight_arm** 骑罩顶跨接缝, M3×16 ×4 拧紧 (2 颗进半A / 2 颗进半B); M6 螺栓 ×2 + Φ12 平垫叠在板上面, 按动平衡实测加配重 (⚠ 杆不许往下伸)
8. 挡光滑片按实际架高剪短刀片装上

---

## 与 v3 的差异一览

| 项 | v3 | v4 |
|---|---|---|
| 底板 | 洞洞板 300×300×12, 孔 0/±25…±125 | **网格板 200×200×13** (翻面), 孔 ±12.5/±37.5/±62.5/±87.5 + 安装孔 (±75,±75) |
| 底座 | baseplate_collar_d100 (对角 100) | **baseplate_collar_v4 (节距 75 / 对角 106.07)**; 走线缺口不变 |
| 装配 ROT | 45° (脚落轴向 ±50) | **0°** (脚落对角网格 ±37.5) |
| 底座固定 | M6 穿光孔 + 螺母 | **M6×16 拧入螺纹孔, 无螺母** |
| 柱位 | (±75,±75), R106.07 @45° | **网格螺纹孔 (87.5,37.5) 族, R95.197 @23.199°** |
| 柱脚紧固 | M6 螺杆 + 螺母 | **M6 双头螺柱拧入螺纹孔, 板底不凸** |
| 顶轴承架 | frame_A/B_v3 | **frame_A/B_v4 (臂短 10.87, 角向转 −21.8°), 必须重印** |
| 其余全部零件 | — | **完全相同, 不用重印** |
