kiujkiu/macha/v0.2/print/README.md

# POV3D v2 打印清单 (2026-07-13 整理; 2026-07-22 随转子重构同步)

本文件夹 = v2 (单屏配置) 整机**全部 3D 打印件**, **每零件一个子文件夹, 内含 STL (3D) + 加工图 PDF (2D)**。
11 个文件夹 / 13 个 STL, 共打 **13 件**。材料 PETG 或 ABS, 旋转件 4+ 圈壁、≥40% 填充。
整体堆叠在 `assembly/` (assembly_v2.stl + 预览图) — **仅装配核对, 不打印**。

**2026-07-21/22 转子重构 (本清单已同步)**:
- **mlkpai_carrier_disc 取消** — 功能并入 rim_ring (翻转当承载面, 7 pi2hub 孔随迁)
- **hub_disc 改正放** 贴电机 (不再翻扣嵌入), 凸台 80/60→70/50, 内圈孔 PCD Φ70→Φ60
- **rim_ring v3**: 中孔 ID50 / 内凸台环 OD80/ID70×2.5 / 挖槽 R40..61 / +4 wifi 沿孔 + 4 头沉孔 Φ7.5×2
- **wifi_box → wifi_shell** (侧开口五面盒+双端沿, 罩放平模块, 盒位 XC43+长边-15)
- **光电三件 (sensor_bracket_v2 / index_vane_v2 / module) 暂删**, 等大改方案
- 作废件挪至 `_obsolete_20260722/` 留档
- ⚠ v3/print **未**随本轮重构同步 (v3 装配还是旧转子结构), 旧的"与 v3 相同"说法作废

## 打印件

| # | STL | 数量 | 切片姿态 | 说明 |
|---|-----|-----|---|---|
| 1 | baseplate_collar_d100 | 1 | 原姿态 (底面朝下) | 套环 Φ84 / 8×Φ3.2+Φ4.2×4 沉孔(顶+底) / 开口内外同高 H8。**2026-08-19 外形裁切: 100×100 方 → 89.21 方 + 四角 R59.25 圆弧** (= M6 大扁头 Φ12.5 外缘 + 壁 3), 85.22 cm³ (原 95.73, −11%)；孔位/凸台/套环没动 |
| 2 | flange_disc | 1 | 原姿态 | 定子法兰盘 |
| 3 | mounting_flange | 1 | 原姿态 | 安装法兰 (装配时翻扣; 定子锁紧 M3×30+2mm垫圈 ×8 长螺丝入 d100 底面铜花螺母, 夹持 28) |
| 4 | hub_disc | 1 | 原姿态 | 转子毂盘 (正放贴电机; 凸台 Φ70/Φ50, 内圈孔 PCD Φ60) |
| 5 | rim_ring | 1 | 原姿态 (承载面朝下) | Φ170 托盘环 v3 (承载盘并入): 装配翻转扣 hub 上; 唇侧压 11 颗 M3×4×4.5 铜花螺母 (7 pi + 4 wifi) |
| 6 | gantry_base_A / _B | 各 1 | **侧躺: 外侧面 (Y=±83.5 筋墙面) 贴床**, 零支撑 | **镜像对, 不是同一件!** A=+Y 件 / B=−Y 件 |
| 7 | screen_plate | 1 | **平躺: 前面 (X=−7.27 面) 朝下** | 单屏立板, 全部竖直通孔免支撑 |
| 8 | top_cap_v2 | 1 | 原姿态 (板顶贴床, L 腿朝上) | L 型转子顶帽, 19×M6 配重孔阵在 −X 端 (v2.1 用 top_cap_v2_1 替代) |
| 9 | wifi_shell | 1 | 倒扣姿态 (开口/沿朝下) 零支撑 | 新 WiFi 壳: 罩放平网卡模块 (40×70 面贴盘), +Y 端出口窗切穿沿板 |
| 10 | frame_A_v2 / frame_B_v2 | 各 1 | 原姿态 (A 正立 / B 已是翻转打印姿态) | 顶轴承架, 共一张图 (v2.1 用 *_v2_1 替代) |

## 外购件要点 (随重构变化项)

- 屏幕 1 块 150×169×7.27; 顶帽固定 M3×16 ×2 (穿帽腿4+板6 入屏顶螺母)
- **铜花螺母 M3×4×4.5: rim_ring 11 颗 (7 pi2hub + 4 wifi, 唇侧压入) + d100 底面 8 颗**
- **wifi_shell 固定: M3×8 ×4** (沿3+台肩0.5+螺母4.5; 替代旧盒 M3×14×4)。⚠ 靠母头出口的
  2 颗别加 Φ7 垫片 (距母头仅 0.3), 盘头直压
- **ring↔hub 锁紧 16×M3**: wifi 角落 4 颗 (内圈+外圈 R77.5 的 202.5°/247.5°) 用盘头,
  头沉入承载面 Φ7.5×2.0 头沉孔 (内圈 2 在 wifi 模块底下, 外圈 2 挨盒东侧), 其余 12 颗头外露
- 光电件暂删, 其余五金同旧清单 (洞洞板 / C4110 / Φ8×350 柱×4 / 688×2 / M6×40+Φ8×50 /
  塔柱 M3×18/20×6 / 尼龙柱 / 网卡 / 电机 M3、d100 M6 等), 电源仍未画
