kiujkiu/macha/v3/print/README.md

# POV3D v3 打印清单 (双面屏配置, 2026-07-27 加转子电路罩)

v3 = 双面屏一体模组 13.4×150×168.75 (LED 两外侧面, 底/顶面各 3×M3 居中 @64) +
2026-07-21/22 转子重构 (承载面 = rim_ring 托盘顶 42.2) + **柱 ±75×290** (2026-07-23:
再内移 1 格 + 光电搬顶部配套加高 1cm)。每零件一个子文件夹 (STL + 加工图 PDF)。
**11 个文件夹 / 14 个 STL, 共打 14 件**。
整体堆叠在 `assembly/` (assembly_v3.stl + 预览) — 仅装配核对, 不打印。

## 打印件

| # | STL | 数量 | 切片姿态 | 说明 |
|---|-----|-----|---|---|
| 1 | baseplate_collar_d100 | 1 | 原姿态 | 与 v2 共用最新版。**2026-08-19 外形裁切: 100×100 方 → 89.21 方 + 四角 R59.25 圆弧** (= M6 大扁头 Φ12.5 外缘 + 壁 3), 85.22 cm³ (−11%)；孔位/凸台/套环没动, 装配关系不变, 旧 STL 作废 |
| 2 | flange_disc | 1 | 原姿态 | 定子法兰盘 |
| 3 | mounting_flange | 1 | 原姿态 | 安装法兰 (定子锁紧 M3×30+垫圈 ×8) |
| 4 | hub_disc | 1 | 原姿态 | 转子毂盘 (正放贴电机; 凸台 Φ70/Φ50, 内圈孔 PCD Φ60) |
| 5 | rim_ring | 1 | 原姿态 (承载面朝下) | Φ170 托盘环 v3 (11 铜花螺母 + 4 头沉孔) |
| 6 | **portal_tee_v3** | **2 (同件)** | **平躺: 外侧平整面贴床**, 零支撑 | 屏底支撑 T 型件, 180° 对放; 梯形壁+平板托 (托面 Z50), 帽让位窝 |
| 7 | **top_cap_v3_1** | 1 | 平躺 (顶面贴床), 零支撑 | 顶部薄压条 18×140×7 v6 (M6 头窝朝下; 光电模块绕孔中点 M(0,-45) 转 22.196°, 2×Φ3.2 @(±2.64,-38.5/-51.5)+底面 Φ7.5×2.5 头窝+斜置排针尾避空槽 9×8 挖穿 (对称于孔连线); **光轴过圆心**, 不加宽) |
| 8 | wifi_shell | 1 | 倒扣姿态 (开口/沿朝下) 零支撑 | WiFi 壳 (罩放平网卡) |
| 9 | **frame_A_v3 / frame_B_v3** | 各 1 | A 正立 / B 已翻转姿态 | 顶轴承架 v3 短臂 (柱 ±75, POST_R 106.07, 打印 137², 臂筋 4×8; **frame_B ang=90 臂筋带 2×Φ3.2 横向圆孔** (r36.7/46.7 孔距 10, 居中 z4 = asm 294, 挂挡光滑片); B 图纸已出, A 图纸待出) |
| 10 | **rotor_shroud_v3**: shroud_half_A_v3 / shroud_half_B_v3 | 各 1 (**非同件**) | **绕 X 翻 180°, 顶板贴床**, 零支撑 | 转子电路罩, 两半对开: 筒 Φ170/Φ164 壁 3 × 高 50 (承载面 42.2 → 屏底 92.2, 外壁与盘缘齐平) + **2 厚**封顶带屏缝 (2026-07-27 减重 3→2, 屏缝下翻边随之变 7 深补刚度) (±7 → ±10.3 加宽让 T 顶托, \|Y\|>78 封口)。每半 2× 沉井立柱 Φ14 @ r77.5 (Φ9 井直通顶板 + 井底 3 厚台肩 + Φ3.4 过孔 + Φ3.4→Φ5 引导锥)。占地 170×85×50, 两半可同盘。**A/B 不是同一个件**: A 含 wifi 壳让位窝, B 含线缆出口槽; **各带 2 个 M3 配重安装点** (Φ9 凸台 + 铜花螺母窝; 配 counterweight_arm) |
| 11 | **vane_slider_v3** | 1 | 平躺 (侧面贴床), 零支撑 | 光电挡光滑片 16×8×4 板 (恰填筋侧面: 底平筋底/顶抵臂底定位) + 垂刀**印长 42 (全件 50)**, 2×Φ3.2 圆孔 (板正中, 两件都圆孔无槽); M3×20+螺母 ×2 锁 frame_B 45° 臂筋侧; **装机按架高剪短刀片** (M8 螺柱长度不稳补偿), 目标: 刀尖距压条顶面 12mm |
| 12 | **counterweight_arm** | 1 (可选) | 底面贴床, 零支撑 | **新件 (v3/v3.1 共用)**: 转子配重臂, 骑罩顶跨接缝, M3×16 ×4 (2 颗进半A / 2 颗进半B) 把两半连成一体; **2×Φ6.5 M6 光孔, 孔距 13** (等厚平板, 无凸台无沉孔)。**外缘按 R85 裁, 不超 Φ170**。居中屏若不需配重可不装 |

## 外购件 / 五金要点

- **双面屏一体模组 13.4×150×168.75 ×1** (LED 双外侧面; 底/顶面各 3×M3 通孔 居中 @64, 孔深未实测)
- **柱 Φ8×290 ×4 @ (±75,±75)** (光电叉顶 285.65 对架臂底 290 隙 4.35)
- **中间轴: M6×20 平头 + Φ8×40 单头内丝螺柱 + 688 轴承 ×2** (轴承 293..298 / 301..306;
  螺柱底坐压条顶兼锁紧; ⚠ M6 必须在压屏前装入压条底头窝)
- **光电 (2026-07-23 回归, 顶置最小方案)**: 对射模块平贴压条顶 (M3×12×2 自下经底面头窝, 螺母锁 PCB 上;
  光轴过圆心 (模块绕孔中点转 22.196°; 刀片中心 r41.7, 净通道 r36.78..46.66 余量 ~3.4/侧), 排针尾走斜置穿透避空槽, 对射脚悬空) + 挡光滑片 vane_slider_v3 锁 frame_B 45° 臂筋侧
  (2026-07-24 终版: 刀片印长 50 装机剪短补偿 M8 螺柱长度偏差; M3×20+螺母 ×2 全通孔); 模块外缘 r≈58,
  不再决定转子包络 (旧方案 r113); 索引角 ≈ 50° (45° 筋 + 侧挂偏置); 全周 5° 步进扫掠校核 ALL CLEAR
- 屏幕固定: **底 M3×12 ×2** (T 件托底向上, 帽沉 Φ7.5 让位窝) + **顶 M3×12 ×2** (压条顶向下);
  屏底/顶中央孔空置
- T 件脚: **M3×20 ×4** (T 底条 5 + 环 5 + hub ~5.5 入 hub 底铜花螺母)
- **转子电路罩: M3×12 (头 Φ7.5) ×4** —— 坐 Φ9 沉井底 3 厚台肩, 头沉在井里不露头,
  **长螺丝刀顺井 (深 47) 下去拧**; 穿 rim_ring 托盘 5 + hub 实体 1 → 拧进 hub 底既有铜花螺母
  (旋入 3.0; **M3×14 会探出 hub 底 0.5 顶到电机端面, 只能用 12**)。借 rim_ring 4 个空闲外圈
  环孔 (装配 112.5/157.5/292.5/337.5°) —— 原占这 4 孔的 ring→hub 短螺丝拆掉换成这 4 颗,
  **rim_ring 不用改**。装配顺序: 罩子在离位 ≥60mm 高度横向滑入 (屏从屏缝进) → 竖直落下 →
  拧 4 颗螺丝 (三段运动已做布尔模拟, ALL CLEAR)
- **配重 (2026-08-04 三改, 用户: "窄了, 做宽一点, 能放下 2 个 M6 螺丝, 只保留 M6 通孔
  就可以了, 不需要凸台, M6 螺丝间距要有 13mm")** —— 罩子上 4 个 M3 安装点不变
  (半 A 2 个 @ (X−50/−72, Y+14), 半 B 2 个 @ (X−50/−72, Y−14), **两半关于 Y=0 镜像**),
  配重件 **`counterweight_arm`** 骑在罩顶跨接缝:
  - 罩侧: 顶板下挂 Φ9 凸台 Z43..50 + Φ4.2×4 **铜花螺母窝** + Φ3.4 过孔。
    ⚠ **M3×4×4.5 铜花螺母 ×4 要在扣半罩之前从罩内压进去**
  - 配重件: **41×52×6 等厚平板** (外缘按 R85 裁, **不超 Φ170**), **无凸台无沉孔**;
    **2×Φ6.5 M6 光孔 @ (−77.7, ±6.5), 孔距 13.0** —— 同半径 r77.97, 合矢量在 −X 轴上
  - **M3×16 ×4** 从罩外往下拧 —— 2 颗进半 A、2 颗进半 B ⇒ **本件把两半在顶部连成一体**
  - ⚠ **本件底面整个贴在罩顶面上, 板下没有任何空间** —— M6 的头/螺母/垫圈只能全放在
    **板上面**, 螺杆往下伸出量必须为 **0** (否则会顶在罩顶板上把件撑起来)。
    真要让螺杆往下伸, 把 build_shroud.py 的 `CWM_M6_CLR_ENABLE` 打开 (罩顶开 2×Φ7.5 让位孔)
  - ⚠ **孔距 13 ⇒ 垫圈外径 ≤ 13**: 只能用 M6 标准平垫 Φ12×1.6 (1.07 g/片) 或 M6 螺母
    (对角 11.55, 2.29 g/个); **Φ18 大垫圈两片会打架, 用不了**
  - 容量 (2 孔合计): 每孔 M6×45+10 片 Φ12 平垫 → 3670 g·mm; 每孔 M6×80+26 片 → 7442
    (件自重 14.9 g PLA 另带 947 g·mm 同向)
  - ⚠ **转速下必须防松** (尼龙锁紧螺母或螺纹胶); v4 居中屏若不需要配重, **本件可不装**
- **⚠ 罩子加了约 171 g 且几乎全在 r≈85** —— 极惯量增量很大且抬高转子 CG, **动平衡需重做**;
  v3 目前无配重挂点, 必要时用盘面空环孔
- 铜花螺母 M3×4×4.5: rim_ring 11 (7 pi2hub + 4 wifi) + d100 8; wifi 壳 M3×8 ×4;
  pi2hub 尼龙柱/网卡/电机 M3 / d100 M6 同 v2 清单; 光电暂删; 电源仍未画
- **wifi_shell 已于 2026-07-27 砍脚重出 (必须重打)**: -Y 端沿外角按盘缘 R83.5 圆弧切齐,
  装配系 r_max 90.22 → 83.50, 收进 Φ170 盘缘内; 4 颗沿螺丝孔全保留 (最外那颗 r79.06 孔周完好)
- 与 v2/print 的差异: 屏幕系统全换 (单屏门形→双面屏 T 件×2+压条), 柱 350→280,
  作废件在 `_obsolete_20260723/`
