kiujkiu/macha/v0.3/print/baseplate_collar_d100/baseplate_collar_d100_drawing.pdf

# POV 3D 底盘+套环 合并件 (M6 对角100) Baseplate + Ring Collar d100

89.21×89.21×5 底盘 (四角 R59.25) / 4×M6 (对角100) / 4×M3+Φ7×2 沉孔 / 中央 Φ12×1 沉孔(顶) / 凸台 Φ65/Φ55 H23 / 套环 Φ84/Φ65 H13 / 槽口 75°–105° 对齐 / 8×Φ3.2+Φ4.2×4沉(顶+底) PCD Φ72.5

## 俯视图 Top View (1:1) 尺寸单位: mm

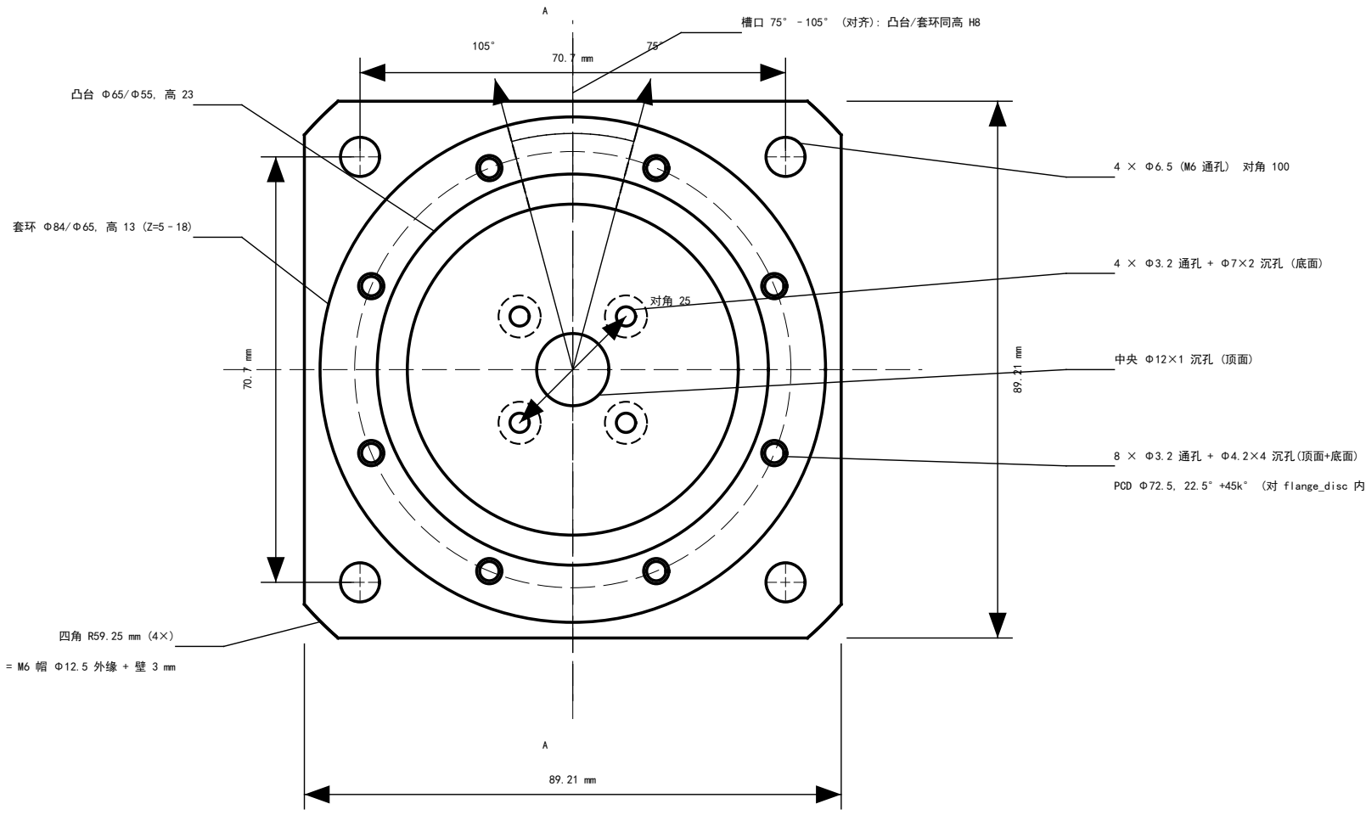
[picture p142: figure]
槽口 75°–105° (对齐): 凸台/套环同高 H8

PCD Φ72.5, 22.5°+45k° (对 flange_disc 内圈孔) → 详图 C

## 剖视图 Section A-A (1:1) 尺寸单位: mm

(沿 +Y 方向剖切, 过对齐槽口中分线 / cut along +Y axis through aligned notch bisector)

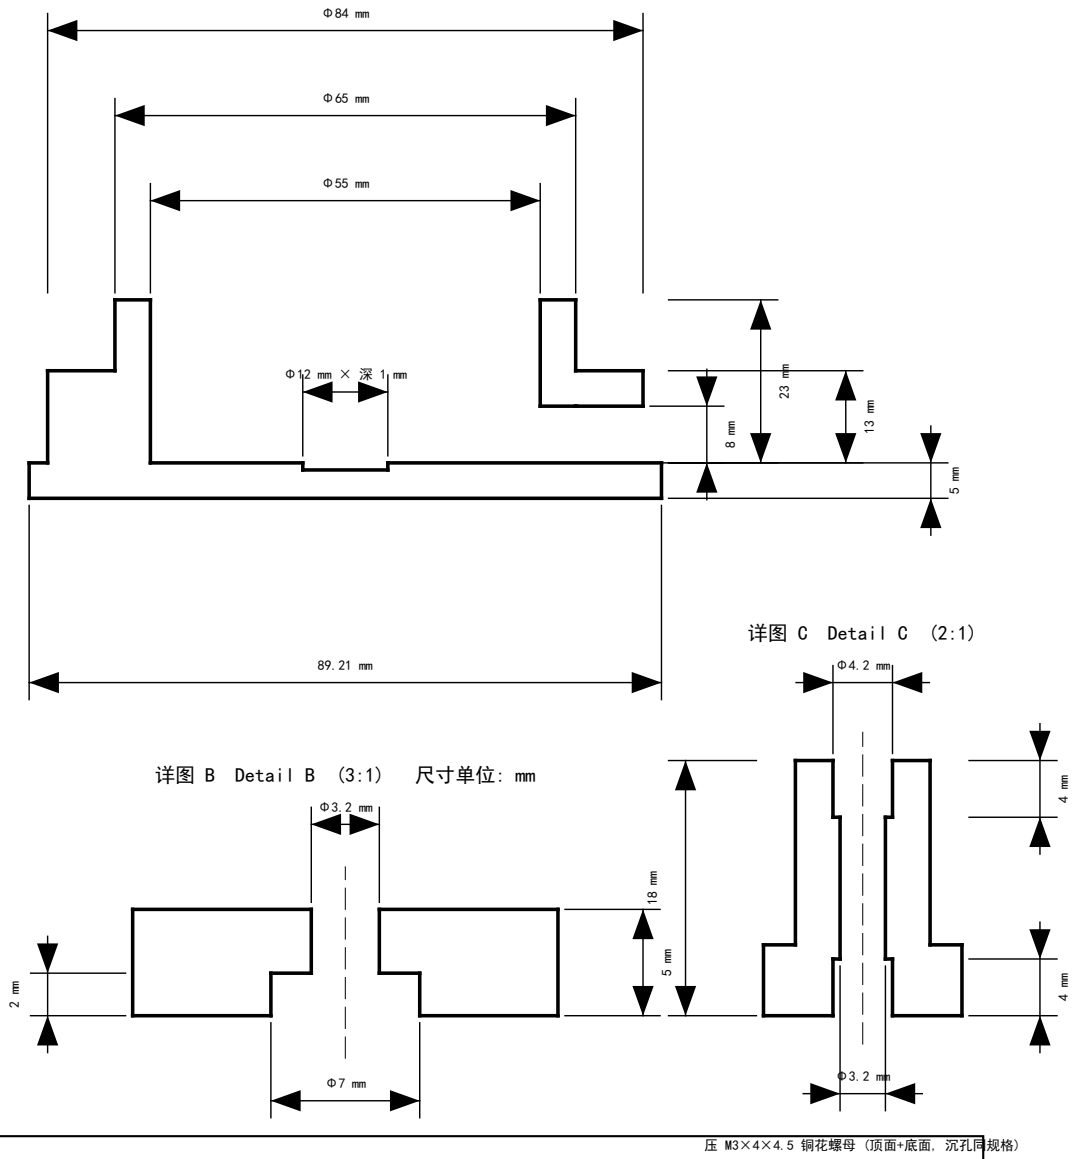
[picture p143: figure]
详图 B Detail B (3:1); 尺寸单位: mm; 详图 C Detail C (2:1); 压 M3×4×4.5 铜花螺母 (顶面+底面, 沉孔同规格)

POV 3D 结构件 — 底盘+套环 合并件 (Baseplate + Ring Collar) | 投影 1st-angle / 比例 1:1 (俯, 剖) / 3:1 (详图 B) / 2:1 (详图 C)
89.21×89.21×5 (四角 R59.25) / 4×M6 / 4×M3+Φ7×2 / 中央 Φ12×1(顶) / 凸台 Φ65/Φ55 H23 / 套环 Φ84/Φ65 H13 / 槽口 75°–105° / 8×Φ3.2+Φ4.2×4沉(顶+底) / 单位 mm | 2026-08-19 / POV3D / models / baseplate_collar_d100 / baseplate_collar_d100.stl
