kiujkiu/macha/v0.3.1/print/top_cap_v3_1_1/top_cap_v3_1_1_drawing.pdf

# POV 3D v3 — top_cap_v3_1_1 双面屏顶部薄压条 (光电斜置, 光轴过圆心)

扁条 32×140×7 (装配 260.95..267.95, 底面压双面屏顶) / 轴: Φ6.2 通孔 + Φ13×2.7 底面头窝 (M6×20 平头, 先装 M6 再压屏) / 3×2 Φ3.2 @ X(-6.7, 0.0, 6.7)/Y±64 (居中/偏心可切换)

光电模块绕两孔连线中点 M(6.7,-45) 旋转 21.94° (sin = 17/45): 2×Φ3.2 平通 @ (10.24,-51.04)/(3.16,-38.96) + 底面 Φ7.5×2.5 头窝 (M3×12 先装后压屏, 螺母锁 PCB 上); 排针尾避空槽 9×8 斜置随转 (中心 (6.70,-45.00), 穿透); 对射管焊脚落条外悬空

光轴 (对射连线) 过圆心 — 叉臂扫掠为同心环, 挡光片净通道 r36.78..46.66, 刀片 r40.2..43.2 双侧余量 ~3.4 / 配套: M6×20 平头 + Φ8×30 单头内丝螺柱 + M3×12×4 / 平躺打印零支撑 (GB 1st-angle, 主视 2:1, mm)

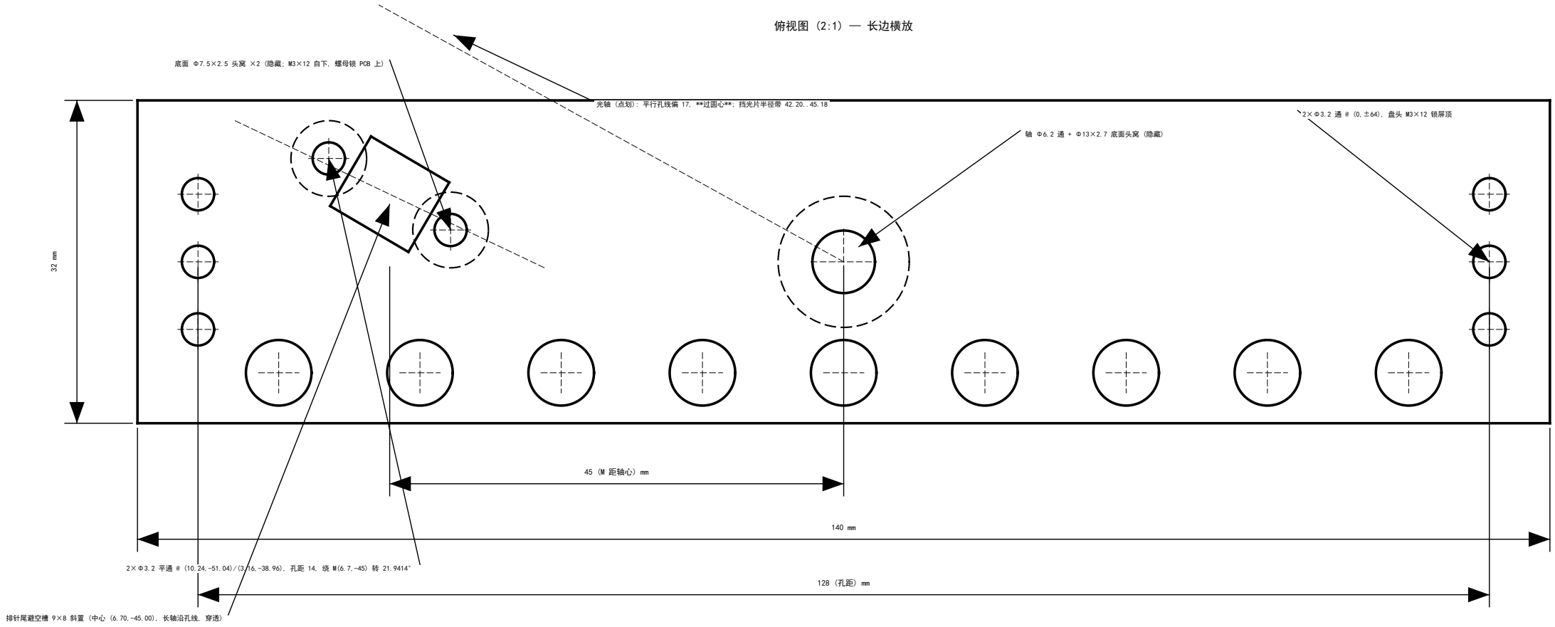
[picture p145: figure]
俯视图 (2:1) — 长边横放; 45 (M 距轴心) mm

2×Φ3.2 平通 @ (10.24,-51.04)/(3.16,-38.96), 孔距 14, 绕 M(6.7,-45) 转 21.9414°

底面 Φ7.5×2.5 头窝 ×2 (隐藏; M3×12 自下, 螺母锁 PCB 上)

排针尾避空槽 9×8 斜置 (中心 (6.70,-45.00), 长轴沿孔线, 穿透)

光轴 (点划): 平行孔线偏 17, **过圆心**; 挡光片半径带 42.20..45.18 | 2×Φ3.2 通 @ (0,±64), 盘头 M3×12 锁屏顶 轴 Φ6.2 通 + Φ13×2.7 底面头窝 (隐藏)

## 正视图 (2:1)

## 侧视图 (2:1)

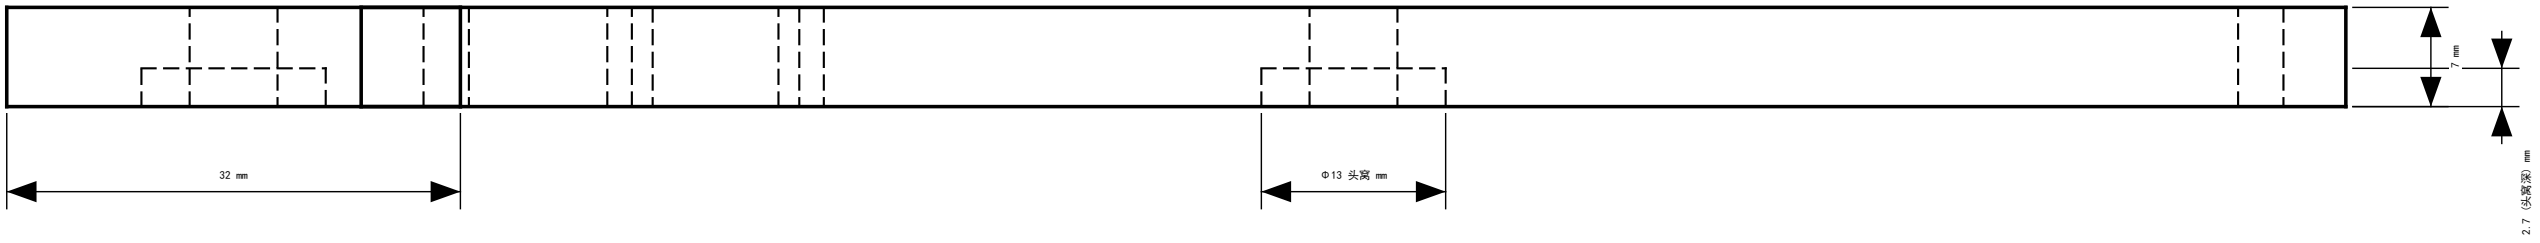
[picture p146: figure]
2.7 (头窝深) mm

POV 3D v3 结构件 — top_cap_v3_1_1 薄压条 (光电斜置, 底面 = 屏顶压面 260.95) | 投影 1st-angle / 比例 2:1
32×140×7 / 轴 Φ6.2+Φ13×2.7 底头窝 / 2×Φ3.2@±64 / 光电 2×Φ3.2 绕 M(6.7,-45) 转 21.9414° + Φ7.5 头窝 / BOM: M6×20 平头 + Φ8×30 螺柱 + M3×12×4 / 平躺打印 / 单位 mm | 2026-07-24 / POV3D / v3 / top_cap_v3_1_1 / top_cap_v3_1_1.stl
