kiujkiu/macha/v0.3/print/assembly/assembly_v3_guide.pdf

# POV 3D v3 组装指引 (双面屏) Assembly Guide

对齐用示意, 非加工图 / 立面为 XZ 侧视示意 / 标高为装配 Z (洞洞板顶面=0) / 单位: mm

## 整机堆叠立面 (示意)

## 组装顺序 (1)..12) 对应立面气泡)

1) 压铜花螺母 (烙铁热压, 最先做)

d100 底面 8 颗 + 承载盘底面 7 颗 (M3×4×4.5); d100 顶面沉孔留空不压

2) d100 底座上板

转 45° 对脚, 4×M6×16 锁洞洞板 (±50,0)/(0,±50) 网格孔

3) 装电机

C4110 入凸台孔, 底面沉孔 4×M3×8 从下向上; 电机线走 75°-105° 开口 (内外同高8)

4) 定子锁紧 (新)

flange_disc 放套环顶 → mounting_flange 翻扣 → 8×M3×30+2mm垫圈

PCD Φ72.5 孔一插到底, 锁进 d100 底面铜花螺母 (夹持 3+7+13+5=28)

5) 转子毂

hub_disc 翻扣 4×M3×8 锁电机转子面; rim_ring 同层嵌套互锁

6) 承载盘

放上 rim_ring, R35 空余 6 孔 M3×12+螺母 锁紧 (R77.5 8孔留给8)9)10))

7) 盘上电子

7×尼龙垫柱5 + pi2hub → 7×M3×12 入盘底螺母; 4×尼龙柱8.5 → 米联派插排座

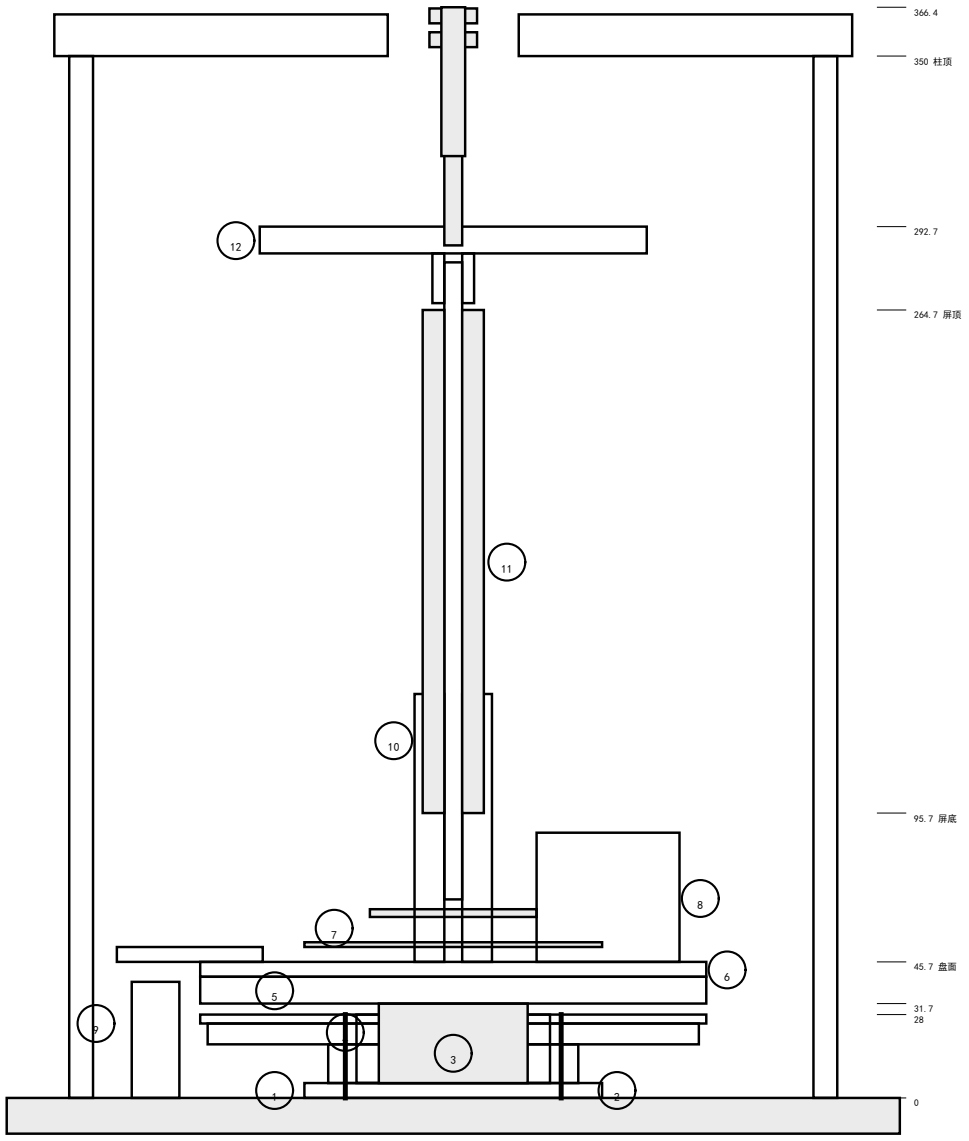
[picture p147: figure]

8) WiFi 盒

模块侧立入盒 → 母头穿 +Y 窗对插 → 倒扣上盘 4×M3×14+螺母 → 扎带

9) 光电同步

支架 2×M3×16 (板3+盘5+环3.5, 随转子) / 模块 2×M3×8+螺母 (槽口朝下) / 挡光片 2×M6×16 (静止)

10) 屏幕支架

gantry_v3 ×2 对角放 (件2 转180°) 4×M3×20+螺母; 立板竖起 6×M3×18/20+垫片螺母

11) 双面屏

先插好两屏排线! 再对头 8×M3×6/8 (每孔两颗, 各入板 ≤2.5) 贴板两面

12) 顶帽+轴承

M6×40 先装入帽头窝(之后舌挡住装不进!) + Φ8×50 螺柱拧上锁 →

双腿夹舌 4×M3×18+垫片螺母 → 4×Φ8×350 柱竖起 → 688×2 入 frame 座 →

frame_A (M6×16×2) / frame_B (M6×30×2) 架柱顶, 毂 4×M3×20+螺母 →

柱顶 M6 螺母锁紧 → 慢转试机, 配重 M6 平头+螺母 按需调平 (±X 两排对称)

## 紧固件汇总 (v3 整机)

规格 | 数量 | 用处
M3×4×4.5 铜花螺母 | 15 | 盘底 7 / d100 底 8 (热压)
M3×8 | 10 | 电机底 4 / hub→电机 4 / 光电模块 2(+螺母)
M3×6/8 (按屏螺母) | 8 | 双屏对头固定, 每孔 2 颗
M3×12 | 13 | 盘→rim_ring 6(+螺母) / pi2hub 7
M3×14 | 4 | wifi 盒耳 (+垫片螺母)
M3×16 | 2 | 光电支架 (穿板3+盘+环)
M3×18 | 4 | 顶帽夹舌 (+垫片螺母)
M3×18/20 | 6 | 立板-塔柱贯通 (+垫片螺母)
M3×20 | 8 | gantry 脚 4(+螺母) / frame 毂 4(+螺母)
M3×30 +2mm垫圈 | 8 | 定子锁紧→d100底面螺母 (25不够/30裸装凸底)
M3 尼龙柱 8.5 | 4 | pi2hub-米联派 (+配套尼龙螺丝)
M3 尼龙垫柱 ~5 | 7 | 盘-pi2hub
M3 螺母 | ~30 | 各贯通处 (含垫片)
M6×16 | 8 | d100 脚 4 / 挡光片 2 / frame_A 2
M6×30 | 2 | frame_B 垫柱脚
M6×40 平头 | 1 | 转轴 (帽Φ12.5, 12)先装!)
Φ8×50 螺柱 M6内丝 | 1 | 轴上段, 穿双 688
M6 螺母 | 1+ | 柱顶锁紧 (+柱底/配重按需)
Φ8×350 M6螺纹柱 | 4 | 顶轴承立柱 @(±125,±125)
688 轴承 8×16×5 | 2 | frame_A/B 座
M6 平头配重+螺母 | 按需 | 帽 ±X 两排 19+19 孔调平
扎带 | 1 | wifi 母头防脱

注: d100 顶面 8 沉孔在长螺丝方案下留空;

屏幕螺丝长度装前按屏自带螺母实高确认。

## POV 3D v3 — 组装指引 (组装顺序 + 紧固件清单) 非加工图

外购件灰色填充 / 打印件白色 / 粗竖线 = 8×M3×30 定子锁紧螺丝 / 单位 mm

2026-07-13 / POV3D / v3 / print / assembly

数据源: assembly_v3.py + 各件 build 脚本 BOM
