kiujkiu/macha/v2/print/_obsolete_20260722/sensor_bracket_v2/photo_sensor_bracket_v2_drawing.pdf

# POV 3D v2 — sensor_bracket_v2 光电支架 (θ=180/-X, 装 mlkpai_carrier_disc)

3厚盘顶板 (6→3, 2026-07-15) X-113..-64×Y±35 (外角45°斜切; R_SLOT 112→98 缩半径 2026-07-07), 借盘R77.5环孔(-71.60,±29.66) Φ3.4 M3上进 / 模块孔(-91,17)/(-105,17) Φ3.2 直通 (顶沉取消, M3×8+螺母) / 3× 贯通避空槽 / 梁(-98,0,盘顶-8) / 基准=旋转轴 (GB 1st-angle, 2:1, mm)

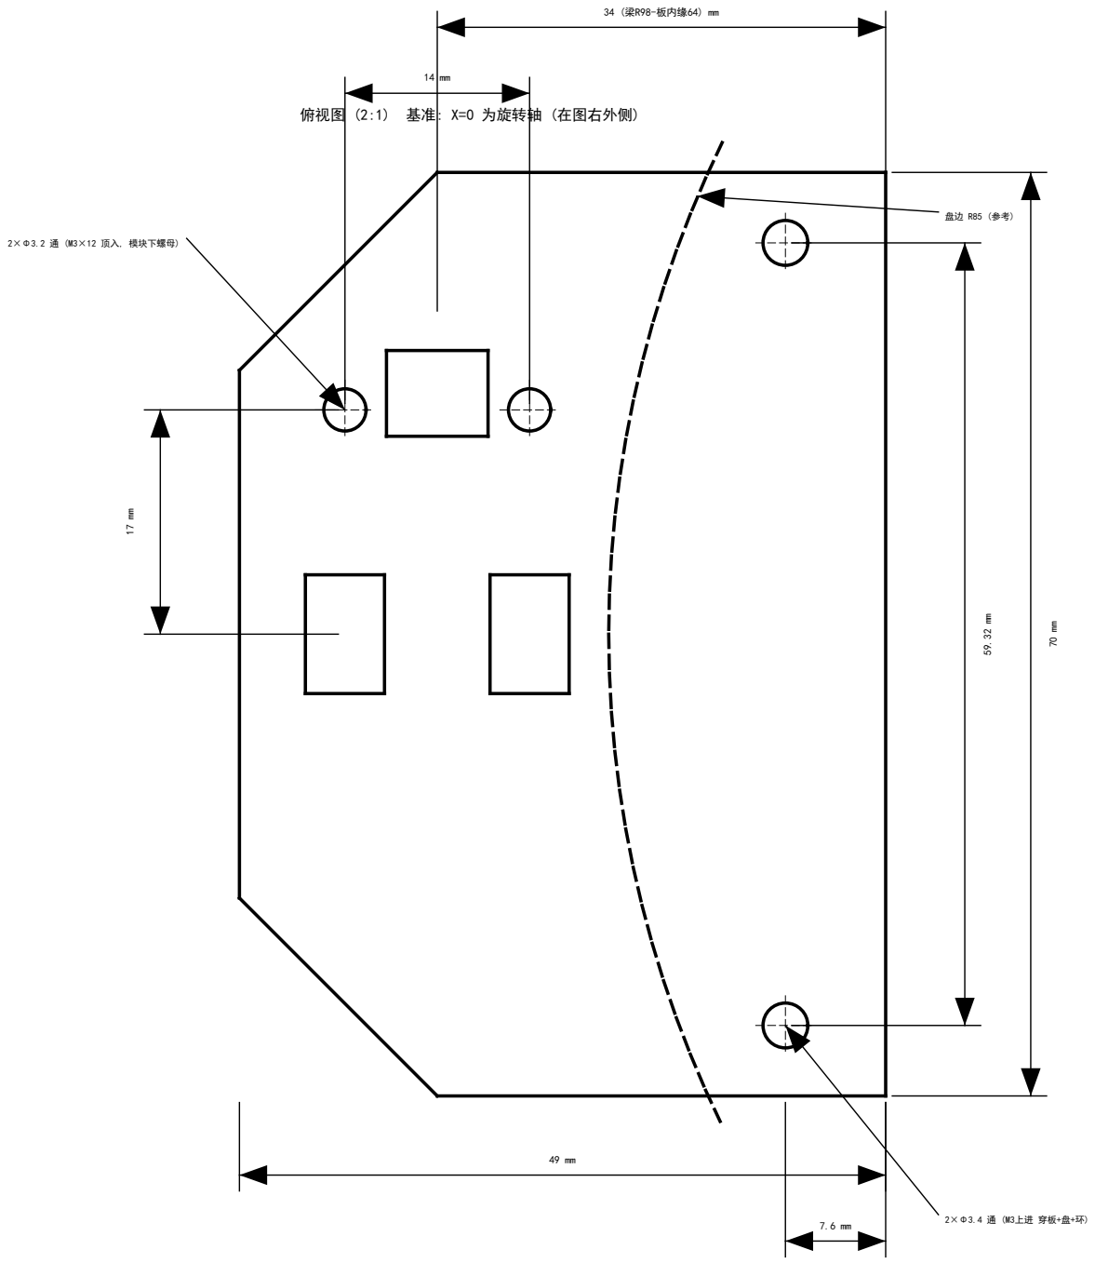
[picture p151: figure]
俯视图; (2:1) 基准: X=0 为旋转轴 (在图右外侧); 2×Φ3.2 通 (M3×12 顶入, 模块下螺母); 34 (梁R98-板内缘64) mm

梁位置 (-98, 0), 距轴 98 / 3 槽贯通 (焊脚避空, 2026-07-14 挖穿) / 外角斜切 (-113,±20)→(-98,±35)

## 侧视图 (2:1)

49 mm

3 mm

模块扣板底(槽口朝下), 避空槽贯通

POV 3D v2 结构件 — sensor_bracket_v2 光电支架 (θ=180) | 投影 1st-angle / 比例 2:1
板 49×70×3 (X-113..-64, 外角斜切) / 借环孔(-71.60,±29.66) Φ3.4 (M3×16) / 模块孔 -91/-105@Y+17 Φ3.2直通(M3×8) / 3避空槽贯通 / 平躺打印 / mm | 2026-07-15 / POV3D / models / photo_sensor / sensor_bracket_v2.stl
