kiujkiu/macha/v0.3/print/_obsolete_20260723/gantry_v3/gantry_v3_drawing.pdf

# POV 3D v3 — gantry_v3 门形底座 (支架两件之二, 配 screen_plate_v3)

同一件打印 2 次, 对角安装 (件2 绕 Z 转 180°) / 脚 4厚 72×29.5 借盘R77.5环孔 2×Φ3.2 / 塔柱 宽12×深10 直背 (前面X=-3贴板面) + 外侧筋墙5厚满三角(外面=打印底面, 侧躺零支撑) / 3×Φ3.2 贯通: M3×18/20 穿 板6+塔10, 塔背垫片+螺母 (无嵌件无沉头, 全平面通孔) / 基准=脚底面(=盘顶) (GB 1st-angle, 侧视·正视 1:1, 俯视 1:2, mm)

## 侧视图 (主视, 1:1)

## 正视图 (1:1)

## 俯视图 (1:2, 双件装配位)

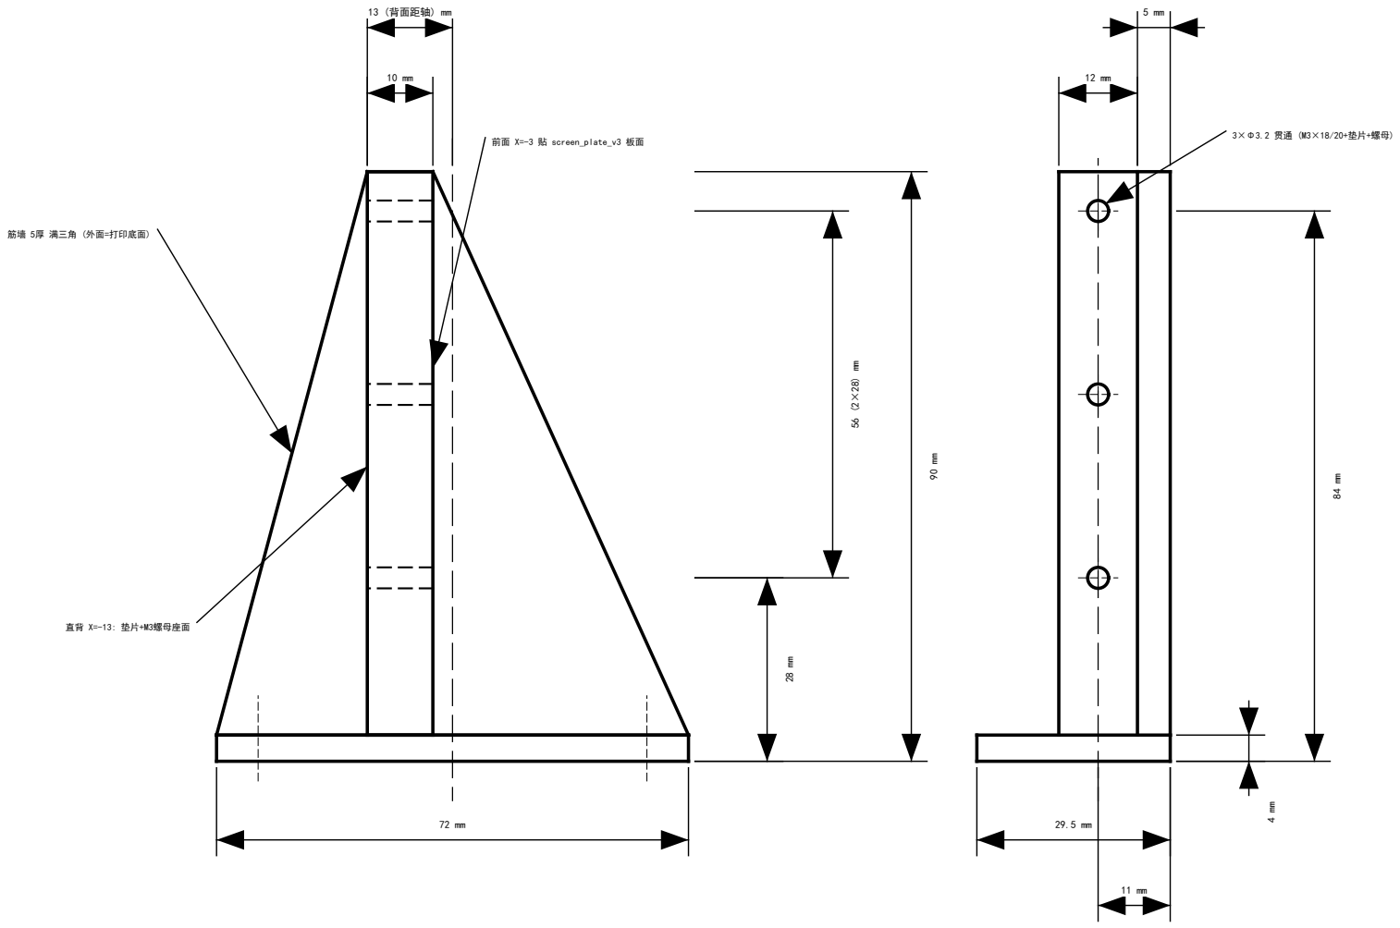
[picture p152: figure]
13 (背面距轴) mm; 前面 X=-3 贴 screen_plate_v3 板面; 筋墙 5厚 满三角 (外面=打印底面); 直背 X=-13: 垫片+M3螺母座面

同一件打印 2 次, 对角安装 (件2 绕 Z 转 180°) · 侧躺打印: 外侧面 (Y=93 面) 贴床, 零支撑

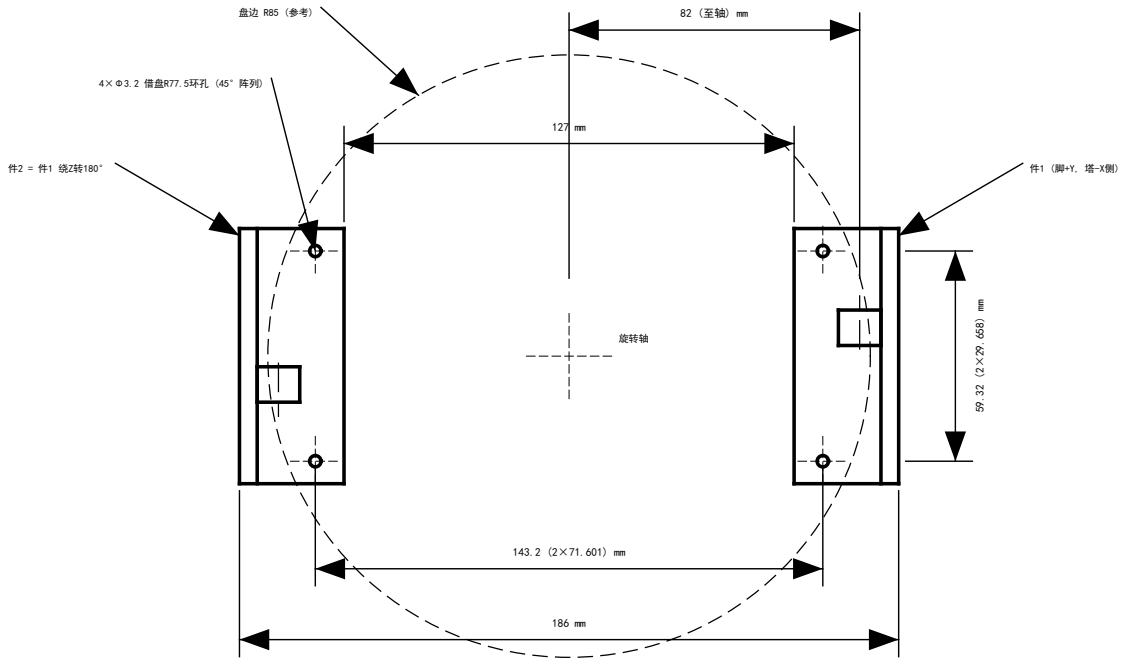
[picture p153: figure]
旋转轴; 4×Φ3.2 借盘R77.5环孔 (45°阵列); 件2 = 件1 绕Z转180°

POV 3D v3 结构件 — gantry_v3 门形底座 (同一件打印 2 次, 对角安装: 件2 绕 Z 转 180°) | 投影 1st-angle / 比例 侧视·正视 1:1, 俯视 1:2 / 全部 Φ3.2 平面通孔
脚 4厚 X±36 Y63.5..93, 孔(±29.658,71.601) / 塔 12×10 直背 X-13..-3 Y76..88 Z4..90 + 筋墙5满三角 / 连接孔 Y82×Z{28,56,84} 贯通 M3×18/20+螺母 / 侧躺打印(Y=93面为底)零支撑 / mm | 日期 2026-07-10 / POV3D / v3 / models / l_bracket_v3 / gantry_v3.stl ×2
