kiujkiu/macha/v2/print/top_bearing_frame_v2/top_bearing_frame_v2_drawing.pdf

# POV 3D top_bearing frame v2 — frame_A_v2 / frame_B_v2 (静止轴承架, 锁 4 立柱顶, PLA)

臂 18×8 (宽=柱垫Φ18) + 筋 4×6 (R24..R164) / 轴毂 Φ44 双层, 各嵌 1 × 688 (腔 Φ15.8×5 压入, 挡肩 Φ13), 4×Φ3.2@R14 / 柱垫 Φ18 @R176.78: 仅 Φ6.5 通孔, A 用 M6×16 / B 柱垫高16 用 M6×30

## frame_A_v2 俯视 (1:1) 尺寸单位: mm

176.78 mm

140 (筋) mm

176.78 mm

双臂 90°, 柱垫对角放置 → 打印床 207.8×207.8 (X2D 256 内)

柱位 = 洞洞板最外角孔 (±125,±125), R = 125×√2 ≈ 176.78

中心: 688 腔 Φ15.8(虚线,压入) + 挡肩 Φ13 / 4 × Φ3.2 @ R14

臂 18 宽 × 8 厚, 筋 4×6 (A 上 / B 下)

## 详图 A (4:1) — 688 压装孔 (A/B 同)

Φ15.8 mm

Φ13 mm

5 mm

688 轴承 8×16×5 压入 (腔 Φ15.8 偏紧, 腔口朝毂顶面)

挡肩 Φ13 贯通 — 只托外圈, 内圈不蹭

## 轴毂叠层剖面 (2:1) — 688 ×2 + Φ8 轴

8 mm

8 mm

5 mm

Φ15.8 mm

Φ13 mm

A 腔口朝上 (688 #1, 353-358), B 腔口朝上 (688 #2, 361-366)

柱顶 350: A 毂 350-358, B 毂 358-366; Φ8 轴穿两轴承内圈

## 臂横截面 (2:1, A; B 筋朝下)

18 mm

4 mm

8 mm

6 mm

## 柱垫剖面 (2:1, frame_A_v2; B 柱高 16): 仅 Φ6.5 通孔

Φ18 mm

Φ6.5 mm

8 mm

M6 螺丝自上穿入拧进立柱顶 (A: M6×16, | B: M6×30) — 锁死轴向
立柱 Φ8×350 (轴向 M6 内丝), | 柱顶 Z = 350
POV 3D — top_bearing frame v2 / frame_A_v2 + frame_B_v2 (各 ×1) / PLA / 柱位 (±125,±125) Φ8×350 M6螺纹柱 | 投影 1st-angle / PLA / 单位 mm
R柱 = 125×√2 ≈ 176.78 / 厚度: 臂/毂 8, 筋 6 (总高 A=14, B=16), 柱垫 A=8/B=16 仅Φ6.5通孔 / 高度: 柱顶350, A 350-358 (轴承353-358), B 358-366 (轴承361-366) / BOM: 688×2, M6×16×2 (A垫), M6×30×2 (B柱垫), M3×20+螺母×4 / A 正打, B 反打 | 2026-07-09 / POV3D / models / top_bearing
