kiujkiu/macha/v0.2/print/gantry_base/gantry_base_drawing.pdf

# POV 3D v2 — gantry_base 门形底座 A/B (支架三件之二三, 配 screen_plate)

A(+Y)/B(-Y) 互为镜像左右手件, 本图示 A 件 / 脚 4厚 借盘R77.5环孔 2×Φ3.2 / 塔柱 宽15×深10 直背 + 外侧筋墙5厚满三角(塔顶90拉到脚两端; 外面=打印底面, 侧躺零支撑) / 3×Φ3.2 贯通: M3×18/20 穿 板6+塔10, 塔背垫片+螺母 (无嵌件无沉头, 全平面通孔) / 基准=脚底面(=盘顶) (GB 1st-angle, 1:2, mm)

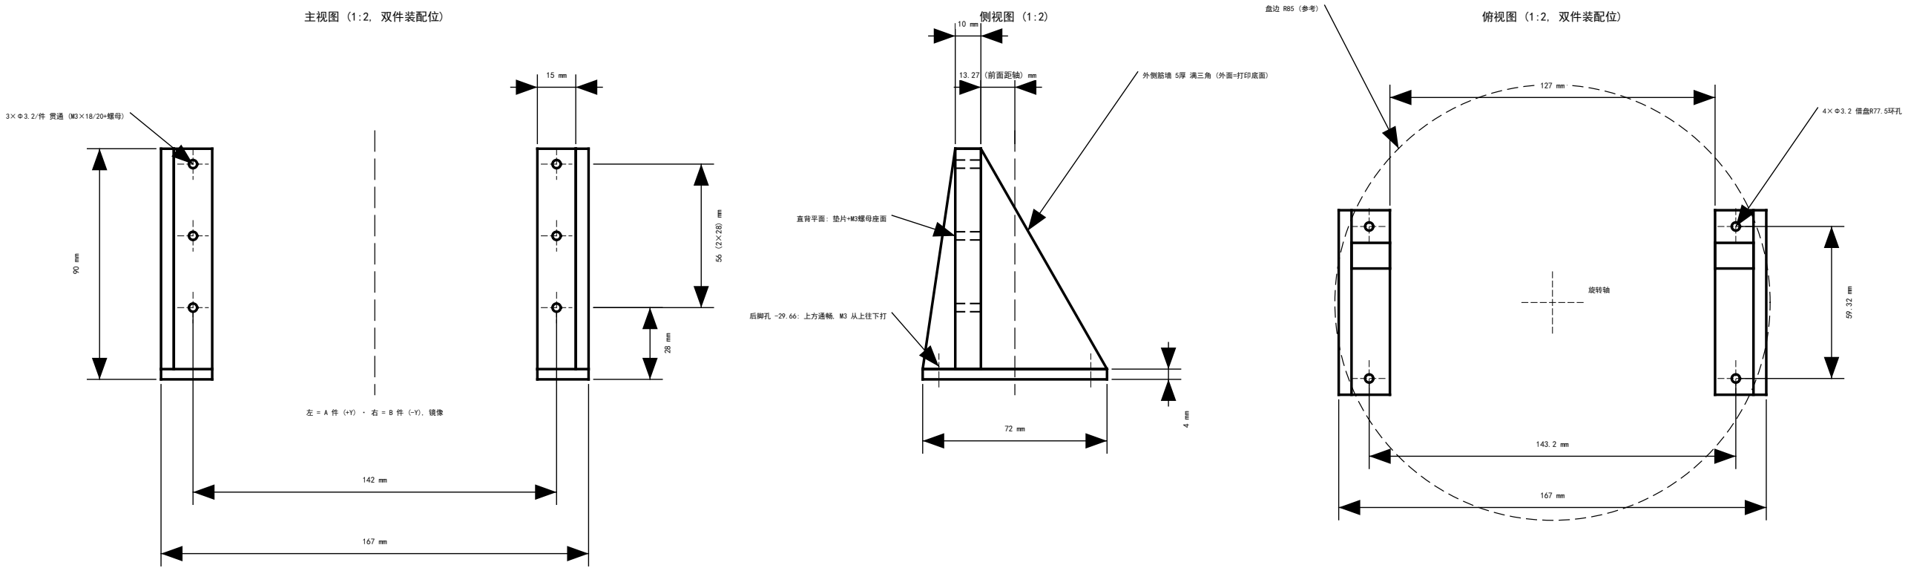
[picture p154: figure]
主视图 (1:2, 双件装配位); 侧视图 (1:2); (前面距轴) mm; 后脚孔 -29.66: 上方通畅, M3 从上往下打; 外侧筋墙 5厚 满三角 (外面=打印底面); 直背平面: 垫片+M3螺母座面; 俯视图 (1:2, 双件装配位); 旋转轴; 4×Φ3.2 借盘R77.5环孔

POV 3D v2 结构件 — gantry_base A/B 门形底座 (镜像左右手件) | 投影 1st-angle / 比例 1:2 / 全部 Φ3.2 平面通孔
脚 4厚 X±36 Y±(63.5..83.5) 外缘平直, 孔(±29.66,±71.60) / 塔 15×10 直背 Z4..90 + 外侧筋墙5满三角 / 连接孔 ±71×高{28,56,84} 贯通 M3×18/20+螺母 / 侧躺打印(外侧面为底)零支撑 / mm | 2026-07-03 / POV3D / models / l_bracket_v2 / gantry_base_A/B.stl
