kiujkiu/macha/v0.2/print/screen_plate/screen_plate_drawing.pdf

# POV 3D v2 — screen_plate 屏幕板 (支架三件之一, 配 gantry_base A/B)

平板 156×192.5×6, 平躺打印(前面朝下) / 4×Φ3.2 屏幕孔 (梯形阵 105/99.95×147) / 6×连接孔 Φ3.2 直通无沉头 (M3×18/20 贯通板+塔) / 接口窗 54×34+顶R27拱 / 底部中央缺口 120×29 (顶=盘面+50) / 基准=翼板底边(装配=盘顶+21) (GB 1st-angle, 1:2, mm)

## 主视图 (前面/贴屏面, 1:2)

## 侧视图 (1:2)

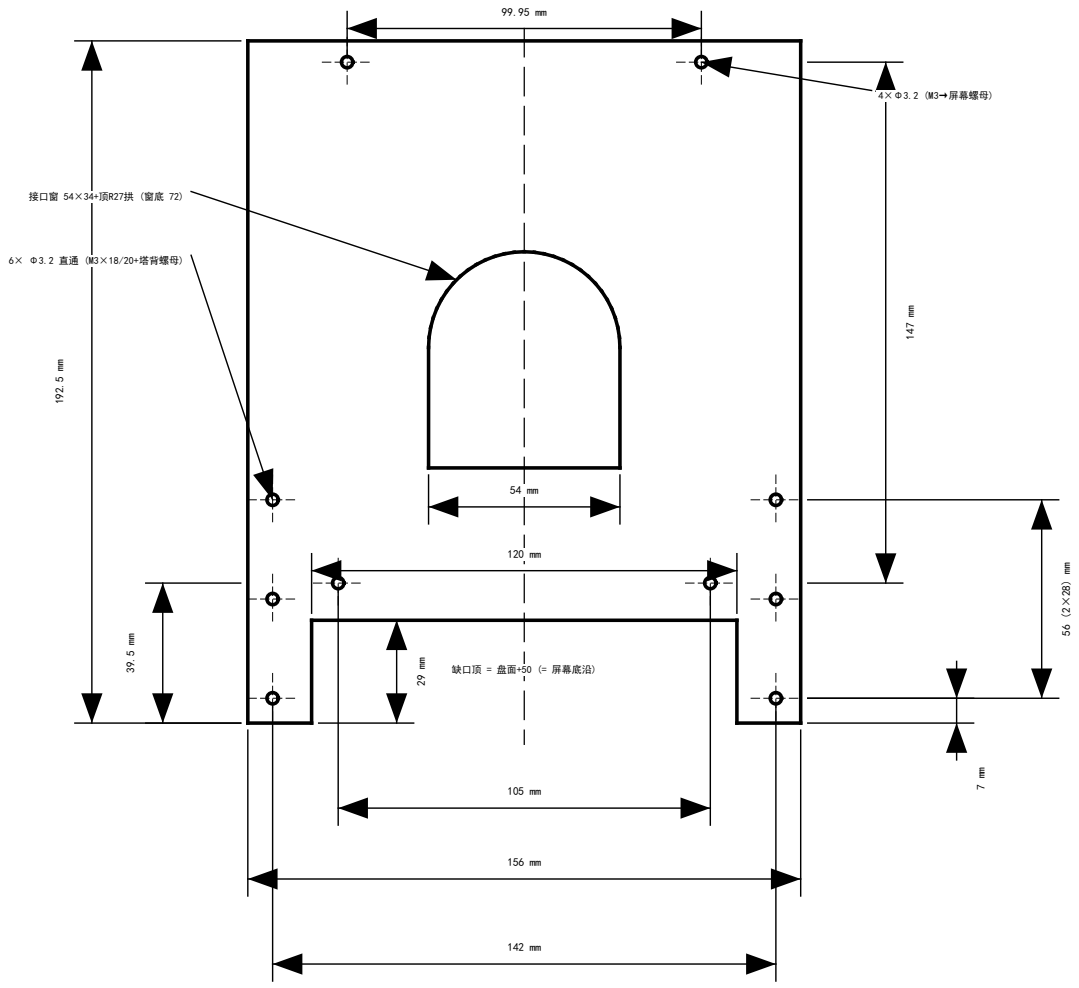
[picture p155: figure]
缺口顶 = 盘面+50 (= 屏幕底沿); 接口窗 54×34+顶R27拱 (窗底 72); 4×Φ3.2 (M3→屏幕螺母); 6× Φ3.2 直通 (M3×18/20+塔背螺母)

6 mm

前面→

## 连接方式说明

6× 连接孔 Φ3.2 普通直通孔 (无沉头):

M3×18/20 从板前面穿过 板(6)+塔柱(10),

gantry_base 塔背面套垫片 + M3 螺母锁死。

注: 螺丝头凸出板前面 ~2mm;

屏幕背面由其自带螺母垫起, 不与螺丝头干涉。

POV 3D v2 结构件 — screen_plate 屏幕板 (支架三件之一) | 投影 1st-angle / 比例 1:2 / 全部 Φ3.2 平面直通孔
板 156×192.5×6 / 屏孔 105/99.95×147 @高39.5 / 连接孔 ±71×高{7,35,63} Φ3.2 直通 / 窗±27×72..106+R27拱 / 底缺口120×29 / 平躺打印 / mm | 2026-07-03 / POV3D / models / l_bracket_v2 / screen_plate.stl
