kiujkiu/macha/v0.4/print/baseplate_collar_v4_h28/baseplate_collar_v4_h28_drawing.pdf

# POV 3D 底盘+套环 合并件 v4-h28 原高度版 (凸台顶 Z28 / 套环顶 Z18) Baseplate + Ring Collar v4-h28

93.5×93.5×5 底盘 (四角 R62.28) / 4×M6 (对角106.07) / 4×M3+Φ7×2 沉孔 / 中央 Φ12×1 沉孔(顶) / 凸台 Φ65/Φ55 H23 / 套环 Φ84/Φ65 H13 / 槽口 75°–105° 对齐 / 8×Φ3.2+Φ4.2×4沉(底) PCD Φ72.5

## 俯视图 Top View (1:1) 尺寸单位: mm

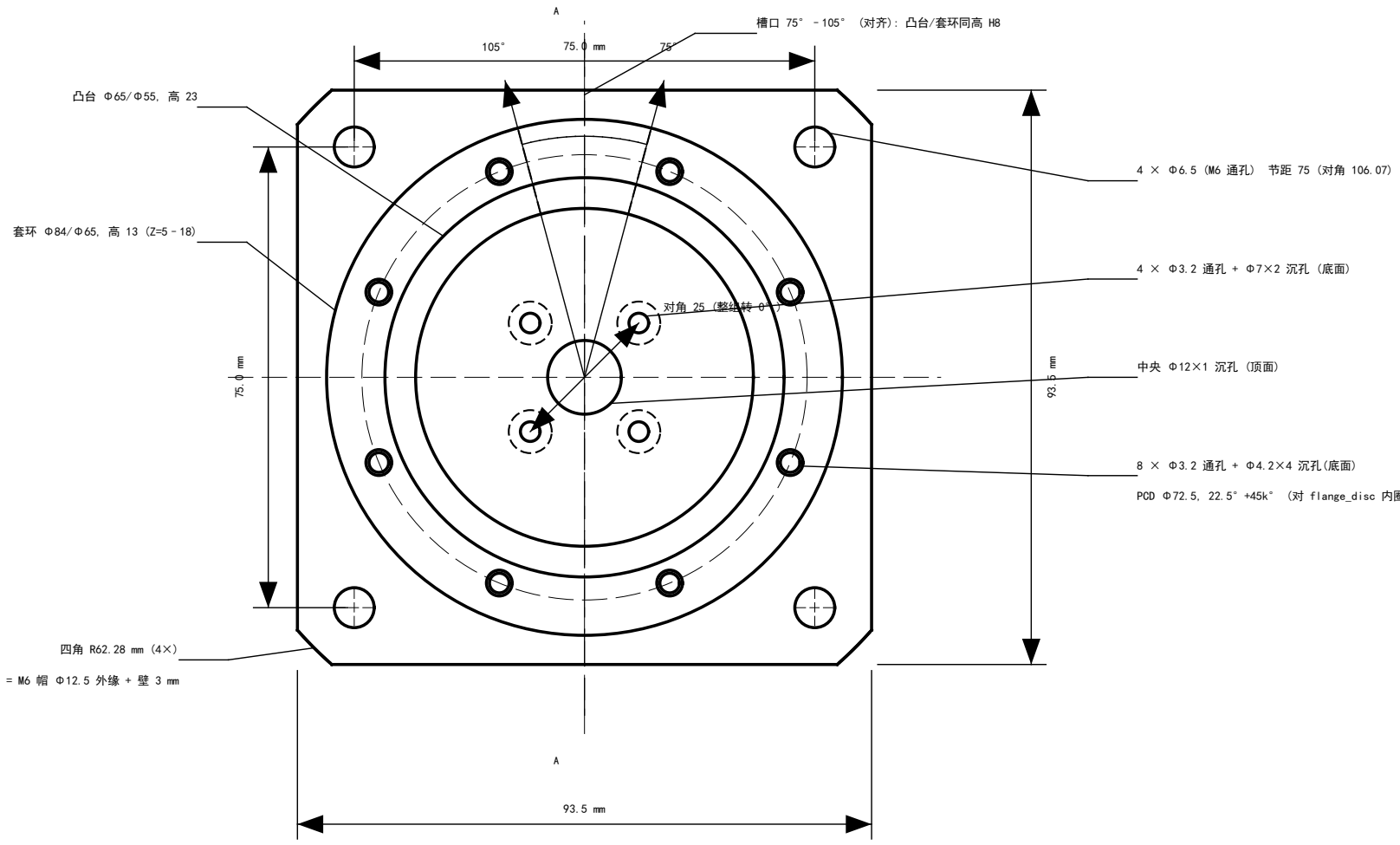
[picture p156: figure]
对角 25 (整组转 0°); 槽口 75°–105° (对齐): 凸台/套环同高 H8
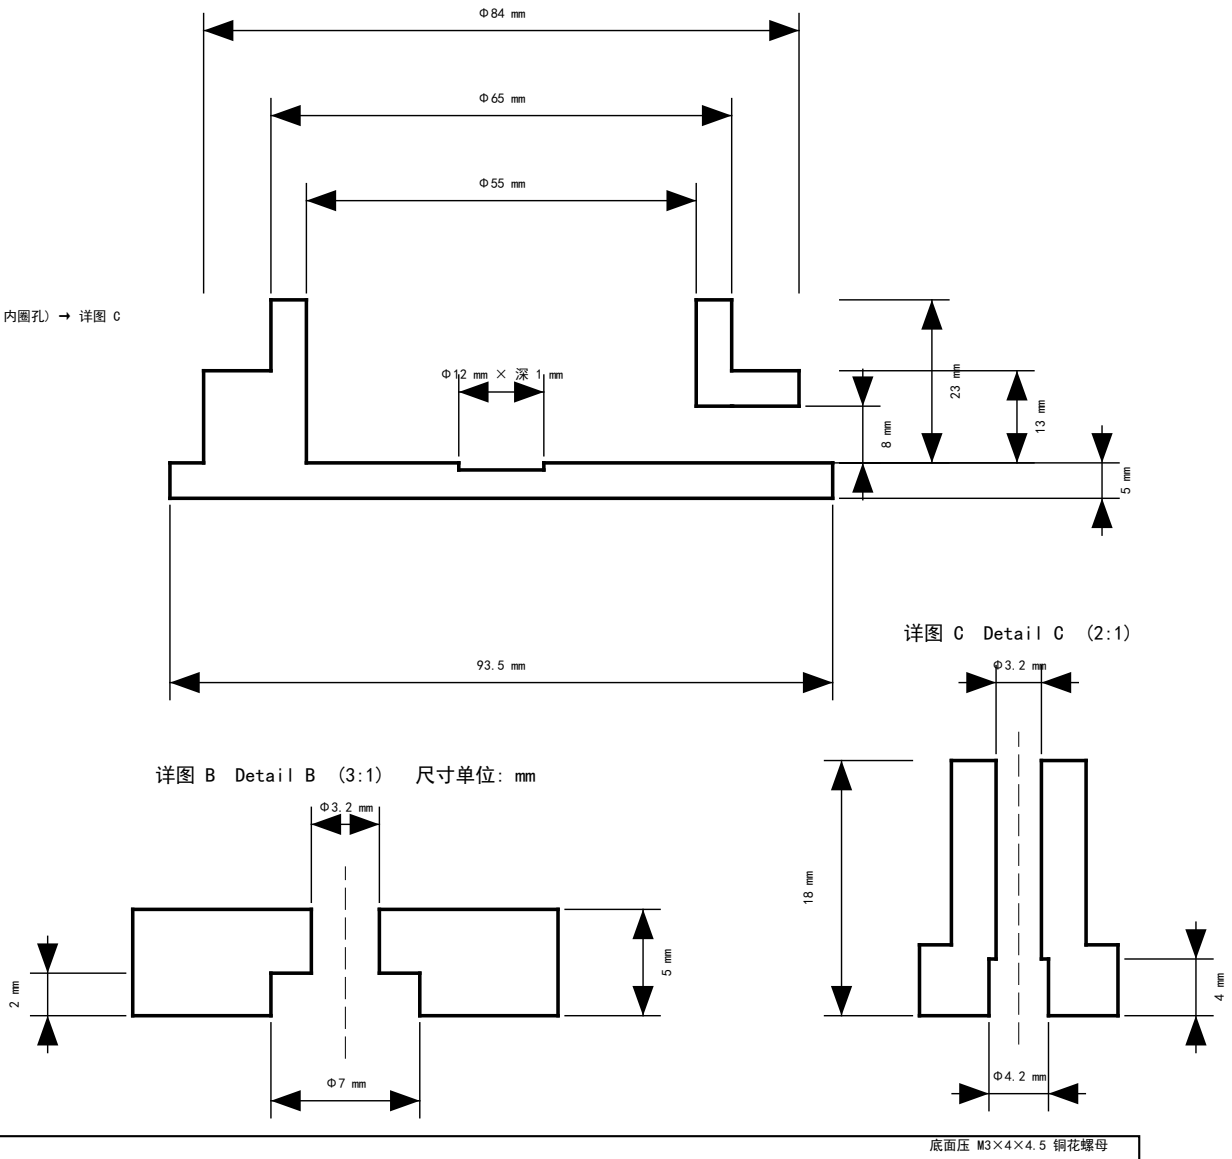
[picture p157: figure]
详图 B Detail B (3:1); 尺寸单位: mm; 详图 C Detail C (2:1); 底面压 M3×4×4.5 铜花螺母

PCD Φ72.5, 22.5°+45k° (对 flange_disc 内圈孔) → 详图 C

## 剖视图 Section A-A (1:1) 尺寸单位: mm

(沿 +Y 方向剖切, 过对齐槽口中分线)

※ 本件 = baseplate_collar_v4 的【原高度变体】: 凸台 H23 / 套环 H13 (现行件 2026-08-28 已降 2.5 为 H20.5 / H10.5)。除这两个高度外, 两件完全相同 —— 外形、孔位、缺口、沉孔全一致。

顶面 Φ4.2×4 沉孔 ×8 同样取消 (铜花螺母本来就只压底面那 8 个, 顶面窝一直空着); 该处只有 Φ3.2 通孔, 肉厚 3.14。

※ 定子锁紧 8 颗 M3 的夹持 = 3+7+13+5 = 28 => 本件配 M3×30 + 2mm 垫圈 (现行件夹持 25.5 / 垫圈叠 4.5)。两件垫圈不通用, 别装错。

POV 3D 结构件 — 底盘+套环 合并件 v4-h28 原高度版 (Baseplate + Ring Collar) | 投影 1st-angle / 比例 1:1 (俯, 剖) / 3:1 (详图 B) / 2:1 (详图 C)
93.5×93.5×5 (四角 R62.28) / 4×M6 / 4×M3+Φ7×2 / 中央 Φ12×1(顶) / 凸台 Φ65/Φ55 H23 / 套环 Φ84/Φ65 H13 / 槽口 75°–105° / 8×Φ3.2+Φ4.2×4沉(底) / 单位 mm | 2026-09-04 / POV3D / v4 / baseplate_collar_v4_h28 / baseplate_collar_v4_h28.stl
