kiujkiu/macha/v0.3/print/portal_tee_v3/portal_tee_v3_drawing.pdf

# POV 3D v3 — portal_tee_v3 屏幕底部支撑 T 型件 (×2, 180° 对放)

底横条 67×10×5 装转子两颗 M3 (±29.658, R77.5 环孔, Φ7 工艺井) / 竖梃 5×10 / 梯形加强壁 厚 5 齐外侧面 (±33.5→±10) / 顶平板托梯形 外20·内13.4 (=屏厚13.4)×深17×5, 托面 Z50=屏底一整平面, 屏孔 Φ3.2 (M3×12 自下) / 平躺打印: 外侧面贴床, 全特征落床零支撑 (GB 1st-angle, 2:1, mm)

## 正视图 (2:1)

## 侧视图 (2:1) — 左 = 外侧平整面 (打印贴床)

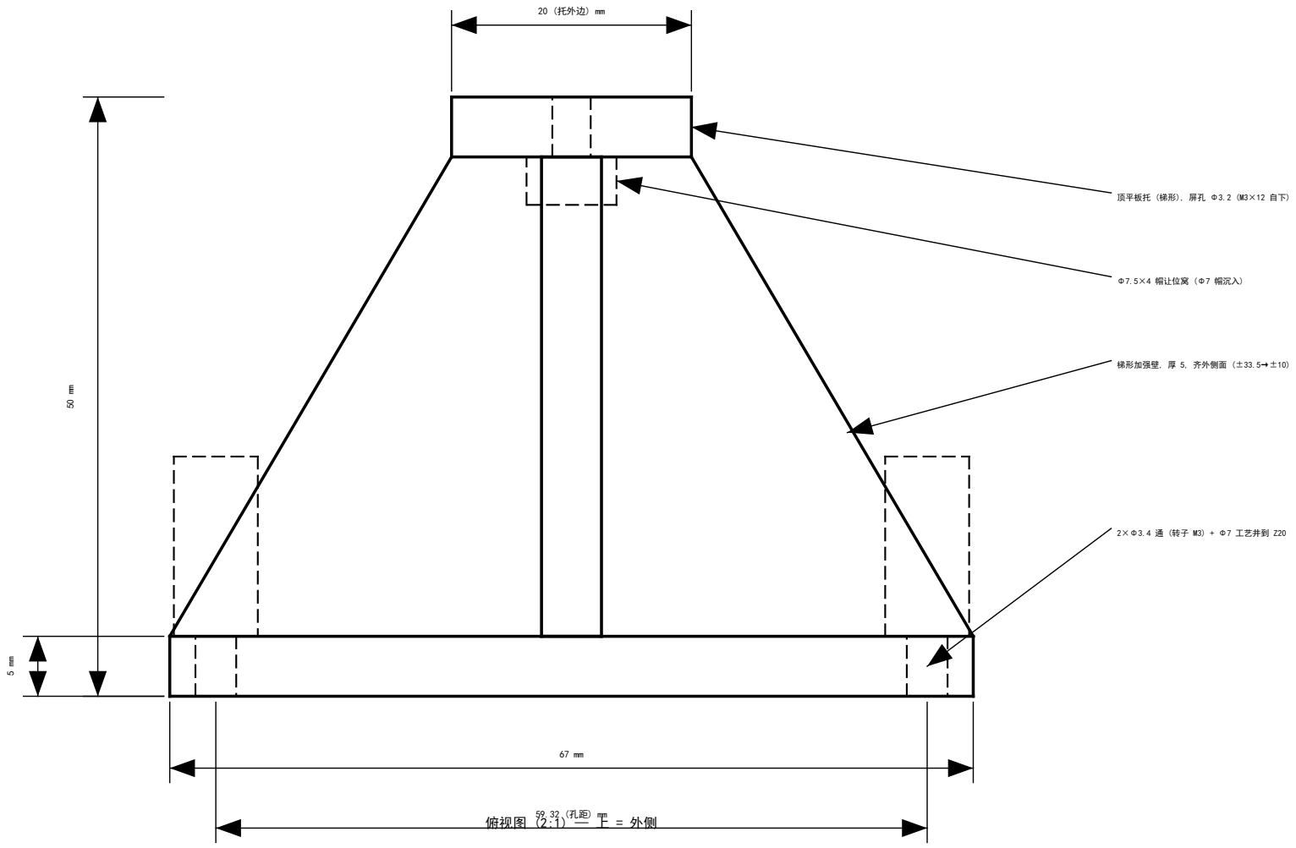
[picture p158: figure]
20 (托外边) mm; 2×Φ3.4 通 (转子 M3) + Φ7 工艺井到 Z20; 顶平板托 (梯形), 屏孔 Φ3.2 (M3×12 自下); 梯形加强壁, 厚 5, 齐外侧面 (±33.5→±10); Φ7.5×4 帽让位窝 (Φ7 帽沉入); 俯视图 (2:1) — 上 = 外侧
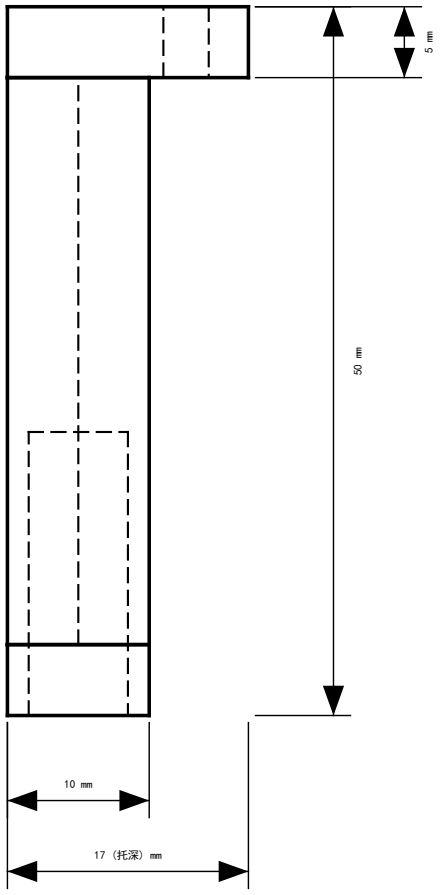
[picture p159: figure]
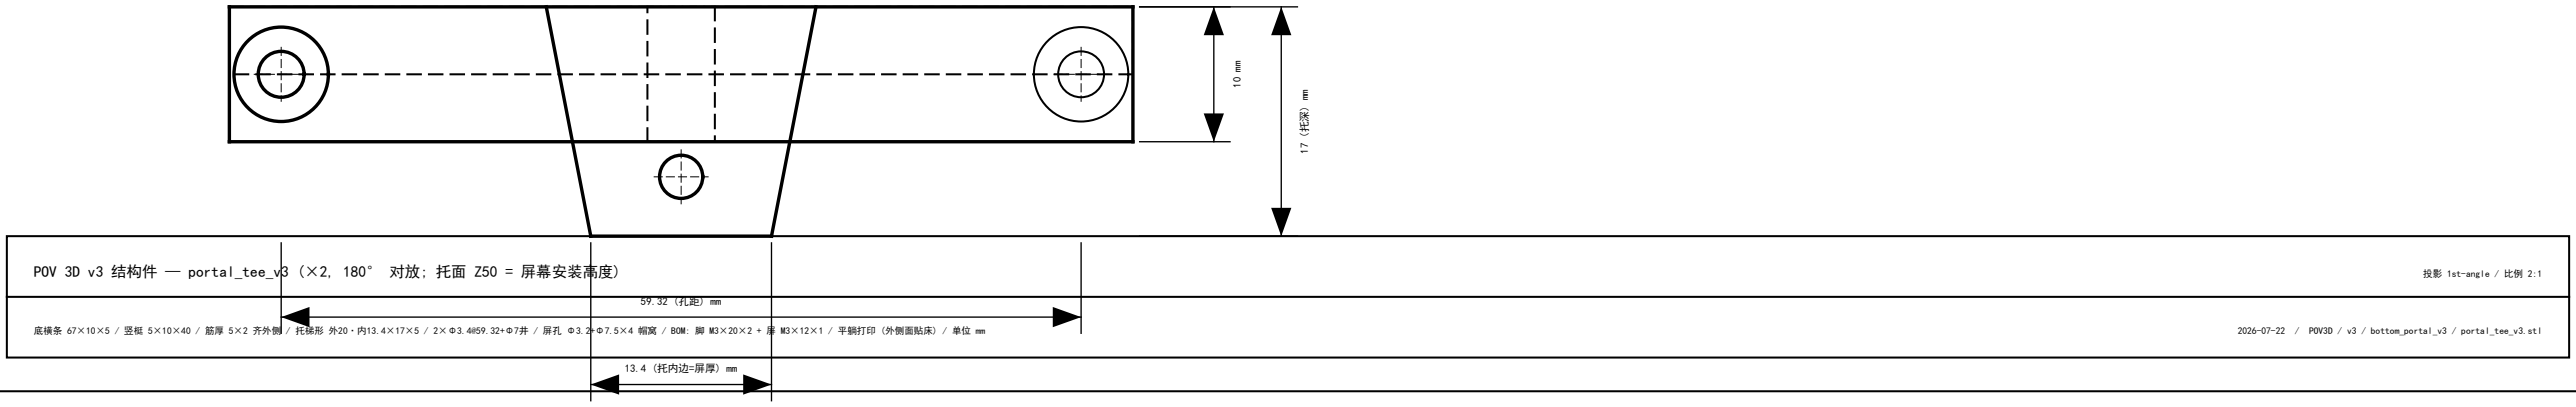
[picture p160: figure]
13.4 (托内边=屏厚) mm

POV 3D v3 结构件 — portal_tee_v3 (×2, 180° 对放; 托面 Z50 = 屏幕安装高度) | 投影 1st-angle / 比例 2:1
底横条 67×10×5 / 竖梃 5×10×40 / 筋厚 5×2 齐外侧 | / 托梯形 外20·内13.4×17×5 / 2×Φ3.4@59.32+Φ7井 / 屏孔 Φ3.2+Φ7.5×4 帽窝 / BOM: 脚 M3×20×2 + 屏 M3×12×1 / 平躺打印 (外侧面贴床) / 单位 mm | 2026-07-22 / POV3D / v3 / bottom_portal_v3 / portal_tee_v3.stl
