kiujkiu/macha/v2.1/print/top_cap_v2_1/top_cap_v2_1_drawing.pdf

# POV 3D v2.1 — top_cap_v2_1 (v2 转子帽, 单屏转子, L型, PLA)

L型 (腿在+X端) / 平板 53.27×144×6 (asm X-36..+17.27, Y±72, Z286.7..292.7, 顶面全平; v2.1 裁短+减薄9→6) + 背板腿 4×112 下至Z247 / 中心Φ6.2通+底面头窝Φ13×2.7 / 配重 单排 10×Φ6.5 直通 @X-25 (间距14; v2.1: 46→25 单排, 沉孔取消) / 腿 2×Φ3.4→屏上排螺母 (M3×16)

## 俯视 (1:1) (沿 -Z 看顶面) 尺寸单位: mm

中心 Φ6.2 通, 底面头窝 Φ13×2.7 虚线 (详图B)

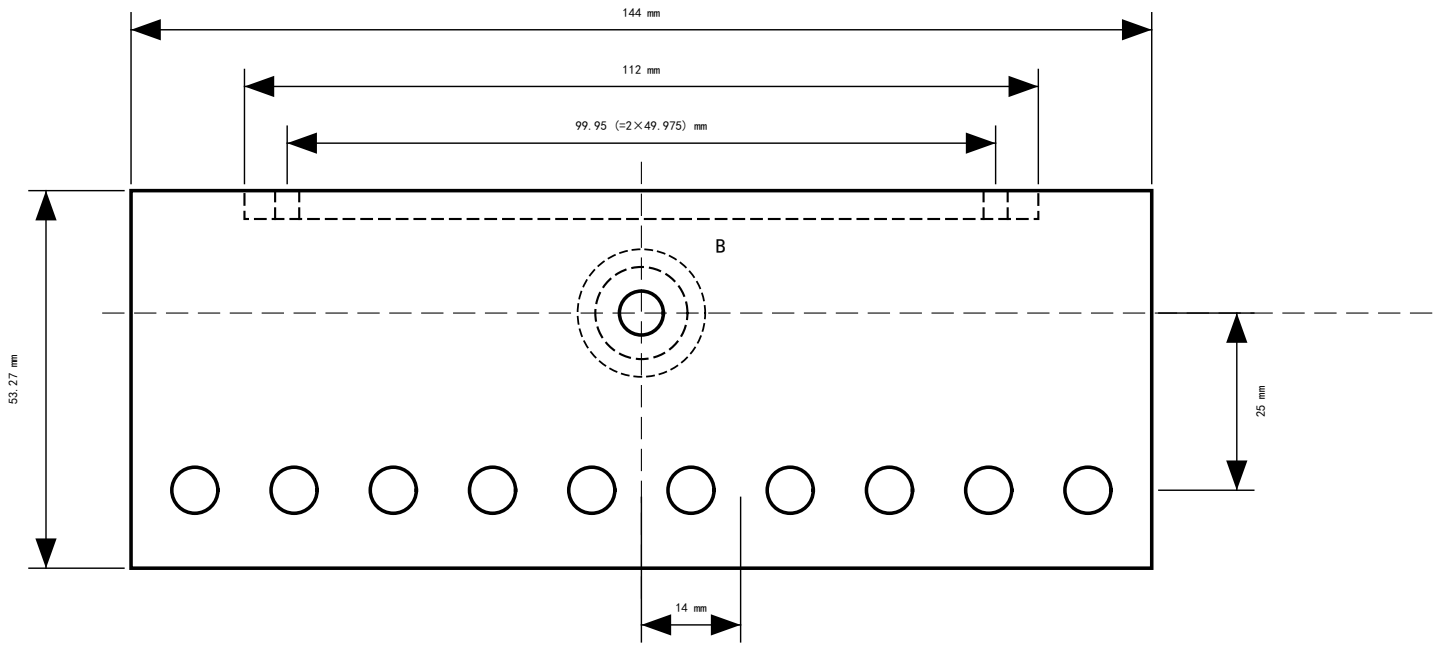
[picture p161: figure]

配重 单排 10×Φ6.5 直通 @ X=-25, Y=(k-4.5)×14 (无沉孔, M6头凸出顶面)

腿(虚线) 4 厚 X +13.27..+17.27 (顶端, 与+X边齐平), 2×Φ3.4 @Y=±49.975 (M3×16)

## 侧视剖面 (2:1) (沿 +Y 看, 剖切面 Y=0) — L型, 腿在+X端

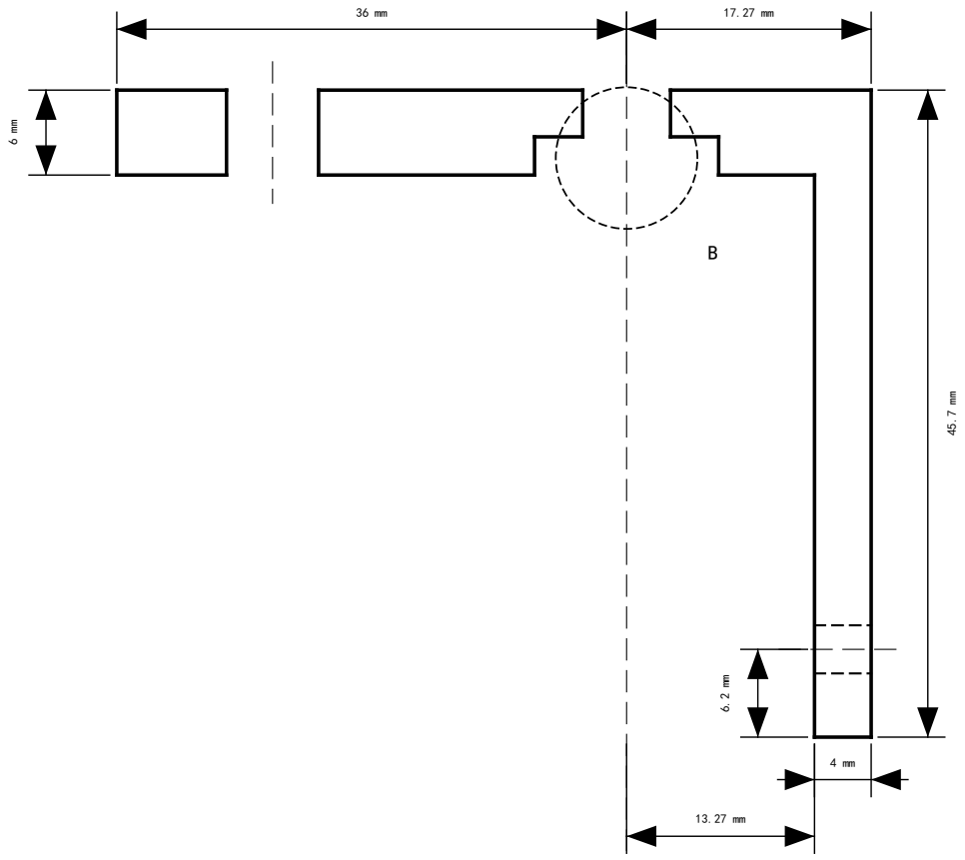
[picture p162: figure]

腿底 asm Z247, 孔心 Z253.2 (=腿底+6.2), 顶面 Z292.7

## 详图 B (4:1) 轴孔头窝 — 底面进 (方向与A相反)

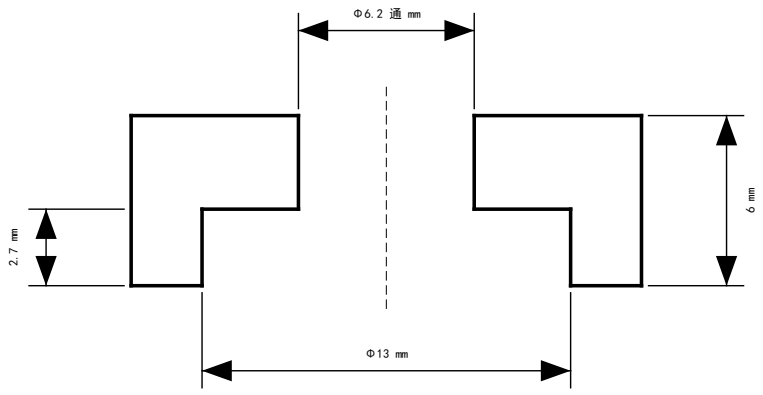
[picture p163: figure]

M6×40 平头自底面入 (头 286.7..289.4)

打印姿态: 平板顶面 (asm Z292.7) 朝下贴床, 腿朝上, 免支撑

轴系: M6×40 平头自底面头窝入 → Φ8×50 M6内丝螺柱 → 2×688

固定: M3×16 ×2 自腿背面穿 (腿4 + screen_plate 6) 拧入屏上排螺母

腿前面贴 screen_plate 背面 (asm X=+13.27; 屏幕组件绕Z转180°后)

配重: M6 自顶面直通穿入 + 螺母, 头凸出板顶 (无沉孔), 逐孔配平

POV 3D — v2.1 / top_cap_v2_1 (转子帽, 配重单排@25) (×1) | 投影 1st-angle / PLA / 单位 mm
PLA / 打印姿态: 平板顶面朝下 (腿朝上, 免支撑) / L型 (腿在+X端) / 平板6厚 53.27×144 (裁短+减薄), 腿4厚 高45.7, 配重孔直通无沉 / BOM: M6×40平头, Φ8×50螺柱, M3×16 ×2, M6平头配重+螺母按需 | 2026-07-16 / POV3D / v2.1 / models / top_cap_v2_1
