kiujkiu/macha/v0.2/print/top_cap_v2/top_bearing_cap_v2_drawing.pdf

# POV 3D top_bearing — top_cap_v2 (v2 转子帽, 单屏转子, L型, PLA)

L型 (腿在+X端; 屏幕组件转180°后) / 平板 82.27×144×9 (asm X-65..+17.27, Y±72, Z283.7..292.7, 顶面全平) + 背板腿 4×112 下至Z247 / 中心Φ6.2通+底面头窝Φ13×2.7 / -X悬出 19×Φ6.5 配重 (10+9品字形, 三角14, 顶面沉孔Φ13×2.7) / 腿 2×Φ3.4→屏上排螺母 (M3×16)

## 俯视 (1:1) (沿 -Z 看顶面) 尺寸单位: mm

中心 Φ6.2 通, 底面头窝 Φ13×2.7 虚线 (详图B)

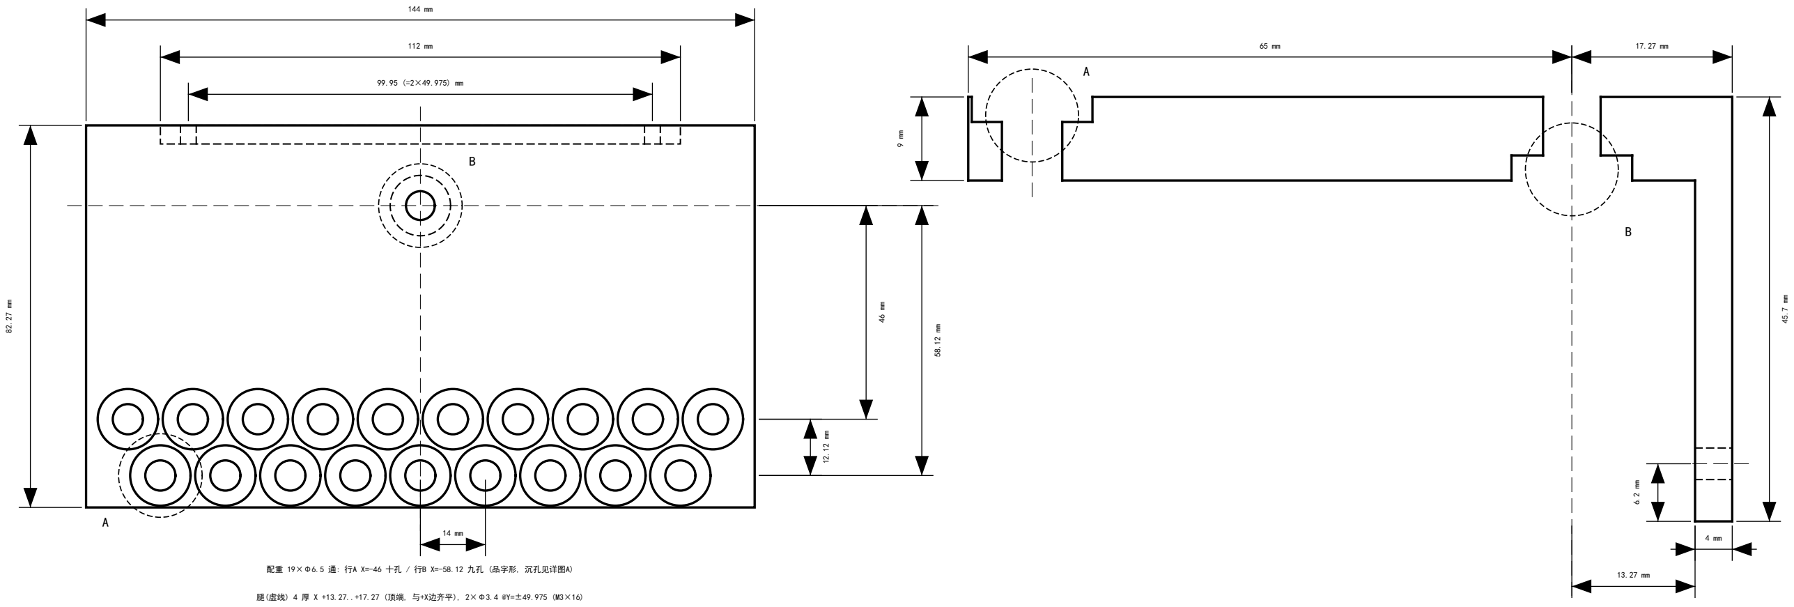
[picture p164: figure]

配重 19×Φ6.5 通: 行A X=-46 十孔 / 行B X=-58.12 九孔 (品字形, 沉孔见详图A)

腿(虚线) 4 厚 X +13.27..+17.27 (顶端, 与+X边齐平), 2×Φ3.4 @Y=±49.975 (M3×16)

## 侧视剖面 (2:1) (沿 +Y 看, 剖切面 Y=0) — L型, 腿在+X端

腿底 asm Z247, 孔心 Z253.2 (=腿底+6.2), 顶面 Z292.7

## 详图 A (4:1) 配重沉孔 — 顶面进

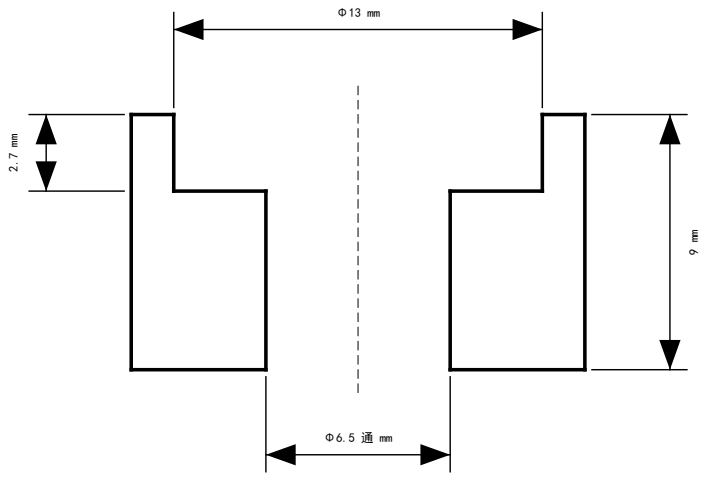
[picture p165: figure]

M6 平头 (Φ12.5×2.6) 沉平

## 详图 B (4:1) 轴孔头窝 — 底面进 (方向与A相反)

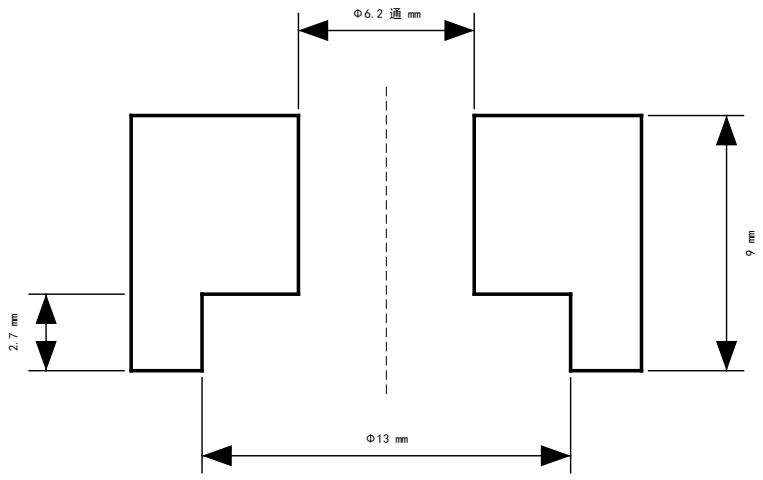
[picture p166: figure]

M6×40 平头自底面入 (头 283.7..286.4)

打印姿态: 平板顶面 (asm Z292.7) 朝下贴床, 腿朝上, 免支撑

轴系: M6×40 平头自底面头窝入 → Φ8×50 M6内丝螺柱 → 2×688

固定: M3×16 ×2 自腿背面穿 (腿4 + screen_plate 6) 拧入屏上排螺母

腿前面贴 screen_plate 背面 (asm X=+13.27; 屏幕组件绕Z转180°后)

配重: M6 平头自顶面沉孔入 + 螺母, 逐孔配平

POV 3D — top_bearing / top_cap_v2 (v2 转子帽) (×1) | 投影 1st-angle / PLA / 单位 mm
PLA / 打印姿态: 平板顶面朝下 (腿朝上, 免支撑) / L型 (腿在+X端; 屏幕组件转180°后) / 平板9厚 82.27×144, 腿4厚 高45.7 / BOM: M6×40平头, Φ8×50螺柱, M3×16 ×2, M6平头配重+螺母按需 | 2026-07-09 / POV3D / models / top_bearing
