kiujkiu/macha/v2/print/wifi_box/wifi_box_drawing.pdf

# POV 3D v2 — wifi_box USB WiFi 网卡倒扣盒 (装 mlkpai_carrier_disc, 随转子)

模块侧立整块 14.5×40×70 (天线反折在内) 直接坐盘面, 插头朝 +Y (米联派 J6 方向) / 壁 3, 内腔 15.1×70.6×40.4 / 两侧整条翼板 3 厚 + 45° 加强筋 2.5 厚 ×10 / 4×Φ3.4 = 盘 R35 & R77.5 环孔 @±22.5° (M3×14, 环底垫片+螺母) / 全部平面通孔无详图 / 基准 = 盘心 + 盘顶面 (GB 1st-angle, 2:1, mm)

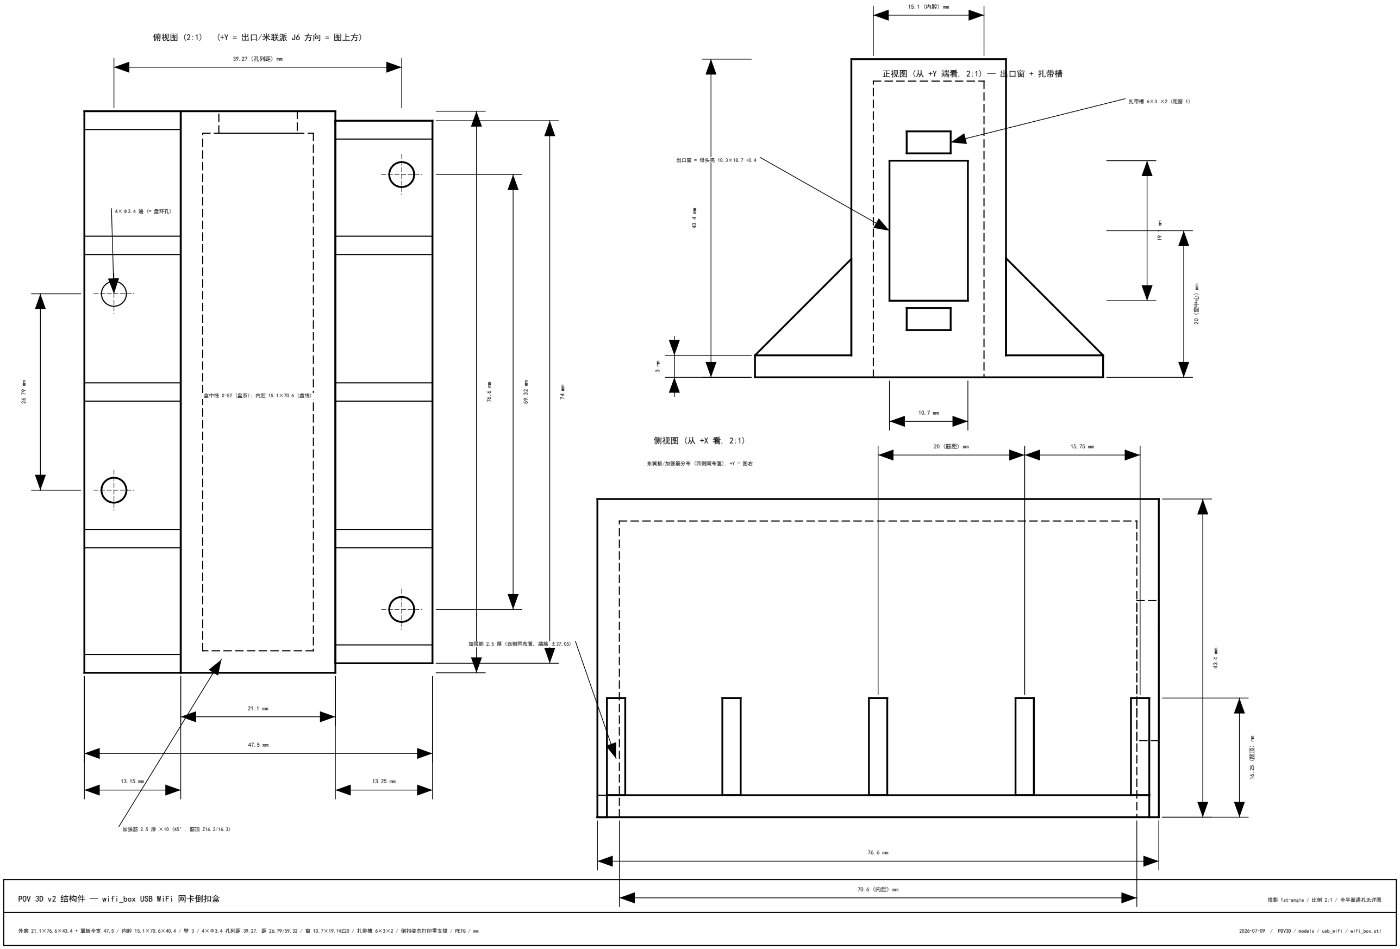
[picture p167: figure]
俯视图 (2:1); (+Y = 出口/米联派 J6 方向 = 图上方); 39.27 (孔列距) mm; 4×Φ3.4 通 (= 盘环孔); 加强筋 2.5 厚 ×10 (45°, 筋顶 Z16.2/16.3); 盒中线 X=52 (盘系); 内腔 15.1×70.6 (虚线); 正视图 (从 +Y 端看, 2:1) — 出口窗 + 扎带槽; 20 (窗中心) mm; 扎带槽 6×3 ×2 (距窗 1); 出口窗 = 母头壳 10.3×18.7 +0.4; 侧视图 (从 +X 看, 2:1); 东翼板/加强筋分布 (西侧同布置), +Y = 图右; 加强筋 2.5 厚 (西侧同布置, 端筋

POV 3D v2 结构件 — wifi_box USB WiFi 网卡倒扣盒 | 投影 1st-angle / 比例 2:1 / 全平面通孔无详图
外廓 21.1×76.6×43.4 + 翼板全宽 47.5 / 内腔 15.1×70.6×40.4 / 壁 3 / 4×Φ3.4 孔列距 39.27, 距 26.79/59.32 / 窗 10.7×19.1@Z20 / 扎带槽 6×3×2 / 倒扣姿态打印零支撑 / PETG / mm | 2026-07-09 / POV3D / models / usb_wifi / wifi_box.stl
