kiujkiu/macha/assembly_stack_preview.png

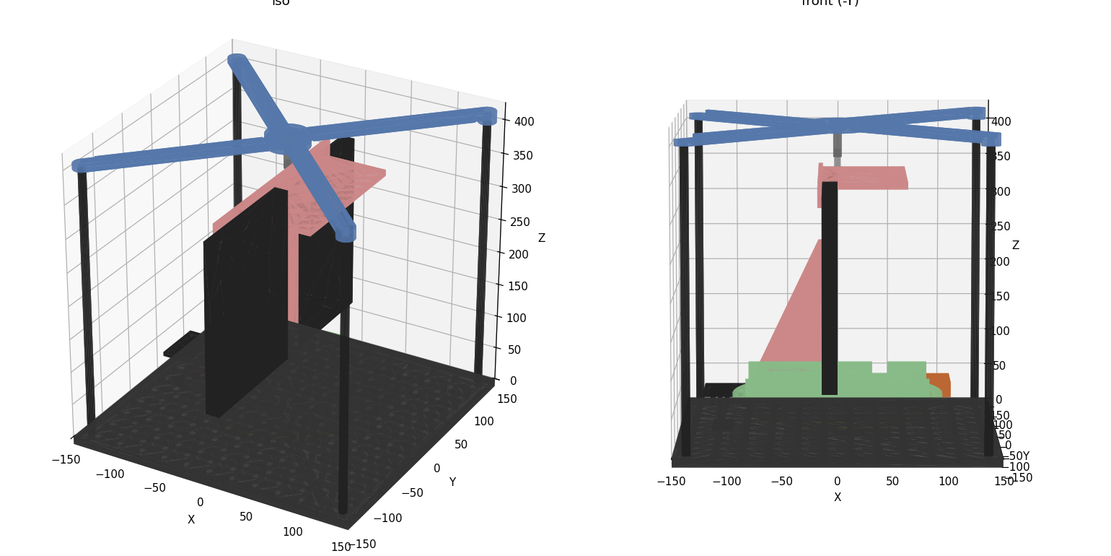
assembly_stack_preview.png
