kiujkiu/macha/assembly_v2_preview.png

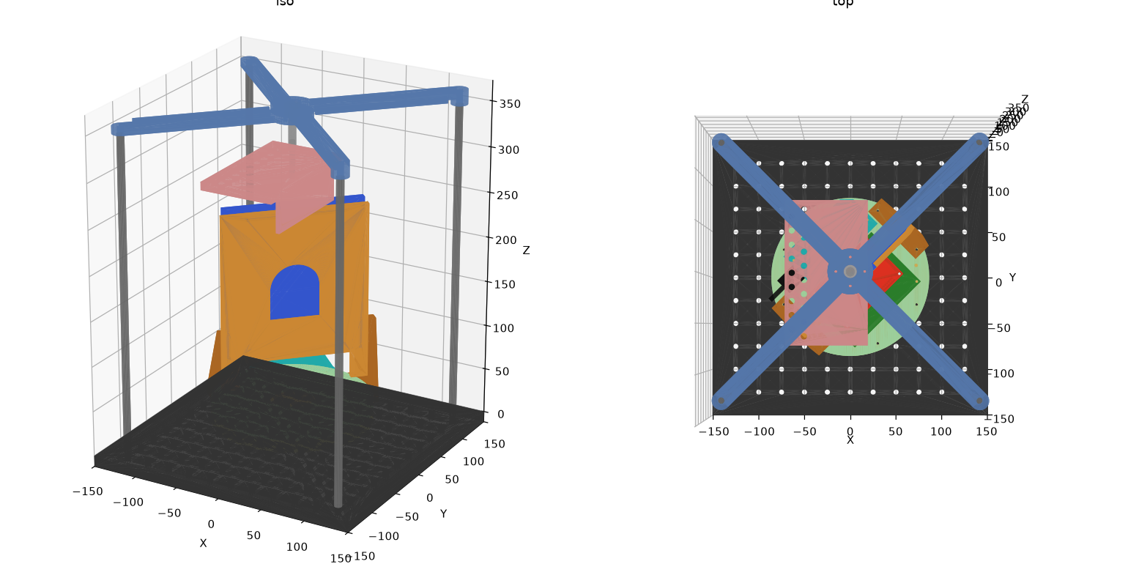
assembly_v2_preview.png
