kiujkiu/macha/assembly_v2_top_preview.png

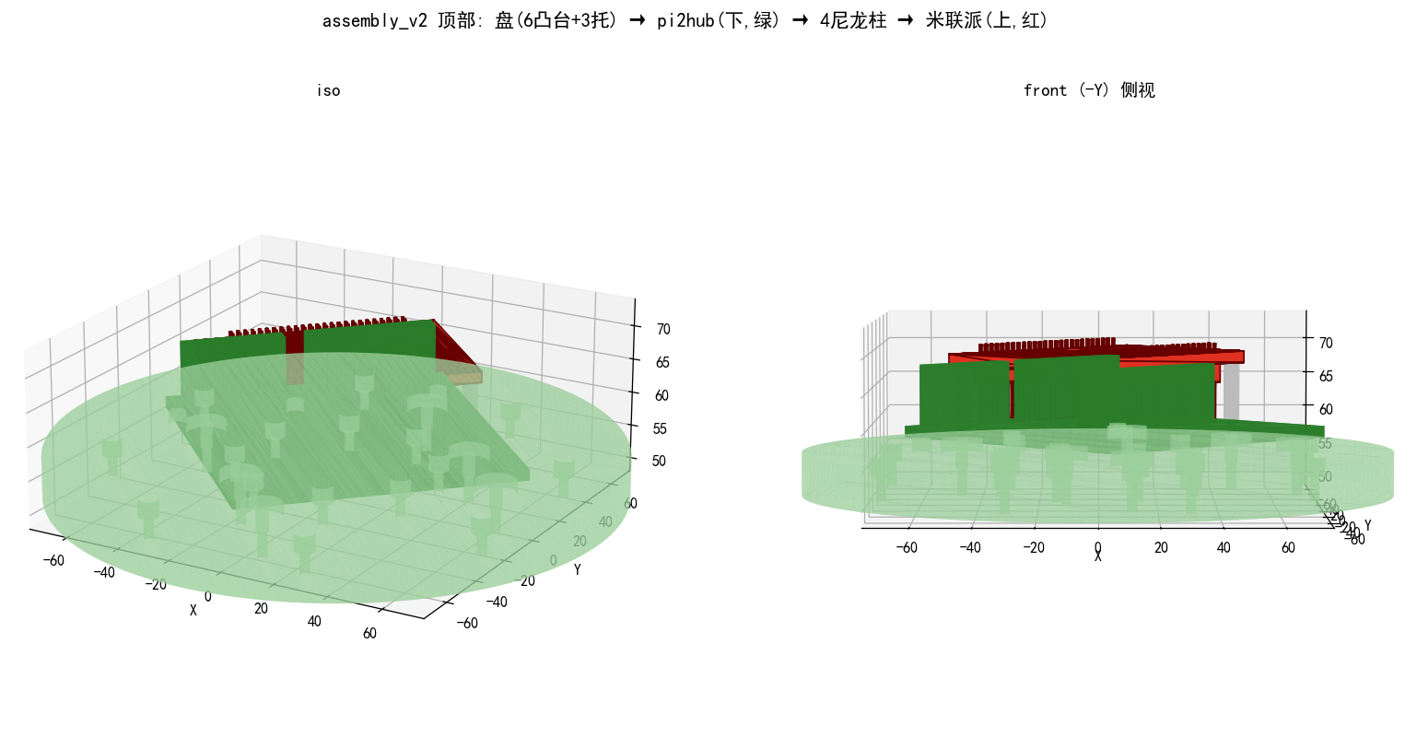
assembly_v2_top_preview.png
