kiujkiu/macha/models/l_bracket_170x60/assembly_preview.png

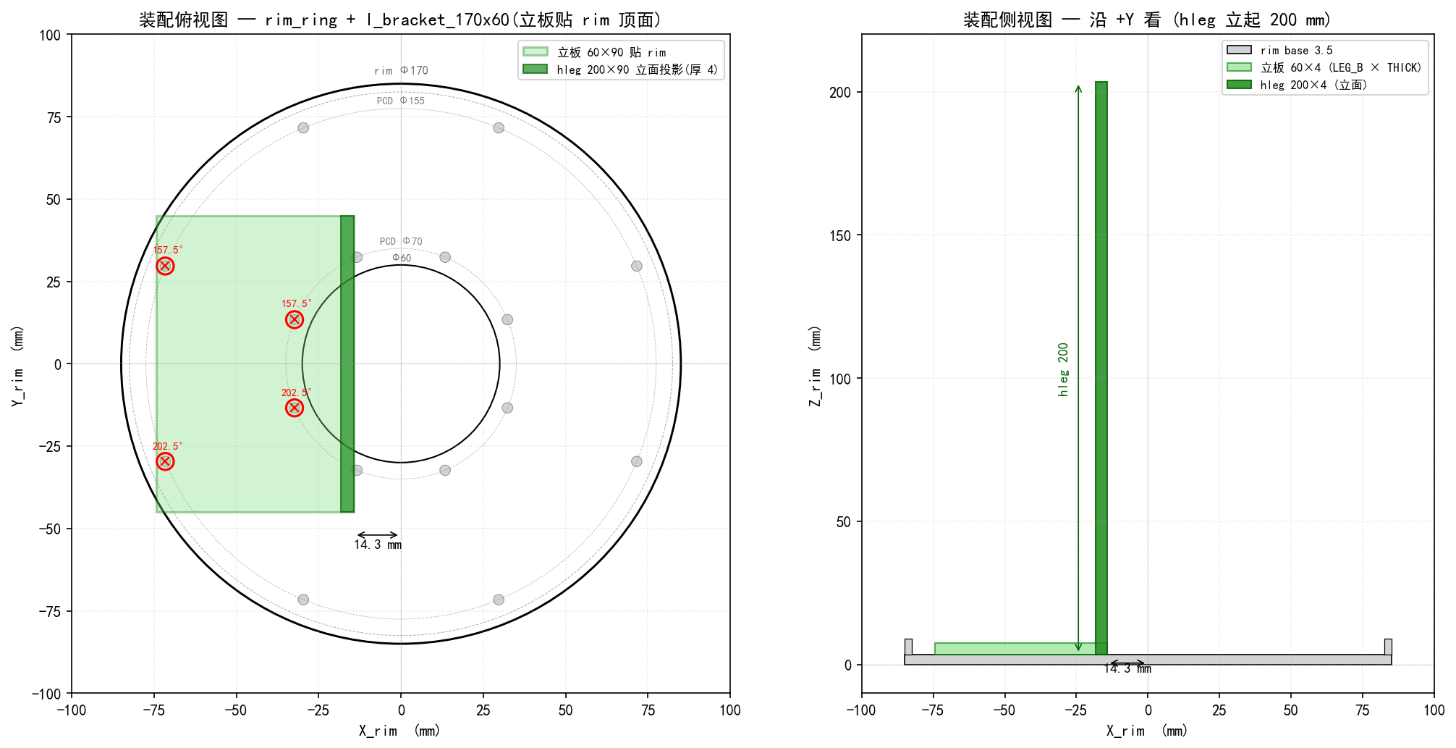
models/l_bracket_170x60/assembly_preview.png
