kiujkiu/macha/models/screen_solder_jig/screen_solder_jig_drawing_preview.png

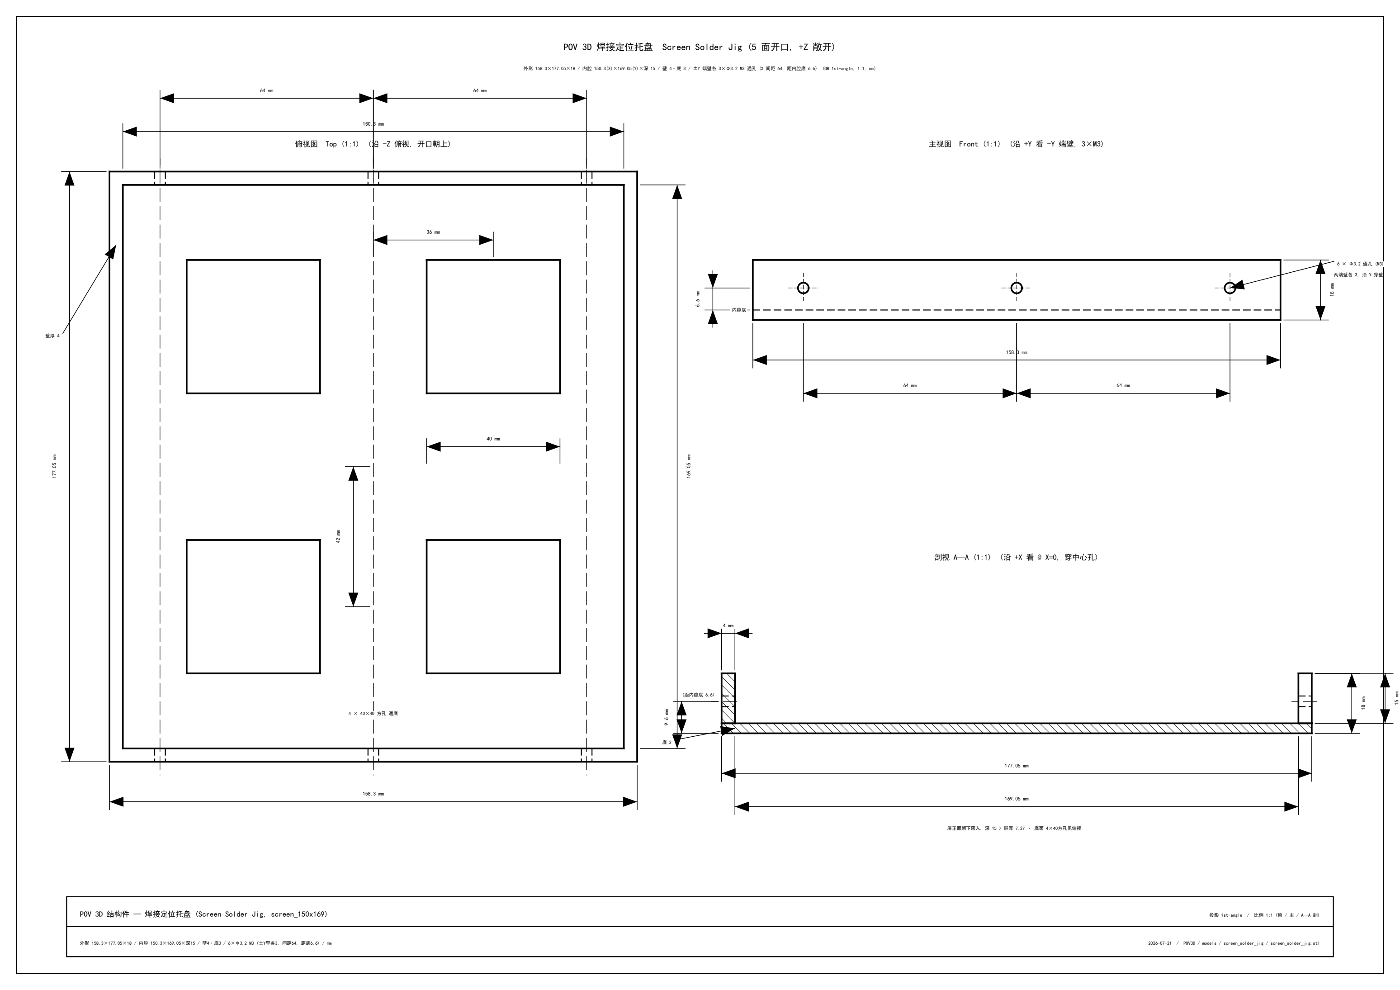
models/screen_solder_jig/screen_solder_jig_drawing_preview.png
