kiujkiu/macha/models/screen_solder_jig/screen_solder_jig_holes.png

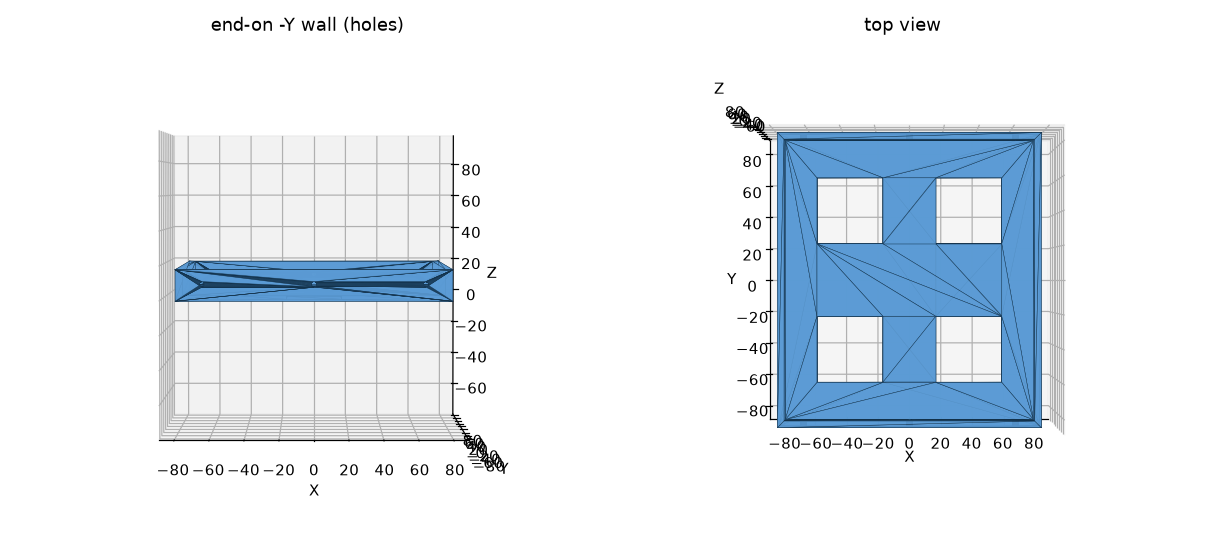
models/screen_solder_jig/screen_solder_jig_holes.png
