kiujkiu/macha/models/screen_solder_jig/screen_solder_jig_preview.png

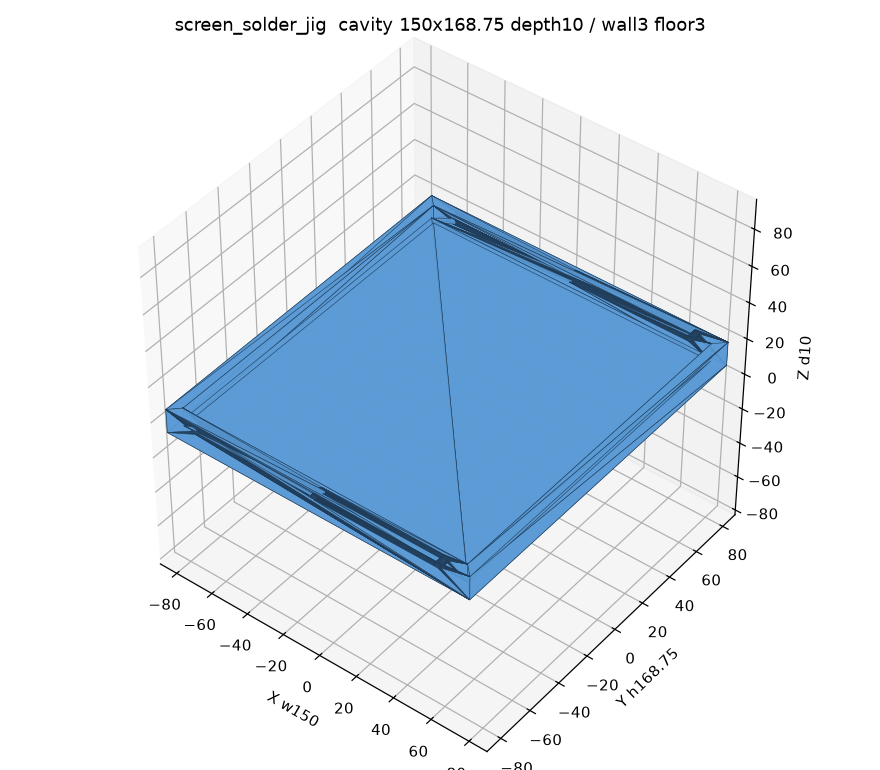
models/screen_solder_jig/screen_solder_jig_preview.png
