kiujkiu/macha/models/screen_solder_jig_bar/screen_solder_jig_bar_drawing_preview.png

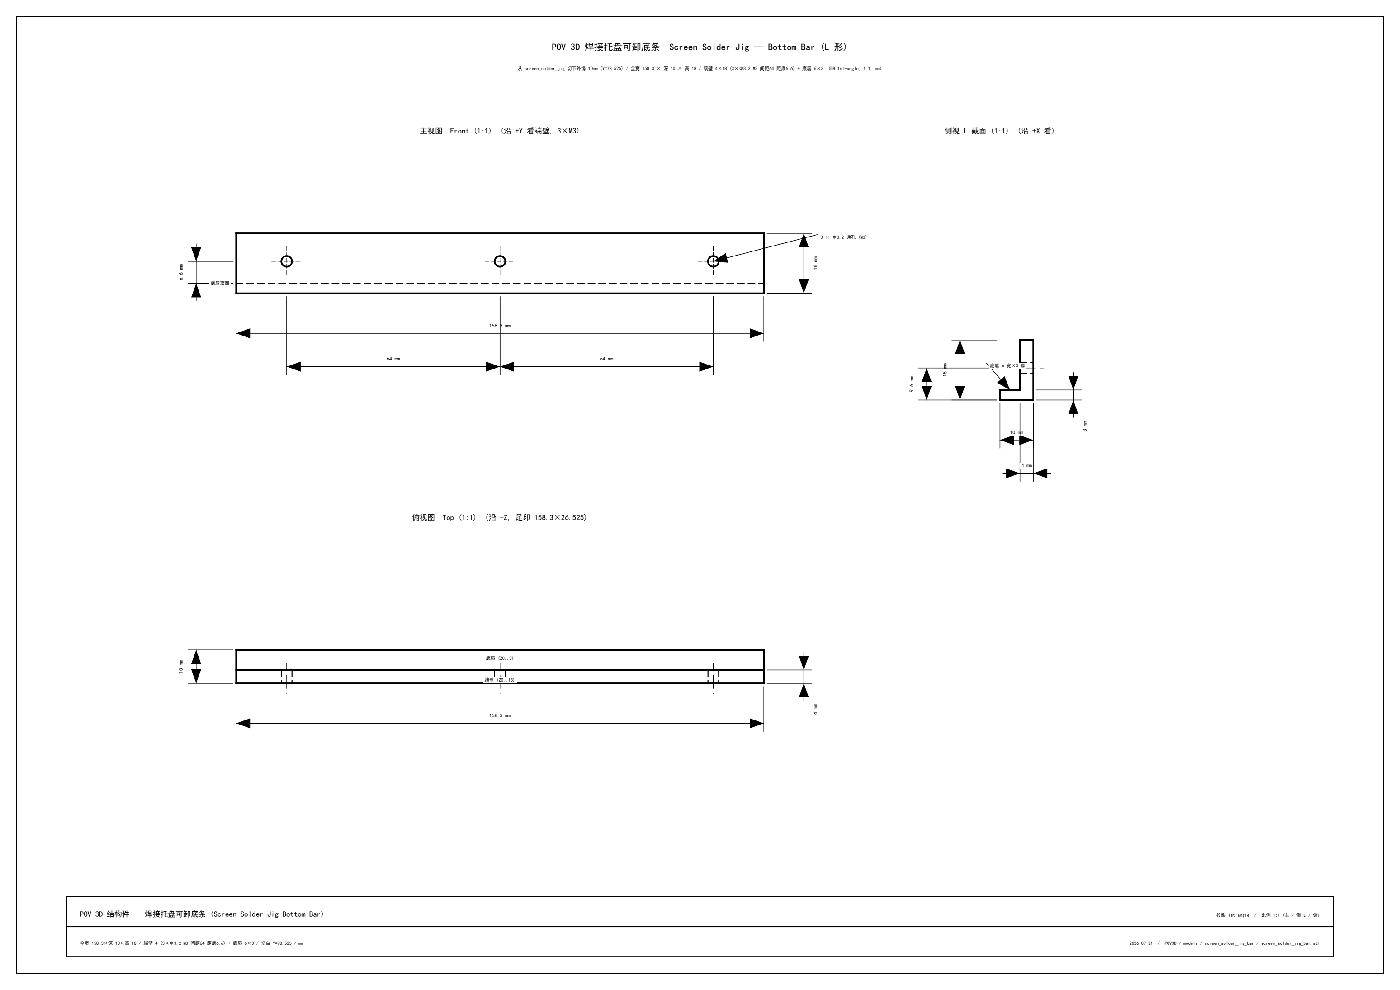
models/screen_solder_jig_bar/screen_solder_jig_bar_drawing_preview.png
