kiujkiu/macha/models/screen_solder_jig_bar/screen_solder_jig_bar_preview.png

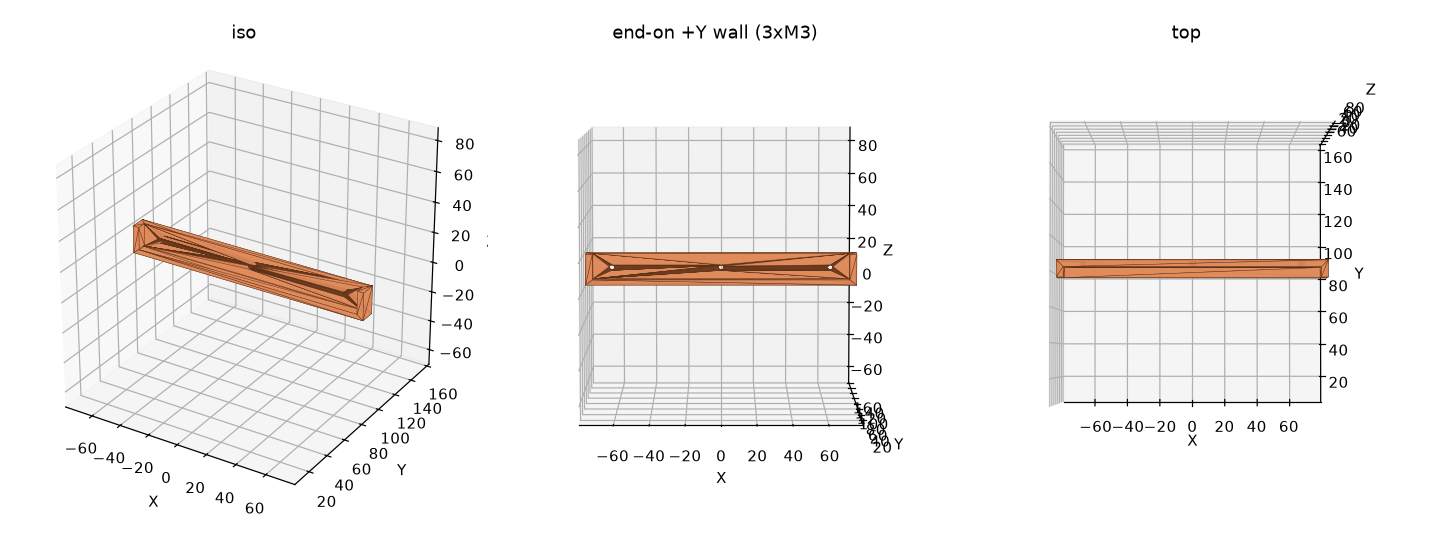
models/screen_solder_jig_bar/screen_solder_jig_bar_preview.png
