kiujkiu/macha/v4/assembly/post_grid_options.png

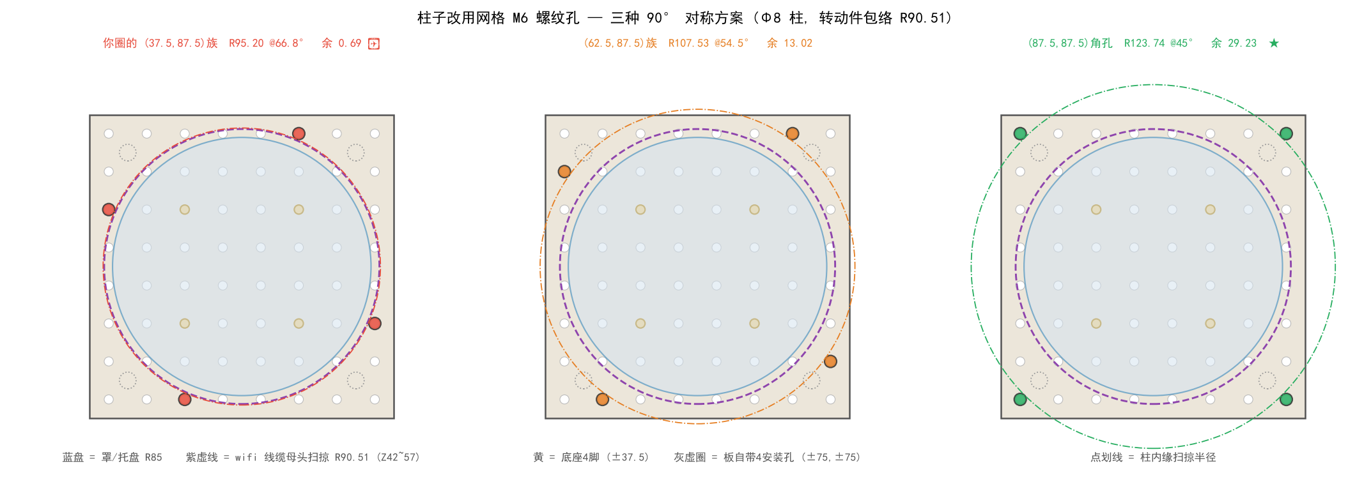
v4/assembly/post_grid_options.png
