kiujkiu/macha/assembly_drawing.pdf

# POV 3D 装配示意 Assembly — rim_ring + rim_top_disc + l_bracket_170x60

## 俯视图 Top View (1:1) (沿 -Z 看)

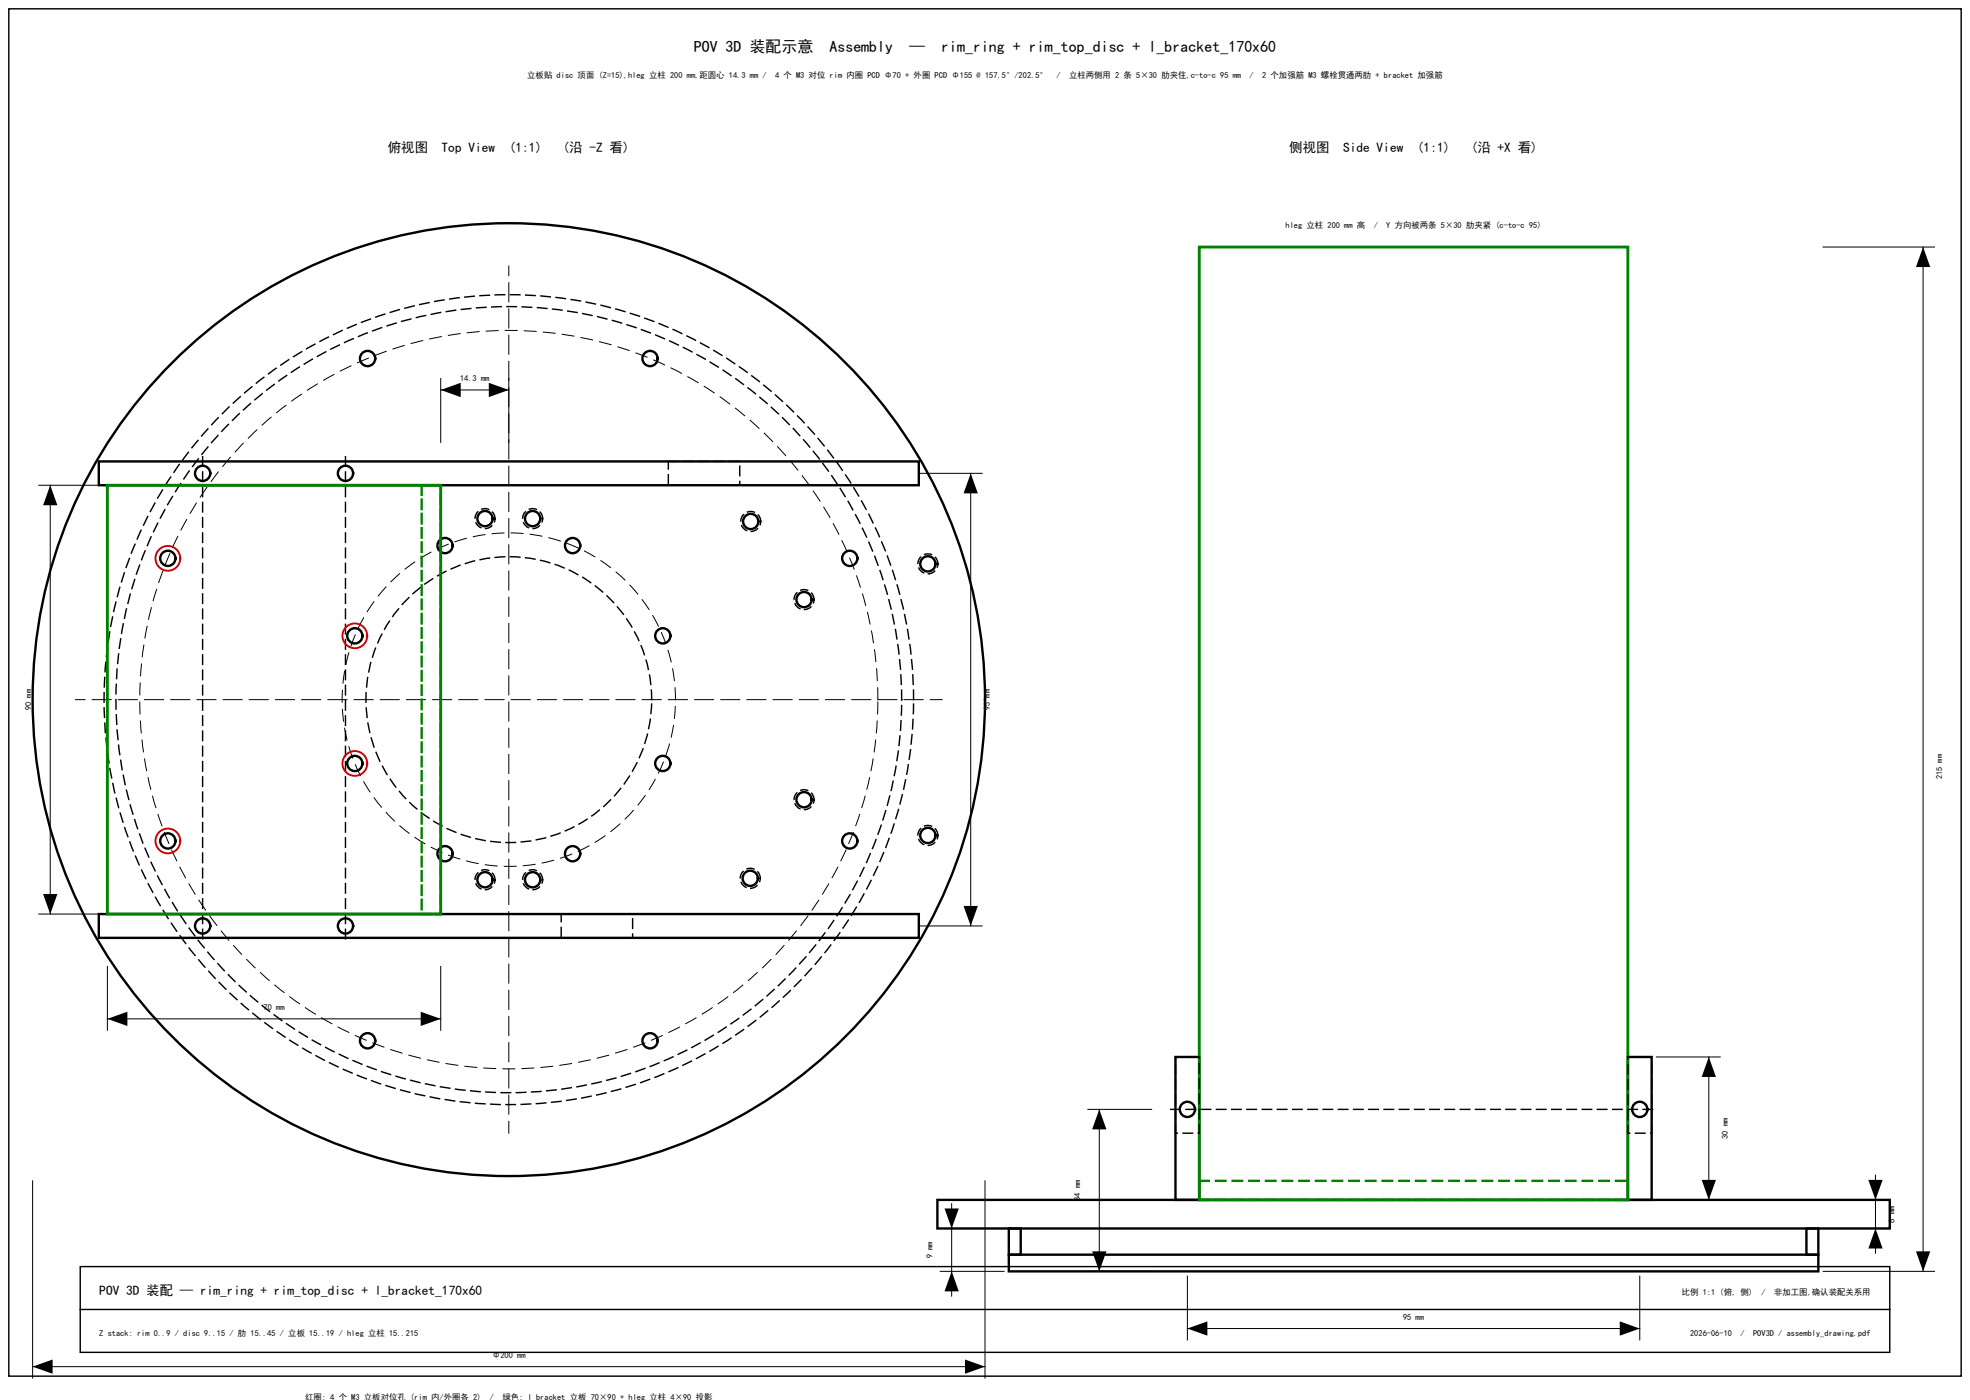
[picture p178: page 1]
侧视图 Side View (1:1); POV 3D 装配 — rim_ring + rim_top_disc + l_bracket_170x60; 比例 1:1 (俯, 侧) / 非加工图,确认装配关系用; Z stack: rim 0..9 / disc 9..15 / 肋 15..45 / 立板 15..19 / hleg 立柱 15..215; 2026-06-10 / POV3D / assembly_drawing.pdf

立板贴 disc 顶面 (Z=15),hleg 立柱 200 mm,距圆心 14.3 mm / 4 个 M3 对位 rim 内圈 PCD Φ70 + 外圈 PCD Φ155 @ 157.5°/202.5° / 立柱两侧用 2 条 5×30 肋夹住,c-to-c 95 mm / 2 个加强筋 M3 螺栓贯通两肋 + bracket 加强筋

hleg 立柱 200 mm 高 / Y 方向被两条 5×30 肋夹紧 (c-to-c 95)

红圈: 4 个 M3 立板对位孔 (rim 内/外圈各 2) / 绿色: l_bracket 立板 70×90 + hleg 立柱 4×90 投影
