kiujkiu/macha/models/screen_solder_jig/screen_solder_jig_drawing.pdf

# POV 3D 焊接定位托盘 Screen Solder Jig (5 面开口, +Z 敞开)

| 俯视图 Top (1:1) (沿 -Z 俯视, 开口朝上)

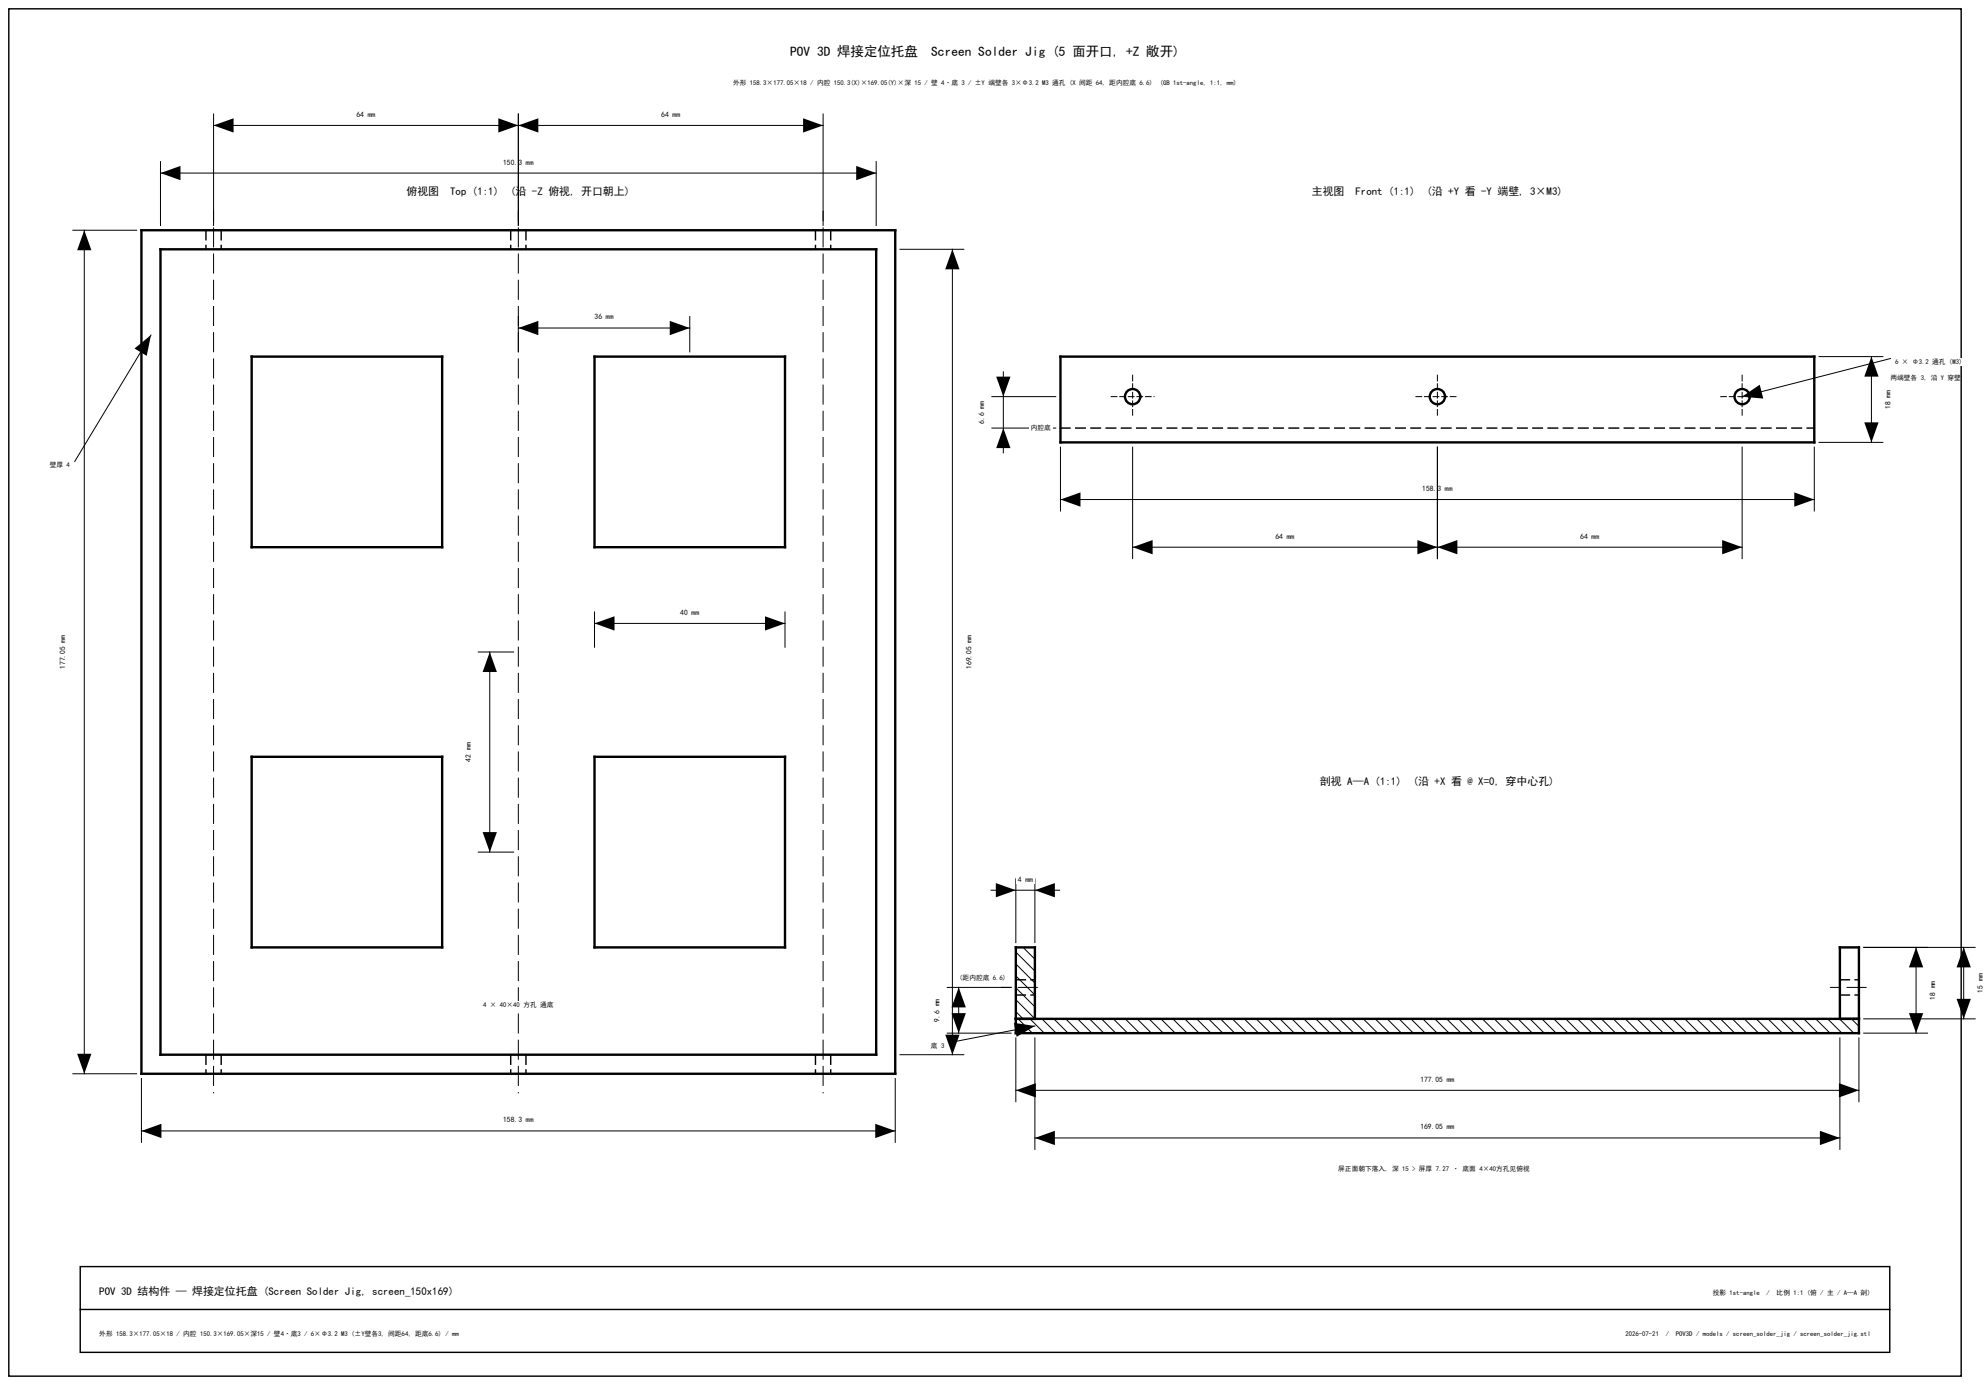
[picture p179: page 1]
两端壁各 3, 沿 Y 穿壁; 内腔底; 剖视 A—A (1:1) (沿 +X 看 @ X=0, 穿中心孔); (距内腔底 6.6); POV 3D 结构件 — 焊接定位托盘 (Screen Solder Jig, screen_150x169); 投影 1st-angle / 比例 1:1 (俯 / 主 / A—A 剖); 外形 158.3×177.05×18 / 内腔 150.3×169.05×深15 / 壁4·底3 / 6×Φ3.2 M3 (±Y壁各3, 间距64, 距底6.6) / mm; 2026-07-21 / POV3D / models / screen_solder_jig / screen_solder_jig.stl

外形 158.3×177.05×18 / 内腔 150.3(X)×169.05(Y)×深 15 / 壁 4·底 3 / ±Y 端壁各 3×Φ3.2 M3 通孔 (X 间距 64, 距内腔底 6.6) (GB 1st-angle, 1:1, mm)

主视图 Front (1:1) (沿 +Y 看 -Y 端壁, 3×M3)

屏正面朝下落入, 深 15 > 屏厚 7.27 · 底面 4×40方孔见俯视
