kiujkiu/macha/v4/print/mounting_flange_v4/mounting_flange_v4_drawing.pdf

# POV 3D 安装法兰 Mounting Flange

## 俯视图 Top View (1:1) 尺寸单位: mm

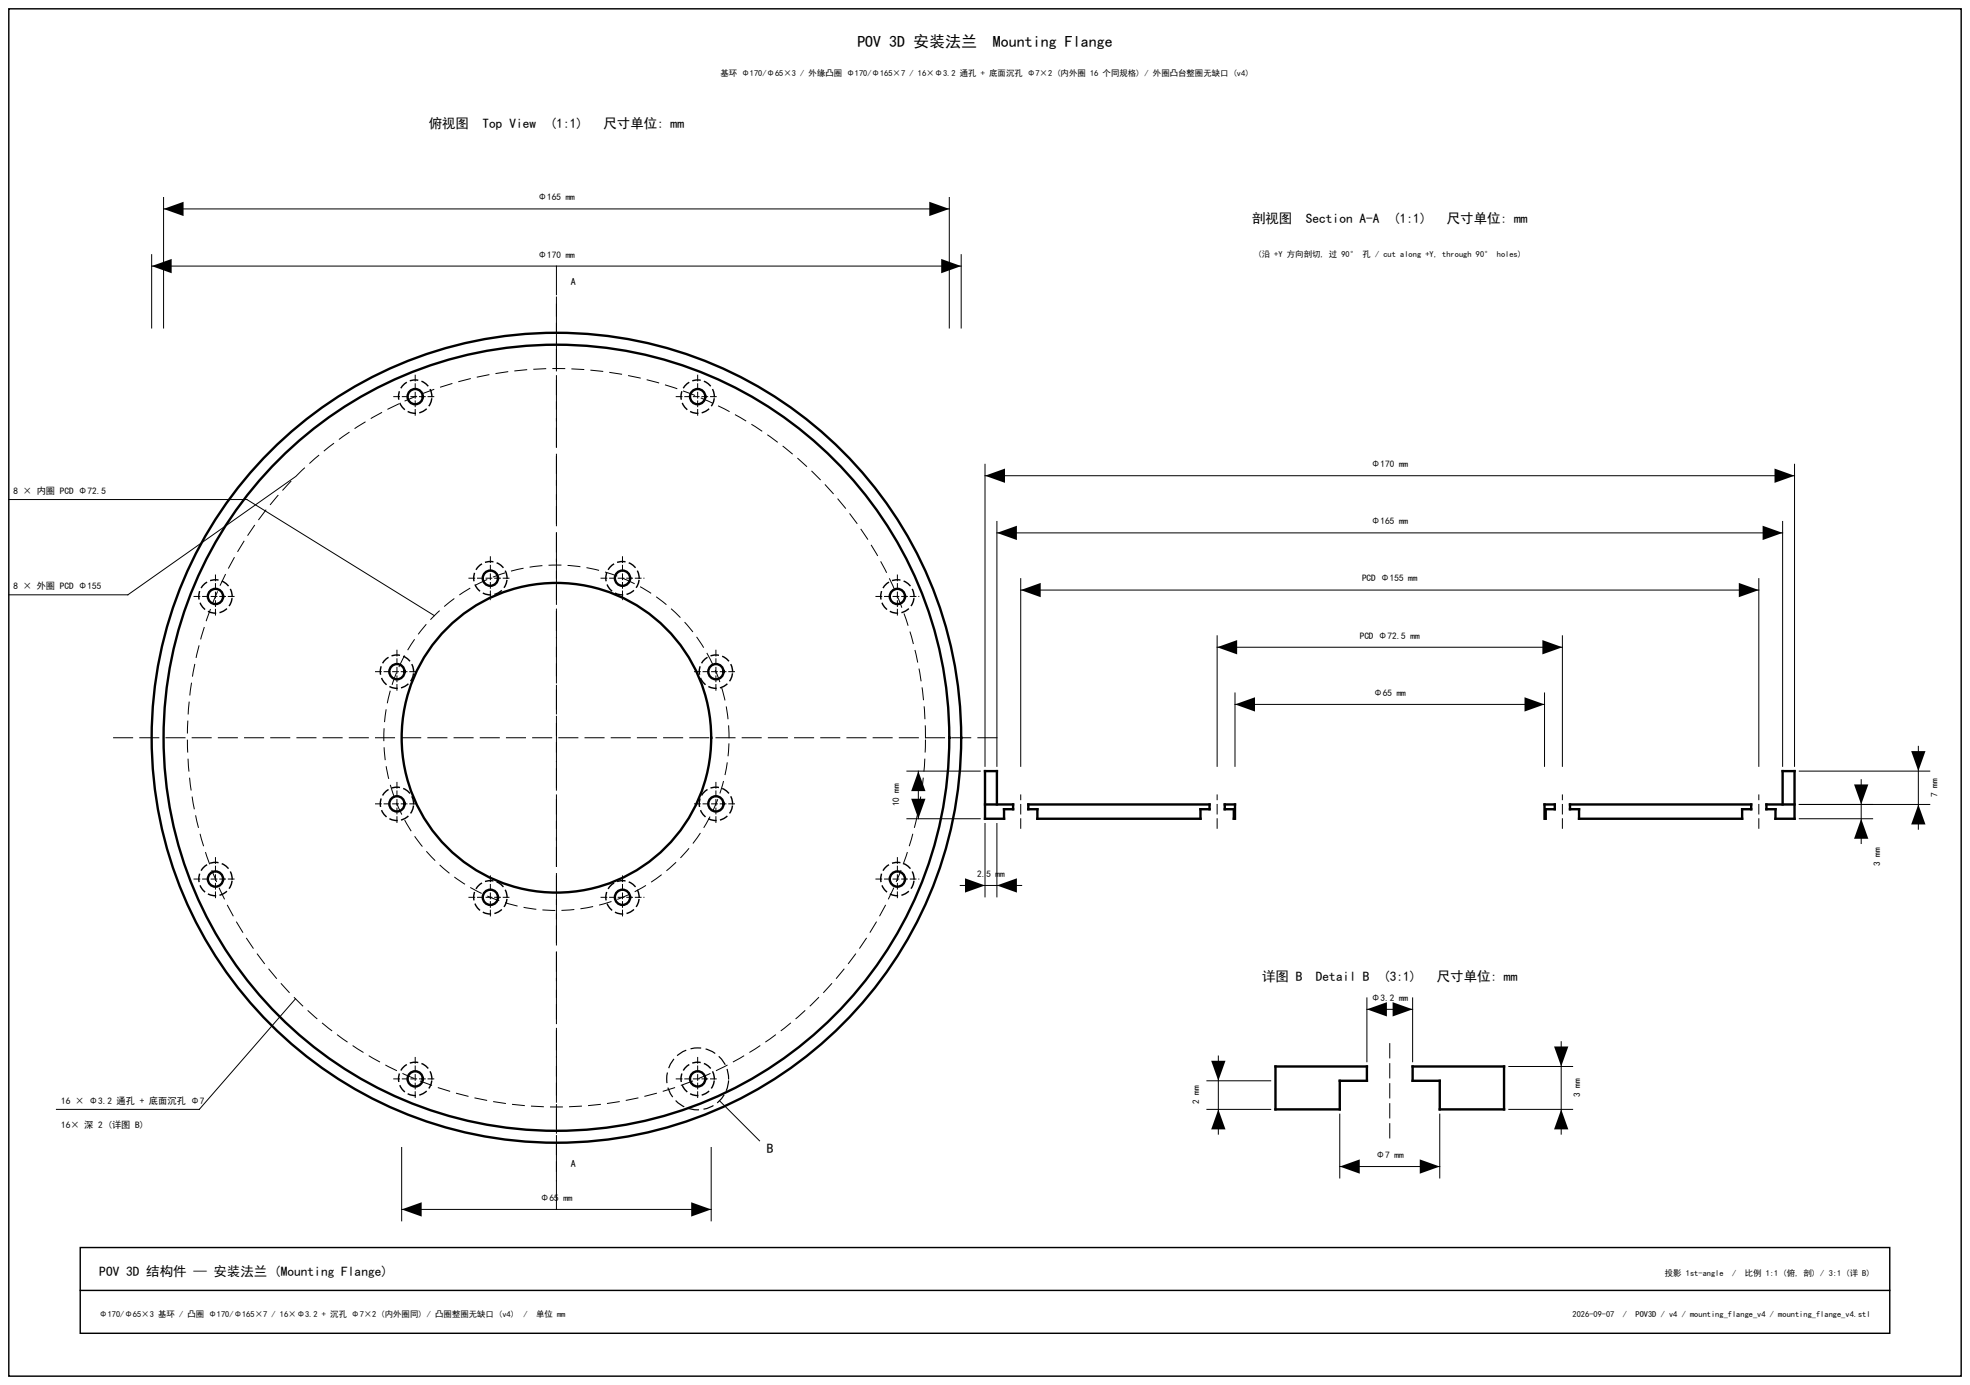
[picture p180: page 1]
8 × 内圈 PCD Φ72.5; 8 × 外圈 PCD Φ155; 16 × Φ3.2 通孔 + 底面沉孔 Φ7; 剖视图 Section A-A (1:1); 尺寸单位: mm; PCD Φ72.5 mm; PCD Φ155 mm; 详图 B Detail B (3:1); POV 3D 结构件 — 安装法兰 (Mounting Flange); 投影 1st-angle / 比例 1:1 (俯, 剖) / 3:1 (详 B); Φ170/Φ65×3 基环 / 凸圈 Φ170/Φ165×7 / 16×Φ3.2 + 沉孔 Φ7×2 (内外圈同) / 凸圈整圈无缺口 (v4) / 单位 mm; 2026-09-07 / POV3D / v4 / mounting_flange_v4 / mounting_flange_v4.stl

基环 Φ170/Φ65×3 / 外缘凸圈 Φ170/Φ165×7 / 16×Φ3.2 通孔 + 底面沉孔 Φ7×2 (内外圈 16 个同规格) / 外圈凸台整圈无缺口 (v4)

(沿 +Y 方向剖切, 过 90° 孔 / cut along +Y, through 90° holes)
