kiujkiu/macha/v4/print/top_bearing_frame_v4/frame_A_v4_drawing.pdf

# POV 3D v4 — frame_A_v4 顶轴承架 A (下层架, ×1)

## 主视图 (从 -Y 视向, 2:1)

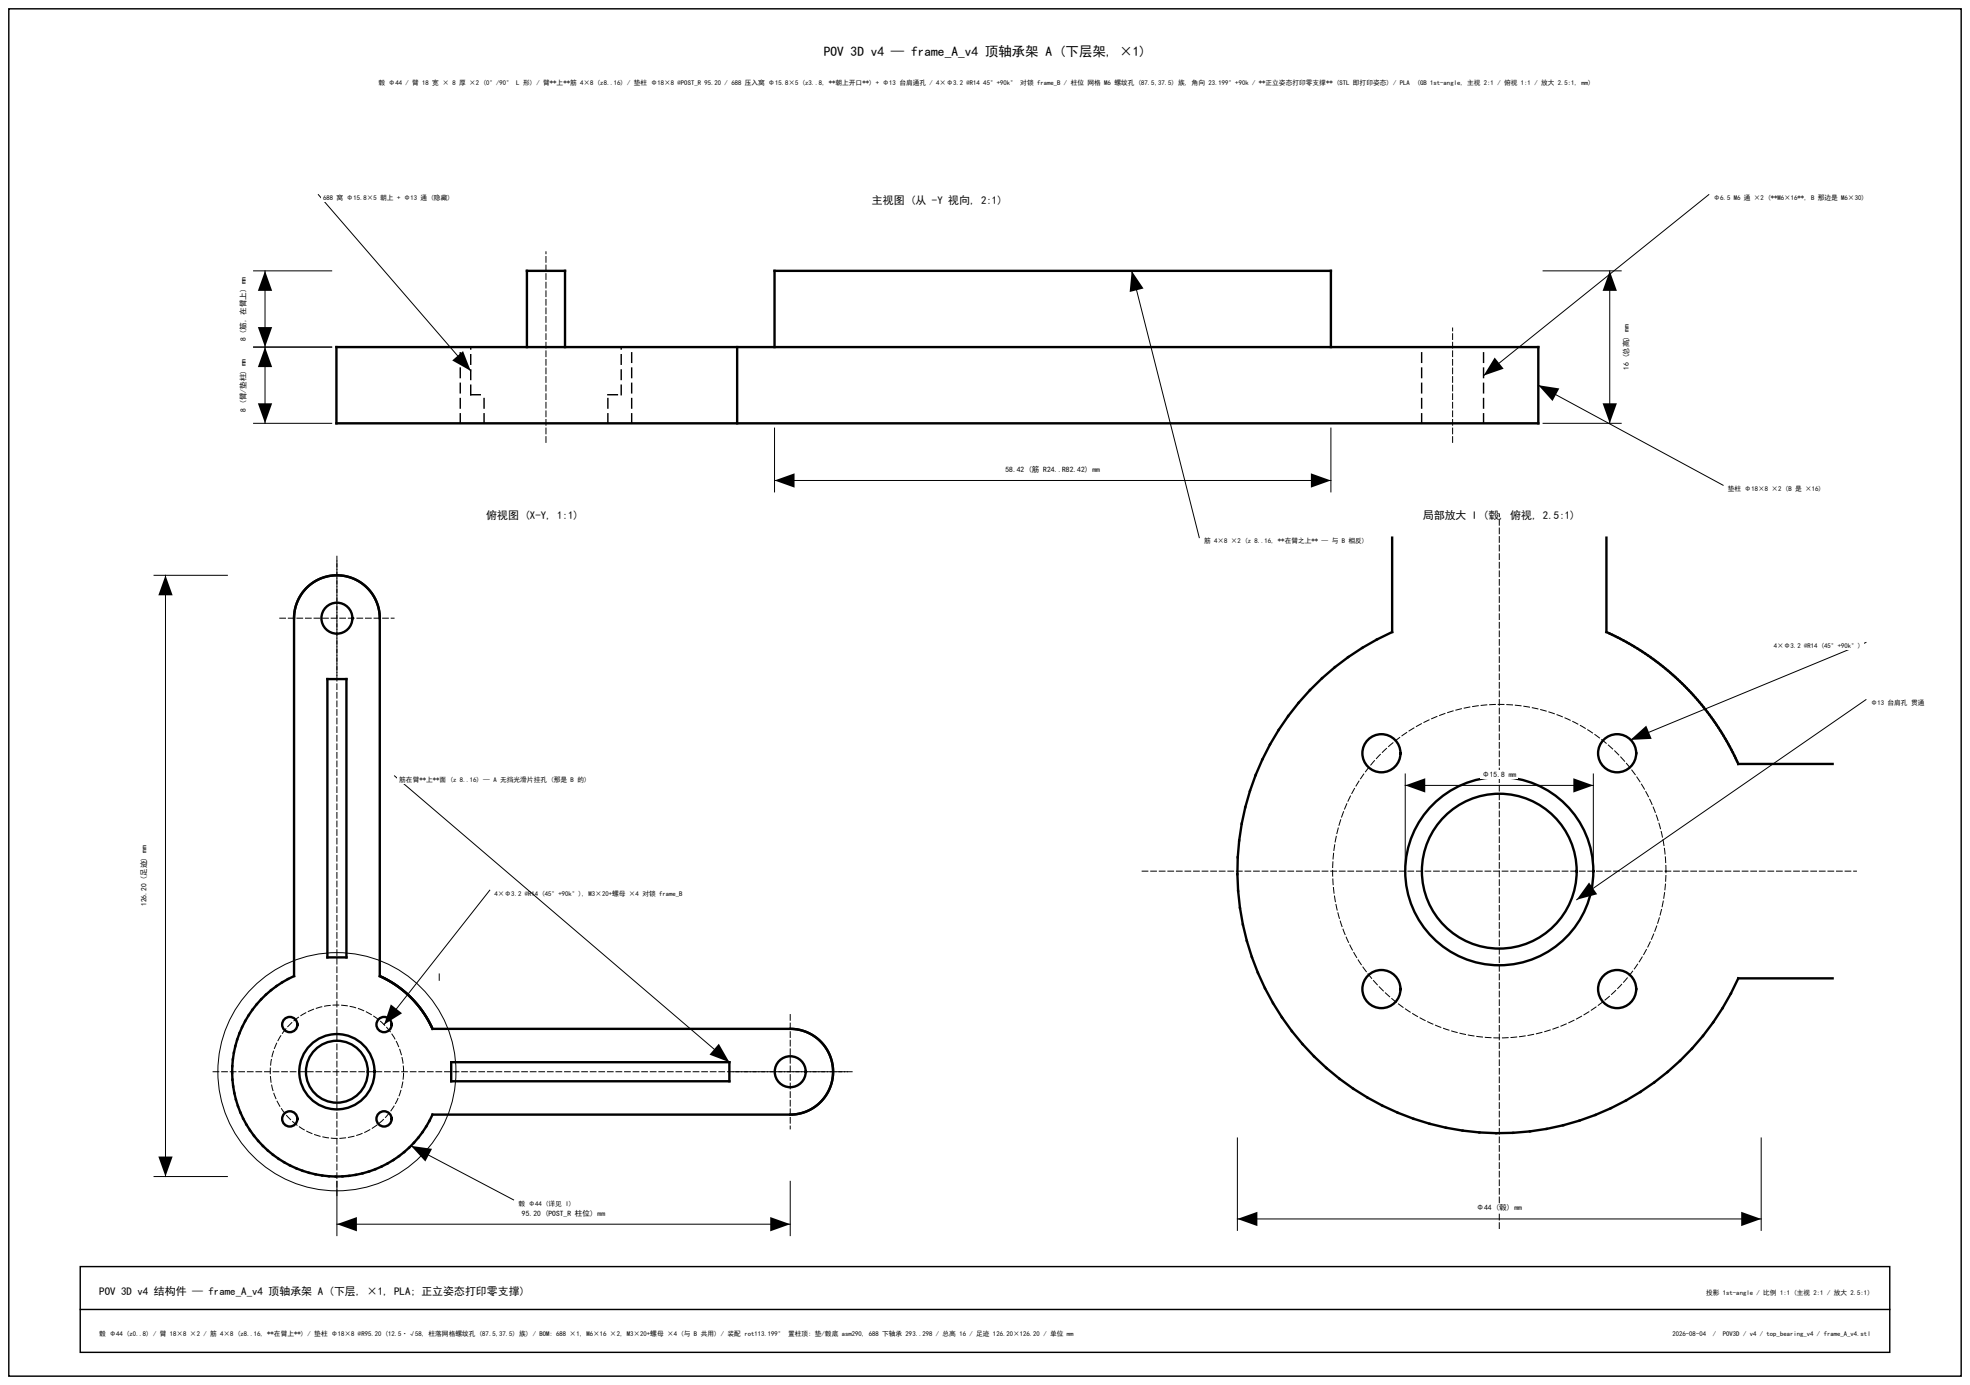
[picture p181: page 1]
Φ6.5 M6 通 ×2 (**M6×16**, B 那边是 M6×30); 筋 4×8 ×2 (z 8..16, **在臂之上** — 与 B 相反); 俯视图 (X-Y, 1:1); 95.20 (POST_R 柱位) mm; 4×Φ3.2 @R14 (45°+90k°), M3×20+螺母 ×4 对锁 frame_B; 局部放大 I (毂, 俯视, 2.5:1); Φ13 台肩孔 贯通; POV 3D v4 结构件 — frame_A_v4 顶轴承架 A (下层, ×1, PLA; 正立姿态打印零支撑); 投影 1st-angle / 比例 1:1 (主视 2:1 / 放大 2.5:1)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

毂 Φ44 / 臂 18 宽 × 8 厚 ×2 (0°/90° L 形) / 臂**上**筋 4×8 (z8..16) / 垫柱 Φ18×8 @POST_R 95.20 / 688 压入窝 Φ15.8×5 (z3..8, **朝上开口**) + Φ13 台肩通孔 / 4×Φ3.2 @R14 45°+90k° 对锁 frame_B / 柱位 网格 M6 螺纹孔 (87.5,37.5) 族, 角向 23.199°+90k / **正立姿态打印零支撑** (STL 即打印姿态) / PLA (GB 1st-angle, 主视 2:1 / 俯视 1:1 / 放大 2.5:1, mm)

8 (臂/垫柱) mm 8 (筋, 在臂上) mm

筋在臂**上**面 (z 8..16) — A 无挡光滑片挂孔 (那是 B 的)

I ¹²⁶.20 (足迹⁾ mm
