kiujkiu/macha/v4/print/hub_disc/hub_disc_drawing.pdf

# POV 3D 轴座盘 Hub Disc

## 俯视图 Top View (1:1) 尺寸单位: mm

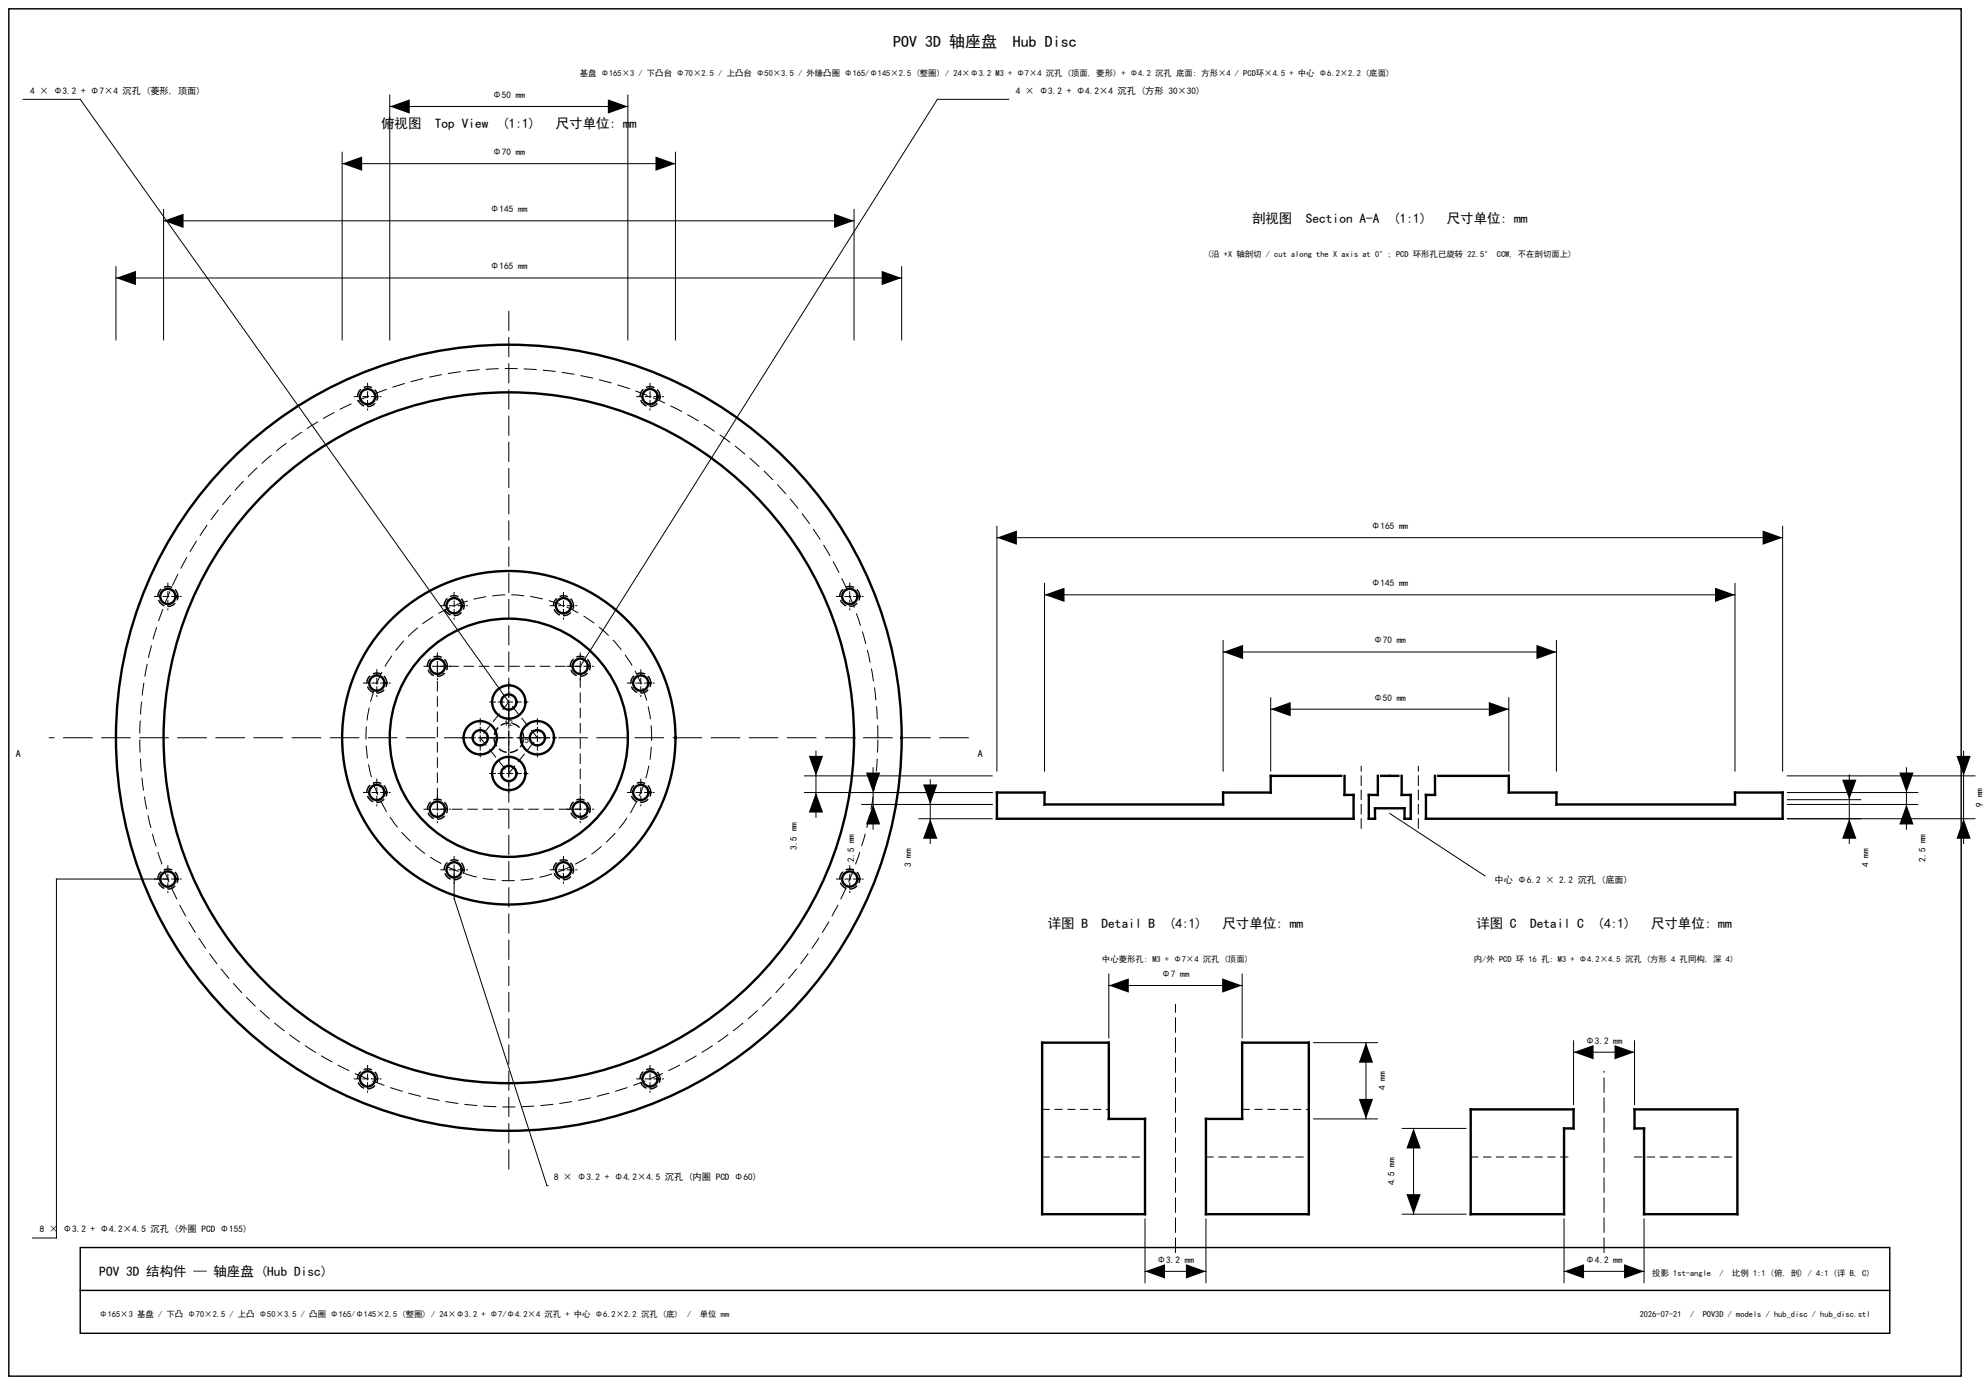
[picture p182: page 1]
Φ3.2 + Φ4.2×4.5 沉孔 (外圈 PCD Φ155); 剖视图 Section A-A (1:1); 尺寸单位: mm; 详图 B Detail B (4:1); 详图 C Detail C (4:1); POV 3D 结构件 — 轴座盘 (Hub Disc); 投影 1st-angle / 比例 1:1 (俯, 剖) / 4:1 (详 B, C); 2026-07-21 / POV3D / models / hub_disc / hub_disc.stl

基盘 Φ165×3 / 下凸台 Φ70×2.5 / 上凸台 Φ50×3.5 / 外缘凸圈 Φ165/Φ145×2.5 (整圈) / 24×Φ3.2 M3 + Φ7×4 沉孔 (顶面, 菱形) + Φ4.2 沉孔 底面: 方形×4 / PCD环×4.5 + 中心 Φ6.2×2.2 (底面)

(沿 +X 轴剖切 / cut along the X axis at 0°; PCD 环形孔已旋转 22.5° CCW, 不在剖切面上)

中心菱形孔: M3 + Φ7×4 沉孔 (顶面)

内/外 PCD 环 16 孔: M3 + Φ4.2×4.5 沉孔 (方形 4 孔同构, 深 4)

8 × Φ3.2 + Φ4.2×4.5 沉孔 (内圈 PCD Φ60)
