kiujkiu/macha/models/flange_disc/flange_disc_drawing.pdf

# POV 3D 法兰盘 Flange Disc

## 俯视图 Top View (1:1) 尺寸单位: mm

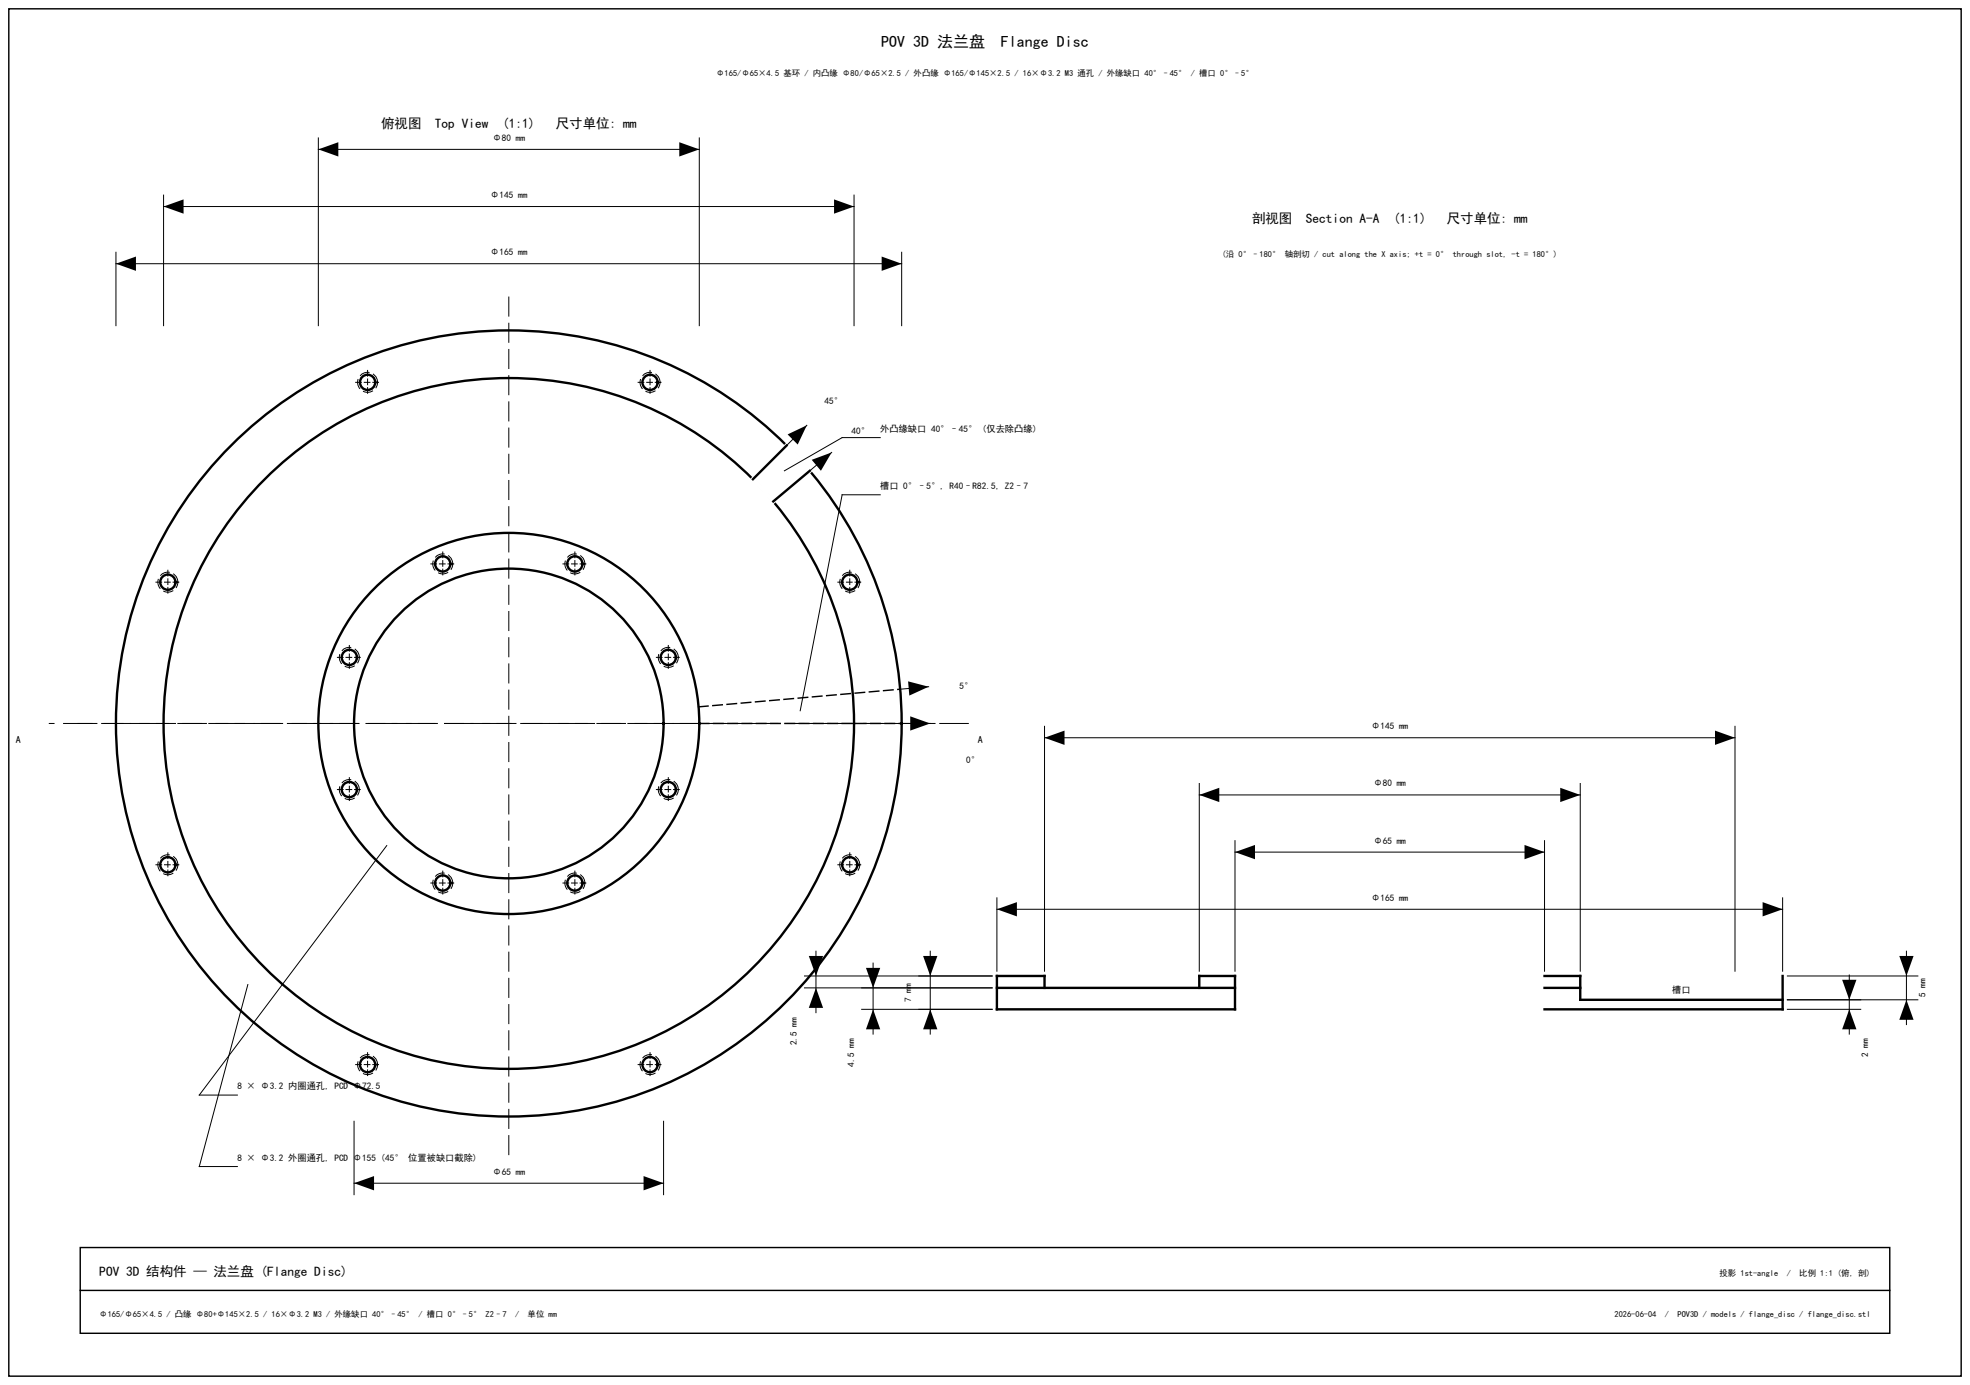
[picture p184: page 1]
8 × Φ3.2 内圈通孔, PCD Φ72.5; 外凸缘缺口 40°–45° (仅去除凸缘); 剖视图 Section A-A (1:1); 尺寸单位: mm; POV 3D 结构件 — 法兰盘 (Flange Disc); 投影 1st-angle / 比例 1:1 (俯, 剖); Φ165/Φ65×4.5 / 凸缘 Φ80+Φ145×2.5 / 16×Φ3.2 M3 / 外缘缺口 40°–45° / 槽口 0°–5° Z2–7 / 单位 mm; 2026-06-04 / POV3D / models / flange_disc / flange_disc.stl

Φ165/Φ65×4.5 基环 / 内凸缘 Φ80/Φ65×2.5 / 外凸缘 Φ165/Φ145×2.5 / 16×Φ3.2 M3 通孔 / 外缘缺口 40°–45° / 槽口 0°–5°

(沿 0°–180° 轴剖切 / cut along the X axis; +t = 0° through slot, -t = 180°)

8 × Φ3.2 外圈通孔, PCD Φ155 (45° 位置被缺口截除)
