kiujkiu/macha/models/baseplate_collar/baseplate_collar_drawing.pdf

# POV 3D 底盘+套环 合并件 Baseplate + Ring Collar

## 俯视图 Top View (1:1) 尺寸单位: mm

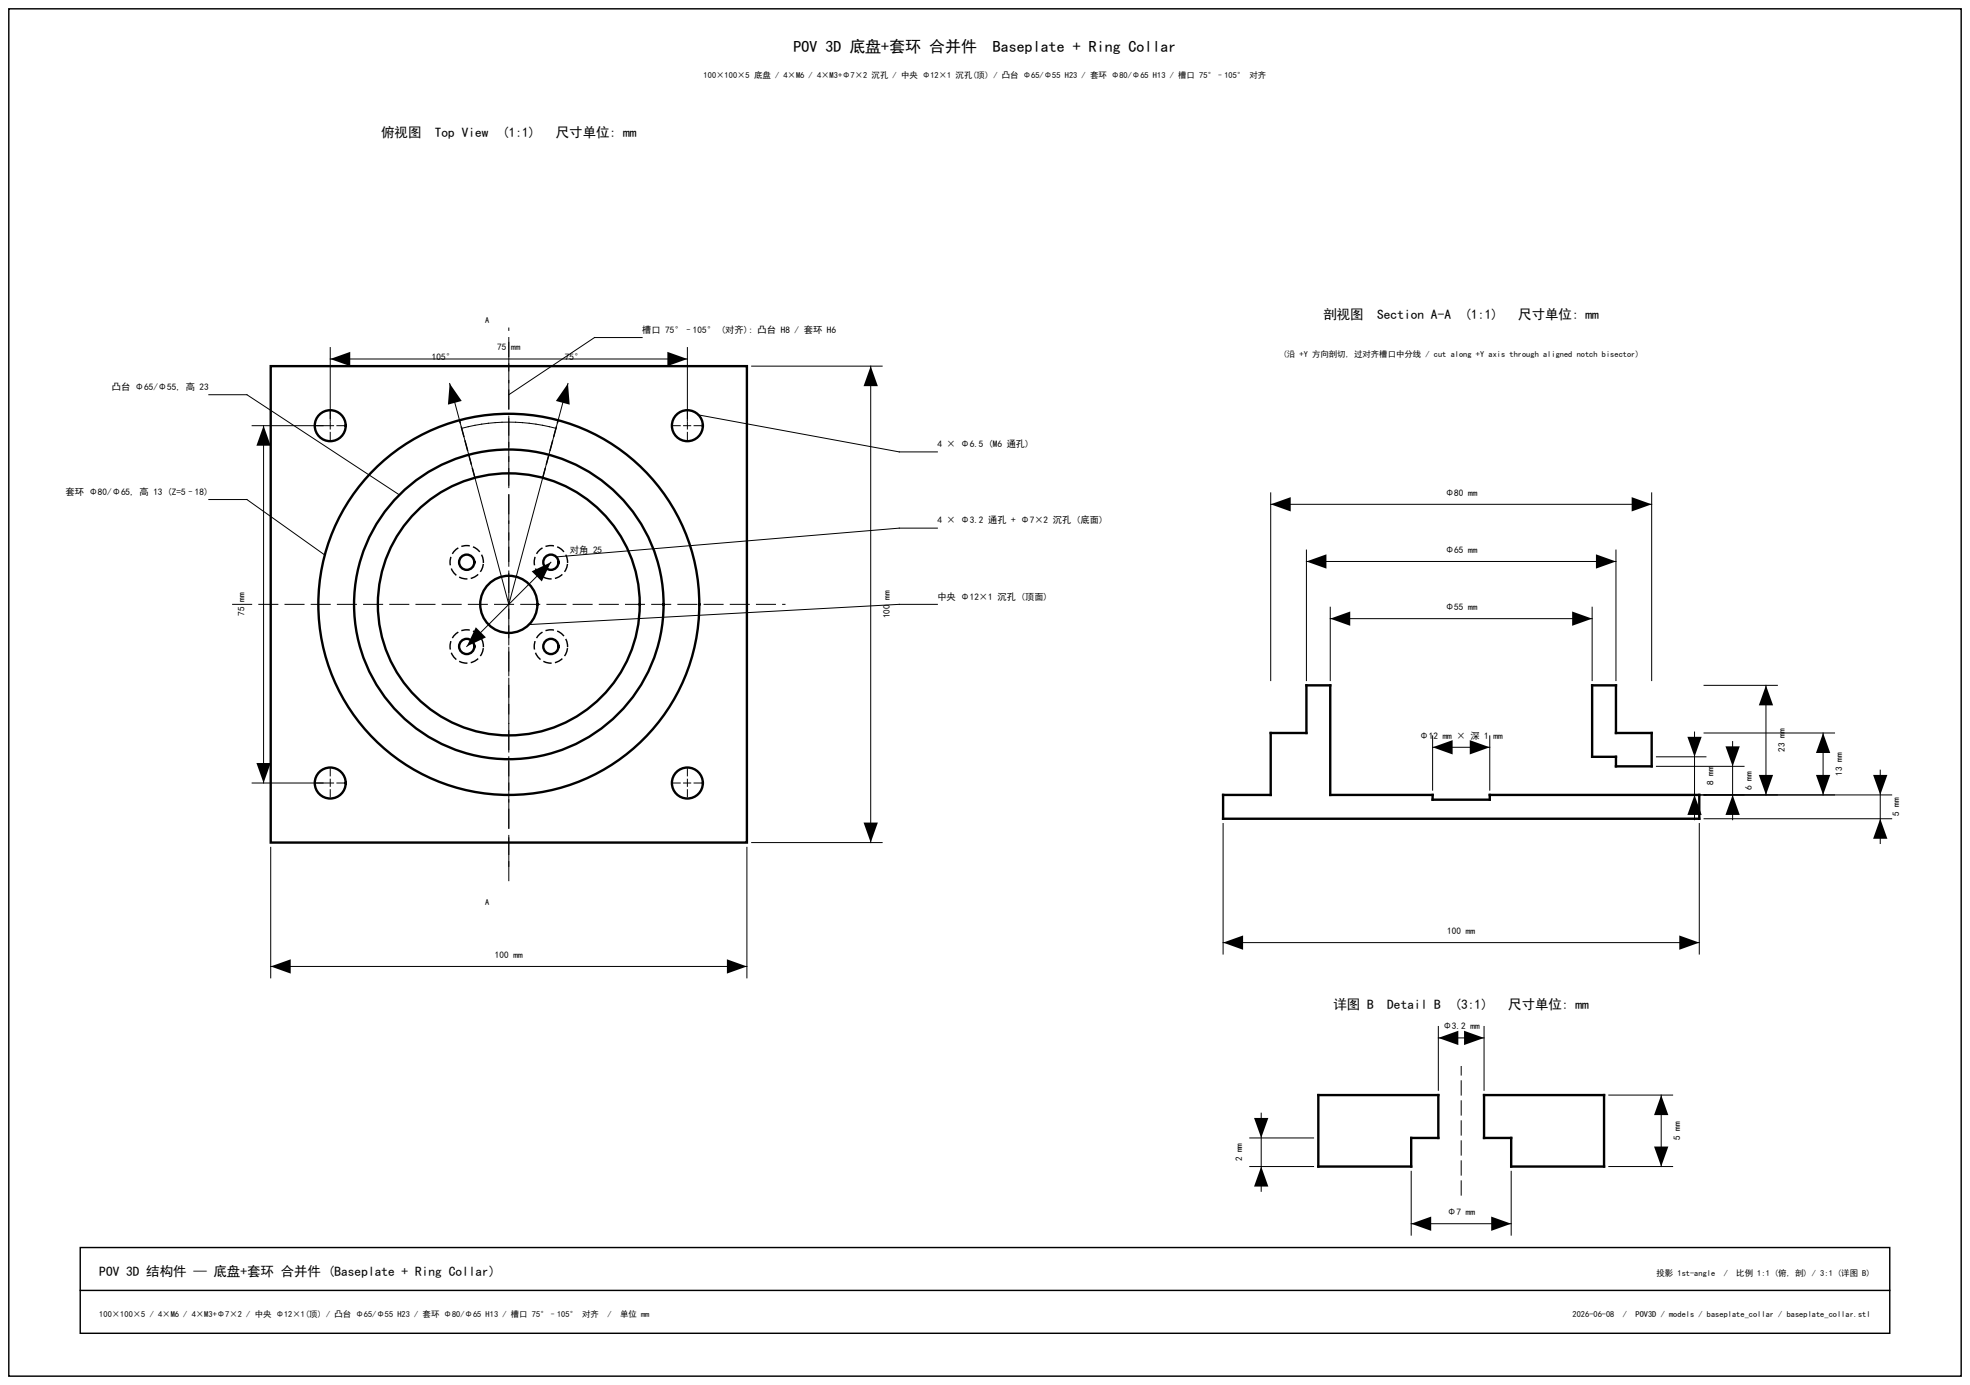
[picture p185: page 1]
剖视图 Section A-A (1:1); 尺寸单位: mm; 详图 B Detail B (3:1); POV 3D 结构件 — 底盘+套环 合并件 (Baseplate + Ring Collar); 投影 1st-angle / 比例 1:1 (俯, 剖) / 3:1 (详图 B); 2026-06-08 / POV3D / models / baseplate_collar / baseplate_collar.stl

(沿 +Y 方向剖切, 过对齐槽口中分线 / cut along +Y axis through aligned notch bisector)
