kiujkiu/macha/v4/print/hub_shim_v4/hub_shim_v4_drawing.pdf

# POV 3D 转子侧垫片 Hub Shim v4

# 俯视图 Top View (1:1) 尺寸单位: mm

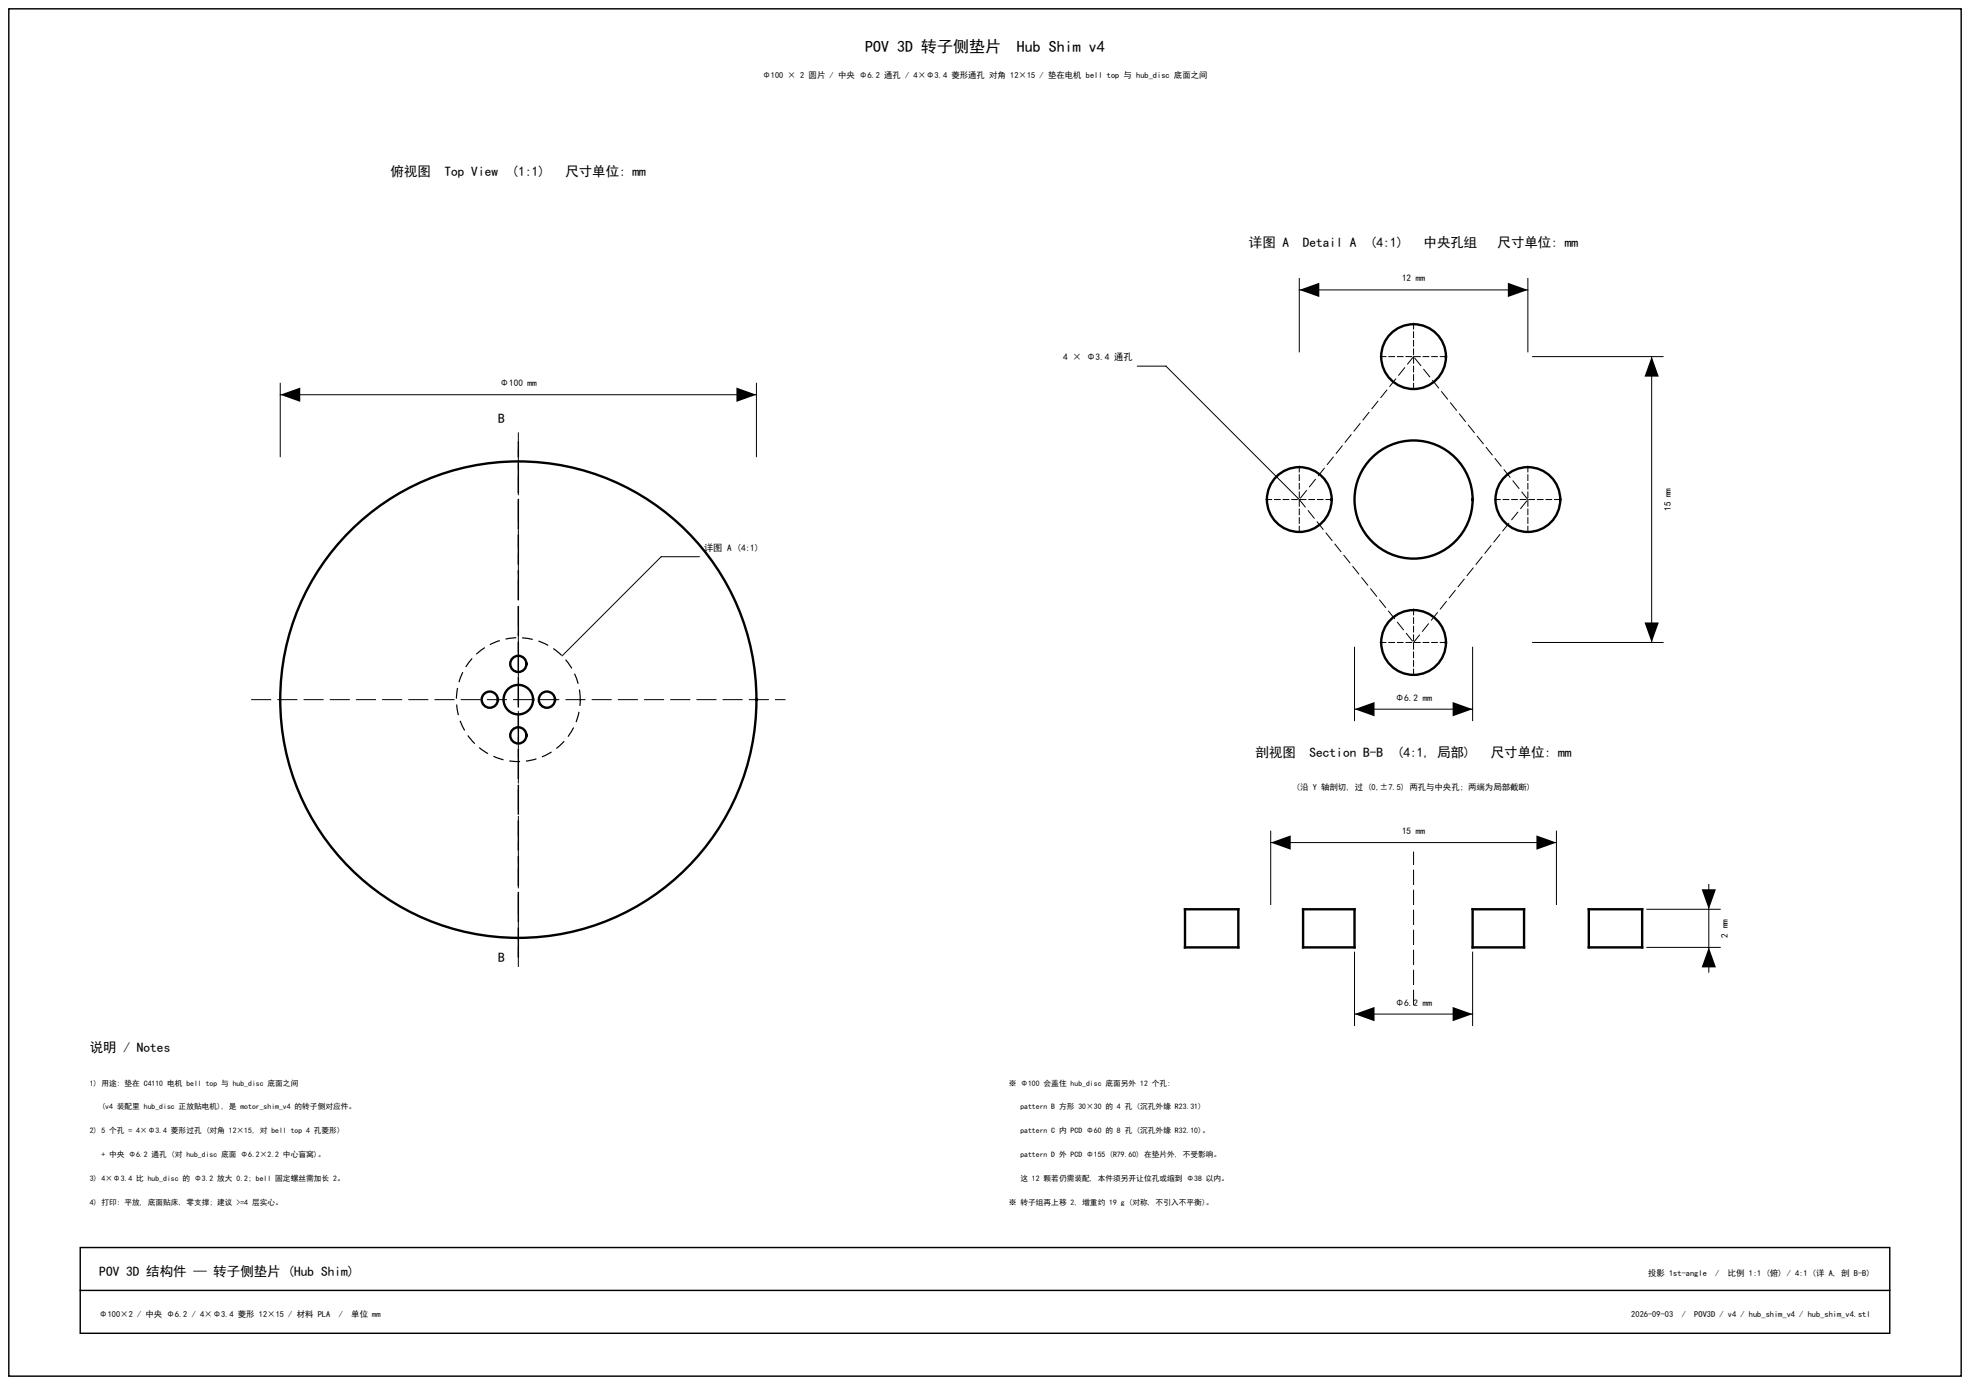
[picture p186: page 1]
详图 A Detail A (4:1); 中央孔组; 尺寸单位: mm; 剖视图 Section B-B (4:1, 局部); 说明 / Notes; POV 3D 结构件 — 转子侧垫片 (Hub Shim); 投影 1st-angle / 比例 1:1 (俯) / 4:1 (详 A, 剖 B-B); Φ100×2 / 中央 Φ6.2 / 4×Φ3.4 菱形 12×15 / 材料 PLA / 单位 mm; 2026-09-03 / POV3D / v4 / hub_shim_v4 / hub_shim_v4.stl

Φ100 × 2 圆片 / 中央 Φ6.2 通孔 / 4×Φ3.4 菱形通孔 对角 12×15 / 垫在电机 bell top 与 hub_disc 底面之间

(沿 Y 轴剖切, 过 (0,±7.5) 两孔与中央孔; 两端为局部截断)

1) 用途: 垫在 C4110 电机 bell top 与 hub_disc 底面之间

※ Φ100 会盖住 hub_disc 底面另外 12 个孔:

(v4 装配里 hub_disc 正放贴电机), 是 motor_shim_v4 的转子侧对应件。

pattern B 方形 30×30 的 4 孔 (沉孔外缘 R23.31)

2) 5 个孔 = 4×Φ3.4 菱形过孔 (对角 12×15, 对 bell top 4 孔菱形)

pattern C 内 PCD Φ60 的 8 孔 (沉孔外缘 R32.10)。

+ 中央 Φ6.2 通孔 (对 hub_disc 底面 Φ6.2×2.2 中心盲窝)。

pattern D 外 PCD Φ155 (R79.60) 在垫片外, 不受影响。

3) 4×Φ3.4 比 hub_disc 的 Φ3.2 放大 0.2; bell 固定螺丝需加长 2。

这 12 颗若仍需装配, 本件须另开让位孔或缩到 Φ38 以内。

4) 打印: 平放, 底面贴床, 零支撑; 建议 >=4 层实心。

※ 转子组再上移 2, 增重约 19 g (对称, 不引入不平衡)。
