kiujkiu/macha/models/washer_m3_6p8x1p5/washer_m3_6p8x1p5_drawing.pdf

# POV 3D 平垫圈 Washer M3 Φ6.8 × 1.5

## 俯视图 Top View (10:1) 尺寸单位: mm

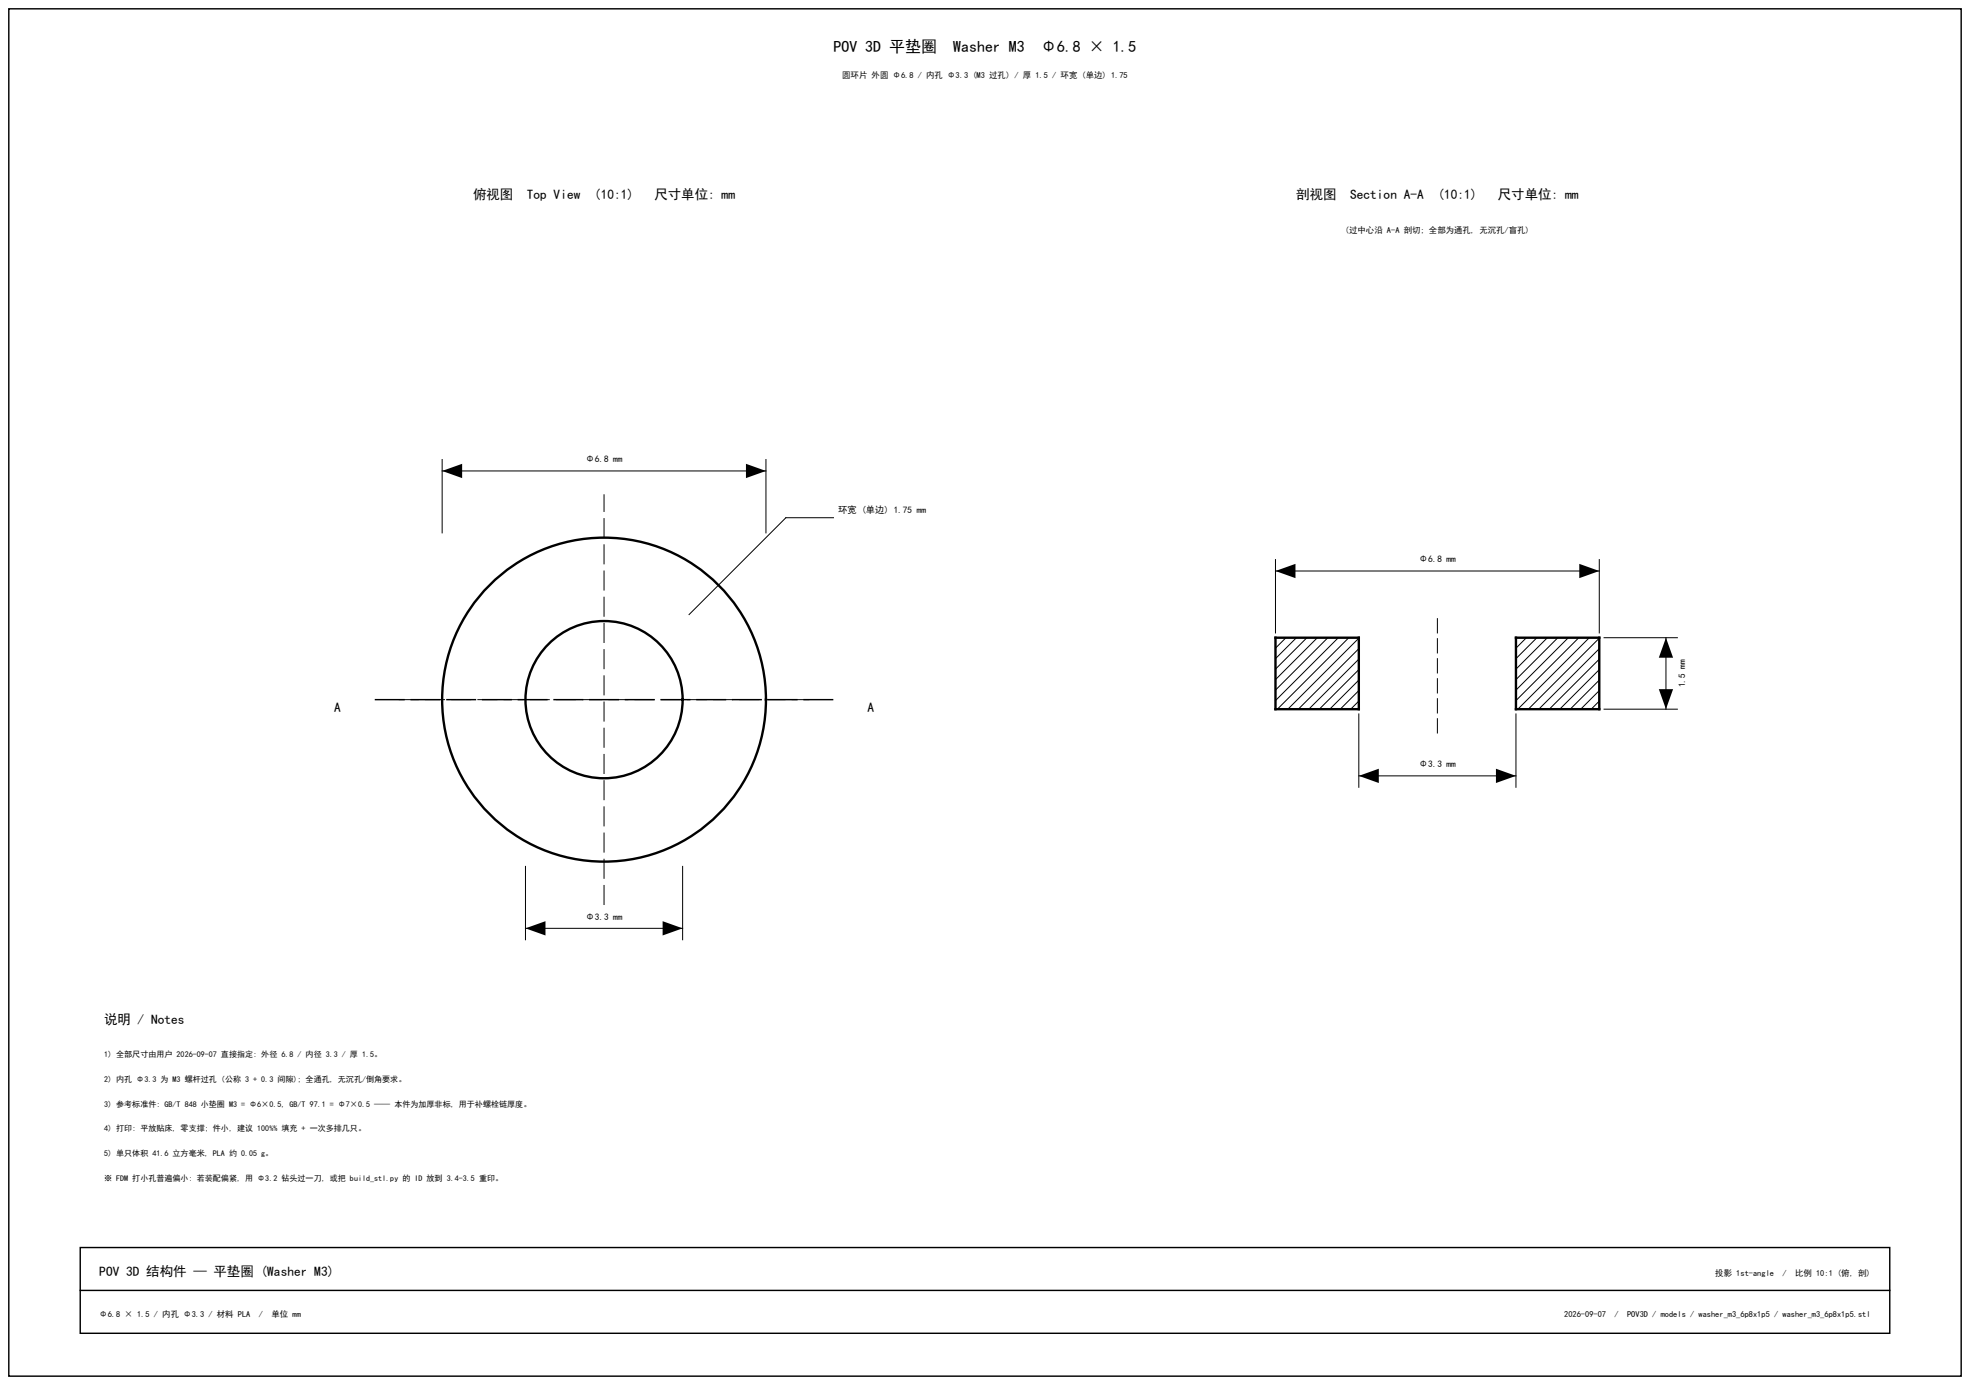
[picture p187: page 1]
剖视图 Section A-A (10:1); 尺寸单位: mm; 说明 / Notes; POV 3D 结构件 — 平垫圈 (Washer M3); 投影 1st-angle / 比例 10:1 (俯, 剖); Φ6.8 × 1.5 / 内孔 Φ3.3 / 材料 PLA / 单位 mm; 2026-09-07 / POV3D / models / washer_m3_6p8x1p5 / washer_m3_6p8x1p5.stl

圆环片 外圆 Φ6.8 / 内孔 Φ3.3 (M3 过孔) / 厚 1.5 / 环宽 (单边) 1.75

(过中心沿 A-A 剖切; 全部为通孔, 无沉孔/盲孔)

1) 全部尺寸由用户 2026-09-07 直接指定: 外径 6.8 / 内径 3.3 / 厚 1.5。

2) 内孔 Φ3.3 为 M3 螺杆过孔 (公称 3 + 0.3 间隙); 全通孔, 无沉孔/倒角要求。

3) 参考标准件: GB/T 848 小垫圈 M3 = Φ6×0.5, GB/T 97.1 = Φ7×0.5 —— 本件为加厚非标, 用于补螺栓链厚度。

4) 打印: 平放贴床, 零支撑; 件小, 建议 100%% 填充 + 一次多排几只。

5) 单只体积 41.6 立方毫米, PLA 约 0.05 g。

※ FDM 打小孔普遍偏小: 若装配偏紧, 用 Φ3.2 钻头过一刀, 或把 build_stl.py 的 ID 放到 3.4-3.5 重印。
