kiujkiu/macha/models/mlkpai_board/mlkpai_board_drawing.pdf

# POV 3D — 米联派 MLKPAI-FS03 ZYNQ 核心板 数字孪生 (买来板 · 参考尺寸图)

## 俯视图 Top (2.3:1) (元件面, 沿 -Z 看)

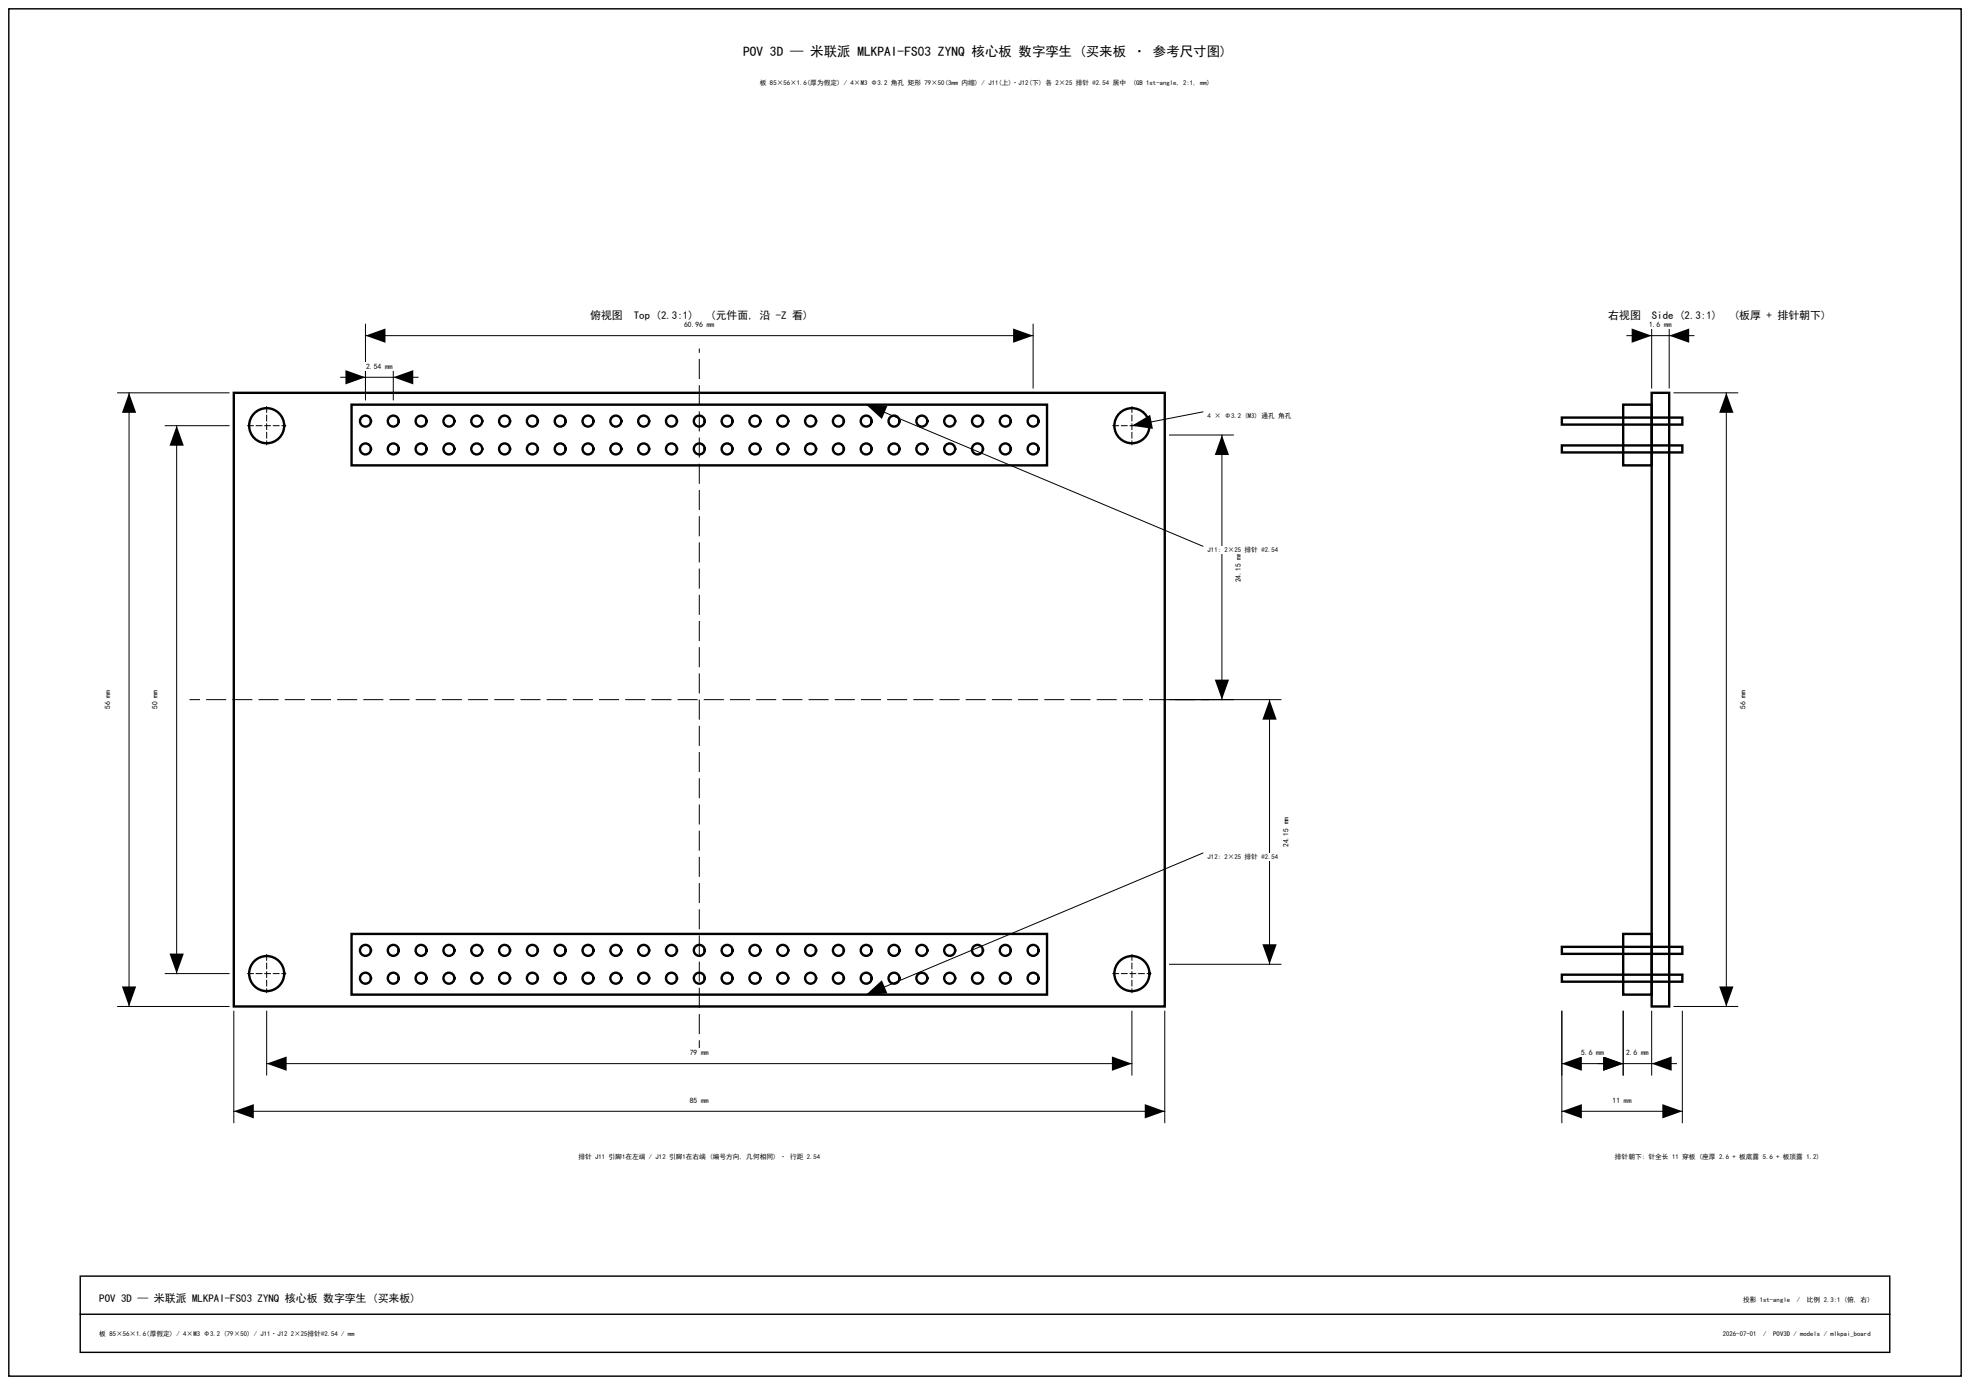
[picture p188: page 1]
右视图 Side (2.3:1); (板厚 + 排针朝下); POV 3D — 米联派 MLKPAI-FS03 ZYNQ 核心板 数字孪生 (买来板); 投影 1st-angle / 比例 2.3:1 (俯, 右); 板 85×56×1.6(厚假定) / 4×M3 Φ3.2 (79×50) / J11·J12 2×25排针@2.54 / mm; 2026-07-01 / POV3D / models / mlkpai_board

板 85×56×1.6(厚为假定) / 4×M3 Φ3.2 角孔 矩形 79×50(3mm 内缩) / J11(上)·J12(下) 各 2×25 排针 @2.54 居中 (GB 1st-angle, 2:1, mm)

排针 J11 引脚1在左端 / J12 引脚1在右端 (编号方向, 几何相同) · 行距 2.54

排针朝下: 针全长 11 穿板 (座厚 2.6 + 板底露 5.6 + 板顶露 1.2)
