kiujkiu/macha/models/rim_top_disc/rim_top_disc_drawing.pdf

# POV 3D rim_top_disc (Φ200 × 6,2 × 加强筋 + 16 × M3 + 2 × 肋孔)

## 俯视图 Top View (1:1) 尺寸单位: mm (沿 -Z 看)

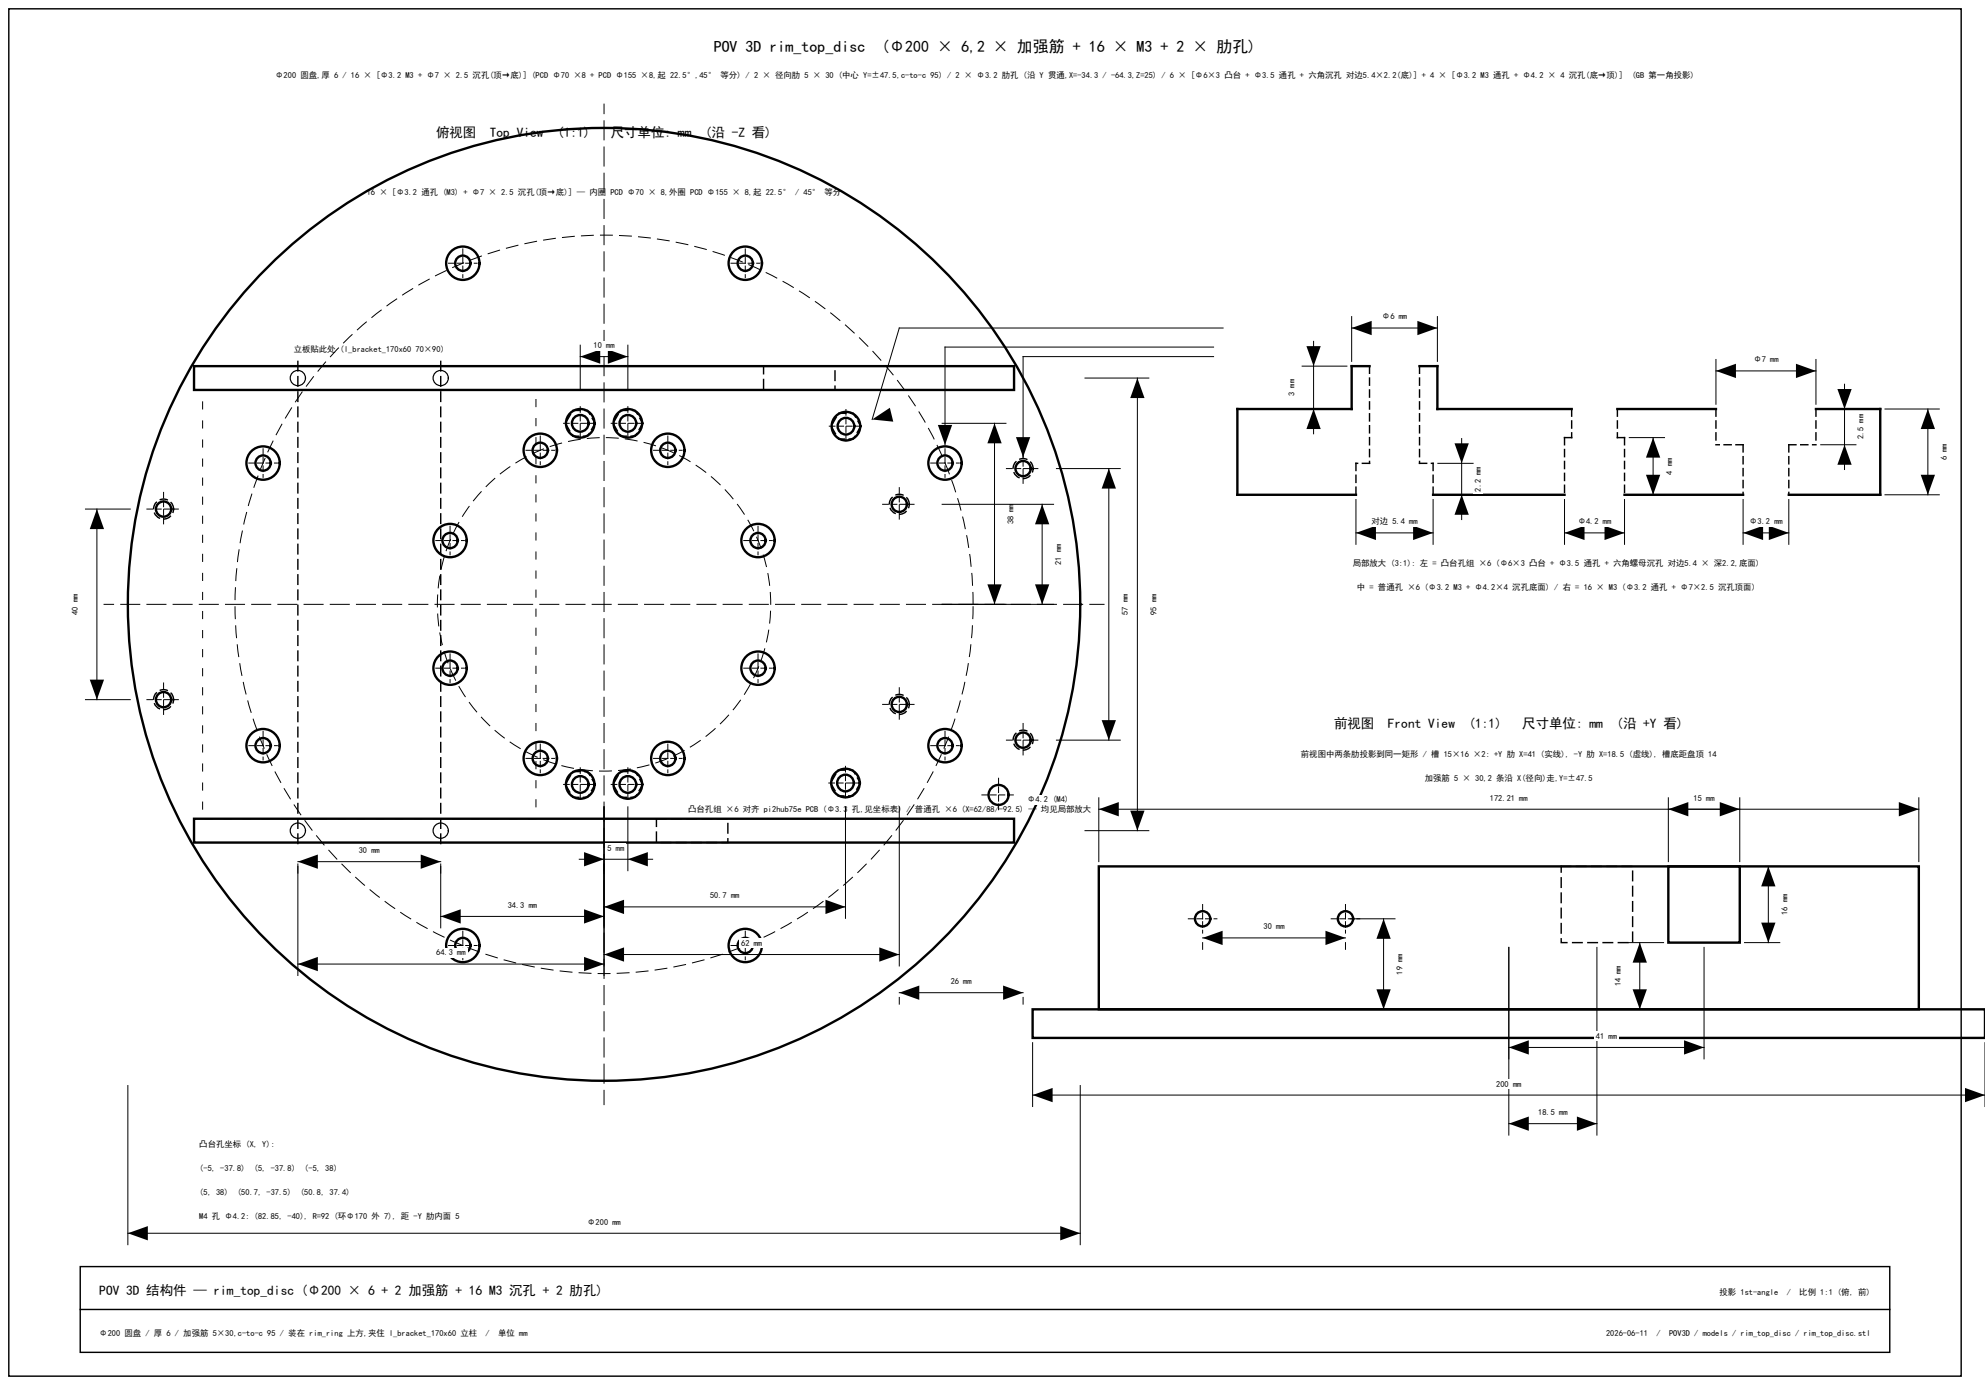
[picture p189: page 1]
立板贴此处 (l_bracket_170x60 70×90); 凸台孔坐标 (X, Y):; M4 孔 Φ4.2: (82.85, -40), R=92 (环Φ170 外 7), 距 -Y 肋内面 5; 前视图 Front View (1:1); 尺寸单位: mm (沿 +Y 看); POV 3D 结构件 — rim_top_disc (Φ200 × 6 + 2 加强筋 + 16 M3 沉孔 + 2 肋孔); 投影 1st-angle / 比例 1:1 (俯, 前); Φ200 圆盘 / 厚 6 / 加强筋 5×30,c-to-c 95 / 装在 rim_ring 上方,夹住 l_bracket_170x60 立柱 / 单位 mm; 2026-06-11 / POV3D / models / rim_top_disc / rim_top_disc.stl

Φ200 圆盘,厚 6 / 16 × [Φ3.2 M3 + Φ7 × 2.5 沉孔(顶→底)] (PCD Φ70 ×8 + PCD Φ155 ×8,起 22.5°,45° 等分) / 2 × 径向肋 5 × 30 (中心 Y=±47.5,c-to-c 95) / 2 × Φ3.2 肋孔 (沿 Y 贯通,X=-34.3 / -64.3,Z=25) / 6 × [Φ6×3 凸台 + Φ3.5 通孔 + 六角沉孔 对边5.4×2.2(底)] + 4 × [Φ3.2 M3 通孔 + Φ4.2 × 4 沉孔(底→顶)] (GB 第一角投影)

16 × [Φ3.2 通孔 (M3) + Φ7 × 2.5 沉孔(顶→底)] — 内圈 PCD Φ70 × 8,外圈 PCD Φ155 × 8,起 22.5° / 45° 等分

局部放大 (3:1): 左 = 凸台孔组 ×6 (Φ6×3 凸台 + Φ3.5 通孔 + 六角螺母沉孔 对边5.4 × 深2.2,底面)

中 = 普通孔 ×6 (Φ3.2 M3 + Φ4.2×4 沉孔底面) / 右 = 16 × M3 (Φ3.2 通孔 + Φ7×2.5 沉孔顶面)

前视图中两条肋投影到同一矩形 / 槽 15×16 ×2: +Y 肋 X=41 (实线), -Y 肋 X=18.5 (虚线), 槽底距盘顶 14

加强筋 5 × 30,2 条沿 X(径向)走,Y=±47.5

凸台孔组 ×6 对齐 pi2hub75e PCB (Φ3.3 孔,见坐标表) / 普通孔 ×6 (X=62/88/-92.5) — 均见局部放大
