kiujkiu/macha/models/top_bearing/top_bearing_cap_drawing.pdf

# POV 3D top_bearing v3.4 — top_cap (旋转盖板, 顶面全平 + M6配重排, PLA)

## 正视 (1:1) (沿 -X 看背板) 尺寸单位: mm

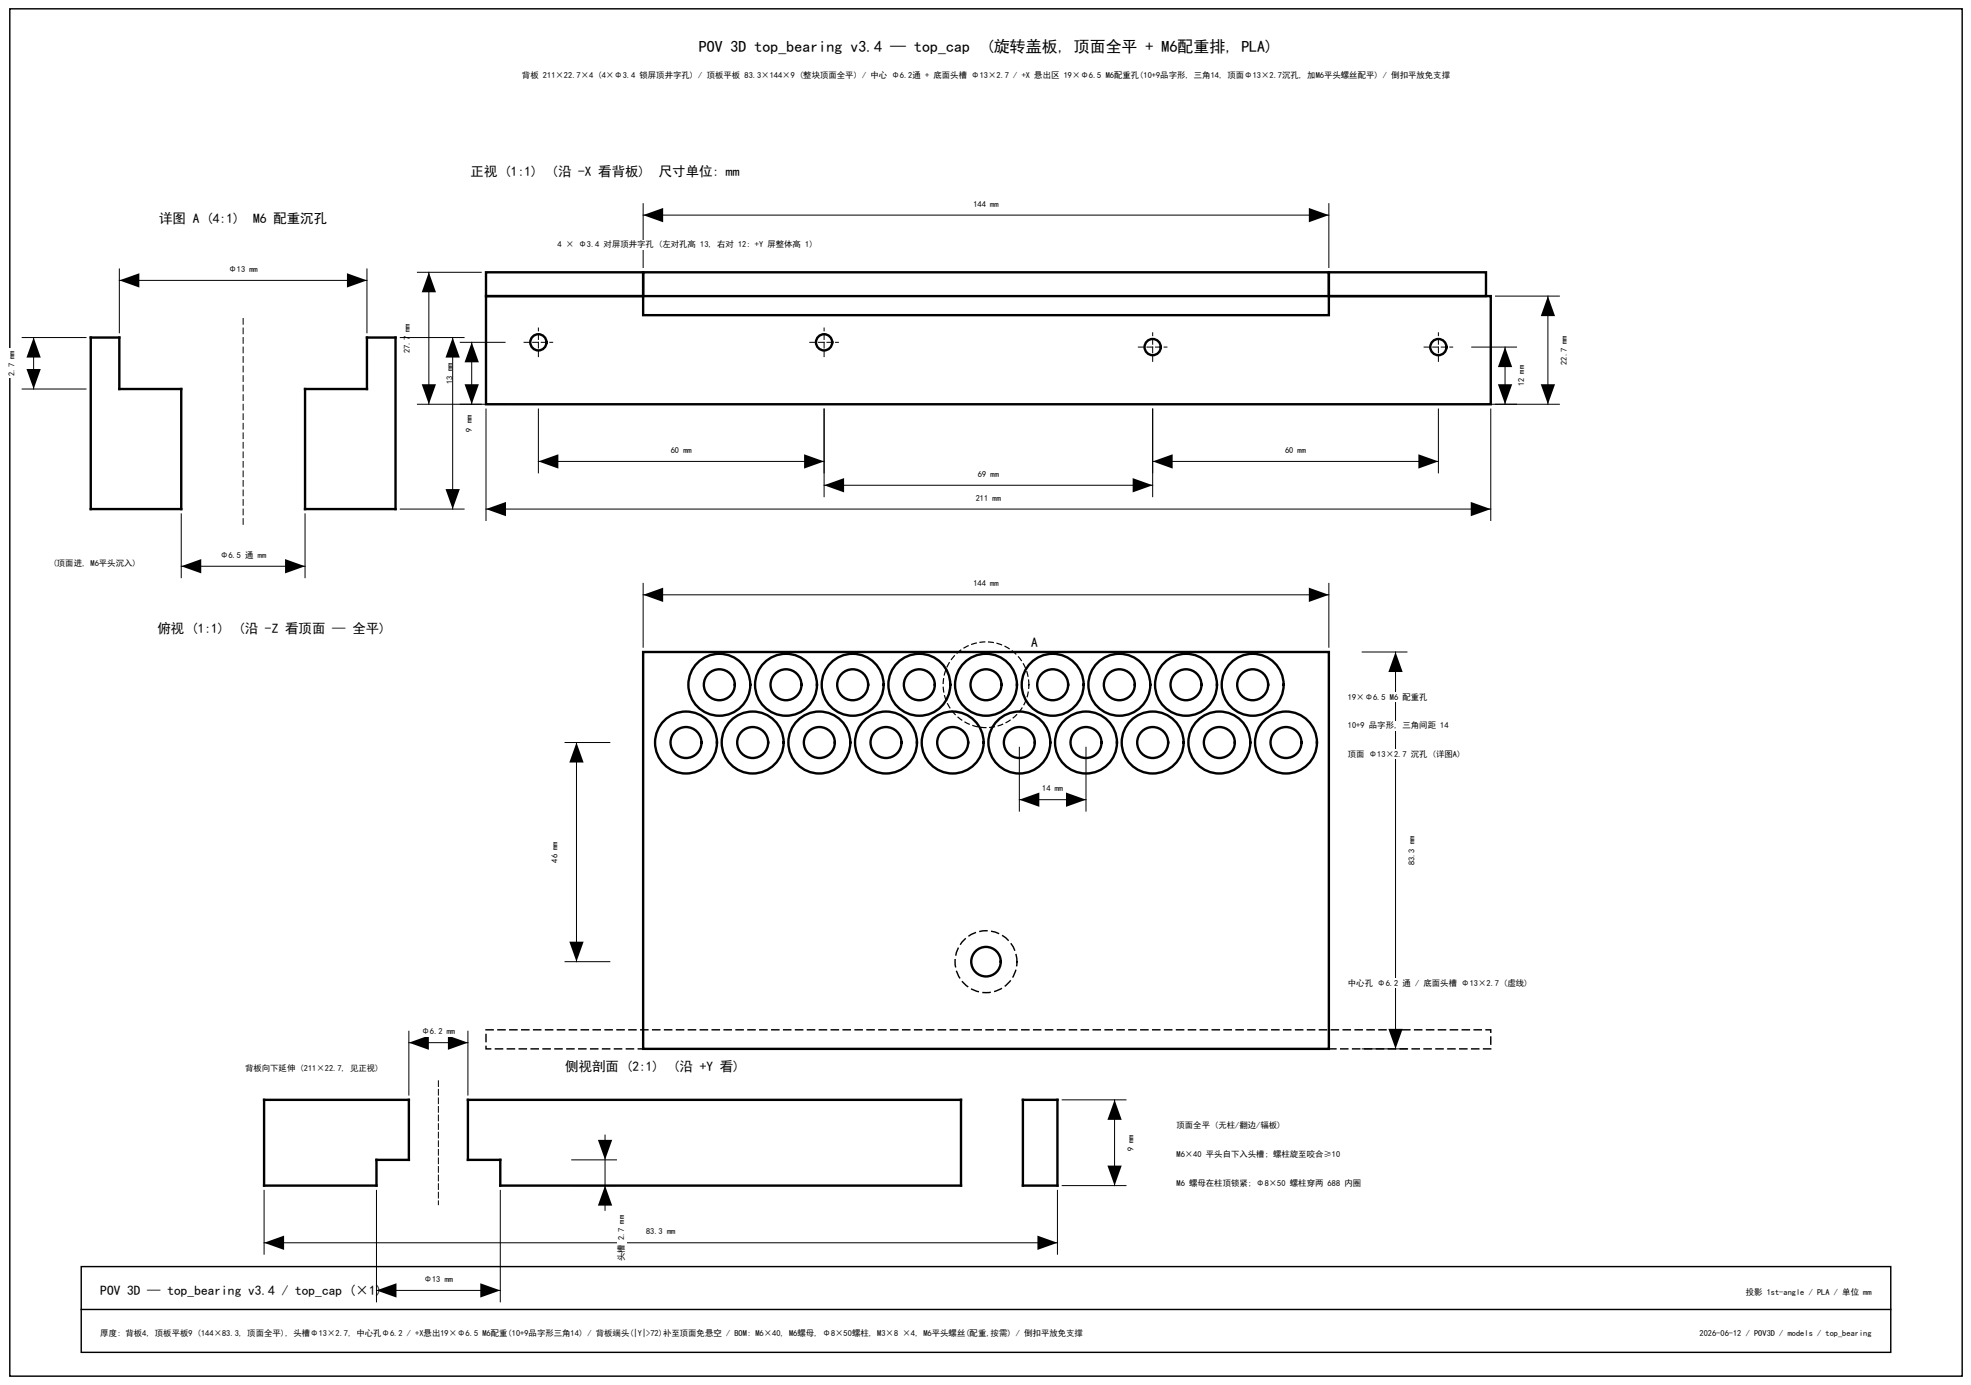
[picture p190: page 1]
19×Φ6.5 M6 配重孔; 10+9 品字形, 三角间距 14; 详图 A (4:1) M6 配重沉孔; (顶面进, M6平头沉入); 侧视剖面 (2:1) (沿 +Y 看); 背板向下延伸 (211×22.7, 见正视); M6×40 平头自下入头槽; 螺柱旋至咬合≥10; POV 3D — top_bearing v3.4 / top_cap (×1); 投影 1st-angle / PLA / 单位 mm; 厚度: 背板4, 顶板平板9 (144×83.3, 顶面全平), 头槽Φ13×2.7, 中心孔Φ6.2 / +X悬出19×Φ6.5 M6配重(10+9品字形三角14) / 背板端头(|Y|>72)补至顶面免悬空 / BOM: M6×40, M6螺母, Φ8×50螺柱, M3×8 ×4, M6平头螺丝(配重,按需) / 倒扣平放免支撑; 2026-06-12 / POV3D / models / top_bearing

背板 211×22.7×4 (4×Φ3.4 锁屏顶井字孔) / 顶板平板 83.3×144×9 (整块顶面全平) / 中心 Φ6.2通 + 底面头槽 Φ13×2.7 / +X 悬出区 19×Φ6.5 M6配重孔(10+9品字形, 三角14, 顶面Φ13×2.7沉孔, 加M6平头螺丝配平) / 倒扣平放免支撑

4 × Φ3.4 对屏顶井字孔 (左对孔高 13, 右对 12: +Y 屏整体高 1)

俯视 (1:1) (沿 -Z 看顶面 — 全平)

顶面 Φ13×2.7 沉孔 (详图A)

中心孔 Φ6.2 通 / 底面头槽 Φ13×2.7 (虚线)

顶面全平 (无柱/翻边/辐板)

M6 螺母在柱顶锁紧; Φ8×50 螺柱穿两 688 内圈
