kiujkiu/macha/models/zynq_board/zynq_board_drawing.pdf

# POV 3D — ZYNQ7010/7020 板 (鹿小班, 买来现成板 / 非打印 / 接口参考)

## 俯视 (2.5:1) (沿 +Z 看元件面) 尺寸单位: mm

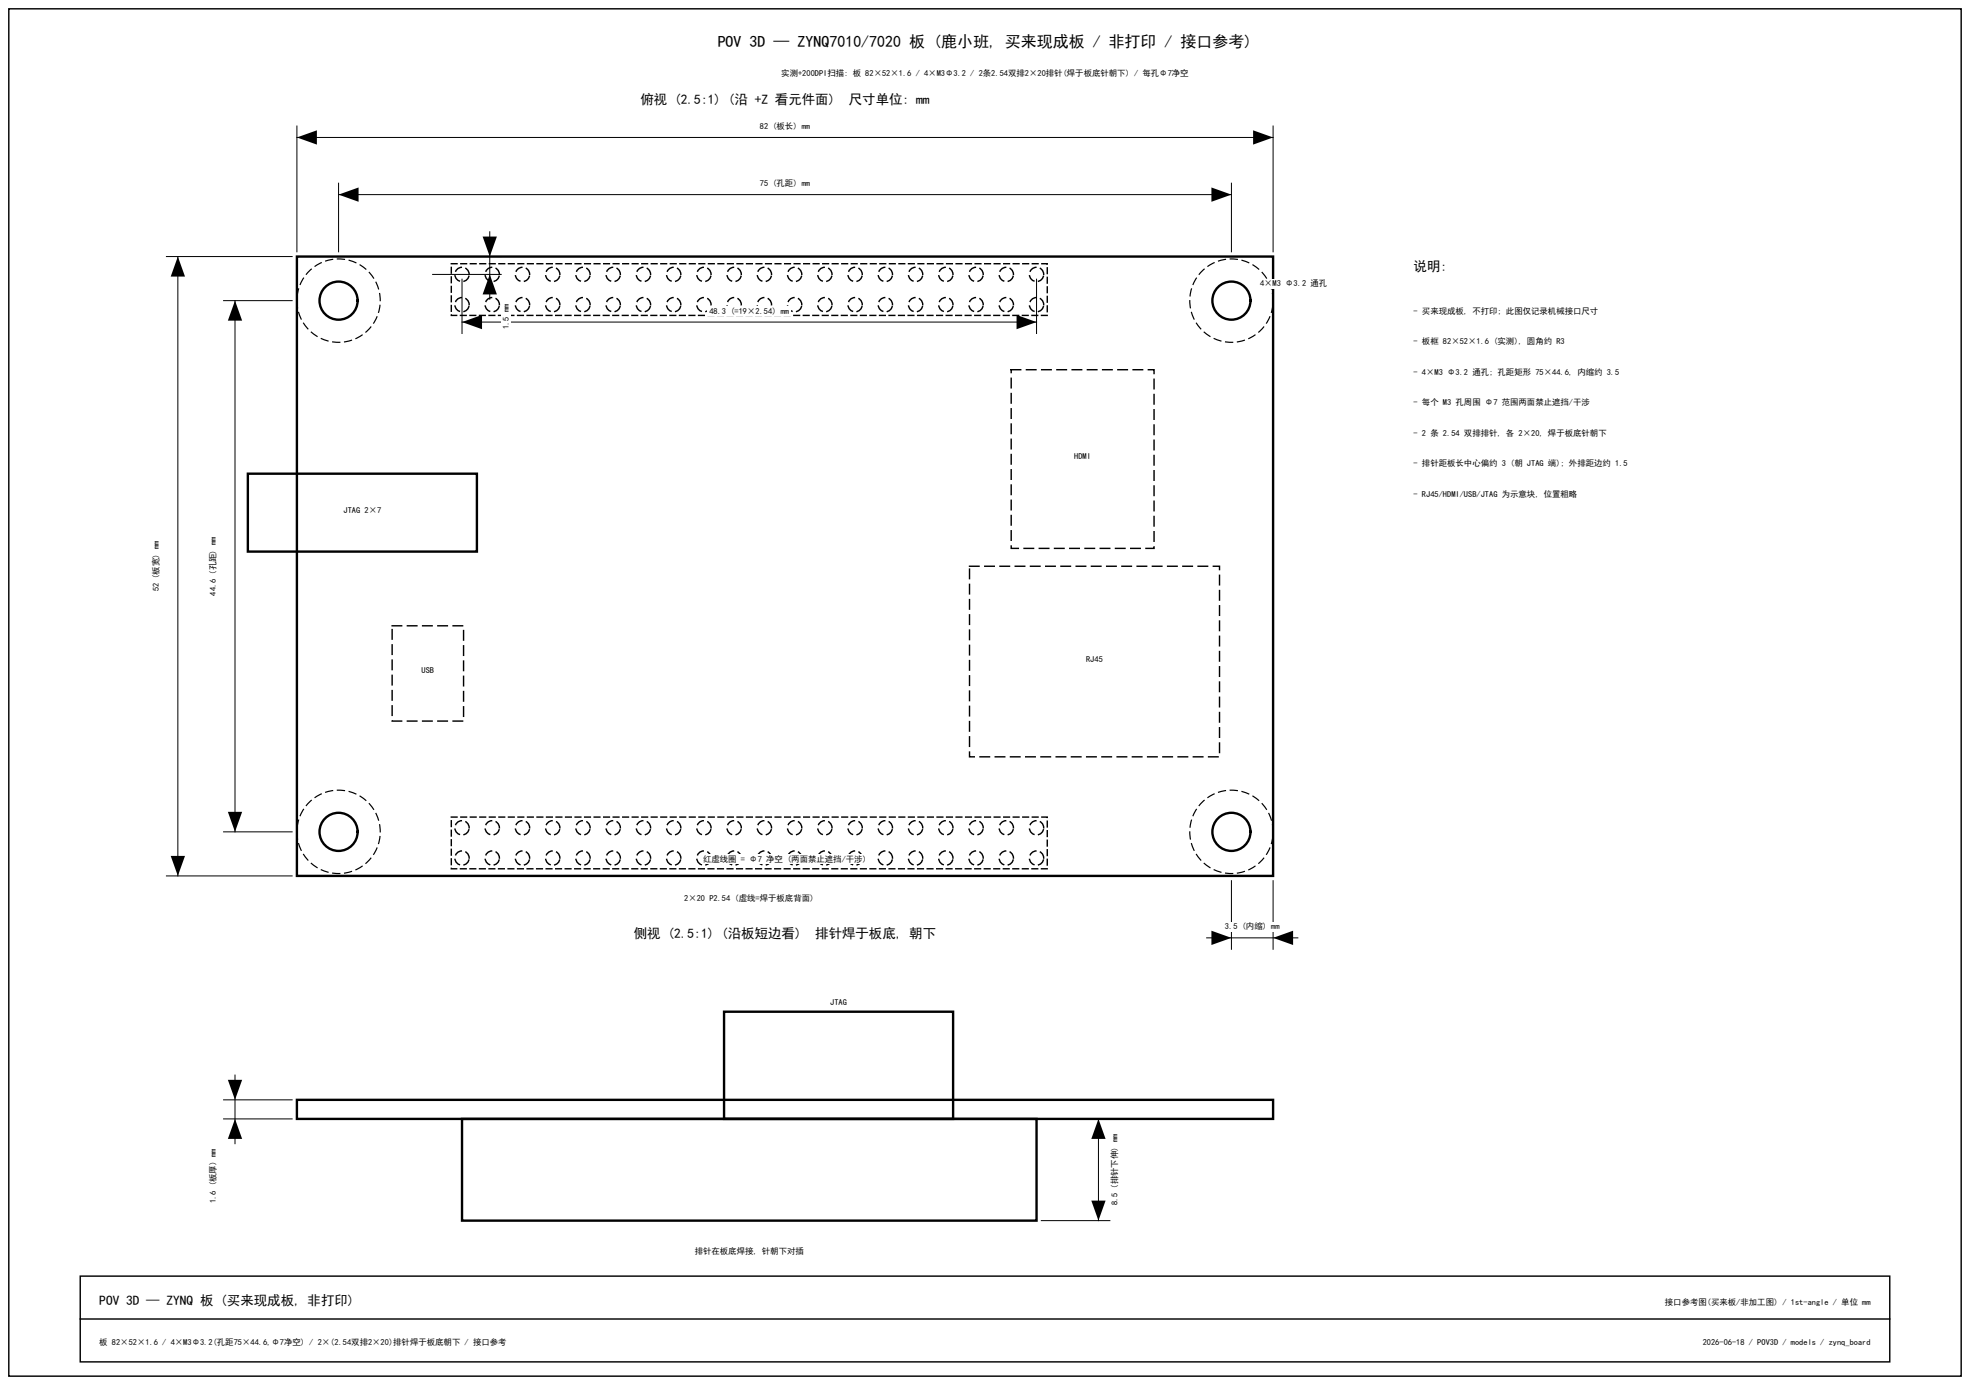
[picture p191: page 1]
实测+200DPI扫描: 板 82×52×1.6 / 4×M3Φ3.2 / 2条2.54双排2×20排针(焊于板底针朝下) / 每孔Φ7净空; JTAG 2×7; HDMI; USB; 2×20 P2.54 (虚线=焊于板底背面); JTAG; 8.5 (排针下伸) mm; 排针在板底焊接, 针朝下对插; - 2 条 2.54 双排排针, 各 2×20, 焊于板底针朝下; POV 3D — ZYNQ 板 (买来现成板, 非打印); 接口参考图(买来板/非加工图) / 1st-angle / 单位 mm; 板 82×52×1.6 / 4×M3Φ3.2(孔距75×44.6,Φ7净空) / 2×(2.54双排2×20)排针焊于板底朝下 / 接口参考; 2026-06-18 / POV3D / models / zynq_board

- 买来现成板, 不打印; 此图仅记录机械接口尺寸

- 板框 82×52×1.6 (实测), 圆角约 R3

- 4×M3 Φ3.2 通孔; 孔距矩形 75×44.6, 内缩约 3.5

- 每个 M3 孔周围 Φ7 范围两面禁止遮挡/干涉

- 排针距板长中心偏约 3 (朝 JTAG 端); 外排距边约 1.5

- RJ45/HDMI/USB/JTAG 为示意块, 位置粗略

红虚线圈 = Φ7 净空 (两面禁止遮挡/干涉)

侧视 (2.5:1) (沿板短边看) 排针焊于板底, 朝下
