kiujkiu/macha/v1.2/assembly_v1_2_不装玻璃_装配图.pdf

# 主视图 (从 +Y 看 LED 面)

# 剖视 A-A (X=0 平面, 从 +X 看; 浅色 = 剖面后的半边)

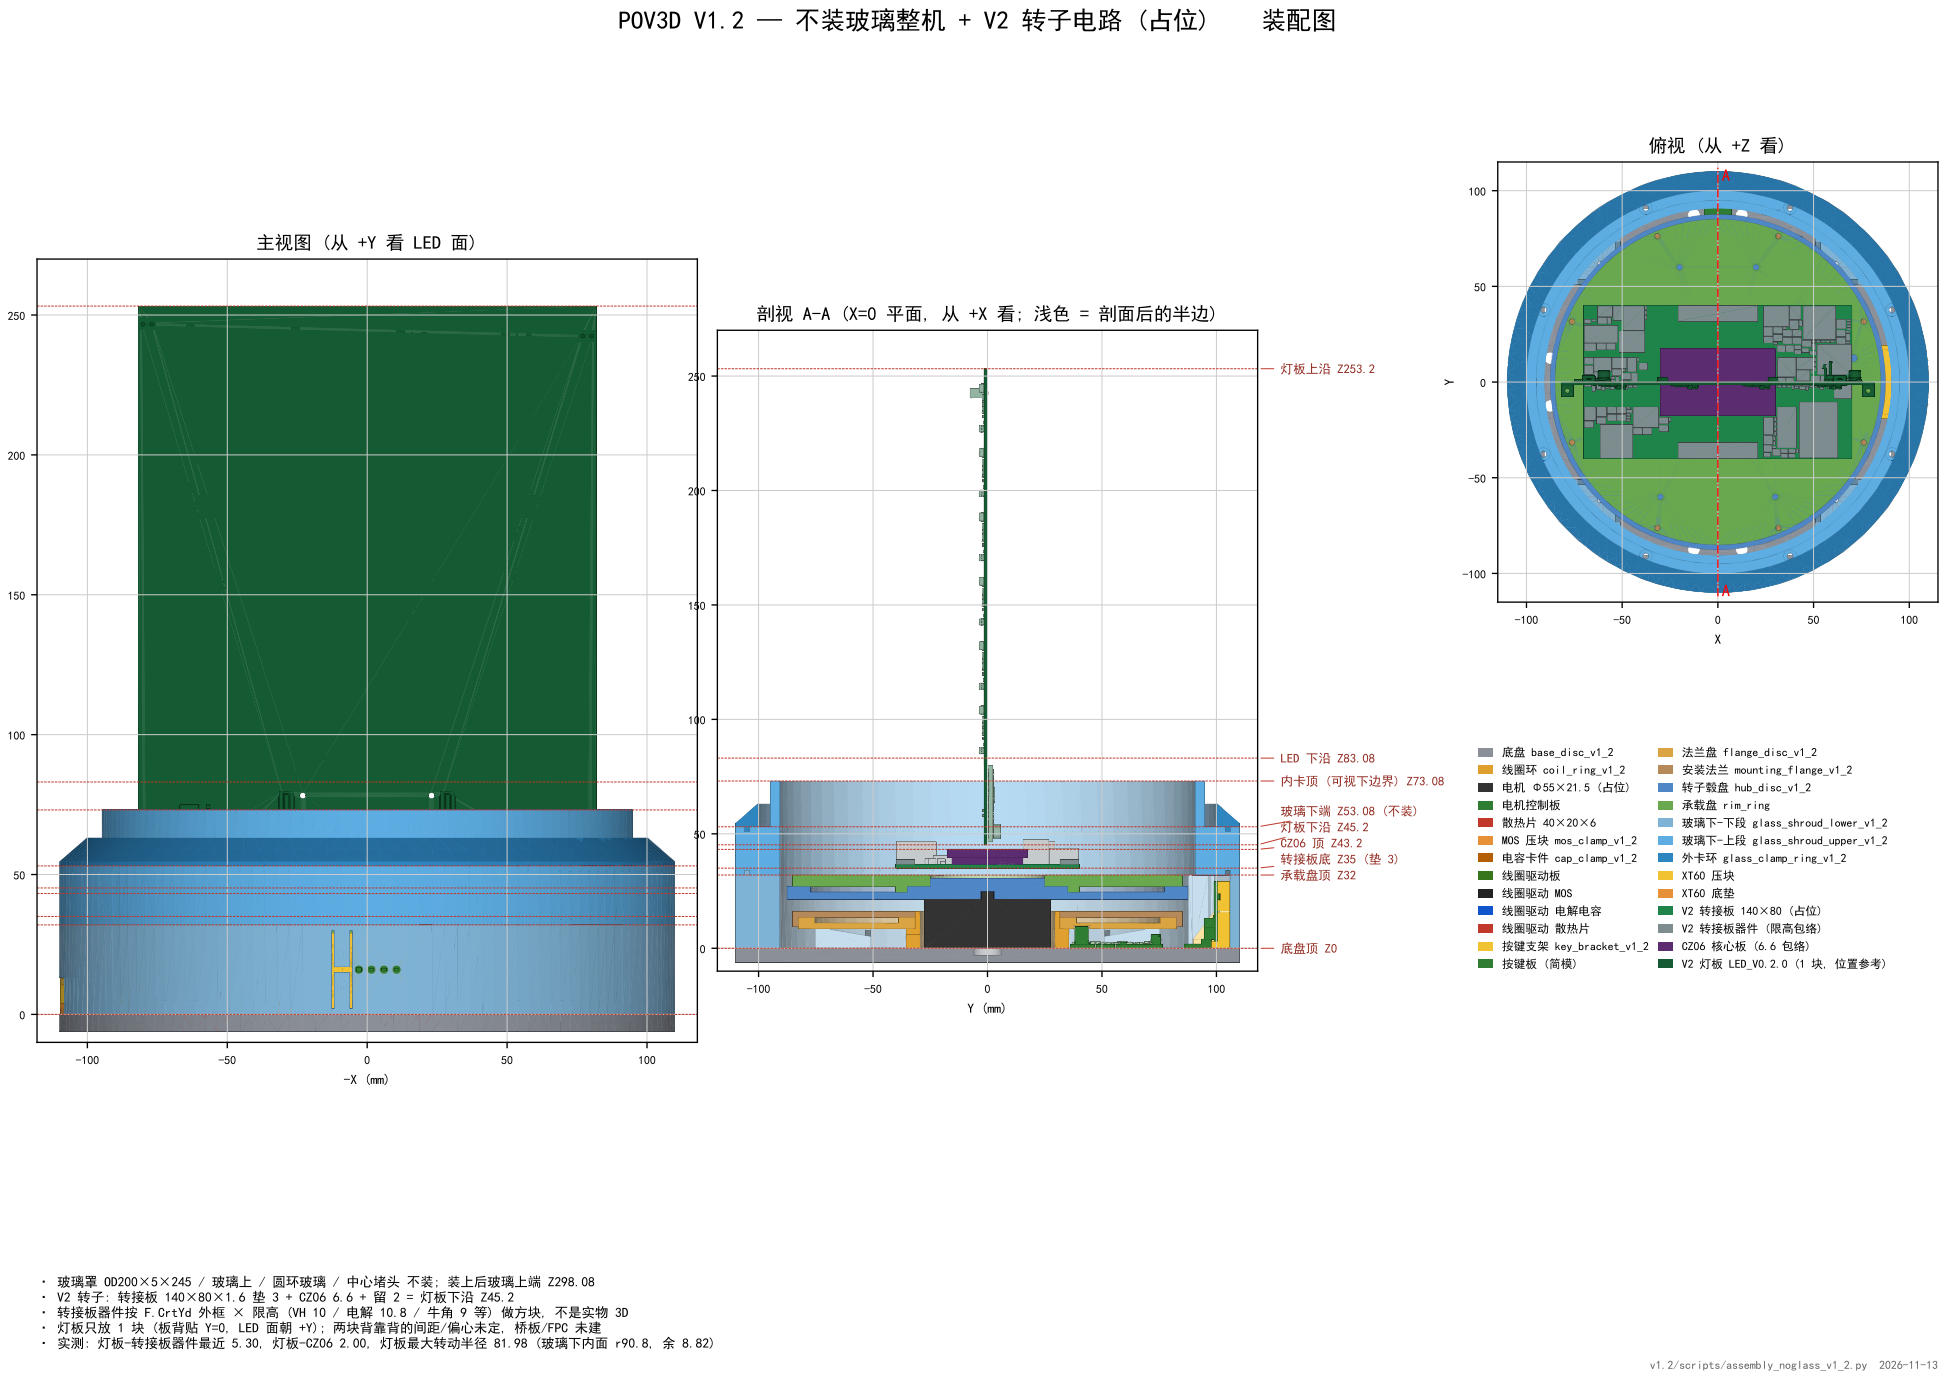
[picture p192: page 1]
底盘顶 Z0; 承载盘顶 Z32; 转接板底 Z35 (垫 3); 灯板下沿 Z45.2; 玻璃下端 Z53.08 (不装); 内卡顶 (可视下边界) Z73.08; LED 下沿 Z83.08; 灯板上沿 Z253.2; POV3D V1.2 — 不装玻璃整机 + V2 转子电路 (占位); 装配图; v1.2/scripts/assembly_noglass_v1_2.py; 底盘 base_disc_v1_2; 线圈环 coil_ring_v1_2; 电机控制板; 散热片 40×20×6; MOS 压块 mos_clamp_v1_2; 电容卡件 cap_clamp_v1_2; 线圈驱动板; 线圈驱动 MOS; 线圈驱动 电解电容; 线圈驱动 散热片; 按键支架 key_bracket_v1_2; 按键板 (简模); 法兰盘 flange_disc_v1_2; 安装法兰 mounting_flange_v1_2; 转子毂盘 hub_disc_v1_2; 承载盘 rim_ring; 玻璃下-下段 glass_shroud_lower_v1_2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

· 玻璃罩 OD200×5×245 / 玻璃上 / 圆环玻璃 / 中心堵头 不装; 装上后玻璃上端 Z298.08
· V2 转子: 转接板 140×80×1.6 垫 3 + CZ06 6.6 + 留 2 = 灯板下沿 Z45.2
· 转接板器件按 F.CrtYd 外框 × 限高 (VH 10 / 电解 10.8 / 牛角 9 等) 做方块, 不是实物 3D
· 灯板只放 1 块 (板背贴 Y=0, LED 面朝 +Y); 两块背靠背的间距/偏心未定, 桥板/FPC 未建
· 实测: 灯板-转接板器件最近 5.30, 灯板-CZ06 2.00, 灯板最大转动半径 81.98 (玻璃下内面 r90.8, 余 8.82)
