kiujkiu/macha/v3.1/print/top_bearing_frame_v4/frame_B_v4_drawing.pdf

# POV 3D v4 — frame_B_v4 顶轴承架 B (上层架, ×1)

## 主视图 (从 -Y 视向, 2:1)

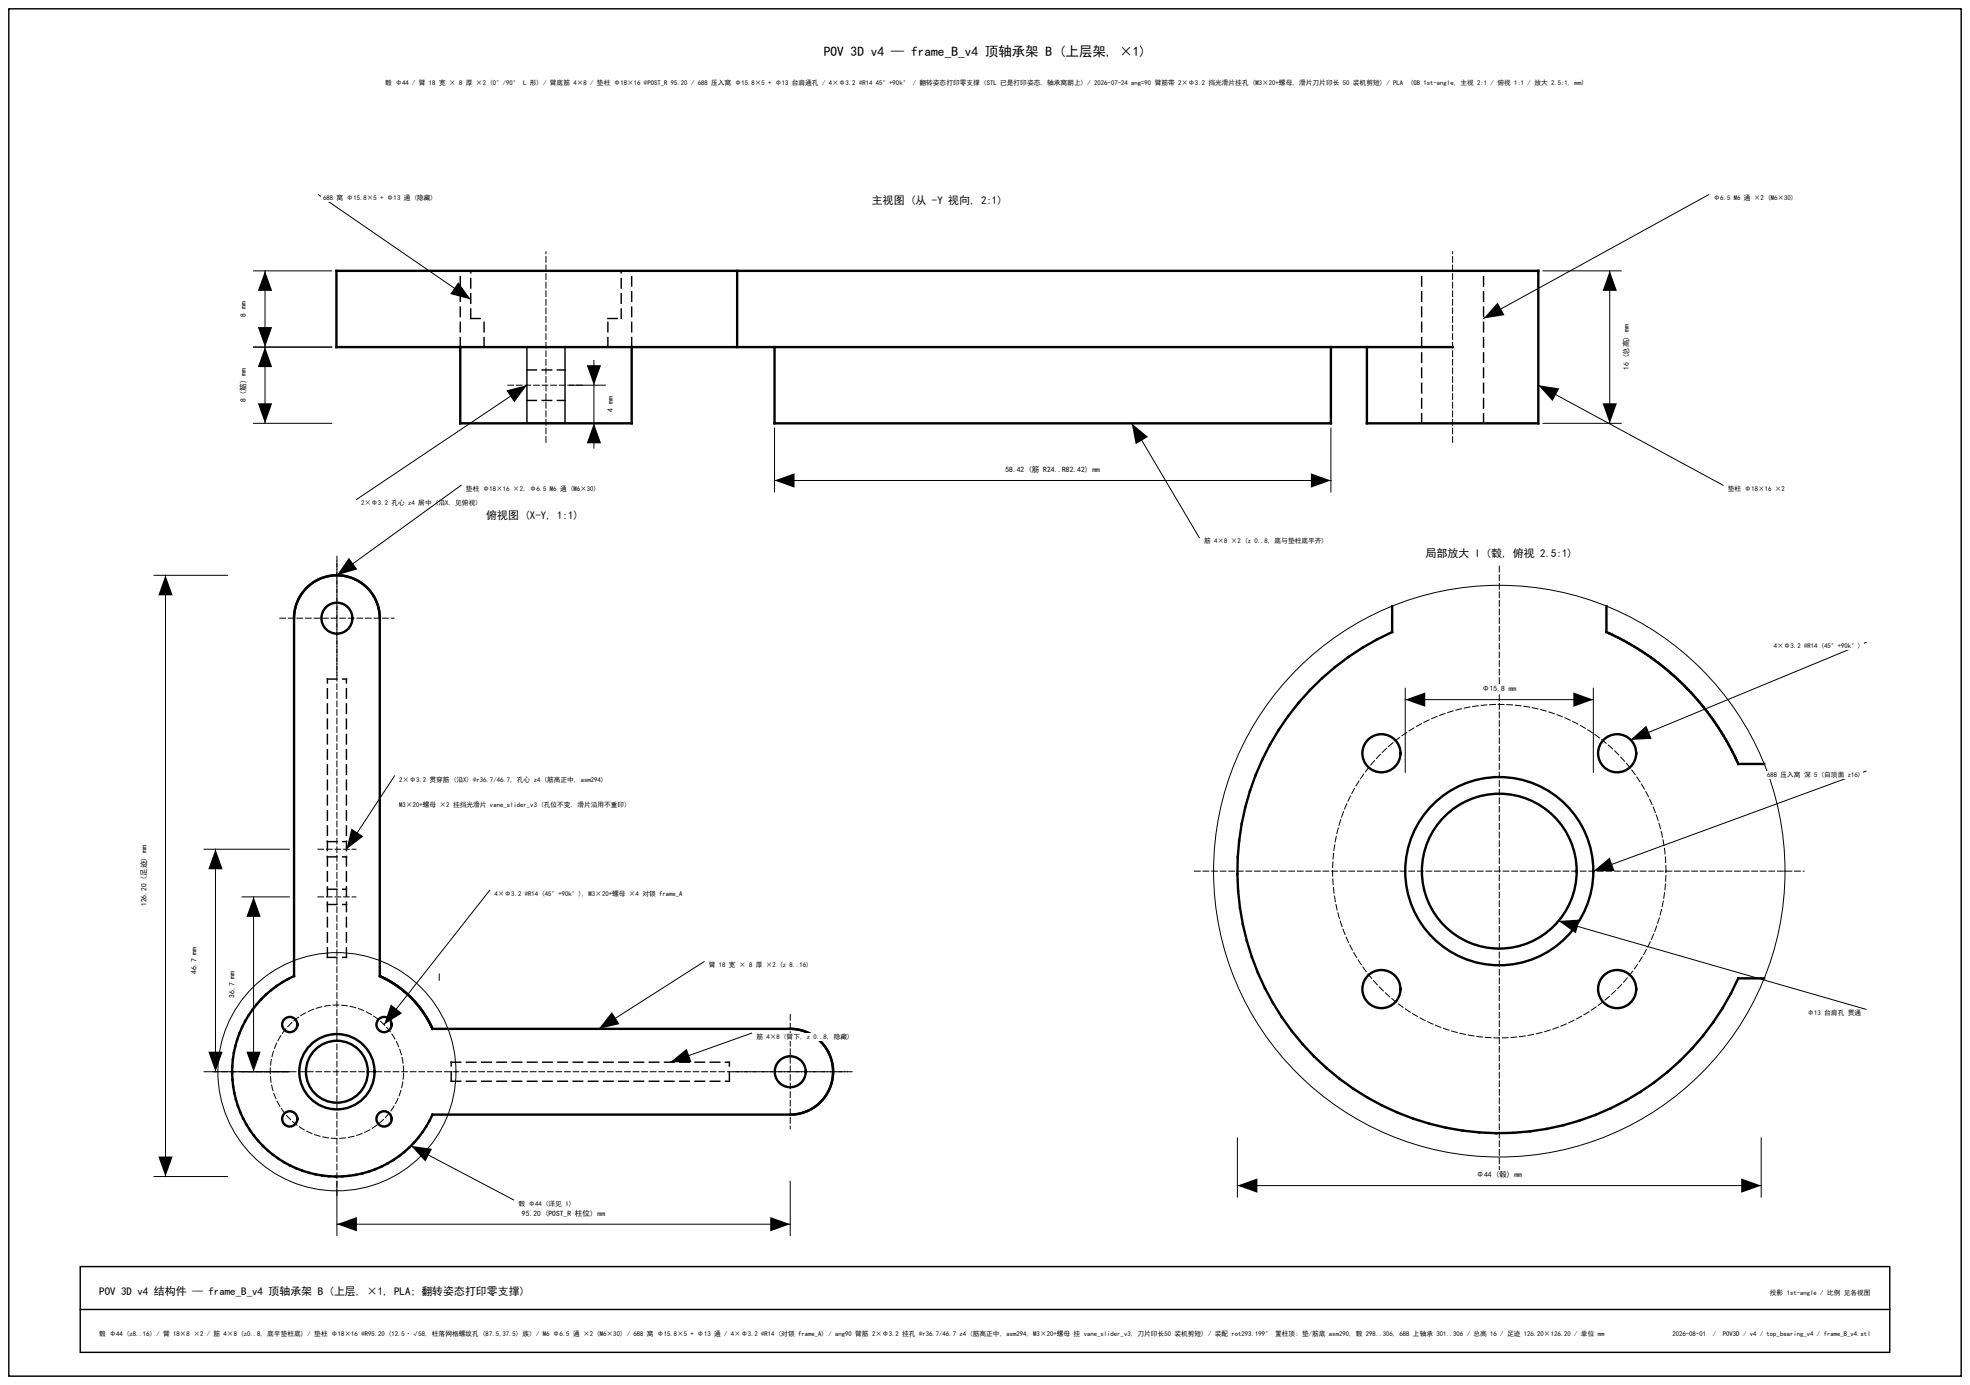
[picture p193: page 1]
筋 4×8 ×2 (z 0..8, 底与垫柱底平齐); 俯视图 (X-Y, 1:1); 95.20 (POST_R 柱位) mm; 4×Φ3.2 @R14 (45°+90k°), M3×20+螺母 ×4 对锁 frame_A; 局部放大 I (毂, 俯视 2.5:1); 688 压入窝 深 5 (自顶面 z16); Φ13 台肩孔 贯通; POV 3D v4 结构件 — frame_B_v4 顶轴承架 B (上层, ×1, PLA; 翻转姿态打印零支撑); 投影 1st-angle / 比例 见各视图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

毂 Φ44 / 臂 18 宽 × 8 厚 ×2 (0°/90° L 形) / 臂底筋 4×8 / 垫柱 Φ18×16 @POST_R 95.20 / 688 压入窝 Φ15.8×5 + Φ13 台肩通孔 / 4×Φ3.2 @R14 45°+90k° / 翻转姿态打印零支撑 (STL 已是打印姿态, 轴承窝朝上) / 2026-07-24 ang=90 臂筋带 2×Φ3.2 挡光滑片挂孔 (M3×20+螺母, 滑片刀片印长 50 装机剪短) / PLA (GB 1st-angle, 主视 2:1 / 俯视 1:1 / 放大 2.5:1, mm)

2×Φ3.2 孔心 z4 居中 (沿X, 见俯视)

2×Φ3.2 贯穿筋 (沿X) @r36.7/46.7, 孔心 z4 (筋高正中, asm294)

M3×20+螺母 ×2 挂挡光滑片 vane_slider_v3 (孔位不变, 滑片沿用不重印)

I ¹²⁶.20 (足迹⁾ mm
