kiujkiu/macha/v0.2/print/rim_ring/rim_ring_drawing.pdf

# POV 3D — rim_ring 外圈托盘环 v3 (承载盘并入 + 内凸台环)

## 俯视图 (1:1) — 从零件系 +Z (唇侧) 看 尺寸单位: mm

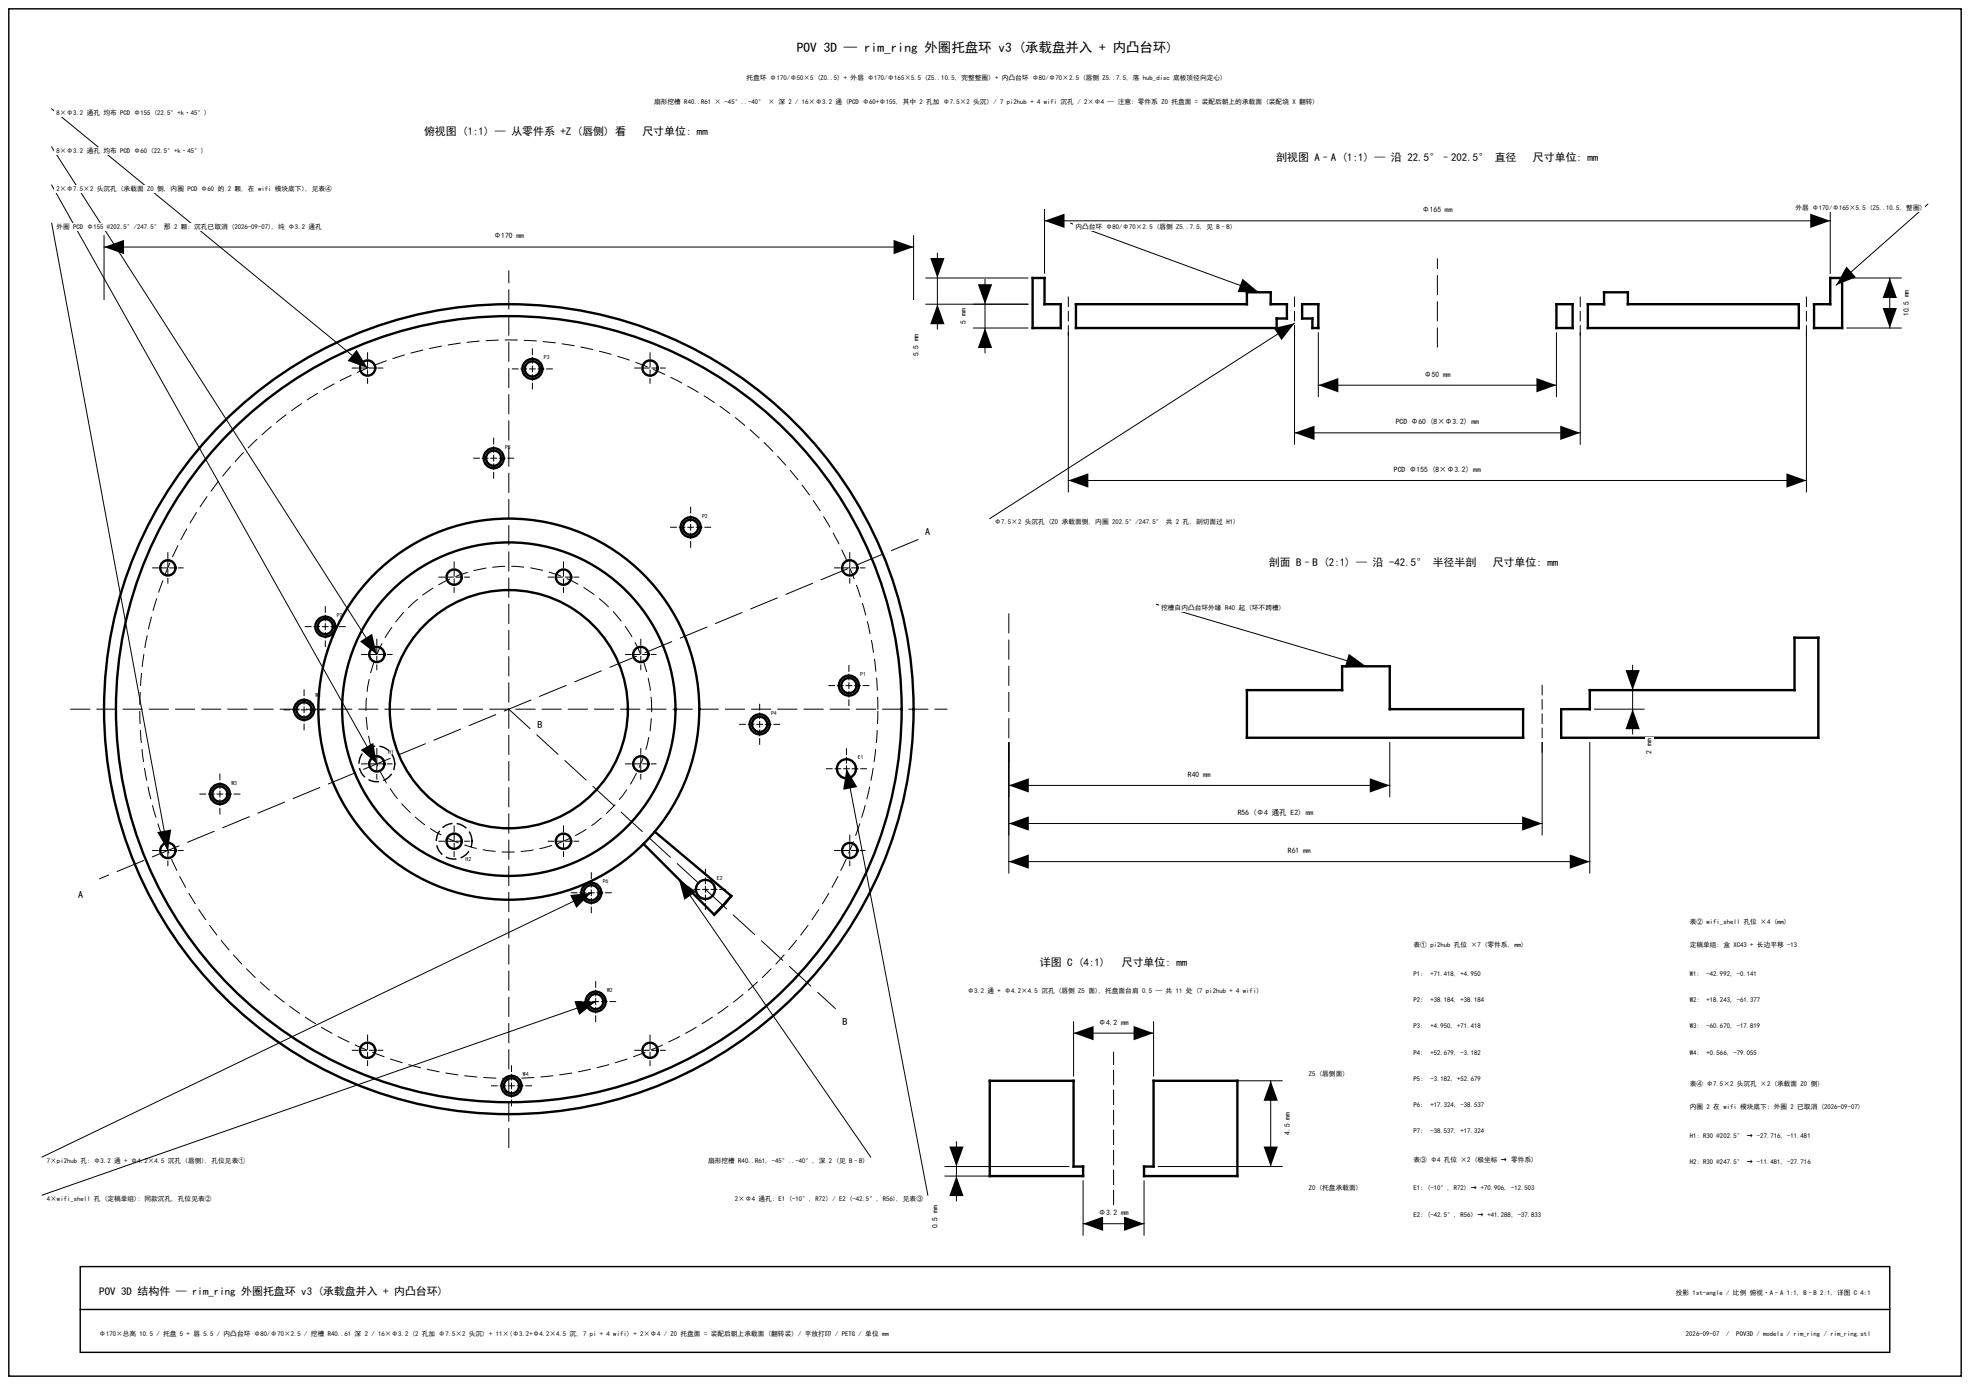
[picture p194: page 1]

托盘环 Φ170/Φ50×5 (Z0..5) + 外唇 Φ170/Φ165×5.5 (Z5..10.5, 完整整圈) + 内凸台环 Φ80/Φ70×2.5 (唇侧 Z5..7.5, 落 hub_disc 底板顶径向定心)

扇形挖槽 R40..R61 × -45°..-40° × 深 2 / 16×Φ3.2 通 (PCD Φ60+Φ155, 其中 2 孔加 Φ7.5×2 头沉) / 7 pi2hub + 4 wifi 沉孔 / 2×Φ4 — 注意: 零件系 Z0 托盘面 = 装配后朝上的承载面 (装配绕 X 翻转)

2×Φ7.5×2 头沉孔 (承载面 Z0 侧, 内圈 PCD Φ60 的 2 颗, 在 wifi 模块底下), 见表④

外圈 PCD Φ155 @202.5°/247.5° 那 2 颗: 沉孔已取消 (2026-09-07), 纯 Φ3.2 通孔

Φ7.5×2 头沉孔 (Z0 承载面侧, 内圈 202.5°/247.5° 共 2 孔, 剖切面过 H1)

表① pi2hub 孔位 ×7 (零件系, mm)

Φ3.2 通 + Φ4.2×4.5 沉孔 (唇侧 Z5 面), 托盘面台肩 0.5 — 共 11 处 (7 pi2hub + 4 wifi)

内圈 2 在 wifi 模块底下; 外圈 2 已取消 (2026-09-07)

表③ Φ4 孔位 ×2 (极坐标 → 零件系)
