kiujkiu/macha/v2/print/mlkpai_carrier_disc/mlkpai_carrier_disc_drawing.pdf

# POV 3D v2 — mlkpai_carrier_disc 转子承载盘 (Φ170×5, 2026-07-06 定型)

## 俯视图 (1:1)

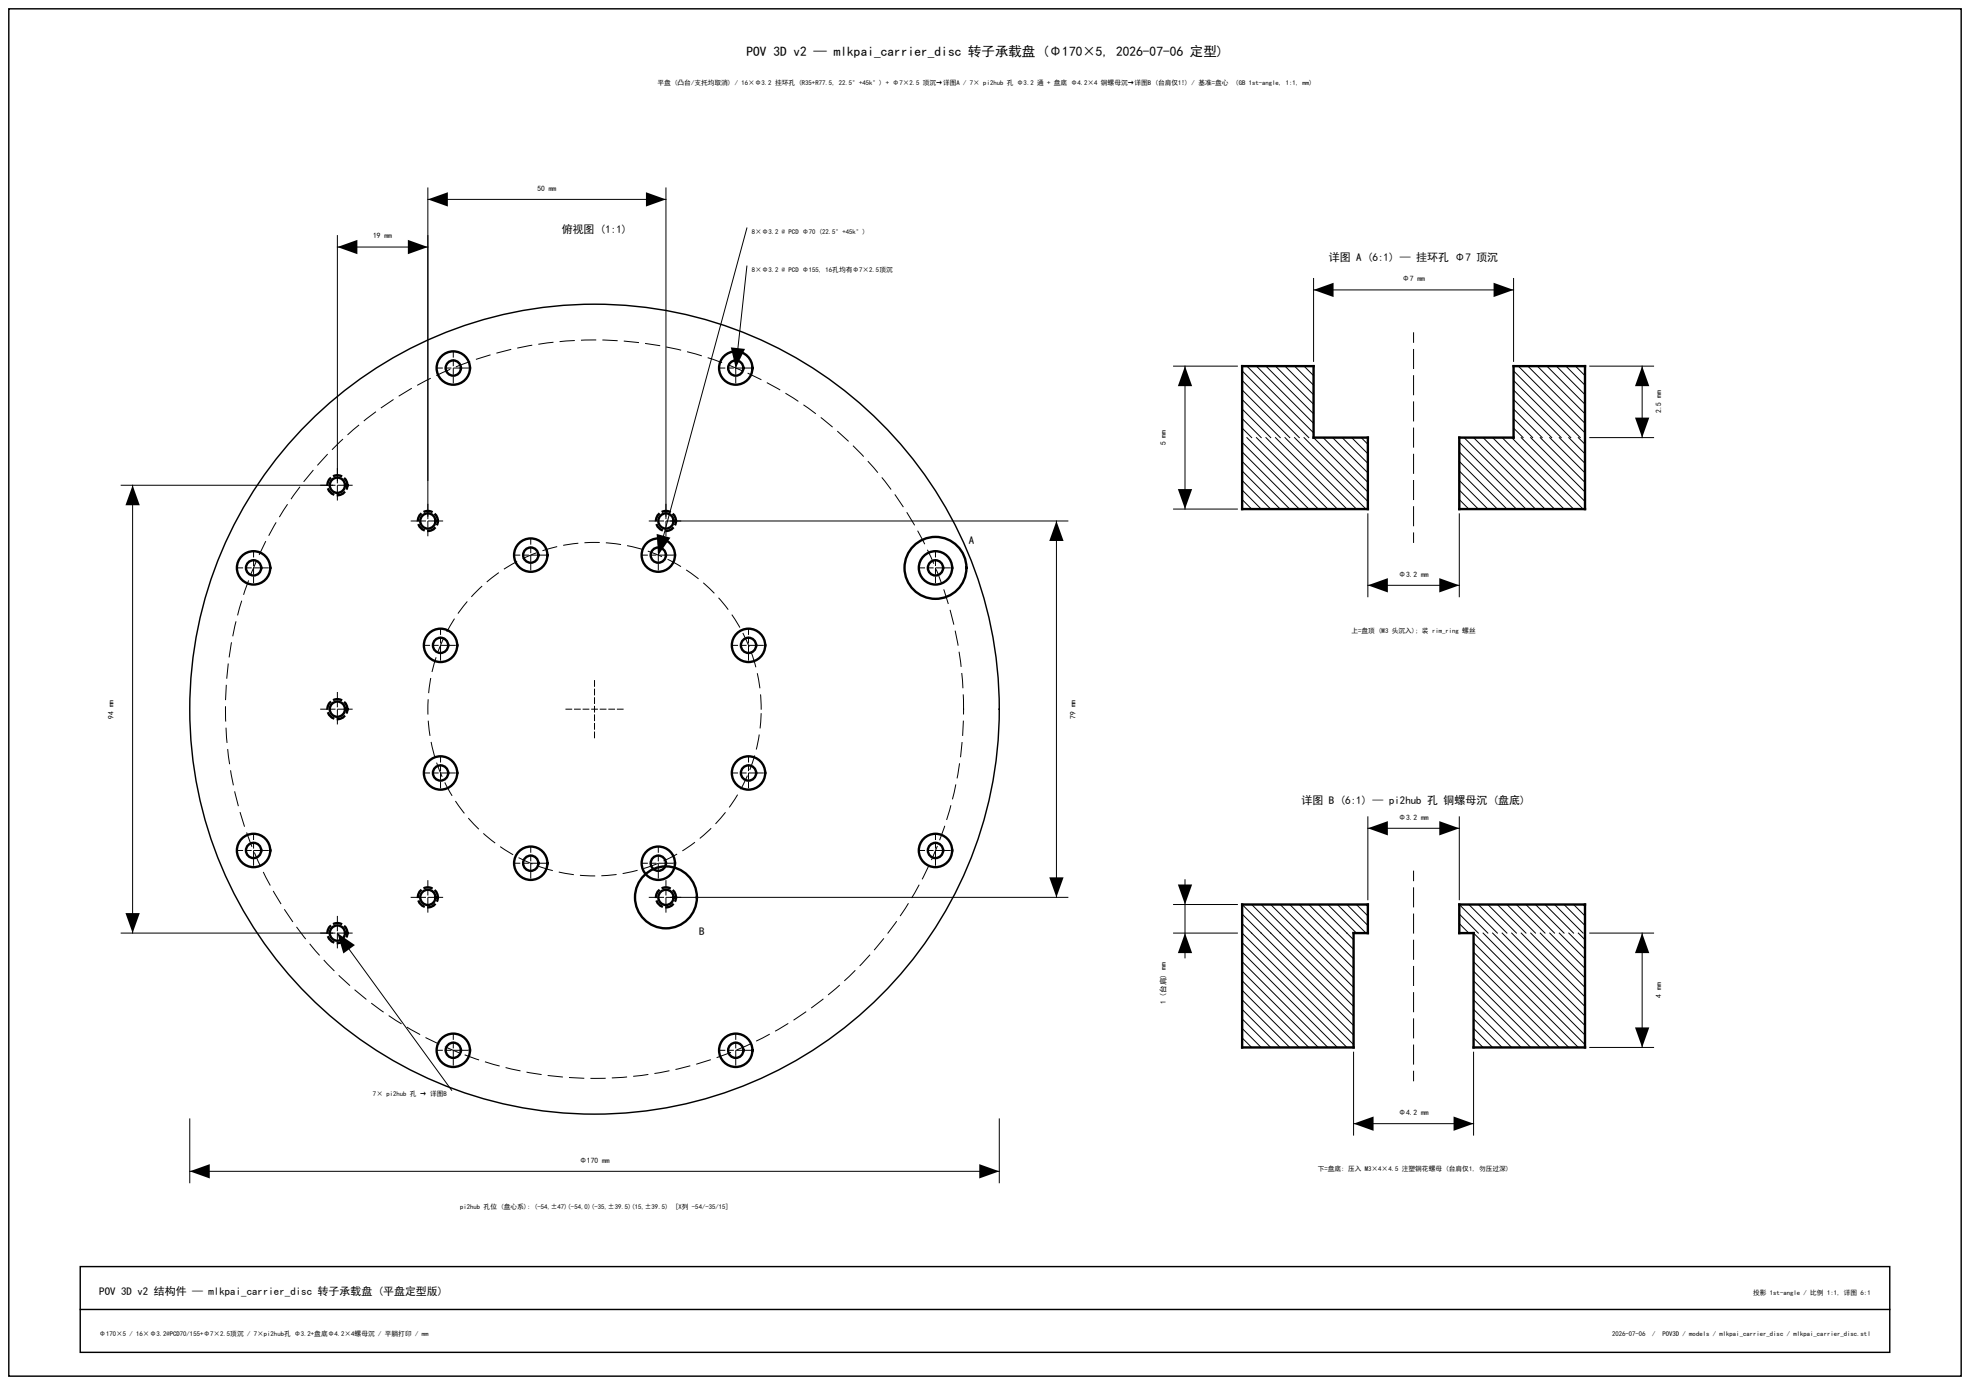
[picture p195: page 1]
8×Φ3.2 @ PCD Φ70 (22.5°+45k°); 8×Φ3.2 @ PCD Φ155, 16孔均有Φ7×2.5顶沉; 7× pi2hub 孔 → 详图B; POV 3D v2 结构件 — mlkpai_carrier_disc 转子承载盘 (平盘定型版); 投影 1st-angle / 比例 1:1, 详图 6:1; Φ170×5 / 16×Φ3.2@PCD70/155+Φ7×2.5顶沉 / 7×pi2hub孔 Φ3.2+盘底Φ4.2×4螺母沉 / 平躺打印 / mm; 2026-07-06 / POV3D / models / mlkpai_carrier_disc / mlkpai_carrier_disc.stl

平盘 (凸台/支托均取消) / 16×Φ3.2 挂环孔 (R35+R77.5, 22.5°+45k°) + Φ7×2.5 顶沉→详图A / 7× pi2hub 孔 Φ3.2 通 + 盘底 Φ4.2×4 铜螺母沉→详图B (台肩仅1!) / 基准=盘心 (GB 1st-angle, 1:1, mm)

详图 A (6:1) — 挂环孔 Φ7 顶沉

上=盘顶 (M3 头沉入); 装 rim_ring 螺丝

详图 B (6:1) — pi2hub 孔 铜螺母沉 (盘底)

下=盘底: 压入 M3×4×4.5 注塑铜花螺母 (台肩仅1, 勿压过深)

pi2hub 孔位 (盘心系): (-54,±47)(-54,0)(-35,±39.5)(15,±39.5) [X列 -54/-35/15]
