kiujkiu/macha/(list of files, drawings)

Other design files:
models/pcb_tray/pcb_outline_points.json
