kiujkiu/macha/v1.2/pcb/key_board_v1_2/key_board_v1_2.kicad_pcb

## KiCad design v1.2/pcb/key_board_v1_2/key_board_v1_2.kicad_pcb (2026-11-13, an earlier design)

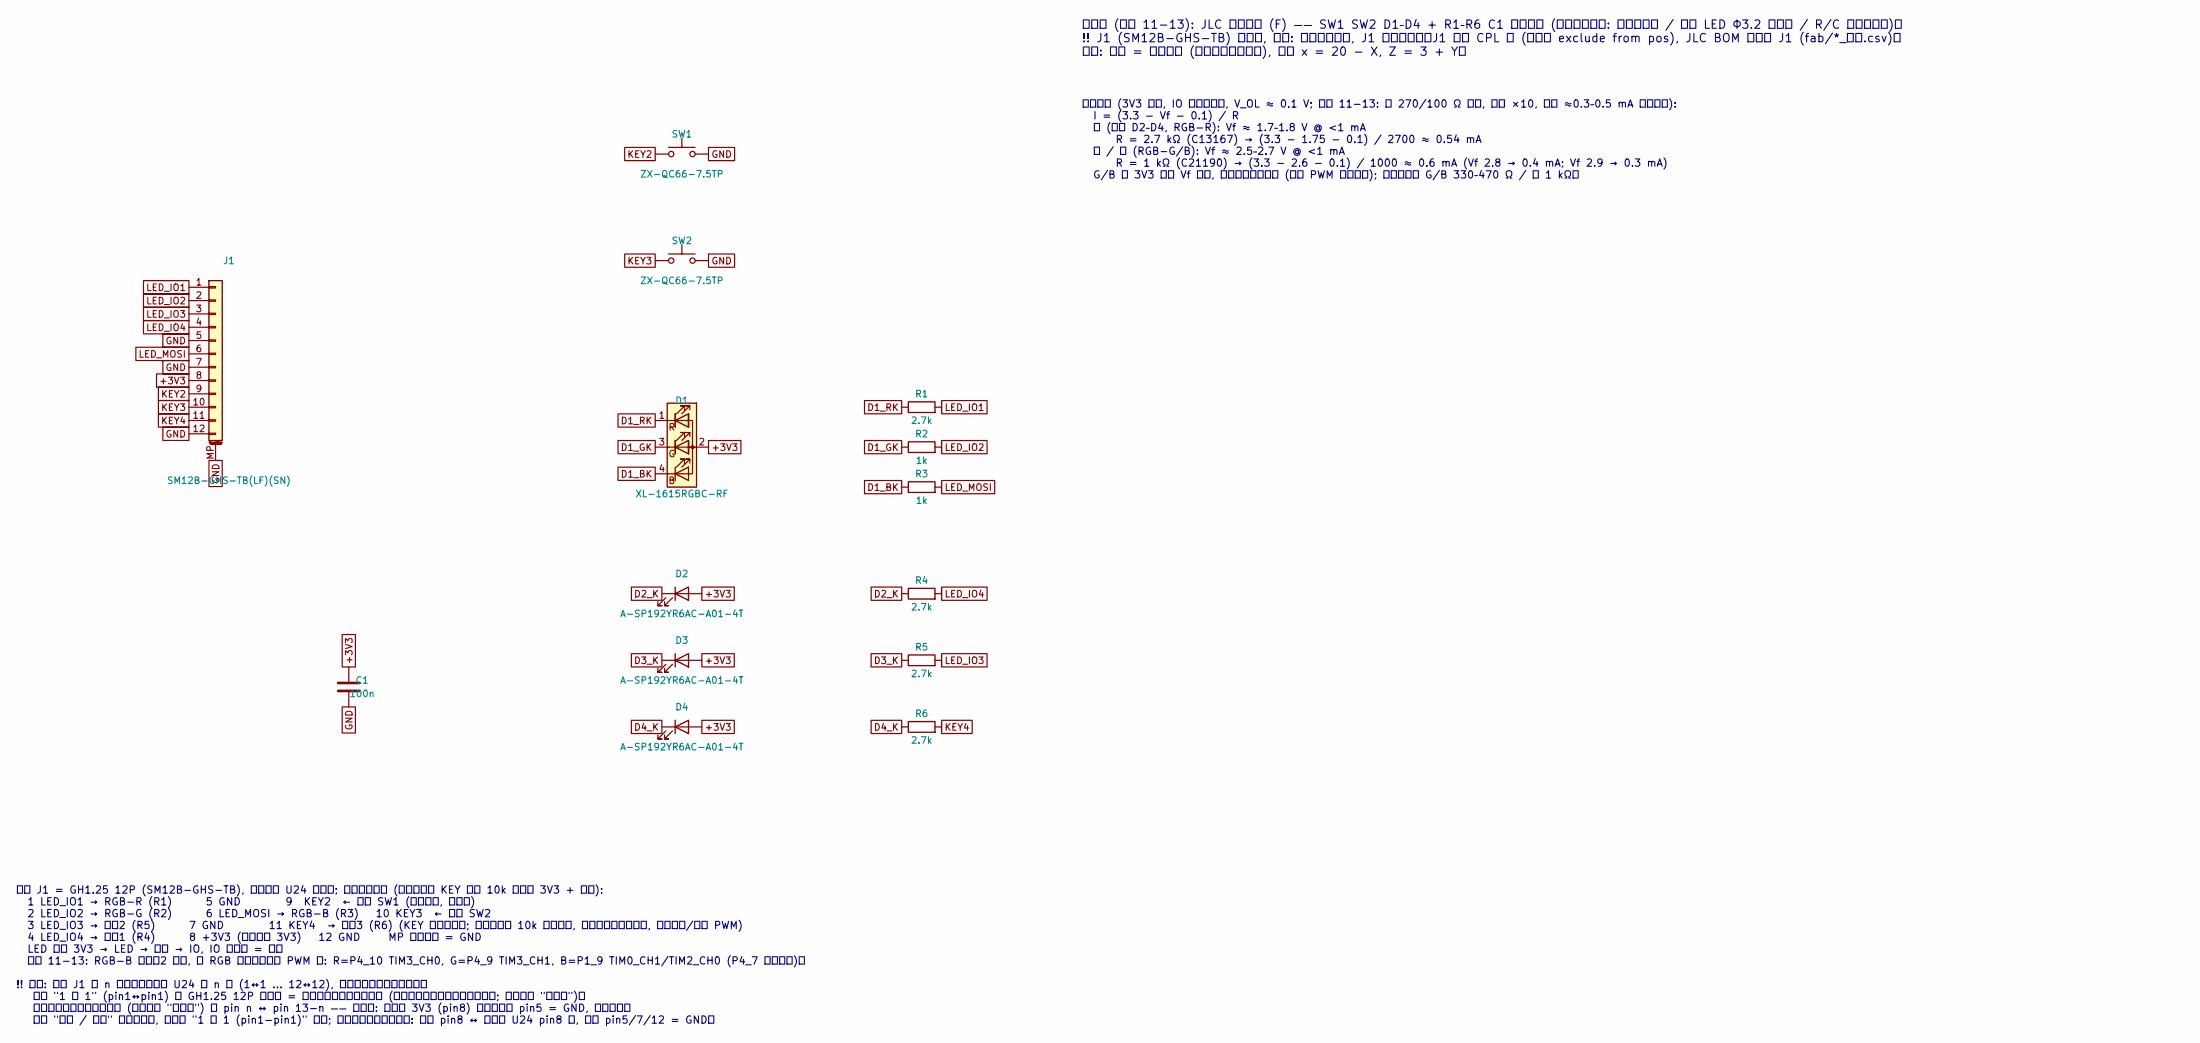
[picture p196: schematic key_board_v1_2.kicad_sch, POV3D V1.2 按键板 key_board_v1_2]

Parts:
C1: 100n; C_0603_1608Metric; MPN CC0603KRX7R9BB104; LCSC C14663
D1: XL-1615RGBC-RF; LED_XL-1615RGBC; MPN XL-1615RGBC-RF; LCSC C965840
D2, D3, D4: A-SP192YR6AC-A01-4T; LED_0603_A-SP192YR6AC; MPN A-SP192YR6AC-A01-4T; LCSC C5355430
J1: SM12B-GHS-TB(LF)(SN); JST_GH_SM12B-GHS-TB; MPN SM12B-GHS-TB(LF)(SN); LCSC C265421
R1, R4, R5, R6: 2.7k; R_0603_1608Metric; MPN 0603WAF2701T5E; LCSC C13167
R2, R3: 1k; R_0603_1608Metric; MPN 0603WAF1001T5E; LCSC C21190
SW1, SW2: ZX-QC66-7.5TP; SW_ZX-QC66-7.5TP; MPN ZX-QC66-7.5TP; LCSC C7470157

Connections:
+3V3: C1.1, D1.2 (A), D2.2 (A), D3.2 (A), D4.2 (A), J1.8
D1_BK: D1.4 (BK), R3.1
D1_GK: D1.3 (GK), R2.1
D1_RK: D1.1 (RK), R1.1
D2_K: D2.1 (K), R4.1
D3_K: D3.1 (K), R5.1
D4_K: D4.1 (K), R6.1
GND: C1.2, J1.5, J1.7, J1.12, J1.MP (MountPin), SW1.3 (B), SW1.4 (B), SW2.3 (B), SW2.4 (B)
KEY2: J1.9, SW1.1 (A), SW1.2 (A)
KEY3: J1.10, SW2.1 (A), SW2.2 (A)
KEY4: J1.11, R6.2
LED_IO1: J1.1, R1.2
LED_IO2: J1.2, R2.2
LED_IO3: J1.3, R5.2
LED_IO4: J1.4, R4.2
LED_MOSI: J1.6, R3.2

Notes on the sheet:
接口 J1 = GH1.25 12P (SM12B-GHS-TB), 对电机板 U24 同型座; 板上不加上拉 (电机板每个 KEY 已有 10k 上拉到 3V3 + 电容): 1 LED_IO1 → RGB-R (R1) 5 GND 9 KEY2 ← 上键 SW1 (按下接地, 低有效) 2 LED_IO2 → RGB-G (R2) 6 LED_MOSI → RGB-B (R3) 10 KEY3 ← 下键 SW2 3 LED_IO3 → 单色2 (R5) 7 GND 11 KEY4 → 单色3 (R6) (KEY 线改作输出; 电机板上的 10k 上拉无害, 其电容会让边沿变慢, 只做开关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
限流电阻 (3V3 供电, IO 拉低灌电流, V_OL ≈ 0.1 V; 用户 11-13: 原 270/100 Ω 太亮, 全部 ×10, 目标 ≈0.3–0.5 mA 指示亮度): I = (3.3 − Vf − 0.1) / R 红 (单色 D2–D4, RGB-R): Vf ≈ 1.7–1.8 V @ <1 mA R = 2.7 kΩ (C13167) → (3.3 − 1.75 − 0.1) / 2700 ≈ 0.54 mA 绿 / 蓝 (RGB-G/B): Vf ≈ 2.5–2.7 V @ <1 mA R = 1 kΩ (C21190) → (3.3 − 2.6 − 0.1) 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
单面贴 (用户 11-13): JLC 只贴顶面 (F) —— SW1 SW2 D1–D4 + R1–R6 C1 全在正面 (支架平板背面: 按键让位腔 / 每颗 LED Φ3.2 隔光孔 / R/C 共用让位腔)。 !! J1 (SM12B-GHS-TB) 在背面, 手焊: 平板盖住正面, J1 放不了正面。J1 不在 CPL 里 (封装标 exclude from pos), JLC BOM 也去掉 J1 (fab/*_手焊.csv)。 板系: 原点 = 板左下角 (从机器外面看正面), 整机 x = 20 − X, Z = 3 + Y。

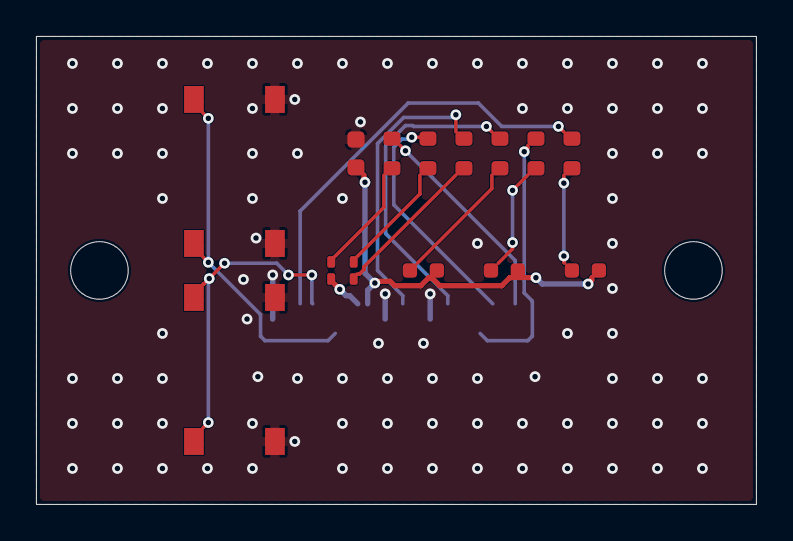
[picture p197: board key_board_v1_2.kicad_pcb from above]

Board: 2 copper layers, 40.0 x 26.0 mm, 16 parts (1 on the bottom side), 16 nets.

Other parts of the board:
H1, H2: MountingHole_3.2mm_M3
