kiujkiu/macha/(commit log)

2026-06-08 Initial commit: POV 3D structural parts pipeline
    7 3D-printable structural parts for the POV3D rotating LED display,
    targeted at the Bambu A1 mini (180x180x180 build volume).
    Each part follows the established pipeline (one folder per part):
    - build_stl.py manifold3d CSG -> binary STL (with 84+n*50 size assert)
    - build_drawing.py fpdf2 -> A3 landscape 1st-angle GB drawing
    - <part>.scad parametric OpenSCAD mirror
    - <part>.stl binary STL for slicer
    - <part>_drawing.pdf + preview PNG
    Parts:
    l_bracket L-profile bracket (170 long, 105 deg, 4xM3)
    baseplate 100x100x5 plate + annular boss + counterbores
    ring_collar collar with angular cutout
    flang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
    [baseplate.scad, baseplate.stl, flange_disc.scad, flange_disc.stl, hub_disc.scad, hub_disc.stl, l_bracket.scad, l_bracket.stl]
2026-06-10 Add l_bracket_170x60, baseplate_collar, pcb_tray; iterate baseplate + rim_ring
    - l_bracket_170x60: L bracket mating to rim_ring. Vleg 70x90 lies on rim
    base annulus with 4 M3 holes (trapezoid) matching rim PCD Phi70 + Phi155
    @ 157.5/202.5; hleg stands 200 mm vertical at 14.3 mm from rim center.
    Adds 2 M3 through-holes across both triangular gussets along +Y.
    - baseplate_collar: merged baseplate + ring collar variant.
    - pcb_tray: T200 PCB test jig with 33 Phi1 probe holes auto-extracted
    from EasyEDA STEP via cadquery.
    - baseplate, rim_ring: regenerated outputs from latest build scripts.
    [baseplate.scad, baseplate.stl, baseplate_collar.scad, baseplate_collar.stl, l_bracket_170x60.scad, l_bracket_170x60.stl, pcb_outline_points.json, pcb_tray.stl]
2026-06-10 Add rim_top_disc + assembly drawing for rim/disc/bracket stack
    - rim_top_disc/: new Phi200 x 5 disc that sits on rim_ring's upper-wall top.
    Mirrors rim_ring's 16 M3 holes (PCD Phi70 + Phi155, 22.5+45k deg). Has 2
    radial reinforcement ribs (5 x 30, ~172 long) at Y=+/-47.5, c-to-c 95 mm
    that clamp the l_bracket_170x60 hleg fin (90 mm wide) between them. Each
    rib has a Phi3.2 through-hole at (X=-34.3, Z=24) and (X=-64.3, Z=24) that
    aligns with the bracket gusset holes. 6 x [M3 through + Phi4.2 x 3 CB
    from bottom] on the +X half for top-stack mounting. +Y rib has a 15 x 6
    rectangular slot at (X-center 35, bottom Z=11 above rib base).
    Phi200 > A1 mini 180 mm bed — must print dia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
    [rim_top_disc.stl]
2026-06-23 Add box_22x24x64 enclosure + accumulated pov3d part work
    box_22x24x64: open-side(+X) 5-face enclosure, 22×24×64, asymmetric
    walls (front 1mm / back 2mm / side 2mm / ends 2mm), 1mm front panel with
    a 14×35 through-window shifted flush to the +X open edge, and 4×M4 Φ4.5
    through-holes (front/back, c-c 44). STL + SCAD + A3 3-view drawing.
    Also includes accumulated changes to assembly_stack, l_bracket_170x60,
    rim_top_disc, photo_sensor, top_bearing, zynq_board, and verify_drawing.
    [assembly_stack.stl, box_22x24x64.scad, box_22x24x64.stl, frame_A.stl, frame_B.stl, index_vane.stl, l_bracket_170x60.scad, l_bracket_170x60.stl]
2026-07-02 新增 POV3D 装配 v2 及相关零件
    - assembly_v2: 中心网格洞洞板 + baseplate_collar_d100(对脚45°) + 法兰/电机
    + hub_disc/rim_ring + mlkpai_carrier_disc + pi2hub75e + 米联派板 叠层
    - baseplate_collar_d100: M6 对角间距 100(方形70.7)变体
    - mlkpai_board: 米联派 MLKPAI-FS03 核心板数字孪生(85×56, 4×M3, 2×J11/J12 排针朝下, 针长11)
    - mlkpai_carrier_disc: Φ200×6 承载盘, 16挂环孔 + 6×Φ14凸台(铜螺母孔) + 3×Φ3托(避开排针)
    - pi2hub75e: 从 STEP 抠出的孪生(100×100×1.6, 6孔, 连接器)
    - mlkpai_h_bracket / saddle_clamp_sq6: 早前零件
    [assembly_v2.stl, baseplate_collar_d100.scad, baseplate_collar_d100.stl, mlkpai_board.scad, mlkpai_board.stl, mlkpai_carrier_disc.scad, mlkpai_carrier_disc.stl, mlkpai_h_bracket.scad]
2026-07-02 mlkpai_carrier_disc: 凸台Φ10、盘Φ170、铜螺母孔从盘底
    - 6 安装凸台 Φ14→Φ10
    - 盘外径 Φ200→Φ170 (与 rim_ring 一致)
    - 铜螺母沉孔改为从盘底向上 Φ4.2×4 (Z0..4, 台肩挡, 顶螺丝拉紧), 上面 Φ3.2 通到凸台顶
    - 3 支托 Φ3 让开 pi2hub 排针 (T1/T2/T3)
    - 同步更新 STL/SCAD/图纸/对比图/assembly_v2
    [assembly_v2.stl, mlkpai_carrier_disc.scad, mlkpai_carrier_disc.stl]
2026-07-09 v2 零件积累: 承载盘扁平化/门形支架/新屏/光电v2/wifi倒扣盒
    - mlkpai_carrier_disc: 删7凸台改尼龙垫柱, 盘厚6→5, 图纸重出
    - pi2hub75e: 新twin (100×75, 7孔, 仅顶面元件)
    - l_bracket_v2: screen_plate + gantry_base_A/B 门形支架 (新增)
    - screen_150x169: 单屏数字孪生 (新增)
    - photo_sensor: bracket/vane v2 (θ=180, R_SLOT=98) + 图纸
    - usb_wifi: 侧立倒扣盒第三版定稿 + 侧翼筋 + A3图纸
    - zynq_board: 实物照片存档
    [gantry_base.scad, gantry_base_A.stl, gantry_base_B.stl, index_vane_v2.stl, mlkpai_carrier_disc.scad, mlkpai_carrier_disc.stl, pi2hub75e.stl, screen_150x169.stl]
2026-07-09 顶部定心轴承 v2: frame_A/B_v2 + L型 top_cap_v2, 屏幕组件转180°
    - 立柱改 4×Φ8×350 M6螺纹柱 @(±125,±125) (v2 网格最外角孔, POST_R 176.78)
    - frame_A/B_v2: 同 v1 结构仅缩臂, 打印足迹 207.8², 688×2 压装 353-358/361-366
    - top_cap_v2 L型: 平板 82.27×144×9 (asm 283.7..292.7, 屏顶+19), 腿在+X端
    贴 plate 背面, 借屏幕上排螺母孔 2×M3×16 固定; 19×M6 配重阵在 -X 悬伸;
    五金全沿用 v1 (M6×40 + Φ8×50螺柱 + 688×2), 柱顶350 = 帽顶292.7 + 57.3
    - assembly_v2: SCREEN_FLIP=180 (屏+立板+门形塔转半圈, 盘环孔45°阵列脚位不变,
    塔-wifi盒间隙5.0) + 第13节顶轴承; 布尔干涉校验全零
    - 两张 A3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
    [assembly_v2.stl, frame_A_v2.stl, frame_B_v2.stl, frame_v2.scad, top_cap_v2.scad, top_cap_v2.stl]
2026-07-15 v3 双面屏配置 + 打印交付包 + 近期零件修订 (2026-07-10..15)
    - v3/: assembly_v3 (双屏背靠背 LED±10.27, gantry_v3 同件×2 对角,
    screen_plate_v3 居中±88+顶舌, top_cap_v3 对称夹舌帽) + 三件图纸
    - v2/print/ 与 v3/print/: 每零件一夹 (STL+图纸), assembly/ 含
    组装指引 (12步+紧固件表) 与乐高式拼装手册 15 页
    - baseplate_collar_d100: +8×flange连接孔 (Φ3.2通+Φ4.2×4沉 顶/底),
    套环 Φ80→84, 开口内外同高 H8
    - hub_disc: 环形16孔沉深 4→4.5 (抱壳裙加过又按用户要求回退)
    - sensor_bracket v1/v2: 三避空槽挖穿, 排针槽宽9→7.7, 模块孔沉孔取消;
    v2 板厚 5→6→3
    - v3/rotor_analysis_2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
    [assembly_stack.stl, assembly_v2.stl, assembly_v3.stl, baseplate_collar_d100.scad, baseplate_collar_d100.stl, flange_disc.stl, frame_A_v2.stl, frame_B_v2.stl]
2026-07-16 v2.1 (柱内移1格→±100,±100) + sensor_bracket_v2 板厚3 + hub环孔沉深4.5
    - v2.1/: assembly_v2_1 + frame_A/B_v2_1 (POST_R 141.42, 臂/筋随参数,
    打印172²) + A3图纸 + print/ (仅2新件, 其余用 v2/print)
    - sensor_bracket v1/v2: 模块孔Φ4.2沉孔取消(全直通); v2 板厚 6→3,
    螺丝回调 M3×16/M3×8; 排针槽 7.7
    - hub_disc: PCD环16孔沉深 4→4.5 (RING_CB_DEPTH), 抱壳裙回退
    - 指引/手册/README BOM 同步
    [assembly_v2_1.stl, frame_A_v2_1.stl, frame_B_v2_1.stl]
2026-07-21 hub_disc 凸台缺口补全(整圈) + 新件 screen_solder_jig + tools/sync_print.py
    - hub_disc: 删除外缘凸圈 0–5° 扇形切口, 恢复完整 360° (build_stl/.scad/build_drawing 三处 + 图纸断弧/棱边/角度标注), STL+PDF 重生成, v2/v3 print 拷贝同步
    - 新件 screen_solder_jig: 焊接屏幕定位 5 面托盘, 内腔 150×168.75×深15 / 壁4 底3 / ±Y端壁各3×M3@间距64 距底6.6; build_stl+scad+build_drawing(verifier PASS)+预览
    - tools/sync_print.py: 按文件名把 models 源产物刷进各版本 print/ 拷贝 (--dry-run/--check), 首跑修复 6 处遗留漂移
    - 含在建 WIP: rim_ring / assembly_v2 / v2.1 (top_cap_v2_1 等) 的既有改动一并存档
    Co-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
    [assembly_v2.stl, assembly_v2_1.stl, hub_disc.scad, hub_disc.stl, rim_ring.stl, screen_solder_jig.scad, screen_solder_jig.stl, top_cap_v2_1.stl]
2026-07-24 v2.1 wifi_shell/hub↔ring 凸台转移 + v3 双面屏/portal_tee/薄压条/光电顶置+可调挡光滑片
    - v2.1: wifi_shell (5面盒+沿+筋+M3), 模块移位 XC43/YC-13; hub_disc 凸台
    Φ50/Φ70, 孔 PCD60; rim_ring 同步 (内凸台环 OD80/ID70×2.5, 缺口 R40..61,
    wifi 4孔, 环→hub 头沉孔 Φ7.5×2)
    - v3: 双面屏模组 13.4×150×168.75 (上下各3×M3@64 居中); portal_tee_v3 ×2
    (T型+梯形壁+平板托, 平躺打印); top_cap_v3_1 薄压条 18×140×7; 柱 ±75/290,
    frame_A/B_v3 短臂 (筋 4×8); 光电顶置最小方案: 模块贴压条顶 (孔条中线,
    模块中心 capY-45), 挡光滑片 vane_slider_v3 锁 frame_B 筋 (两件 Φ3.2 圆孔
    居中 z4, 板 8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
    [assembly_v2.stl, assembly_v2_1.stl, assembly_v3.stl, frame_A_v2.stl, frame_A_v2_1.stl, frame_A_v3.stl, frame_B_v2.stl, frame_B_v2_1.stl]
2026-07-24 v3 挡光滑片螺丝孔距 6.2→10 (r43.3/53.3, 板宽 16)
    [assembly_v3.stl, frame_B_v3.stl, vane_slider_v3.stl, vane_slider_v3_asm.stl]
2026-07-24 v3 光电斜置: 模块绕孔中点转 22.196° 光轴过圆心, 沉孔 Φ7.5, 刀片带 r40.2..43.2
    [assembly_v3.stl, frame_B_v3.stl, top_cap_v3_1.stl, vane_slider_v3.stl, vane_slider_v3_asm.stl]
2026-07-24 top_cap_v3_1: 排针尾避空槽宽 3→6
    [assembly_v3.stl, top_cap_v3_1.stl]
2026-07-24 top_cap_v3_1: 排针尾避空槽宽 6→7
    [assembly_v3.stl, top_cap_v3_1.stl]
2026-07-24 top_cap_v3_1: 排针尾槽定为 9×6 (长+1, 宽回 6)
    [assembly_v3.stl, top_cap_v3_1.stl]
2026-07-24 top_cap_v3_1: 排针尾槽 9×8, 对称于两孔连线
    [assembly_v3.stl, top_cap_v3_1.stl]
2026-07-28 v3: 新增转子电路罩 rotor_shroud_v3 + wifi_shell 砍脚
    罩子 (用户: 遮住屏幕以下电路, 下面锁到转子件上, 整体像个圆柱):
    - Φ170 齐盘缘 / 壁 3 / 高 50 (承载面 42.2 → 屏底 92.2), 两半对开,
    2 厚封顶带屏缝 (±7 → ±10.3 让 T 顶托, |Y|>78 端部封口)
    - 固定: 每半 2× 沉井立柱 Φ14 @ r77.5 —— Φ9 井直通顶板 + 井底 3 厚台肩
    + Φ3.4 过孔 + 45° 引导锥 Φ3.4→Φ5; M3×12 坐井底, 头 Φ7.5 沉井内,
    长螺丝刀顺井拧, 借 rim_ring 4 个空闲外圈环孔 (rim_ring 不改)
    - 加强: 立柱兼竖筋 / 接缝 bolster / 屏缝下翻边; 137.8 cm³ ≈ 171 g
    - A/B 非同件: A 含 wifi 壳让位窝, B 含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
    [assembly_v3.stl, rotor_shroud_v3.scad, shroud_half_A_v3.stl, shroud_half_B_v3.stl, wifi_shell.scad, wifi_shell.stl]
2026-07-29 docs: v3 全零件设计过程记录
    - v3/V3_DESIGN_LOG.md: 覆盖 06-08~07-28 的 14 个打印件 + 外购件,
    按零件组织, 保留用户原话; 附跨零件交互模式与 15 条技术教训
    - v3/models/rotor_shroud_v3/DESIGN_LOG.md: 罩子的逐步定稿过程
    ⚠ 材料来源: 罩子/wifi 砍脚为本次会话直接经历; 其余从项目记忆 + git
    历史重建 (记忆保留了原话和迭代痕迹, 但非逐字对话记录)
2026-07-29 v4: 200×200 网格底板配置 (只重印底座一件)
    用户把洞洞板换成方形网格板 200×200×13 (M6 螺纹孔 距边12.5/节距25,
    4 安装孔 Φ6.5+Φ11×6 距边25)。
    ★ 200 方板的 4 个安装孔正好落在 (±75,±75) = 现有 4 根柱位, 一毫米不差
    → POST_R 106.07 不变 → 顶轴承架/转子/屏支撑/电路罩全部沿用 v3 原件。
    新件 v4/models/baseplate_collar_v4: M6 角孔方形节距 70.71→75 (对角
    100→106.07), 脚落网格位 (±37.5,±37.5); 其余与 d100 完全相同。
    STL + SCAD + A3 图纸 (verifier PASS)。
    v4/assembly_v4.py: 从 v3 派生, ROT 45°→0° (新板偶数相位网格无 ±50 轴向
    孔), 底板占位 200×200×13。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
    [assembly_v4.stl, baseplate_collar_v4.scad, baseplate_collar_v4.stl, flange_disc.stl, frame_A_v3.stl, frame_B_v3.stl, hub_disc.stl, mounting_flange.stl]
2026-07-29 v4: 定子侧走线开口全部补实 (用户"补成整圈")
    实测确认: 转子两件 (hub_disc / rim_ring) 2026-07-21 已补成整圈; 定子这边
    还剩 flange_disc 的 0-5° 走线扇形槽 + baseplate_collar 的 75-105° 走线
    缺口, 另有 flange_disc 外圈凸台 40-45° 缺口 (吃掉了 45° 那个孔)。
    - 新件 v4/models/flange_disc_v4: SLOT_ENABLE / OUTER_CUTOUT_ENABLE 都
    False → 整圈连续, 外圈孔 7 → 8。STL + SCAD + A3 图纸 (verifier PASS)
    - baseplate_collar_v4: NOTCH_ENABLE=False → 凸台/套环整圈连续, 图纸剖视
    改为左右对称实墙
    - assembly_v4 换用 flange_disc_v4; v4/print 同步 (11 文件夹/13 STL/14 件)
    ⚠⚠ 底座那个缺口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
    [assembly_v4.stl, baseplate_collar_v4.scad, baseplate_collar_v4.stl, flange_disc.stl, flange_disc_v4.scad, flange_disc_v4.stl]
2026-07-29 v4: flange_disc_v4 增加 2×M4 通孔
    用户要求仿 rim_ring 的 2 个 Φ4 孔, 并要求避开 baseplate_collar 的环形凸台。
    实测: 挡路的不是套环 (Φ84/R42, 孔本来就在外面), 而是 100×100 方底盘 ——
    沿坐标轴只到 r50, 但对角方向到 r70.7; rim_ring 原坐标 (-42.5°,R56) 几乎正对
    对角线 (边界 r67.8), 孔正压在底盘上, 下方 5mm 实心。
    定位改为 R70 @ -10° / -80° (关于 -45° 对称):
    - 整个落在法兰环形凹槽 R40..72.5 内, 不咬外凸缘 (余 0.5)
    - 下方净空 17.2 (底盘该方位边界仅 r50.8)
    - 到最近 M3 孔边距 14.1, 到盘缘 10.5
    STL + SCAD + A3 图纸 (verifier PASS) + assembly_v4 + v4/print 全部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
    [assembly_v4.stl, flange_disc_v4.scad, flange_disc_v4.stl]
2026-07-29 v4: 定子两件开口终态 + 修 flange_disc 图纸老 bug
    flange_disc_v4 (多轮迭代后的终态):
    - 走线槽 0°-5°, R40-60 (原 R40-82.5), 挖至 Z2 (深 2.5, 留 2mm 槽底)
    - 外凸缘 40°-45° 缺口去掉 → 凸缘整圈, 外圈 M3 恢复 8 孔 (原 7)
    - 新增 2×Φ4 M4 通孔 @ (2.5°,R56) 与 (30°,R70)
    · (2.5°,R56) 落在走线槽内, 穿的是槽底 2mm
    · (30°,R70) 原定 R72, 因 Φ4 外缘 R74 会咬进外凸缘内缘 (R72.5) 1.5mm
    形成台阶孔, 改 R70 (外缘 72, 贴而不咬)
    · 两孔下方均通透 —— 100×100 方底盘对角伸到 r70.7, 近对角方位的孔会被
    兜住, 故角度避开对角
    baseplate_collar_v4: 75°-105° 走线缺口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
    [assembly_v4.stl, baseplate_collar_v4.scad, baseplate_collar_v4.stl, flange_disc_v4.scad, flange_disc_v4.stl]
2026-07-31 v3.1 偏心屏实验 + v4 定子件修订
    === v3.1 (新配置 pov3d/v3.1/) ===
    双面屏两个 LED 面在 X=±6.7, 面上任一点到轴最近 6.7 → 成像中心有 Φ13.4 盲柱
    (占屏宽 8.9%, 占成像面积 0.80%)。v3.1 = 屏整体偏移 6.7 让一面贴轴, 该面盲区
    归零, 另一面变 Φ26.8。底座沿用 v4 的 200×200 配置。
    ★ 结构死结: 两个 T 件是同件转 180° 放的, 若把锁屏孔挪到 (+6.7,+64), 转 180°
    后第二件的孔落在 (-6.7,-64) → 两件把屏往相反方向拉, 装不上。
    解法 = 顶托对称加宽 + X 方向 3 个离散孔 (-6.7/0/+6.7): 转 180° 后两件都有
    +6.7 可用, 且同件还支持居中装法 → 拧不同孔即可在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
    [assembly_v3_1.stl, assembly_v4.stl, baseplate_collar_v4.scad, mounting_flange.stl, mounting_flange_v4.scad, mounting_flange_v4.stl, portal_tee_v3_1.stl, shroud_half_A_v3_1.stl]
2026-07-31 v3.1: 光电重定位 (孔线中点落屏 M3 连线) + 新件 vane_slider_v3_1
    用户: 光电开关的两个螺丝连线中点要在平移后屏幕的两个 M3 螺丝连线上。
    偏心后屏顶两颗 M3 在 (+6.7,±64) → 连线是 X=+6.7, 故孔线中点 M (0,-45)→(6.7,-45)。
    ⚠ 只平移会破坏「光轴过圆心」(实测偏离 6.20) → 采用平移 + 重解转角:
    通用解 (不再硬编码 45/22.196): 光轴 = 平行孔线、垂距 17 的直线, 要它过原点
    ⇔ 原点到孔线的垂距 = 17 ⇔ ∠(OM,u) = asin(17/|OM|), u 方位角 = atan2(My,Mx)+θ。
    带 assert 卡死该不变量。结果: |OM| 45→45.4960, θ 22.1961°→21.9414°,
    两孔 →(+10.243,-51.037)/(+3.157,-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
    [assembly_v3_1.stl, top_cap_v3_1_1.stl, vane_slider_v3_1.stl, vane_slider_v3_1_asm.stl]
2026-07-31 v3.1 图纸/SCAD 补齐 + v4 柱子固定方式明确
    v3.1 (4 张 A3 图纸全部 verify PASS + 3 个 SCAD):
    - portal_tee_v3_1 / top_cap_v3_1_1 / rotor_shroud_v3_1 / vane_slider_v3_1 图纸
    - portal_tee / rotor_shroud / top_cap_v3_1_1 SCAD (3 孔位循环 / 非对称屏缝 / blk_x=16)
    - 图纸同步进 v3.1/print/<part>/ (cmp 逐字节校验)
    v4 (用户圈图确认: 用板自带安装孔固定四周柱):
    - POST_XY == BB_MOUNT 断言, 柱轴心恒等于 (±75,±75) 安装孔
    - 紧固改为 M6×16 内六角自板底穿入柱底 M6 内丝 (头 Φ10×6 沉平 Φ11×6);
    纠正原 BOM 的"螺杆+螺母" —— M6 螺母对角 11.55 > 沉孔 Φ11, 塞不进
    - 新增 v4/assembly/baseplate_post_ma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
    [portal_tee_v3_1.scad, rotor_shroud_v3_1.scad, top_cap_v3_1_1.scad]
2026-08-01 v4 柱位改坐网格 M6 螺纹孔 (87.5,37.5) 族 — 顶轴承架 v4
    用户圈图指定 (第二轮图圈的是网格螺纹孔, 不是板自带的 4 安装孔):
    - 柱位 (±75,±75) → (87.5,37.5)/(-37.5,87.5)/(-87.5,-37.5)/(37.5,-87.5)
    POST_R 106.066 → 95.197 (=12.5·√58), 角向 45+90k° → 23.199+90k°
    - 紧固: M6 双头螺柱 (一头拧板螺纹孔, 一头拧柱底 M6 内丝), 板底不凸, 无螺母
    - 板不再强制翻面; 空出的 4 个安装孔留给"锁死到桌面/机架"
    新件 v4/models/top_bearing_v4/ (frame_A_v4 / frame_B_v4):
    - build_frame.py 只改 POST_GRID 一个参数, 臂/筋/垫柱随动
    - 臂条 88.07→77.20, 打印足迹 137²→126.20²
    - frame_B_v4 A3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
    [assembly_v4.stl, frame_A_v3.stl, frame_A_v4.stl, frame_B_v3.stl, frame_B_v4.stl]
2026-08-03 罩子两半各加 1 个 M6 配重座 (r75, 135°/225°)
    用户: "shroud_half 这两个件增加一个螺丝孔, 我们装一个配重, 用 M6 螺丝来做"
    - 顶板下挂 Φ14 凸台 Z38..50 (12 厚), 外缘 82 = 内壁 R82 融合 (载荷进筒壁,
    不吊在 2mm 顶板上); Φ6.5 M6 过孔通 + 凸台自由端对边 10.3×深 5.5 六角螺母窝
    - 角向 135°(半A)/225°(半B): r77.5 圈 8 个位已占满 (4 沉井 + 4 T脚),
    45/135/225/315 是仅有空档; 选 135/225 因两者对称跨 180°, 等质量合矢量
    正好指向偏心屏要修正的 −X 方向 (1.414·m·r)
    - 装法: 扣半罩前从内侧压入 M6 螺母 → 螺丝从罩外顶面往下拧, 罩装好也能加减配重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
    [assembly_v3_1.stl, assembly_v4.stl, rotor_shroud_v3.scad, rotor_shroud_v3_1.scad, shroud_half_A_v3.stl, shroud_half_A_v3_1.stl, shroud_half_B_v3.stl, shroud_half_B_v3_1.stl]
2026-08-03 gitignore: 不收 *_print.zip 打包产物
2026-08-03 配重改方案: 罩子只留 4×M3, 配重做成跨接缝的独立件 counterweight_arm
    用户: "做的有点麻烦, 在 shroud_half A 和 B 上各增加 2 个 M3 通孔 ... 再做一个件
    可以锁在这两个通孔上面, 这个新增的件用来锁 M6 螺丝, 这个件我理解应该需要
    shroud_half A 和 B 一起才能锁住, 旋转不要超出现在的旋转边缘, 应该是直径 17cm"
    罩子 (v3 + v3.1):
    - 一改的罩内 M6 埋螺母座废弃 (CW_ENABLE=False, 代码留档)
    - 改为每半 2 个 M3 安装点 (X−50/−72, 半A Y+14 / 半B Y−14):
    顶板下挂 Φ9 凸台 Z43..50 + Φ4.2×4 铜花螺母窝 + Φ3.4 过孔
    - ⚠ 两半的孔关于 Y=0 镜像, 不是 180° 旋转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
    [assembly_v3_1.stl, assembly_v4.stl, counterweight_arm.scad, counterweight_arm.stl, rotor_shroud_v3.scad, rotor_shroud_v3_1.scad, shroud_half_A_v3.stl, shroud_half_A_v3_1.stl]
2026-08-04 v3.1 柱位同步到 v4 + 补出 frame_A_v4 图纸
    v3.1 之前还停在 (±75,±75) + frame_A/B_v3, 与 v4 (网格螺纹孔 (87.5,37.5) 族)
    装不到同一块板上 —— 已统一:
    - POST_GRID (87.5,37.5), POST_R 95.197 @23.199°+90k, 顶架换 frame_A/B_v4
    - 挡光滑片角向随 frame_B 从 asm 45° → 23.199° (功能无影响, 件不用改)
    - 全周扫掠复核: 与 v4 同结果 (柱内缘对 wifi 线缆母头 0.72, 其余 ✓)
    frame_A_v4 A3 图纸补出 (v3 起就一直只有 frame_B 的图), verify PASS。
    A/B 由同一 frame_piece() 生成, 只差 Z 分层:
    A: 筋在臂上 z8..16 / 688 窝朝上 z3..8 / 垫柱 8 → M6×16 / 正立打印
    B: 筋在臂下 / 窝 z11..16 / 垫柱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
    [assembly_v3_1.stl, frame_A_v4.stl, frame_B_v4.stl]
2026-08-04 配重臂改宽 + 2 个 M6 光孔 (孔距 13), 去掉凸台和六角窝
    用户: "配重这个块窄了, 做宽一点, 能放下 2 个 M6 螺丝, 只保留 M6 通孔就可以了,
    不需要凸台, M6 螺丝间距要有 13mm"
    counterweight_arm:
    - 41×38×6 (+Φ16×10 凸台) → **41×52×6 等厚平板**, 半宽 19→26
    - 凸台 + 底面六角窝**全部删除**, 只留 2×Φ6.5 光孔 @ (−77.7, ±6.5), 孔距 13.0
    - 两孔同半径 r77.97 (比二改的 75.5 更大, 因为不用给凸台留外缘余量),
    合矢量仍在 −X 轴上; 外缘仍按 R85 裁, r_max 恰 85.00 不超 Φ170
    - 自重 11.7 → 14.9 g, 固有配重 751 → 947 g·mm
    孔位依据: ① 到 R85 外缘 ≥ 6.25 ⇒ r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
    [assembly_v3_1.stl, assembly_v4.stl, counterweight_arm.scad, counterweight_arm.stl]
2026-08-19 底盘外形裁切: 四角按 M6 大扁头 Φ12.5 收边 (v3/d100 + v4 两条线)
    用户提供 M6 大扁头实测 (头 Φ12.5 × 厚 2.6, 内六角对边 4), 头坐底盘顶面无沉孔,
    底盘外形按「帽外缘 + 壁 3」收边:
    - baseplate_collar_v4 (v4 / v3.1): 100×100 方 → 93.5 方 + 四角 R62.283
    直边 ±46.75 (37.5+6.25+3), 角弧 53.033+6.25+3; 95.73 → 89.14 cm³ (−6.9%)
    - baseplate_collar_d100 (v2 / v2.1 / v3): 100×100 方 → 89.21 方 + 四角 R59.25
    直边 ±44.605 (35.355+6.25+3); 95.73 → 85.22 cm³ (−11.0%)
    直边离套环 OD84 只剩 2.61, 这条线不能再收
    孔位 / 凸台 Φ65-Φ55 / 套环 Φ84 / 走线缺口 / 8 个法兰孔双面铜螺母窝全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
    [assembly_v2.stl, assembly_v2_1.stl, assembly_v3.stl, assembly_v3_1.stl, assembly_v4.stl, baseplate_collar_d100.scad, baseplate_collar_d100.stl, baseplate_collar_v4.scad]
2026-08-20 补同步 v3/print 的 d100 图纸 (上次提交时文件被占用)
2026-08-28 v4 两用屏收尾 + counterweight_arm 四改 + baseplate_collar_v4 降高/取消顶沉孔
    积压的 2026-08-24 工作 (一直没提交):
    - assembly_v4.py 加 SCR_ECC 开关 (--ecc): 居中/偏心两用屏, 屏支撑三件指向 v3.1 不复制
    - 新件 photo_sensor_v4 / vane_slider_v4; print 目录换代 v3 → v3_1 系列
    - v4/print/v4_print_sheet.html + .pdf; top_bearing_v4 frame_B 更新
    2026-08-27 counterweight_arm 四改 (用户: 上下改左右 + 加 M12.5 沉孔):
    - 2×M6 由 (−77.7,±6.5) 上下排改 (−77,0)/(−64,0) 左右排, Y=0 居中, 孔距 13,
    左孔离 R85 外弧顶 8; 两孔仍在 −X 轴上, 合矢量方向不变
    - 新增底面 Φ12.5×深3 沉孔 (M6 大扁头从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
    [assembly_v3_1.stl, assembly_v4.stl, assembly_v4_ecc.stl, baseplate_collar_v4.scad, baseplate_collar_v4.stl, counterweight_arm.scad, counterweight_arm.stl, frame_B_v4.stl]
2026-08-28 补上 baseplate_collar_v4 的 __pycache__
    仓库里其余 14 个 .pyc 都是跟踪的, 这个上次提交前被我删掉了, 补回来保持一致。
    Claude-Session: https://claude.ai/code/session_011GpGSEfcu4XddJaQGMtKuQ
2026-08-31 flange_disc_v4: 取消内圈 8 个底面 Φ4.2×4 沉孔
    用户 2026-08-31:「内侧的 8 个 M3 通孔的沉孔取消」。
    与 2026-08-28 那次配对 —— 那次取消的是 baseplate_collar_v4 套环顶面的
    8 个 Φ4.2×4 窝, 这 8 个让位窝正压在它上方, 下面没了就失去对应物。
    另外 v4 基盘只有 4.5 厚, 挖 4 mm 只剩 0.5 槽底 + 2.5 凸台。
    外圈 8 个 (PCD Φ155) 保留。
    - build_stl.py: 新开关 INNER_CB_ENABLE=False / OUTER_CB_ENABLE=True
    - .scad: inner_cb_enable / outer_cb_enable
    - build_drawing.py: FL_CB_INNER / FL_CB_OUTER (三份参数各自复刻)
    两条 PCD 引注改为自报沉孔状态; 顺手修掉外圈引注写死的
    「(45° 位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
    [assembly_v4.stl, flange_disc_v4.scad, flange_disc_v4.stl]
2026-09-02 mounting_flange_v4: 内圈 8 个沉孔深度 2 -> 0.5
    用户 2026-09-01:「改成深度 0.5mm」, 指的是中间 (内圈 PCD Φ72.5) 那 8 个。
    外圈 (PCD Φ155) 8 个仍是深 2, 直径 Φ7 两圈都不变。
    原脚本内外圈共用一个 CB_DEPTH, 已拆开:
    - build_stl.py: INNER_CB_DEPTH = 0.5 / OUTER_CB_DEPTH = 2.0,
    孔循环改成 for hole_R, cb_depth in (...)
    - .scad: cb_depth_inner / cb_depth_outer
    - build_drawing.py: 同名两参 + cb_depth_at(hole_R) 按半径判内外圈
    基盘 3 厚, 内圈沉孔剩肉 1 -> 2.5。
    体积 65984.41 -> 66347.38 mm3 (+362.98, 理论 8 环 365.30)。
    图纸: 剖视 A-A 内外圈按各自深度实画; 详图 B 改画内圈那个并标注
    PCD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
    [assembly_v3_1.stl, assembly_v4.stl, mounting_flange_v4.scad, mounting_flange_v4.stl]
2026-09-04 新增 3 件: 电机垫片 / 转子侧垫片 / 底座原高度变体
    一、motor_shim_v4 (定子侧电机垫片)
    Φ54 × 2 圆片 + 5 孔 = 4×Φ3.4 对角 25 (±8.8388,±8.8388) + 中央 Φ12。
    落 baseplate_collar_v4 凸台内孔 Φ55, 单边隙 0.5, 靠外圆自定位。
    垫在凸台内腔底面 (装配 Z=5) 与 C4110 之间。4282 mm3 / PLA ~5.3 g。
    校核: 落位布尔干涉 0; 4 孔 Φ3.0 探针穿底盘全通; 中央 Φ11 探针在
    底盘 Φ12×1 沉孔区无阻; 实测外接半径 27.000。
    二、hub_shim_v4 (转子侧垫片)
    Φ100 × 2 + 5 孔 = 4×Φ3.4 菱形 (±6,0)/(0,±7.5) + 中央 Φ6.2。
    垫在 C4110 bell top 与 hub_disc 底面之间 —— v4 装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
    [baseplate_collar_v4_h28.scad, baseplate_collar_v4_h28.stl, hub_shim_v4.scad, hub_shim_v4.stl, motor_shim_v4.scad, motor_shim_v4.stl]
2026-09-09 新件 washer_m3_6p8x1p5 平垫圈
    用户 2026-09-07:「画一个垫片, 直径6.8mm, 内径3.3mm, 厚度1.5mm」。
    圆环片, 没有别的特征:
    外圆 Φ6.8 × 厚 1.5 / 中央 Φ3.3 通孔 (M3 螺杆过孔) / 单边环宽 1.75
    体积 41.633 mm3 (理论 41.646, 差 0.03% 为 128 段多边形近似)
    PLA 约 0.052 g/只
    三个尺寸全是用户直接给的, 不派生自任何上游零件, 所以脚本里没有防漂移
    assert, 只有 ID < OD 一条。放 models/ 而非 v4/models/ —— 通用件, 不带
    版本后缀。
    对标标准件: GB/T 848 小垫圈 M3 = Φ6×0.5, GB/T 97.1 = Φ7×0.5, 本件是
    加厚非标, 用途大概率是补螺栓夹持链的厚度。
    图纸: A3, 俯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
    [washer_m3_6p8x1p5.scad, washer_m3_6p8x1p5.stl]
2026-09-09 rim_ring: 取消外圈那 2 个 Φ7.5×2 头沉孔
    用户 2026-09-07:「rim_ring 最外层 M3 通孔有 2 个带沉孔, 沉孔去掉」。
    2026-07-22 那版给 wifi 角落的 4 颗 ring->hub 锁紧 M3 都开了承载面侧
    Φ7.5×2.0 头沉孔, 位置 = 内圈 R30 + 外圈 R77.5 各 @202.5°/247.5°。
    这次砍掉外圈那 2 个, 成纯 Φ3.2 通孔 (和其余 12 个环孔一样, 螺丝头外露)。
    内圈 R30 那 2 个保留 —— 它们在放平的 wifi 模块肚子底下, 不沉平放不下。
    - build_stl.py: 新增具名常量 HEAD_CB_RADII = (INNER_PCD_R,)
    (原 (INNER_PCD_R, OUTER_PCD_R)); 回退只改这一行
    - .scad: head_cb_radii
    - build_drawing.py: 同名常量 + head_cb_on(r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
    [rim_ring.scad, rim_ring.stl]
2026-09-09 mounting_flange_v4: 内圈 8 个沉孔 0.5 -> 2 (回到最初规格)
    同一天内改了两轮, 净效果是把 09-01 那次的 0.5 改回 2:
    1) 用户「mounting_flange 的中间8个沉孔取消」-> 内圈成纯 Φ3.2 通孔
    2) 用户「mounting_flange中间8个沉孔恢复, 深度2mm」-> Φ7 × 深 2
    现在内外圈 16 个孔完全同规格 (Φ3.2 通 + 底面 Φ7×2)。
    体积 65984.41 mm3 / 6848 三角面 —— 与 2026-07-30 v4 定稿 (去掉凸台
    缺口那次) 记的 65984 逐位吻合, 说明这一圈来回改动没留下任何残留。
    中间态 (取消) 是 66468.36, 与 66347.38 差 +120.99, 对上理论 121.79。
    - build_stl.py: INNER_CB_ENABLE / OUTER_CB_ENABLE 开关 (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
    [mounting_flange_v4.scad, mounting_flange_v4.stl]
2026-09-15 新件 threaded_post_d50x70 螺纹柱 + 螺纹试打件 (单件 100 kg 减薄定稿)
    - threaded_post_d50x70: Φ50×70 空心下柱 (筒壁 2.94 / 米字筋 3.36 / 顶板 3.36 /
    45° 过渡 6 免支撑 / 底边 C0.3) + 外螺纹柱高 15 (60° 梯形 P3 右旋, 名义 Φ26.5/Φ24.5
    各缩 0.4 打印间隙, 实心)。体积 83.09 cm³, 只用 PETG 且必须 100% 实心打印,
    使用时须拧到被支撑物压实台阶面。STL + SCAD + A3 图纸 (主视全剖 / B-B / 详图 A 牙型 /
    详图 C 过渡)。顶板厚、螺纹柱内孔已从壁厚解耦为独立参数。
    - threaded_post_d50x70_thread_test: exec 母件 build_stl 后在顶板底面横切,
    Φ50×3.36 实心圆片 + 整段螺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
    [threaded_post_d50x70.scad, threaded_post_d50x70.stl, threaded_post_d50x70_thread_test.scad, threaded_post_d50x70_thread_test.stl]
2026-09-15 螺纹柱改单件 50 kg 定稿 + 新螺纹 + 螺纹柱中空; 新增 d35x70_x2mm 简单试打版
    - threaded_post_d50x70 (改⑥): 下柱按第二轮 50 kg 受力分析定稿 FB (筒壁 2.52 / 米字筋 3.36 /
    顶板 2.52 / 45° 过渡 6.2 / 底边 C0.3); 螺纹改为凸起 Φ27.5 / 凹陷 Φ24.5 直接建模、不留间隙
    (牙高 1.5, 顶端倒角 C1.75); 螺纹柱中空壁厚 3 (内孔 Φ18.5 深 15)。体积 75.94 cm³。
    ⚠ 中空螺纹柱与新螺纹下的根部强度复核尚未完成。
    build_stl 新增: 45° 过渡棱柱裁到筒壁中线 + 外轮廓最大半径断言 (修掉 FB 参数下筋端过渡的微小外凸);
    float32_clean_mesh (导出前去掉约 2300 个 float32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
    [threaded_post_d35x70_x2mm.scad, threaded_post_d35x70_x2mm.stl, threaded_post_d35x70_x2mm_thread_test.stl, threaded_post_d50x70.stl, threaded_post_d50x70_thread_test.scad, threaded_post_d50x70_thread_test.stl]
2026-09-15 螺纹柱: 试打确认螺纹 27.5/24.5 间隙 0 可用; x2mm 简单版改 Φ35 封底 + 螺纹柱实心
    - threaded_post_d50x70: 螺纹柱保持中空 3 mm (用户决定); 图纸说明补载荷定义、
    中空根部复核 SF 1.19 (<1.5, 实心 1.40) 未达目标、螺纹已由试打件确认可拧上
    - 两个试打件脚本: 支持额外间隙 (EXTRA_CLEARANCES), 试打确认间隙 0 后清空, 只出间隙 0
    - threaded_post_d35x70_x2mm: 下柱 Φ35、底部封死 (4 个封闭腔)、螺纹柱同步改实心;
    净体积 36.15 cm³, 试打件 9.85 cm³
    Claude-Session: https://claude.ai/code/session_01UctMekg9Pnrg4MNJcjWNsG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
    [threaded_post_d35x70_x2mm.scad, threaded_post_d35x70_x2mm.stl, threaded_post_d35x70_x2mm_thread_test.stl, threaded_post_d50x70.scad, threaded_post_d50x70_thread_test.stl]
2026-09-18 新增 XT60 / MR30 电源接头压块 (两件式: 压块 + 底板垫片)
    按用户 2026-09-16 的实物尺寸和一系列要求做:
    - 接头两段 (插合本体在开口端 / 出线护套在堵头端), 阶梯槽零间隙零过盈
    - 件 2 底板垫片: 与压块同外形, 厚 2 + 本体下凸台 + 止口四边高 2 (侧/前宽 2, 出线边宽 3),
    2×Φ6.5 与压块同轴靠 M6 定位; 两件嵌套面单边 0.1, 组合后外形是平齐长方体
    - 中央出线 Φ2.5 = 线径零余量, U 口平底落在后边框顶 (MR30 在出线处削到线底 1.4)
    - 全部配合用 manifold3d 布尔实算校核 (零间隙贴面用 (a^b).volume() 求交)
    - A3 图纸 + SCAD 同步; 经 44 agent 独立审查,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
2026-10-20 V1.0 验证板结构 + 打印包; 版本文件夹改名 v1~v4 → V0.1~V0.4
    V1.0 (配合验证板: ICN2260 灯板×2 背靠背 + GW5A 桥板×2 + DR1M90 底板 + FS03):
    - 屏幕锁紧: 两板缝 4.6 夹 M3 六角铜螺母, 每侧 3 组×2 颗 (A 焊上颗/B 焊下颗), 列 x=±77.0
    - 转子盘扩 Φ180, 外圈 8 孔 R82.5: hub_disc_v1_0 / rim_ring_v1_0 (DR1M90 4 孔 通孔+铜螺母孔)
    - screen_foot_v1_0 (portal_tee 式, 借外圈环孔锁 hub 铜螺母, 外形 R≤87 给圆罩让位)
    - top_cap_v1_0 (M6 → Φ8 螺柱进 688; 光电模块座沿用 V0.4 那套)
    - wifi_plate_v1_0 (H 形, 尼龙螺柱架在 DR1M90 上, 扁平 USB 延长线从 +Y 口穿)
    - top_bearing_v1_0 frame_A/B (柱沿网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
2026-10-21 V1.1: Φ200 圆网格底板, 拆立柱; 亚克力罩 OD200×5×450 + 定位环 (含 PCB 40×80 托架)
    - v1.1/assembly_v1_1.py: V1.0 装配副本 (零件读 v1.0), 底板换圆板 (52 网格孔 + 4-Φ6.5 沉孔),
    拆立柱/轴承架/挡光滑片; 加透明罩、定位环、底板 PCB + 元件限高包络; 另出不带罩子的 3MF
    - v1.1/models/glass_seat_v1_1: 底座圈 + 定位唇 (导向倒角) + 4 耳 M6 + PCB 导轨 (4×M3 铜螺母)
2026-10-21 V1.1: 定位环 glass_seat_v1_1 A3 图纸
    - v1.1/models/build_drawings_v1_1.py: 共用 v1.0 的 drawing_v1_0.draw
    - drawing_v1_0: 标题/标题栏版本号改走 spec["proj"] (默认 V1.0, 旧图不变)
2026-10-27 V0.4 顶部配重横梁 top_balance_bar_v4 草案 (两平面动平衡上平面)
    V0.4 偏心装不平衡主向在 ±X, 压条 9 个配重孔在 X=-11 沿 Y 排, X 向力臂仅 11,
    上平面修不了 X 向 → 新增横梁叠压条顶 (267.95..273.95):
    - 168×20×6 平板, hub 借压条配重孔 (-11, 0/±14) 3×M6×20 大扁头锁 (仅偏心装)
    - 中心 Φ10 让 Φ8 螺柱, 轴五金不动
    - 每臂 2×Φ6.5 @ r55/78 (M6 大扁头 Φ12.5 ⇒ 节距≥12.5), 头避开刀片扫带 r42.4..45.4
    - 板顶限高 14 (架底 290 / 刀尖 280), 螺母从板底往下叠
    校核: 转子件快照 + 静止件全周扫掠 (2°×180) 交集 0, 探针验证检测有效。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
2026-11-05 V1.0: 无屏动平衡 M6 配重块 + 四次法解算; 电机板托板 motor_tray_v1_0
    - balance_block_v1_0: r76..90 弧块, 2×M3 借 R82.5 环孔 (Φ7.5×2 头沉), 4×M6 @ r83
    - balance/: solve_four_run.py (振幅四次法, 实际用), solve_single_plane.py, fingerprint_align_1105.py, balance_v1_0.py
    - motor_tray_v1_0 + 电机板 lite/board STL, assembly_v1_0 接入
2026-11-06 V1.0: 配重块改扇形 r56..90, M3 配重孔 r64, M6 r83, 全在 R90 内
2026-11-10 V0.4 带屏动平衡: 扇形配重块 + M3 衬套 + top_cap_v4 翼 + 900 rpm 配平工具
    - counterweight_fan_v4: 取代 counterweight_arm, 装旧 rotor_shroud_v3_1 (同 4×M3 点),
    r58..85 零件角 100..260° + 原臂矩形, M6×14 @r78 + M3 微调×18 @r64; assembly_v4 改读此件
    - m3_bush_v4: top_cap_v4 Φ6.5 孔转 M3 的打印衬套 (法兰 Φ12×1), 偏心屏干涉 0
    - top_cap_v4: v3_1_1 + −X 梯形配重翼 (10-29 件, 一并入库) + print 拷贝
    - v0.4/balance: sweep_v04 (运行时放开限速 / 两段起转) / phone_v04 + phone_sweep
    (phyphox 远程读顶部) / tap_v04 / soak_win / 孔位俯视图; README 记当前配重与结果
    - 900 rpm: 顶部 1.73→0.49 m/s², 底部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
2026-11-12 V1.2: Φ55 电机 + 打印底盘 Φ220 合并控制板, 方案C 线圈环 + 玻璃罩下罩
    - 底盘 Φ220×6, M6 全部螺丝+螺母 (盘底 Φ13×3 沉孔), 电机直装 z0
    - 线圈环: 方座 ±35.5 倒角5, 4×M3x10 盘底沉孔往上拧铜螺母; 电机出线 -Y
    - 定子盘 Φ165 / 安装法兰 Φ170, 只用中央 8×M3 锁底盘
    - 玻璃罩 OD200 下罩 (合并版 + 分体版), 6 托块不开孔
    - 脚本 build/export/check + 3MF 组合 + 俯视孔位图
2026-11-12 V1.2: 下罩 4 孔 M6→M3, 线圈环四角削薄 5 + 通孔, 外圈 r78 上下盖互锁恢复, 安装法兰原外裙恢复
    - 线圈环: Φ77 圆外四角只留 5 厚, 四角 Φ3.2 通孔 (M3x10 盘底往上, 顶面上螺母), 不再压铜螺母
    - 下罩 4 孔 M6→M3 (盘底 Φ6.5×3.5 沉孔, 三角块 Φ3.4), 定子盘/安装法兰让位 Φ14→Φ10
    - 定子盘/安装法兰外圈 r78 8 孔恢复作上下盖互锁 (上盖 Φ3.2 + 原 Φ7 沉孔, 下盖底面 Φ4.2×3 铜螺母, M3x5)
    - 安装法兰: 恢复 V0.4 原外裙 r82.5–85 (上一版误切, 留 0.3 薄片)
    - README: 修正前后矛盾描述; 控制板干涉写实测 (电容压入 0.06, 排针 0.79)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
2026-11-12 V1.2: Φ7 墙宽规则 + 线圈环总高 16 + 下罩直墙 + 2D 工程图 + 紧固件 BOM
    - 法兰盘内外墙都 7 宽 (= Φ7 沉孔): 内墙 r31.7–38.7, 外墙 r75.5–82.5; 中央 8×M3 r34→r35.2, 上下盖 8×M3 r79 (V0.4 r77.5 与误开 r78 已补实)
    - 线圈环方座顶 9.3→9.5 (法兰盘/安装法兰上移 0.2), 内管 Φ63 穿两盘到 Z16; 安装法兰中心孔 Φ59.4→Φ63.4; 圆台四角 Φ8.2 让 M3 法兰螺母
    - 下罩墙内面 = 内卡内面 r90.8 直下; A 孔 r86.8 (Φ8 螺母贴墙); 托块取消; 法兰盘/安装法兰不再开让位缺口
    - 底盘往上装 M3 沉孔 Φ6.5×3.5 → Φ7×2
    - 新 2D 图纸引擎 drawing_v1_2.py + build_drawings_v1_2.py (俯视 Φ 链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
2026-11-13 V1.2: XT60 口面改平内接 r110 + 线圈驱动板 MOS/电容卡件 + 法兰盘底板 +1 + 铜螺母孔统一 Φ4.2×4.2 + 下罩加强筋
    - XT60 压块 V1.2-d: M3×20 从下往上 + 法兰螺母坐顶; 防呆上角压块/下角底垫; 口面 r108.3 外端直线 (角 r109.95), 底盘同宽切平, 法兰盘/安装法兰让位
    - 线圈驱动板 XKT-801-49: MOS→板→电容一字 71, MOS 压块 + 电容卡件 (铜螺母), 散热片竖放居中, 两卡件 A3 图纸
    - flange_disc 底板 +1 (FL_Z0 8.5, 总高 16 不变), 控制板让位挖槽, 线圈环角厚 4.5
    - 铜螺母统一 M3×4 孔 Φ4.2 深 4.2; LID 螺丝 M3×6; 下罩四角加强筋 8 片厚 2.5
    - 校核: 整机干涉全 0, 紧固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
2026-11-13 V1.2: XT60 防呆三角 R1.5→R2.0 (V1.2-e), 重出图纸/装配
2026-11-13 V1.2: XT60 压块 V1.2-f — 外端恢复 r110 圆弧, 只接头口面内接 r110 (XT_RF 109.7, 不伸出); 撤回底盘切平; 底盘 XT60 孔 r98.0
2026-11-13 V1.2: 按键板板框 40×20×1.6 (2 按键 + 三色 LED + 3 单色 LED, DXF + 布局图)
2026-11-13 V1.2: 线圈环电机出线口 270–310° (宽 40) 高 6
2026-11-13 V1.2: 按键板 + U 支架 (下罩墙内藏, 外皮开孔) / 电机控制板改 M3×10 从下往上 + 法兰螺母 / 取消线圈驱动板背面电容坑 (板抬高 0.7)
2026-11-13 V1.2: 线圈环出线口旁 315° 角耳去掉尖三角 (310–315° 修成绕 M3 孔 R4.3)
2026-11-13 V1.2: 按键支架改 L 形 (两侧三角筋, 脚 M3×12 从盘底往上 + 法兰螺母在上, 板螺丝立柱外沉孔) + 前面补齐成整片平面可朝下打印; 新增按键帽 / 导光管 标准件模型与叠层核算 (未并入下罩开孔)
2026-11-13 V1.2 key bracket: flat front plate, per-LED light tunnels, H-flap buttons (pitch 11, wide slot), SMD board, light pipe lengths, flap test coupons
2026-11-13 V1.2: key board PCB (sch+layout, GH1.25 12P to motor U24, RGB on PWM pins, 2.7k/1k), J1 + cable notch in model; XT60 clamp V1.2-g keeps printed 11-12 base disc holes
2026-11-13 V1.2: key board single-side SMT 40x26 symmetric (buttons rotated 90, holes on centre line, LED row + R/C row), JLC 2-layer basic rules, J1 hand-solder; bracket passive pocket; new base disc XT60 hole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
2026-11-13 V1.2 key board: 3D models for button (6x6x7.5, stem top 7.5) and LEDs
2026-11-13 V1.2: glass top cap (玻璃上 ring + annular glass disc OD180/ID20/10 + snap-in centre hub, optional 688 seat), drawings, 3MF, checks
2026-11-13 V1.2: glass lower shroud raised so inner spigot top = V2 LED bottom edge (Z_G 32 -> 63.08)
    Rotor stack for V2: base board 140x80 on 3 mm standoffs + CZ06 (6.6) + 2 clearance
    -> LED board bottom Z45.2; LED_V0.2.0 lowest pixel edge +37.88 -> Z83.08.
    Glass length unchanged (245, top Z308.08). Drawings and 3MF regenerated, checks 0.
2026-11-13 V1.2: no-glass assembly (3MF + A3 drawing) with V2 rotor boards (base board envelopes, CZ06, LED_V0.2.0 board)
    Clearances asserted: LED board to base-board parts 5.30, to CZ06 2.00, swept radius 81.98 < shroud r90.8.
    mesh/write3mf split out of export_3mf_v1_2.py into mf3_v1_2.py.
2026-11-13 V1.2: glass lower shroud spigot top = lowest LED edge - 10 (Z_G 63.08 -> 53.08); drawings, 3MF, no-glass assembly regenerated, checks 0
2026-11-14 V1.2: glass lower shroud split lower/upper, 8x M3x45 through-bolts (upper top Phi7 counterbore, lower bottom Phi8.2x7 flange-nut pocket, flat bottom), spigot r104-106; drawings, 3MF, BOM, checks 0
2026-11-14 V1.2: glass shroud upper counterbore depth 2 (bearing Z51.08), lower nut pocket Phi8.2x9.78, M3x45 unchanged; drawings, 3MF, BOM
2026-11-14 V1.2: glass shroud through-bolts M3x50, lower nut pocket Phi8.2x4 (nut Z0.3-4.0, engagement 2.92); drawings, 3MF, BOM
2026-11-14 V1.2: open lower shroud wall behind key board (x+-22.9, board back to inner wall, Z-1..32); bracket unchanged; drawings, 3MF, checks 0
2026-11-14 V1.2: key flap support slot 2 mm; key pocket cut straight through to Z32 (no roofs/overhangs), spigot rib broken at key section; drawings, 3MF, checks 0
2026-11-14 V1.2: key switch corner nubs (0.55) per ZX-QC66-7.5TP datasheet, bracket body relief 4.3; checks 0
2026-11-14 V1.2: rotor carrier disc back to V0.4 diameter 170 (RIM_D 178->170); 3MF, checks
